CONZERN-ITS/can-cube-sat/logs/FLIGHT/sd/combined-v2-repeared/durdurdur.jpeg

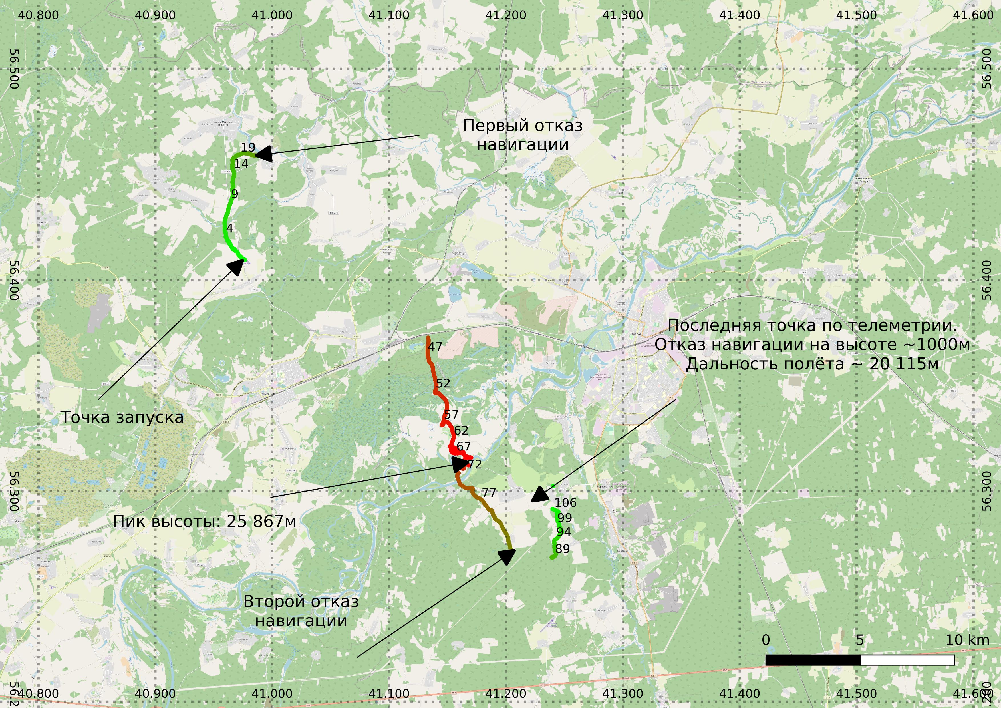
logs/FLIGHT/sd/combined-v2-repeared/durdurdur.jpeg
