CONZERN-ITS/can-cube-sat/doc/--2-.odt

СОГЛАСОВАНО | УТВЕРЖДАЮ
___________________________ | ___________________________
должность, головной исполнитель ОКР | должность, заказчик
___________________________ | ___________________________
подпись, инициалы, фамилия | подпись, инициалы, фамилия
«___»____________________ 20___г. | «___»____________________ 20___г.

СТРАТОСФЕРНАЯ ИССЛЕДОВАТЕЛЬСКАЯ СИСТЕМА "СТАЯ"

Приложение к пояснительной записке 2

Описание протоколов взаимодействия

Команда «ИТС»

1. Общее описание
  1. Для обеспечения выполнения миссии будут использованы два итоговых устройства: наземная станция и стратосферный зонд.
  2. Наземная станция состоит из центра управления полетами (ЦУП) и приемной антенной системы. Должна обеспечивать канал связи аппарата с Землей, собирать, хранить и отображать телеметрию в реальном времени.
    a. Центр управления полетами состоит из:
      a. ПК - компьютеры наземной станции. Ноутбуки.
    b. Приемная антенная система состоит из:
      b. RPI (raspberry pi 3) – устройство, входящие на земле, общающееся с зондом по радио.
      c. Антенны на штативе – необходима для обеспечения связи с зондом.
  3. Зонд должен собирать данные на всем своем пути и передавать их на наземную станцию.
  4. На стратосферном зонде реализованы следующие системы для сообщения с Землей:
    c. СКУБИ (средства контроля и управления бортовой информации) – обеспечивает общение зонда и наземной станции со стороны зонда.
    d. БКУ (бортовой комплекс управления, ESP32) – собирает данные с датчиков на борту аппарата, формирует пакеты телеметрии.
  5. Вся телеметрическая информация находится в пакетах MAVLink[^1].
  6. Физические соединения и транспортные протоколы стратосферного аппарата показаны на схеме 1.
  7. Физические соединения и транспортные протоколы наземной станции показаны на схеме 2.
  8. Используемые транспортные протоколы: I2C[^2], SPI[^3], 1wire[^4], UART[^5], TCP[^6], SDIO, Analog.
2. Общее взаимодействие. Путь аппарат-земля:
  9. БКУ собирает данные со всех датчиков, формирование пакетов телеметрии по протоколу MAVLink.
  10. Данные передаются по радиоканалу на наземную станцию, а также записываются на microSD карту на борту аппарата.
  11. Приемная антенная система получает данные и отправляет в центр управления полетами.
  12. Данные на компьютерах ЦУП-а обрабатываются и сохраняются.
3. Определенные тонкости.
  13. MAVLink
    e. Почти все данные сохраняются в MAVLink пакеты, которые разбиваются на сообщения, передаваемые по соответствующим соединению и протоколу.
    f. Идентификатор пакета определяет данные, которые в нем хранятся. По нему все компьютеры смогут правильно интерпретировать пакеты.

Схема 1. Физические соединения и транспортные протоколы стратосферного аппарата.

Wi-Fi

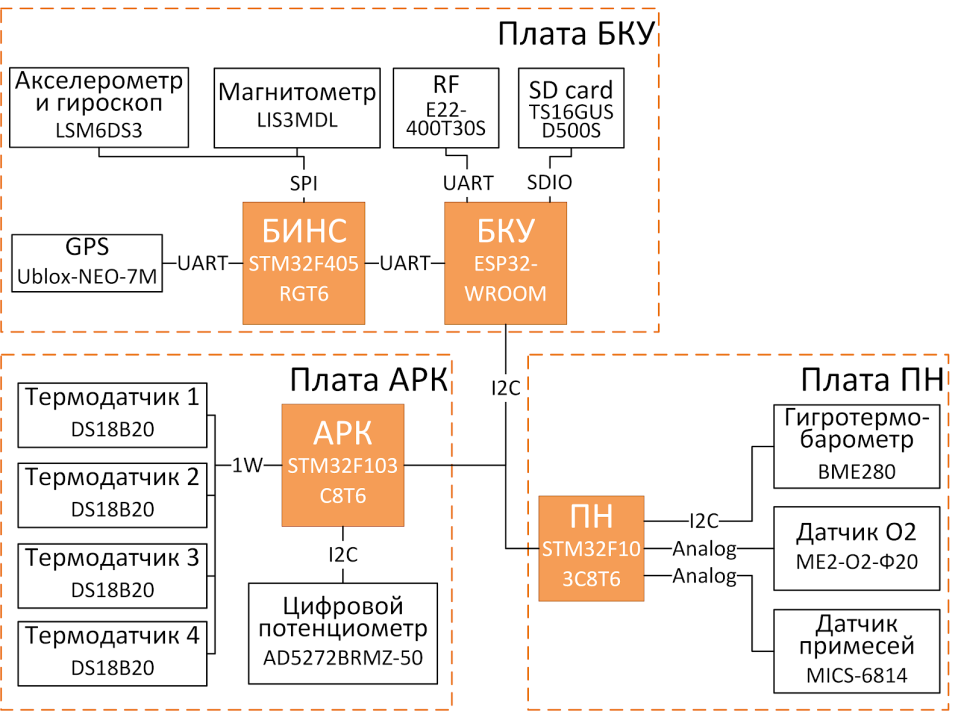
[picture p2: figure]
https://lh4.googleusercontent.com/3MNwlhLbC210im3HJPIzIBXsWaG3ZbeKRxVe3JEsiRfzpClYJ2I2KVsWtFVyp07b9cLHvXFYHdW8fx3_sWnopKQij49WuDgi_HmWpbucNM78J9VG7yGdNTZg7KlUdifC7wV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
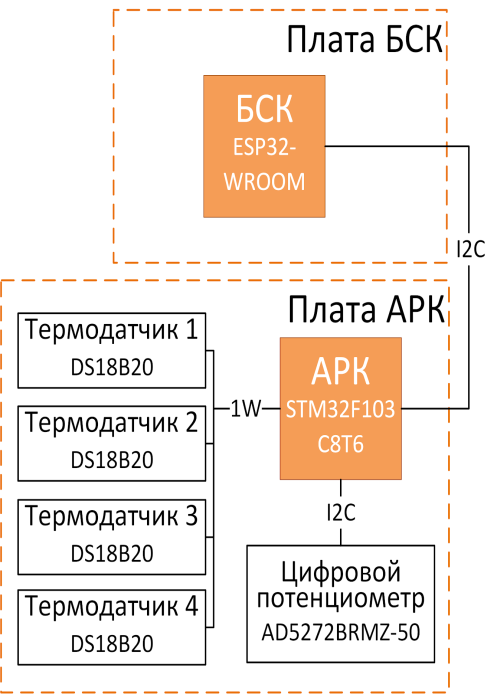
[picture p3: figure]
https://lh4.googleusercontent.com/9Z6rDS9v1-jov7y41YB3K6_0d6Etb7c8z4pV2a9LfS-DHzNvTHSGkJZP4dNTrfMh1UeLY-LgPcApaRh8hJ3QHOGJToZmJprWzGSnutUukMDLyAcQaM01VVsInIvvr6XU2f_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

Схема 2. Физические соединения и транспортные протоколы наземной станции.

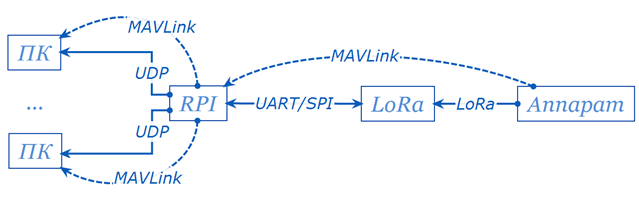
[picture p4: figure]

Схема 1

[^1] MAVLink 2.0, https://mavlink.io/en/guide/
[^2] I2C 6.0, NXP Semiconductors «I2C-bus specification and user manual» UM10204
[^3] SPI, Texas Instruments «KeyStone Architecture Serial Peripheral Interface (SPI)» March 2012
[^4] 1-wire, Dallas Semiconductor/Maxim «1-Wire ® (Protocol)»
[^5] RS-232,
[^6] RFC 793 , Darpa Internet Program«Transmission control protocol» September 1981
