CONZERN-ITS/can-cube-sat/logs/FLIGHT/аномалии.md

Аномалии

1) Пакет UBX_NAV_SOL от time_s == 1679217345 родом из 2023 года по нашей шкале времени и валидный по GPS шкале времени. Радиация?

2) Нужно бы посмотреть FLAGS в UBX_NAV_SOL

Время старта 2020-10-04T11:52:40 1601801560
