CONZERN-ITS/can-cube-sat/doc/TR-WHOLE-THING.odt

СОГЛАСОВАНО | УТВЕРЖДАЮ
____________________________________ | ____________________________________
должность, головной исполнитель ОКР | должность, заказчик
____________________________________ | ____________________________________
подпись, инициалы, фамилия | подпись, инициалы, фамилия
«___»____________________ 20___г. | «___»____________________ 20___г.

ТЕХНИЧЕСКОЕ ЗАДАНИЕ
НА ОПЫТНО-КОНСТРУКТОРСКУЮ РАБОТУ

Создание стратосферной исследовательской системы "Стая"

СТАЯ-ИТС

# Наименование, шифр ОКР, основание, исполнитель и сроки выполнения ОКР

  1. Разрабатываемая стратосферная исследовательская система именуется "Стая".
  2. Шифр ОКР: "СТАЯ-ИТС".
  3. Основания для проведения ОКР.
    - положения конкурса "Воздушно-инженерная школа CanSat в России;
    - решение участников Концерна "Информационные технические системы" об участии в конкурсе.
  1. Исполнитель - "Концерн "Информационные технические системы".
  2. Сроки выполнения ОКР распределены на несколько этапов согласно таблице 1.

Таблица 1. Этапы проведения ОКР.

№ | Наименования этапа | Срок окончания
1 | Разработка эскизного проекта | Январь 2020
2 | Разработка рабочего проекта | Март 2020
3 | Изготовление и проведение контрольных испытаний всех элементов разрабатываемой системы | Июнь 2020

# Цель выполнения ОКР, наименование и индекс изделия

  1. Целью опытно-конструкторской работы (ОКР) является разработка стратосферной исследовательской системы, предназначенной для выполнения исследовательских задач согласно регламенту конкурса "Воздушно-инженерная школа CanSat в России".
  2. Наименование изделия: Стратосферная исследовательская система "Стая". Далее "Стая" или исследовательская система.
  3. Индекс изделия: 1.

# Технические требования к изделию.

## Состав изделия:

    - стратосферный зонд, запускаемый на стратостате;
    - наземный комплекс управления, осуществляющий приём и обработку данных, поступающих от стратостата;

Допускается изменение состава изделия на этапе разработки эскизного и технического проекта при согласовании с заказчиком.

## Требования назначения:

    1. Разрабатываемая система предназначена для решения следующих задач:
      - измерение распределения температуры и давления во время подъёма и спуска;
      - измерение относительной влажности на всей трассе полёта;
      - измерение состава воздуха от 5ти составных элементов (участники могут выбрать сами) на всей трассе полёта;
      - измерение трёх компонент ускорения;
      - фотография Земли в период времени от 0 до 10 секунд после начала падения аппарата;
      - фиксация точки разрушения шара-зонда (координаты, высота, время);
      - фотофиксация неба в момент приземления;
      - передача телеметрии через альтернативные системы связи;
      - передача зондом телеметрической информации с использованием прямого радиоканала на наземный измерительный пункт (НИП);
      - анализ телеметрии аппарата на приёмном пункте во время полёта;
      - построение траектории полёта аппарата по показаниям акселерометра (после приземления);
      - экспериментальная отработка модульной концепции построения аппарата.

## Требования радиоэлектронной защиты:

    1. Должна быть обеспечена совместимость радиоэлектронных средств, используемых в системе.

## Требования живучести и стойкости к внешним воздействующим факторам.

    1. Требования к имитозащищенности
      1. Система должна удовлетворять следующим требованиям к имитозащищенности:
        - должна быть предусмотрена защита от различного рода помех при помощи таких механизмов, как контрольные суммы или помехозащищенное кодирование.
    1. Требования к устойчивости к климатическим воздействиям не предоставляются.
    2. Требования надёжности не предоставляются.

## Требования эргономики, обитаемости и технической эстетики.

    1. Элементы системы должны выглядеть внушительно.

## Требования к эксплуатации, хранению, удобству технического обслуживания и ремонта.

    1. К системе предоставляются следующие эксплуатационные требования:
      - система должна приводиться в готовность не дольше 1 часа;
      - элементы системы должны быть разборными и предусматривать возможность многократной неразрушающей разборки и последующей сборки в целях проведения локальных ремонтных работ.

## Требования к транспортабельности.

    1. К составным частям системы предоставляются следующие требования:
      - элементы системы должны быть транспортабельны при помощи двух рюкзаков объёмом не более 20 литров без потери функциональности. Это требование не распространяется на антенны.

## Требования безопасности.

    1. К системе предоставляются следующие требования безопасности:
      - элементы системы не должны предоставлять опасности для персонала и населения путём воздействия электрического напряжения, движущихся частей, теплового (светового) воздействия, высокочастотных, радиационных, электромагнитных полей, ядовитых паров и газов, вибраций, акустических шумов и др.;
      - элементы питания системы должны быть снабжены соответствующими устройствами защиты от коротких замыканий и последующего возгорания;
      - конструкция элементов системы должна исключать самопроизвольное включение и выключение.

## Требования стандартизации.

    1. При разработке протоколов взаимодействия между элементами системы не должны быть использованы проприетарные стандарты.

## Требования технологичности.

    1. Требования технологичности не предоставляются.

## Конструктивные требования.

    1. Конструктивные требования не предоставляются.

# Технико-экономические требования

  1. Технико-экономические требования не предоставляются.

# Требования к обеспечению.

  1. Требования к нормативно-техническому обеспечению.
    1. Для разработки проекта должна быть использована система контроля версий.
  2. Требования к метрологическому обеспечению не предоставляются.
  3. Требования к диагностическому обеспечению не предоставляются.
  4. Требования к математическому, программному и информационно-лингвистическому обеспечению не предоставляются.

# Требования к учебно-тренировочным средствам.

  1. При разработке системы требуется создание автономных стендов для отработки отдельных узлов там, где это возможно.

# Непредоставляемые требования.

  1. Требования к каталогизации.
  2. Требования к сырью, материалам и КИМП.
  3. Специальные требования.
  4. Требования к консервации, упаковке и маркировке.

# Этапы выполнения ОКР

  1. Выполнение ОКР разделено на несколько этапов согласно таблице 2. Подобное разделение основано на регламенте регламенте чемпионата "воздушно-инженерная школа CanSat в России" [2].

Таблица 2. Этапы выполнения ОКР.

№ | Наименования этапа | Срок окончания
1 | Разработка эскизного проекта | Январь 2020
2 | Разработка рабочего проекта | Март 2020
3 | Изготовление и проведение контрольных испытаний всех элементов разрабатываемой системы | Июнь 2020

# Порядок выполнения этапов и приёмки ОКР.

  1. Для закрытия этапа эскизного проектирования, требуется выполнение следующих требований:
    1. Должны быть разработаны трёхмерные модели элементов конструкции стратосферного зонда;
    2. Должна быть разработана принципиальная электрической схема аппарата;
    3. Должна быть создана презентация для устного доклада комиссии.
    4. Презентация должна включать:
      - описание научной задачи;
      - описание технической задачи;
  1. Для закрытия этапа рабочего проекта должны быть выполнены следующие требования:
    1. Система должна быть полностью спроектирована с выпуском следующих документов:
      - Комплект чертежей конструкции системы (допустимо использование точных трёхмерных моделей);
      - Электрические принципиальные схемы и шаблоны для производства печатных плат, используемых в системе.
    1. Должна быть выпущена альфа версия программного обеспечения всех составных частей системы.
    2. Должны быть проведены автономные испытания элементов разрабатываемой системы.
  1. На финальный этап конкурса команда должна предоставить готовую к эксплуатации систему и принять участие в финале конкурса Воздушно-инженерная школа CanSat в России.

# Ссылочные документы

    - ГОСТ Р 55996- 2014
    - Положения конкурса "Воздушно-инженерная школа (CanSat в России)" 2019-2020 от 07.01.2020.

# Перечень сокращений:

    - КИМП — комплектующие изделия межотраслевого применения;
    - НИП - наземный измерительный пункт;
    - ОКР - опытно конструкторская работа.

Со стороны исполнителей | Со стороны заказчика
______________________________________ должность, головной исполнитель ОКР | ______________________________________ должность, организация заказчика — разработчика ТЗ на ОКР
______________________________________ подпись, инициалы, фамилия | _________________________________ подпись, инициалы, фамилия
«___»____________________ 20___г. | «___»____________________ 20___г.
______________________________________ должность, головной исполнитель ОКР | ______________________________________ должность, организация заказчика — разработчика ТЗ на ОКР
______________________________________ подпись, инициалы, фамилия | _________________________________ подпись, инициалы, фамилия
«___»____________________ 20___г. | «___»____________________ 20___г.
______________________________________ должность, головной исполнитель ОКР | ______________________________________ должность, организация заказчика — разработчика ТЗ на ОКР
______________________________________ подпись, инициалы, фамилия | _________________________________ подпись, инициалы, фамилия
«___»____________________ 20___г. | «___»____________________ 20___г.
______________________________________ должность, головной исполнитель ОКР | ______________________________________ должность, организация заказчика — разработчика ТЗ на ОКР
______________________________________ подпись, инициалы, фамилия | _________________________________ подпись, инициалы, фамилия
«___»____________________ 20___г. | «___»____________________ 20___г.
