CONZERN-ITS/can-cube-sat/doc/ТЗ-НКУ.odt

СОГЛАСОВАНО | УТВЕРЖДАЮ
____________________________________ | ____________________________________
должность, головной исполнитель ОКР | должность, заказчик
____________________________________ | ____________________________________
подпись, инициалы, фамилия | подпись, инициалы, фамилия
«___»____________________ 20___г. | «___»____________________ 20___г.

ТЕХНИЧЕСКОЕ ЗАДАНИЕ
НА СОСТАВНУЮ ЧАСТЬ ОПЫТНО-КОНСТРУКТОРСКОЙ РАБОТЫ

НАЗЕМНЫЙ КОМПЛЕКС УПРАВЛЕНИЯ "СТРЕЛА-МС"

GCS1.0000-0ТЗ

# Наименование, шифр СЧ ОКР, основание, исполнитель и сроки выполнения СЧ ОКР

  1. Разрабатываемый наземный комплекс управления, входящий в состав стратосферной исследовательской системы "Стая" (далее именуется "СТРЕЛА-МС").
  2. Шифр СЧ ОКР: "СТРЕЛА-МС-ИТС".
  3. Основания для проведения СЧ ОКР.
    - положения конкурса "Воздушно-инженерная школа (CanSat в России)";
    - решение участников "Концерна "Информационные технические системы" об участии в конкурсе.
  1. Исполнитель - "Концерн "Информационные технические системы".
  2. Сроки выполнения СЧ ОКР распределены на несколько этапов согласно таблице 1.

Таблица 1. Этапы проведения СЧ ОКР.

№ | Наименования этапа | Срок окончания
1 | Разработка эскизного проекта | Январь 2020
2 | Разработка рабочего проекта | Март 2020
3 | Изготовление и проведение контрольных испытаний всех элементов разрабатываемой системы | Июнь 2020

# Цель выполнения СЧ ОКР, наименование и индекс изделия

  1. Целью составной части опытно-конструкторской работы (СЧ ОКР) является разработка наземного комплекса управления в составе стратосферной исследовательской системы, "Стая" предназначенной для выполнения исследовательских задач согласно регламенту конкурса "Воздушно-инженерная школа CanSat в России".
  2. Наименование изделия: Наземный комплекс управления "Стрела-МС" стратосферной исследовательской системы "Стая".
  3. Индекс изделия: GCS1.

# Технические требования к изделию.

## Состав изделия:

    - Центр управления полетами, предназначенный для сбора хранения и отображения телеметрии в реальном времени;
    - Приемная антенная система, предназначенная для обеспечение канала связи аппарата с Землей. При наличии достаточных ресурсов должна быть обеспечена автоматическая ориентация антенны.

## Требования назначения.

    1. Разрабатываемая наземный комплекс управления предназначен для решения следующих задач:
      - приём телеметрической информации, передаваемой аппаратом в реальном времени;
      - накопление принятой телеметрической информации на внутреннем накопителе;
      - отображение полученной по радиоканалу телеметрической информации электронно-вычислительными машинами центра управления полетами в реальном или близком к реальному времени;
      - передача телеметрической информации с приемной антенной системы на электронно-вычислительные машины центра управления полетами должна осуществляться при помощи протокола UDP поверх IP.

## Требования радиоэлектронной защиты.

    1. Должна быть обеспечена совместимость радиоэлектронных средств, используемых в системе.

## Требования живучести и стойкости к внешним воздействующим факторам.

    1. Требования к имитозащищенности
      1. Наземная станция должна удовлетворять следующим требованиям к имитозащищенности:
        - должна быть предусмотрена защита от различного рода помех при помощи таких механизмов, как контрольные суммы или помехозащищенное кодирование.
    1. К наземному измерительному пункту предоставляются следующие требования климатической устойчивости:
      - Наземный комплекс управления должен функционировать в диапазоне температур от 0 °C до 45 °C при нормальном атмосферном давлении.
    1. Требования надёжности не предоставляются.

## Требования эргономики, обитаемости и технической эстетики.

    1. Требования не предоставляются.

## Требования к эксплуатации, хранению, удобству технического обслуживания и ремонта.

    1. К системе предоставляются следующие эксплуатационные требования:
      - система должна приводиться в готовность не дольше 1 часа;
      - элементы системы должны быть разборными и предусматривать возможность многократной неразрушающей разборки и последующей сборки в целях проведения локальных ремонтных работ.

## Требования к транспортабельности.

    1. К составным частям системы предоставляются следующие требования:
      - элементы системы должны быть транспортабельны при помощи рюкзака объёмом не более 20 литров без потери функциональности. Это требование не распространяется на антенны и штатив.

## Требования безопасности.

    1. К системе предоставляются следующие требования безопасности:
      - элементы системы не должны предоставлять опасности для персонала и населения путём воздействия электрического напряжения, движущихся частей, теплового (светового) воздействия, высокочастотных, радиационных, электромагнитных полей, ядовитых паров и газов, вибраций, акустических шумов и др.;
      - элементы питания системы должны быть снабжены соответствующими устройствами защиты от коротких замыканий и последующего возгорания;
      - конструкция элементов системы должна исключать самопроизвольное включение и выключение.

## Требования стандартизации.

    1. Требования стандартизации не предоставляются.

## Требования технологичности.

    1. Требования технологичности не предоставляются.

## Конструктивные требования.

    1. Конструктивные требования не предоставляются.

# Требования к обеспечению.

  1. Требования к нормативно-техническому обеспечению.
    1. Для разработки проекта должна быть использована система контроля версий.
  2. Требования к метрологическому обеспечению не предоставляются.
  3. Требования к диагностическому обеспечению не предоставляются.
  4. Требования к математическому, программному и информационно-лингвистическому обеспечению.
    1. Вся принятая телеметрия должна сохраняться на внутренний накопитель информации приёмной станции.

# Требования к консервации, упаковке и маркировке

  1. Для элементов системы должна быть разработана упаковка, позволяющая осуществлять транспортировку и хранение с учётом предоставляемых к транспортировке требований.

# Требования к учебно-тренировочным средствам.

  1. При разработке системы требуется создание автономных стендов для отработки отдельных узлов (там, где это возможно).

# Этапы выполнения ОКР

  1. Выполнение СЧ ОКР разделено на несколько этапов согласно таблице 2. Подобное разделение основано на регламенте регламенте чемпионата "Воздушно-инженерная школа (CanSat в России)" [2].

Таблица 2. Этапы выполнения ОКР.

№ | Наименования этапа | Срок окончания
1 | Разработка эскизного проекта | Январь 2020
2 | Разработка рабочего проекта | Март 2020
3 | Изготовление и проведение контрольных испытаний всех элементов разрабатываемой системы | Июнь 2020

# Порядок выполнения этапов и приёмки ОКР.

  1. Для закрытия этапа эскизного проектирования, требуется выполнение следующих требований:
    1. Должна быть разработана принципиальная электрической схема наземной станции;
    2. Должна быть создана презентация для устного доклада комиссии;
  2. Для закрытия этапа рабочего проекта должны быть выполнены следующие требования:
    1. Система должна быть полностью спроектирована с выпуском следующих документов:
      - Комплект чертежей конструкции СЧ (допустимо использование точных трёхмерных моделей);
      - Электрические принципиальные схемы и шаблоны для производства печатных плат, используемых в наземной станции.
    1. Должна быть выпущена альфа версия программного обеспечения наземной станции.
    2. Должны быть проведены автономные испытания СЧ.
  1. На финальный этап конкурса команда должна предоставить готовую к эксплуатации СЧ в составе системы и принять участие в финале конкурса "Воздушно-инженерная школа (CanSat в России)".

# Непредоставляемые требования.

  1. Технико-экономические требования.
  2. Требования к каталогизации.
  3. Требования к сырью, материалам и КИМП.
  4. Специальные требования.

# Ссылочные документы

    - ГОСТ Р 55996- 2014
    - Положения конкурса "Воздушно-инженерная школа (CanSat в России)" 2019-2020 от 07.01.2020.

# Перечень сокращений:

    - КИМП — комплектующие изделия межотраслевого применения;
    - ОКР — опытно конструкторская работа;
    - СЧ — структурная часть;
    - IP — internet protocol;
    - UDP — user datagram protocol.

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
