CONZERN-ITS/can-cube-sat/doc/Отчетные документы на зимнюю сессию/CCS1.0000-0 - Спецификация ДКА.pdf

Копировал | Формат А4
CCS1.0000-0 СБ | Сборочный чертеж
| Сборочные единицы
1 | CCS1.0100-0 | Модуль корпусной 1 | 1
2 | CCS1.0200-0 | Модуль корпусной 2 | 1
3 | CSS1.3300-1 | Солнечные батареи | 6

Детали

4 | CSS1.1000-1 | Шайба | 24
5 | CSS1.8000-1 | Видеокамера | 2
6 | CSS1.9000-1 | Адаптер | 1

Стандартные изделия

7 | Винт М3-6eх10.43.029 | 8
| ОСТ 92-0737-72
8 | Винт М3-6eх5.43.029 | 24
| ОСТ 92-0737-72

Инв. N подл. Подп. и дата Взам. инв. N Инв. N дубл. Подп. и дата Справ. N Перв. примен.

## CCS1.0000-0

Изм. | Лист | N докум. | Подп. | Дата
| | Разраб. | - | | Демонстратор КА | Лит. | Лист | Листов
Пров. | | | | | | | | 1
Н. контр. | Концерн "ИТС"
Утв. Формат | Зона
Поз.
Обозначение | Наименование | Приме-чание
| Документация

Кол.
