CONZERN-ITS/can-cube-sat/logs/FLIGHT/sd/combined-v2-repeared/accum-current-temperature.png

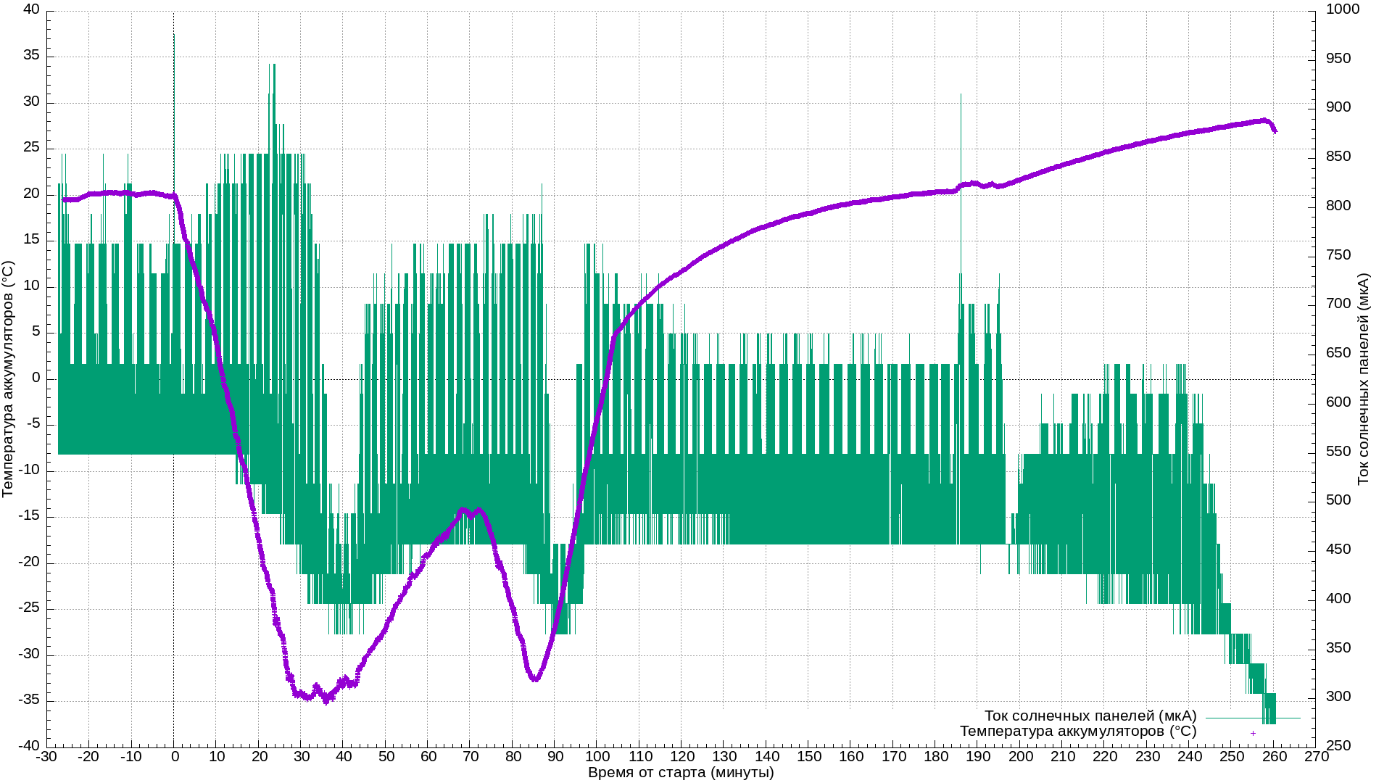
logs/FLIGHT/sd/combined-v2-repeared/accum-current-temperature.png
