CONZERN-ITS/can-cube-sat/logs/FLIGHT/sd/combined-v2-repeared/accum-voltage-temperature.png

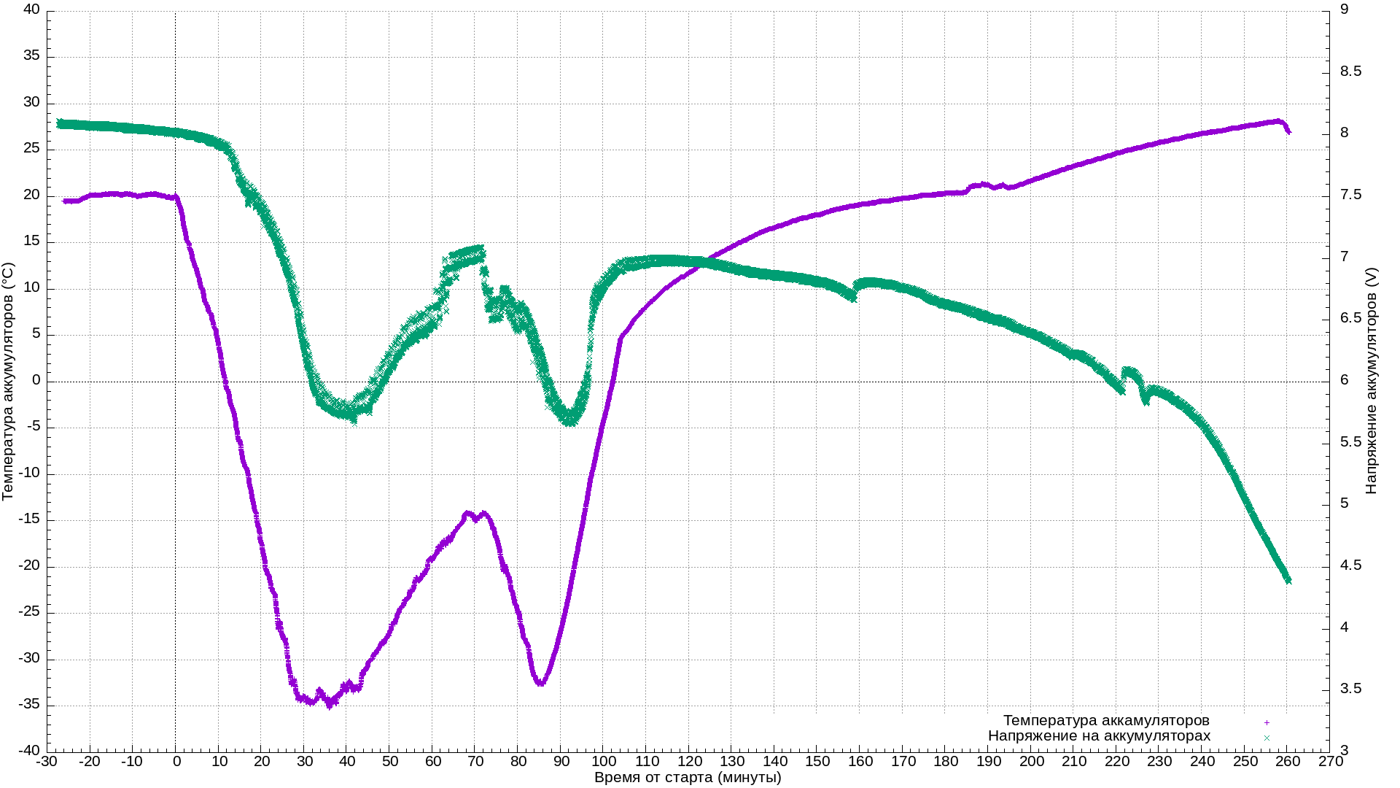
logs/FLIGHT/sd/combined-v2-repeared/accum-voltage-temperature.png
