CONZERN-ITS/can-cube-sat/logs/FLIGHT/sd/combined-v2-repeared/GPS_UBX_NAV_SOL-11-0-with-bme-pressure.png

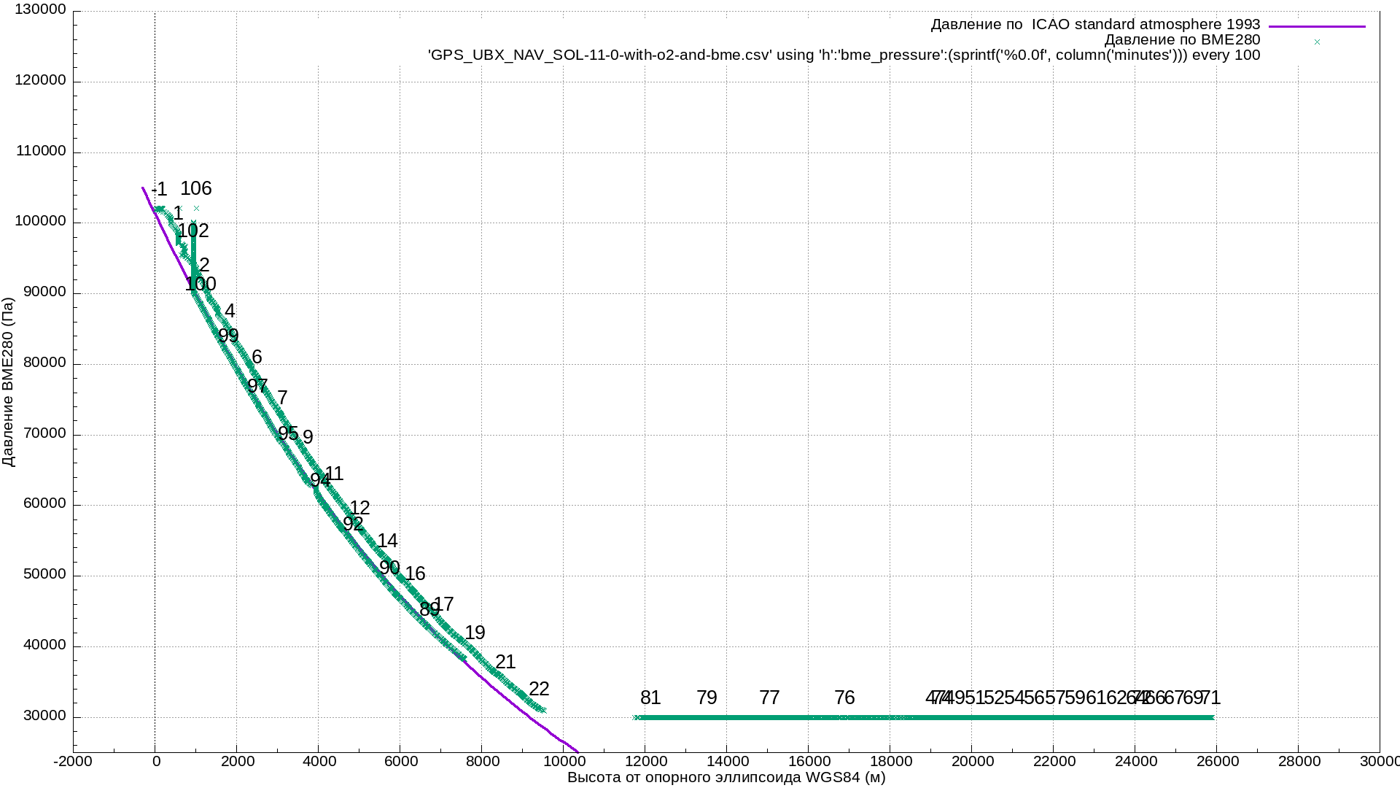
logs/FLIGHT/sd/combined-v2-repeared/GPS_UBX_NAV_SOL-11-0-with-bme-pressure.png
