CONZERN-ITS/can-cube-sat/logs/FLIGHT/sd/combined-v2-repeared/PLD_BME280_DATA-13-0-pressure.png

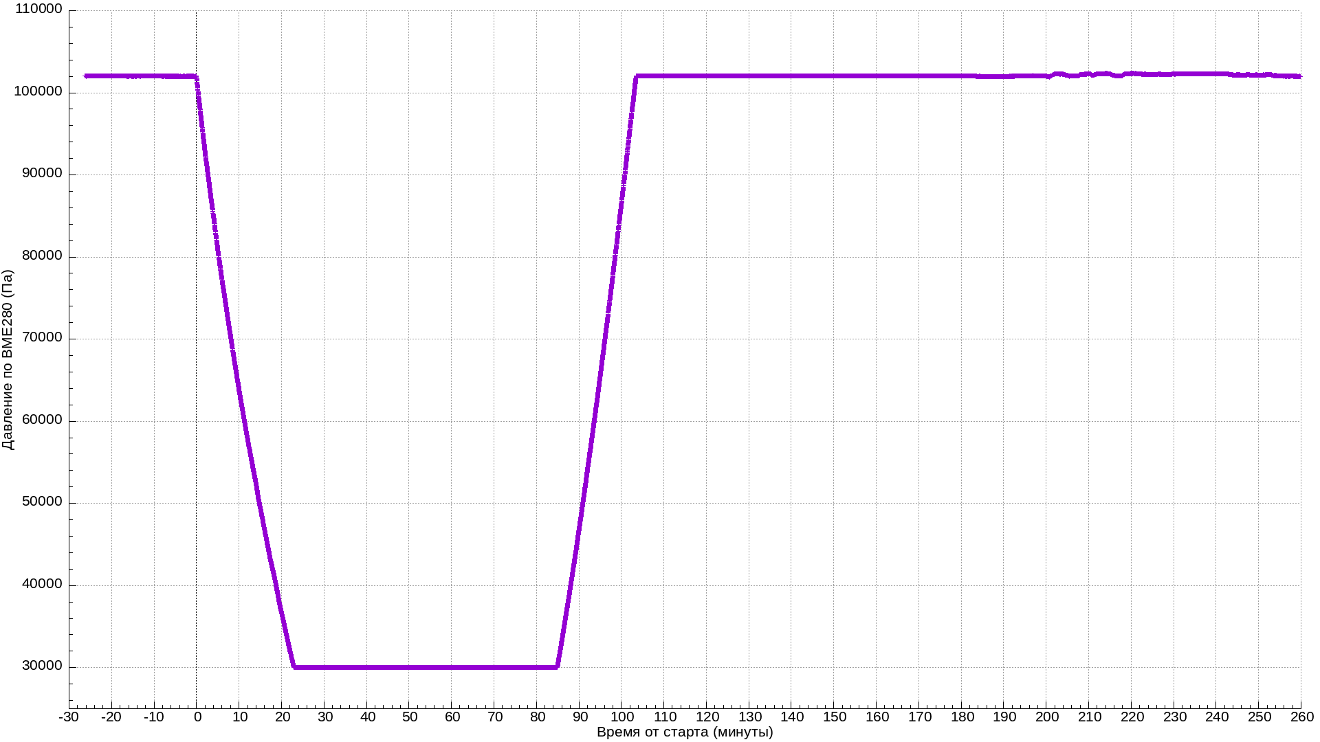
logs/FLIGHT/sd/combined-v2-repeared/PLD_BME280_DATA-13-0-pressure.png
