CONZERN-ITS/can-cube-sat/logs/FLIGHT/sd/combined-v2-repeared/PLD_ME2O2_DATA-13-0-o2.png

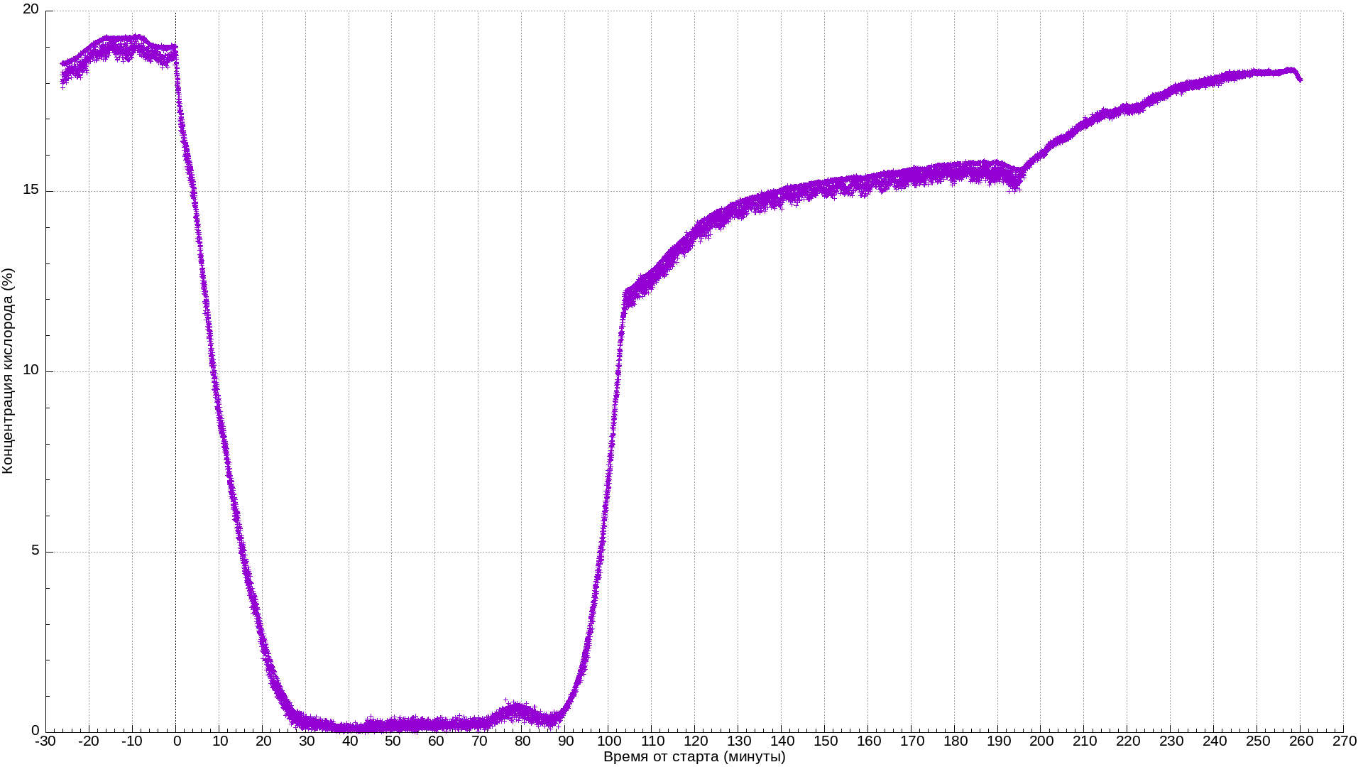
logs/FLIGHT/sd/combined-v2-repeared/PLD_ME2O2_DATA-13-0-o2.png
