CONZERN-ITS/can-cube-sat/logs/FLIGHT/sd/combined-v2-repeared/PLD_MICS_6814_DATA-13-0-no2.png

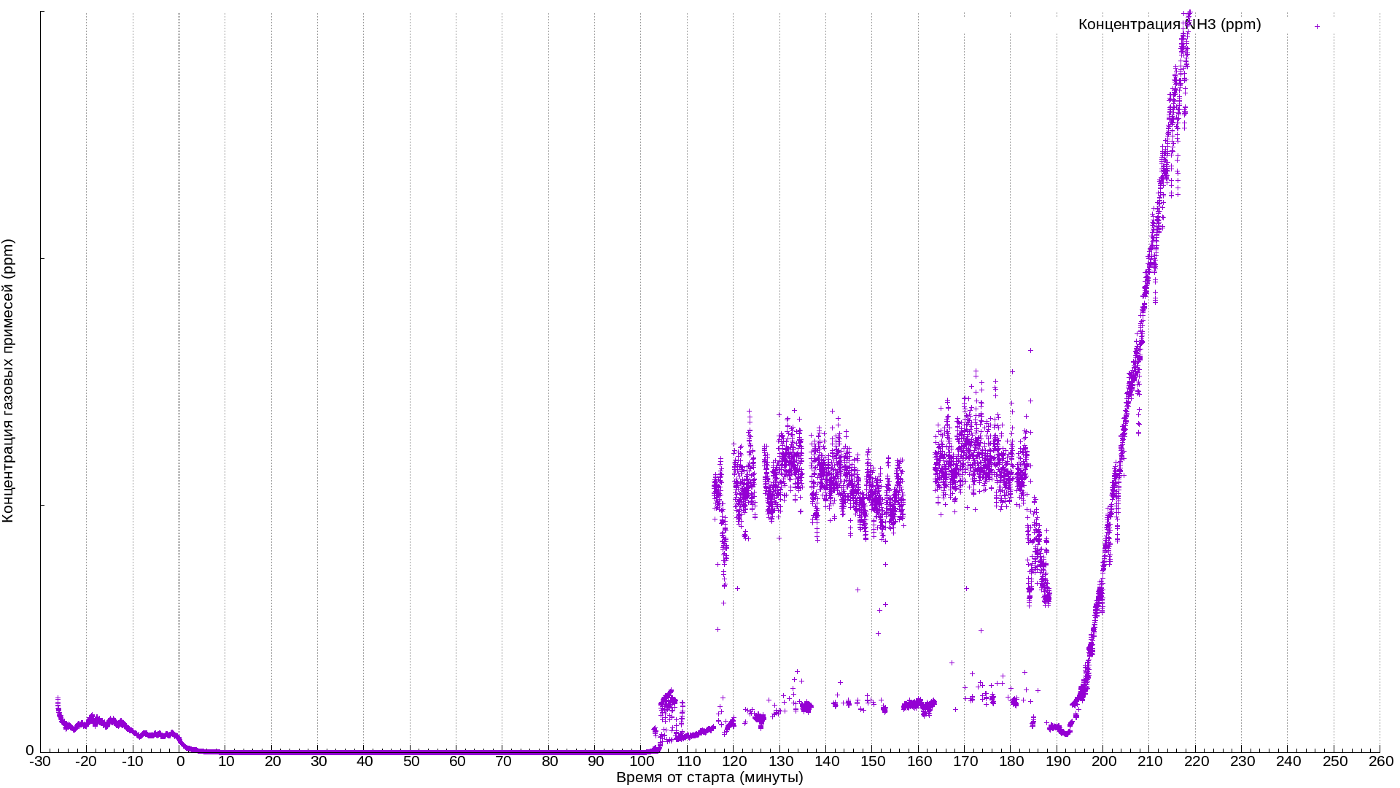
logs/FLIGHT/sd/combined-v2-repeared/PLD_MICS_6814_DATA-13-0-no2.png
