CONZERN-ITS/can-cube-sat/logs/FLIGHT/sd/own_temp.PNG

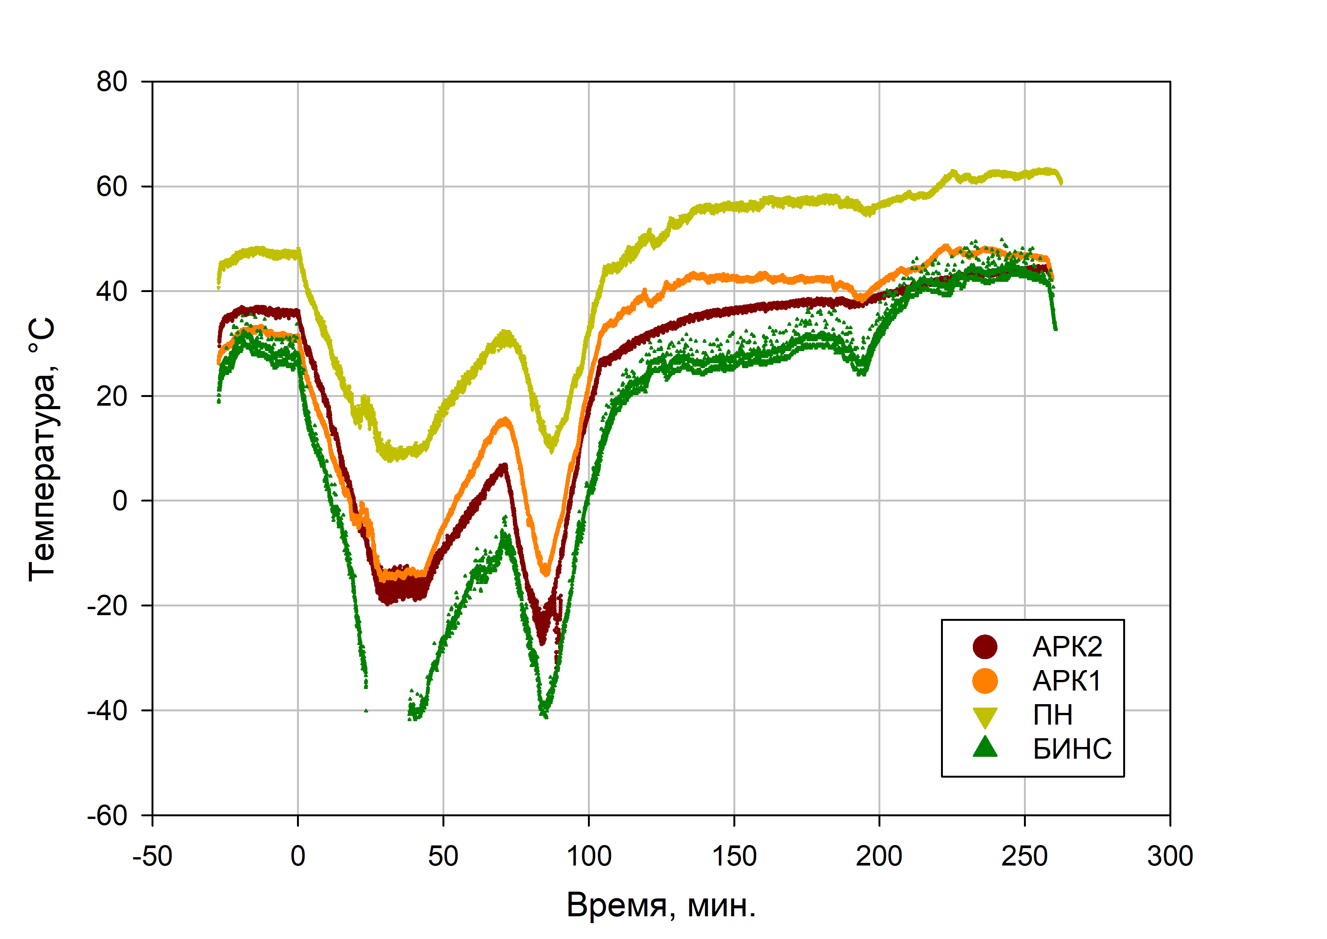
logs/FLIGHT/sd/own_temp.PNG
