CONZERN-ITS/can-cube-sat/logs/FLIGHT/sd/own_temp_sins.PNG

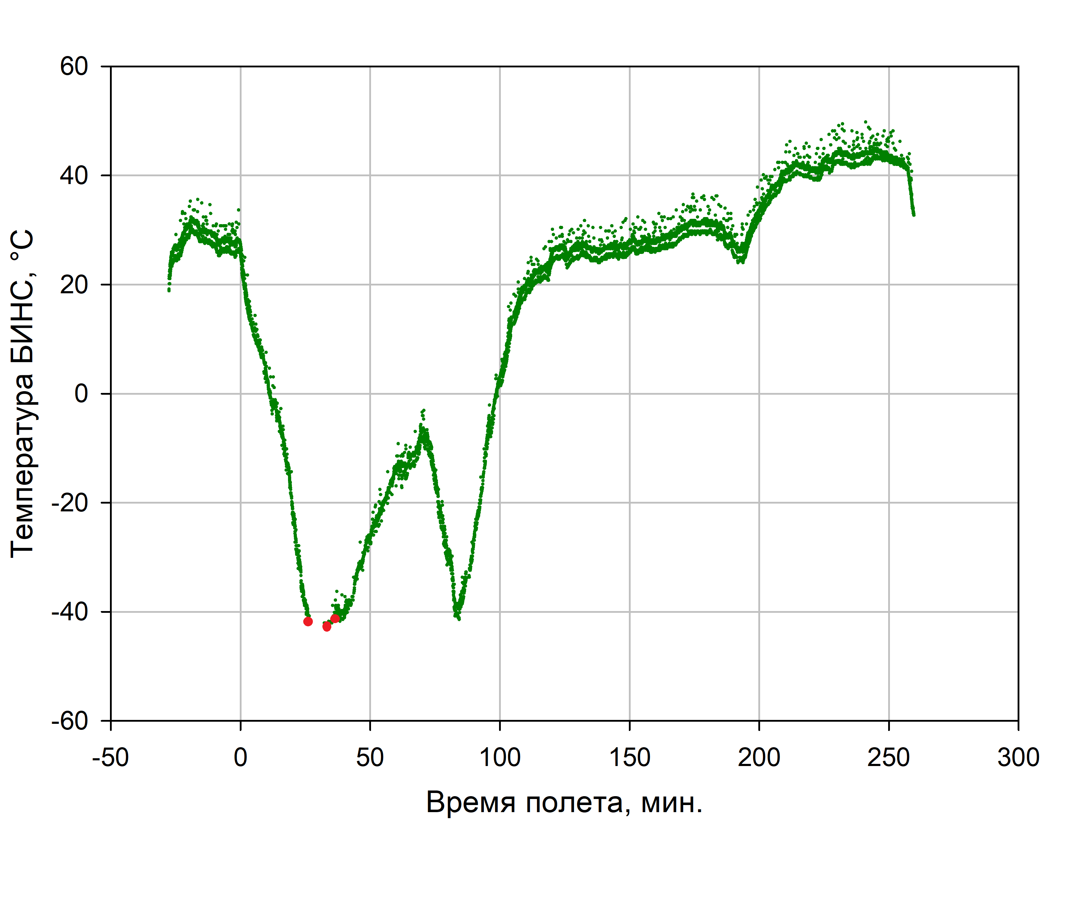
logs/FLIGHT/sd/own_temp_sins.PNG
