CONZERN-ITS/can-cube-sat/construction/3Dmodel_Ground_station/Gear-vertical-small.stp

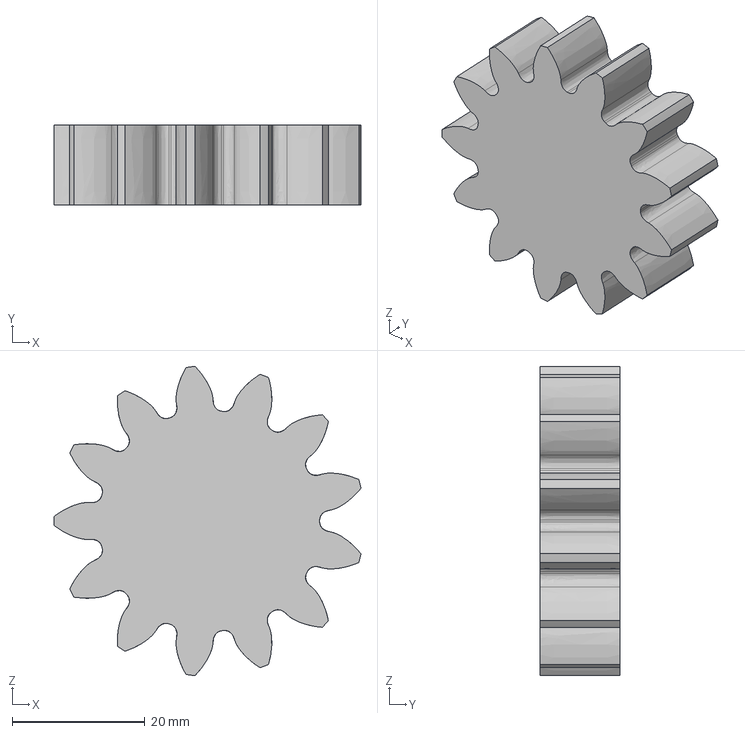
[picture p30: CAD file, 2020-03-20]
construction/3Dmodel_Ground_station/Gear-vertical-small.stp
46.3 x 12.0 x 46.6 mm
