CONZERN-ITS/can-cube-sat/construction/Assistive_models/solar_inter_plata.dxf

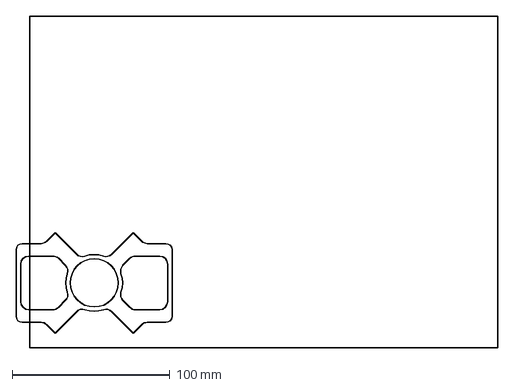
[picture p31: CAD file, 2020-04-19]
construction/Assistive_models/solar_inter_plata.dxf
305.5 x 210.0 mm
