CONZERN-ITS/can-cube-sat/src/ground/laptop/StrelA-MS/source/models/axis.stl

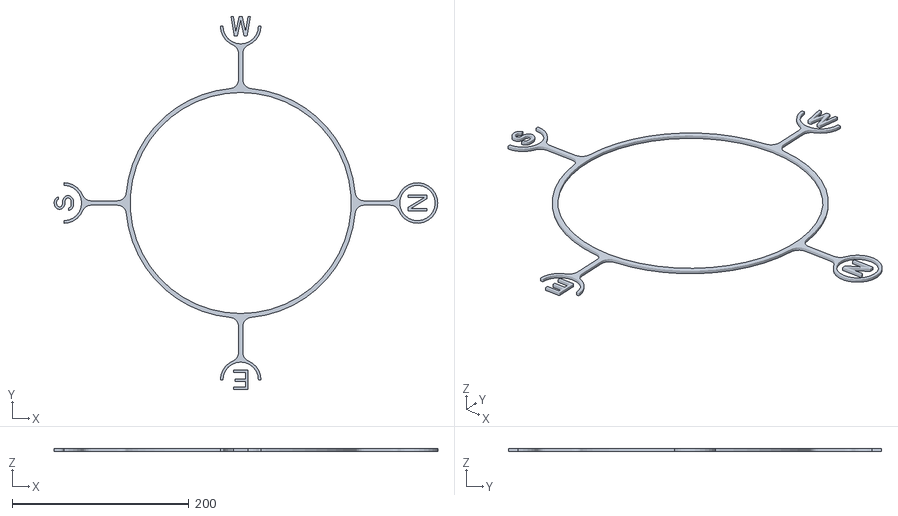
[picture p32: CAD file, 2020-05-28]
src/ground/laptop/StrelA-MS/source/models/axis.stl
434.0 x 422.0 x 3.00
