CONZERN-ITS/can-cube-sat/construction/3Dmodel_Ground_station/Gear-vertical-large.stp

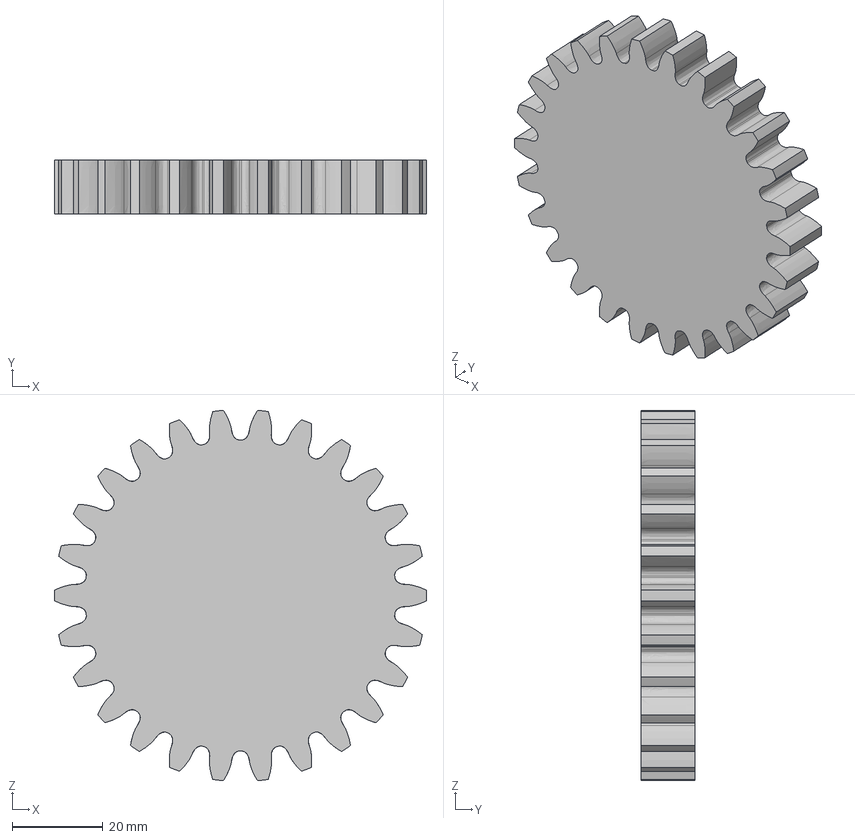
[picture p33: CAD file, 2020-03-20]
construction/3Dmodel_Ground_station/Gear-vertical-large.stp
82.2 x 12.0 x 81.9 mm
