CONZERN-ITS/can-cube-sat/construction/Assistive_models/cross_n_mag.dxf

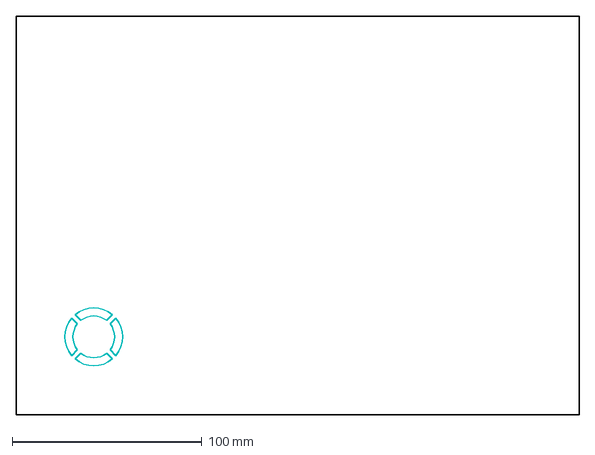
[picture p34: CAD file, 2020-04-19]
construction/Assistive_models/cross_n_mag.dxf
297.0 x 210.0 mm
