CONZERN-ITS/can-cube-sat/src/ground/laptop/StrelA-MS/source/models/CanCubeSat-for-GKS.stl

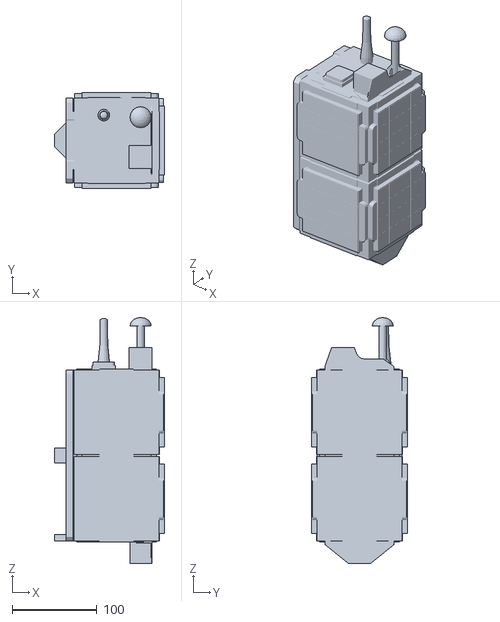
[picture p35: CAD file, 2020-04-19]
src/ground/laptop/StrelA-MS/source/models/CanCubeSat-for-GKS.stl
130.5 x 113.9 x 290.7
