CONZERN-ITS/can-cube-sat/construction/3Dmodel_Ground_station/Gear-horzontal-large.stp

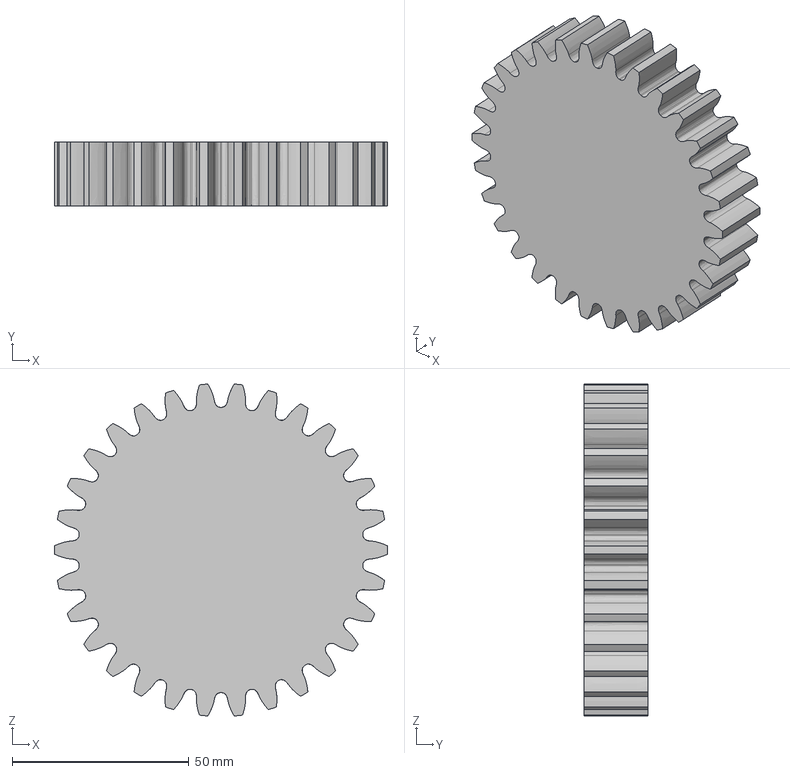
[picture p36: CAD file, 2020-03-20]
construction/3Dmodel_Ground_station/Gear-horzontal-large.stp
94.2 x 18.0 x 93.9 mm
