CONZERN-ITS/can-cube-sat/construction/3Dmodel_Ground_station/Gear-horzontal-small.stp

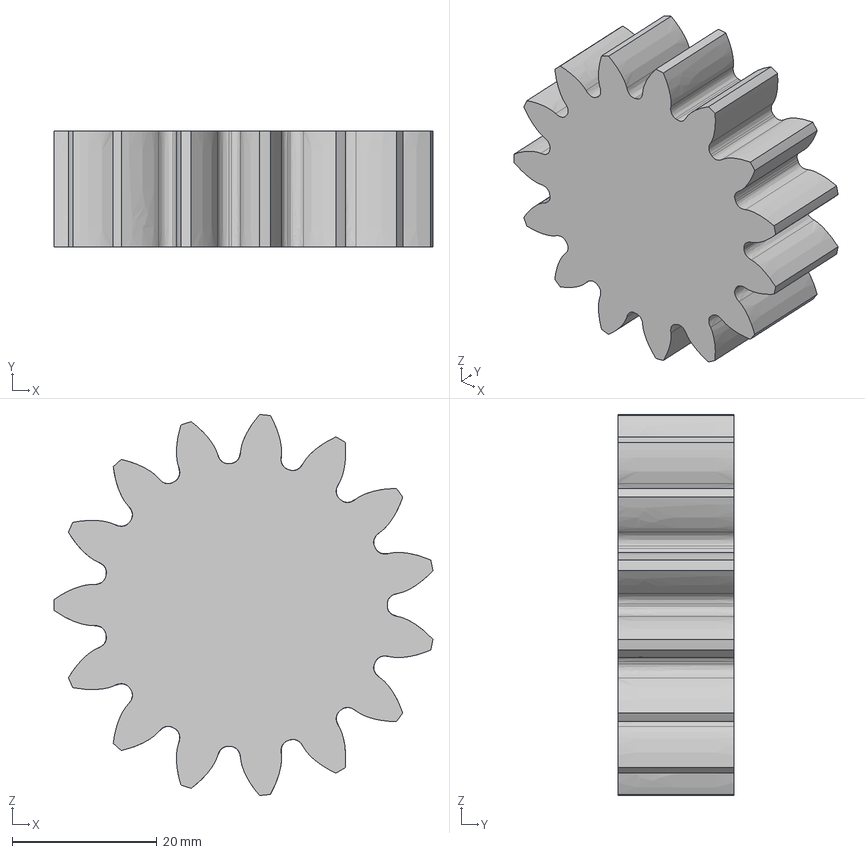
[picture p37: CAD file, 2020-03-20]
construction/3Dmodel_Ground_station/Gear-horzontal-small.stp
52.4 x 16.0 x 52.6 mm
