CONZERN-ITS/can-cube-sat/(threads)

Thread 1 (2020-03-01):

Определения статических функций в заголовках

Snork2, 2020-03-01:
В проекте ark в заголовке `ina_helper.h` внесены определения целой пачки функций.

Все они определены как статические. Это приводит к тому, что в каждом `.c` файле, в который явно или неявно включен `inha_helper.h` появляются определения этих функций. Скорее всего компилятор выбрасывает неиспользуемые функции, но теоретически это приводит к солидному умножению объема кода. Следует перенести весь код из этого заголовка в соответствующий .c  файл.

SeresHotes, 2020-03-14:
Добавлен .c файл, в который была пермещена реализация этих функций

Closed 2020-03-14.

Thread 2 (2020-03-25):

На плате БКУ стм32ф4 не подключен к земле

Snork2, 2020-03-25:
Подключен только к питанию.

Это не хорошо

Mary662, 2020-03-25:
Уже исправила

Snork2, 2020-03-25:
Частично исправлено в 789fe59295089e38a365a78c69a7d657e276e2cb

VSSA тоже нужно к земле

Mary662, 2020-03-25:
Исправила

Snork2, 2020-03-26:
Исправлено в 6a1ba23798146cb67155e7b050735fdd73ac287b

Closed 2020-03-26.

Thread 3 (2020-03-25):

на плате БКУ для стм32ф4 нужна батарейка для RTC

Snork2, 2020-03-25:
Эта батарейка нужна для того, чтобы Данилина система могла помнить время и без GPS.
Так же, возможно имеет смысл скинуть контакт от этой батарейки к GPS, чтобы оно тоже тикало своими RTC часами и не забывало настойки.

Можно использовать часовую батарейку с держалкой, а можно использовать перезаряжаемый ионистр. К нему нужна схема с диодом и резистором для зарядки

Если есть вопросы по батарейке - их можно задавать, например, мне

Mary662, 2020-03-25:
Как батарейку подключать?

Snork2, 2020-03-26:
В дискорде рассказал

Mary662, 2020-03-29:
Добавила

Snork2, 2020-03-29:
Сделано, не знаю в каком коммите

Closed 2020-03-29.

Thread 4 (2020-03-25):

На плате БКУ пины boot0 и boot1 для стм32ф4 должны быть на земле

Snork2, 2020-03-25:
Иначе он будет грузится черт знает в каких режимах. Когда обе ножки на земле - включается нормальный режим загрузки.

Не допускается введение каких-либо резисторов и емкостей между ножками  boot и землей. Это вызывает страшенные баги при старте контроллера при подаче питания

Mary662, 2020-03-25:
Тоже исправила

Snork2, 2020-03-25:
Исправлено в 789fe59295089e38a365a78c69a7d657e276e2cb

Closed 2020-03-25.

Thread 5 (2020-03-25):

На плате БКУ в JTAG колодке для ESP32 нужна еще земля и питание

Snork2, 2020-03-25:
JTAG пробе нужна земля (ну очевидно почему нужна, ну) и питание целевой системы (а это нужно для того, чтобы проба могла выставить соответсвующее напряжение на сигнальных линиях).

Будет удобно (очень), если эти пины будут рядом

Mary662, 2020-03-25:
И это исправила

Snork2, 2020-03-25:
Исправлено в 789fe59295089e38a365a78c69a7d657e276e2cb

Closed 2020-03-25.

Thread 6 (2020-03-25):

На плате БКУ какая-то очевидная лажа со сдвиговыми регистрами

Snork2, 2020-03-25:
Я сейчас пойду смотреть даташит на эти регистры, но то что я вижу - ни капельки не похоже на _цепное_ соединение регистров.

Прошу разобраться. По слухам этим занимался Серей, поэтому вешаю ишью на него

Mary662, 2020-03-25:
На БСК1 сейчас подключено так же

Snork2, 2020-03-25:
Даташит прочёл. Все правильно. Был не прав, вопрос снимается

Closed 2020-03-25.

Thread 7 (2020-03-25):

На плате БКУ сигнал PPS никуда не идет

Snork2, 2020-03-25:
Что не есть правильно, так как он должен быть заведен на SINS.

Так же нет инфраструктуры для передачи сигналов времени от SINS для ESP32 и от ESP32 другим устройствам. Таким как АРК и блок полезной нагрузки.

Традиционно ответсвенная @Mary662 и @dll31, который должен показать куда вести PPS

Snork2, 2020-03-30:
Исправлено в 5f37e4c005bc568d3dd63f3b727a2fbd5a217ab3

Closed 2020-03-30.

Thread 8 (2020-03-25):

На плате БКУ отсутствует линия для сигналов прерываний от ведомых на шине I2C

Snork2, 2020-03-25:
Собственно её нет. А должна быть. Это третья подтянутая к питанию линия, за которую ведомые как за колокольчик будут дергать ESP32, когда им срочно есть что сказать на шине

Mary662, 2020-03-25:
Куда ее вести?

Snork2, 2020-03-25:
В чатик вызываются @SeresHotes и @dll31. На какие пины вести прерывание для I2C ведомых?

SeresHotes, 2020-03-25:
Линия есть. Указанно в таблице как I2C_INT - GPIO18.

Closed 2020-03-25.

Thread 9 (2020-03-25):

Пин для пайки вывода для антенны с футпринта E22 (радио 433) стоит убрать

Snork2, 2020-03-25:
Потому что эту линию мы разводить не будем а проблем от этого пина целый вагон. Он создает паразитную емкость со соседями на плате и имеет тендценцию заливаться оловом с соседями

Mary662, 2020-03-25:
Его уже нет

Snork2, 2020-03-25:
Great job!
Полагаю исправлено в 789fe59295089e38a365a78c69a7d657e276e2cb

Closed 2020-03-25.

Thread 11 (2020-04-01):

Отладочная плата под радио может быть улучшена

Snork2, 2020-04-01:
1) В документации к радио рекомендуется не разводить дорожки под ним
2) Если плата в любом случае двуслойная, то имеет смысл одну строну сделать GND полигоном. Это значительно улучшает ситуацию с различными помехами.
3) Поскольку мы не разводим антенную линию по плате - площадку ANT лучше убрать. Иначе она вносит всякие разные емкости и норовит кого-нибудь с кем-нибудь закоротить

Mary662, 2020-04-01:
Исправлено в 19b0b53fe58126e3f5a1ba1d57a3242d073af633

Closed 2020-04-01.

Thread 12 (2020-04-01):

Светодиод переполюсован

Snork2, 2020-04-01:
На плате BSK5 светодиод-индикатор питания слева от мосфетного ключа подключен _"задом-наперед"_

Snork2, 2020-04-01:
На многих других платах в аналогичных конструкциях та же шляпа, поэтому внимательнее

Mary662, 2020-04-01:
Исправлено в 19b0b53fe58126e3f5a1ba1d57a3242d073af633

Closed 2020-04-01.

Thread 13 (2020-04-01):

Резисторы на затворах FS8205A

Snork2, 2020-04-01:
На затворах этих парных транзисторах стоят токоограничивающие резисторы в 10 кОм.

Имхо, это многовато и может повлиять на делитель напряжения, который там часто водится и привести к очень длительным переключениям транзистора между состояниями, что сложно оценить как вообще повлияет на схему (скорее всего никак, но черт его знает).

Предлагаю заменить эти резисторы на 10 Ом

Mary662, 2020-04-01:
Исправлено в b89dfe900a633f845c76e1b2d3c38695d6a47e56

Mary662, 2020-04-01:
Исправлено в b89dfe900a633f845c76e1b2d3c38695d6a47e56

Closed 2020-04-01.

Thread 14 (2020-04-04):

Разрешите докопаться к GPS драйверу

Snork2, 2020-04-04:
1) https://github.com/CONZERN-ITS/can-cube-sat/blob/e661721c09d3bb4d3a4bdbf00839879a2f51b127/src/board/SINS/src/drivers/gps.c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

и рядышком на строке 281. Потенциальный доступ к невыровненной памяти.

2) https://github.com/CONZERN-ITS/can-cube-sat/blob/e661721c09d3bb4d3a4bdbf00839879a2f51b127/src/board/SINS/src/drivers/gps.c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
Все эти переменные должны быть глобальными? И буфер для пакета есть как в структуре контекста, так и отдельной глобальной переменной. Не хорошо

3) https://github.com/CONZERN-ITS/can-cube-sat/blob/e661721c09d3bb4d3a4bdbf00839879a2f51b127/src/board/SINS/src/drivers/gps.c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
Эту цепочку ифов следует заменить на свич или хотя бы на `if (...) { ---- } else if (...) { ---- }`. И убрать `|` из `|=`.

4) https://github.com/CONZERN-ITS/can-cube-sat/blob/e661721c09d3bb4d3a4bdbf00839879a2f51b127/src/board/SINS/src/drivers/gps.c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
Нет проверки на длину пакета. Если вдруг влетит заголовок в котором сказано, что пакет будет длиной в 2**32 байт и мы попытаемся его с аккумулировать - нам будет плохо.

Snork2, 2020-04-04:
по пункту 4. Проверка на длину там все же есть, виноват

Snork2, 2020-04-04:
https://github.com/CONZERN-ITS/can-cube-sat/blob/master/src/board/SINS/src/drivers/gps.c#L219
в копилку к невыравненому доступу

Snork2, 2020-04-04:
https://github.com/CONZERN-ITS/can-cube-sat/blob/9752cadce8425b89255dd0eb59c0ab1673b615a6/src/board/SINS/src/drivers/gps.c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

Вот тут пропущенно `ctx->sw_buffer = 0`;

Snork2, 2020-06-08:
Давно исправлено было, но кто это читает

Closed 2020-06-08.

Thread 15 (2020-04-05):

c-mavlink не собирается

Snork2, 2020-04-05:
`ERROR: Duplicate message id 11 for SET_MODE (./message_definitions/v1.0/common.xml:4415) also used by ELECTRICAL_STATE (./message_definitions/v1.0/its.xml:16)`

Вот поэтому

Snork2, 2020-04-05:
Вот тут пишут что каждый диалект аллоцирует для себя свой диапазон сообщений
https://mavlink.io/en/guide/define_xml_element.html#message_id_ranges

Может так и сделаем? скажем у нас будет 50000-51000?

Agnus290, 2020-04-05:
Я не против.

Snork2, 2020-04-05:
В таком случае закрыто в f7df10b912861ad174e68ac099f3bc4aafedeac9

Snork2, 2020-04-05:
Упс на самом деле в c78d4a9f0e05b1dc1165abcb7e05f8d395a34797

Closed 2020-04-05.

Thread 16 (2020-04-09):

Сделать первоначальную настройку GPS из сохраненной конфигурации

Snork2, 2020-04-09:
А-то постоянно про это забываем.

Нужно сдампить конфигурацию u-center-ом, перегнать её в какой-нибудь сишный формат и загнать на UBX приёмник.

В идеале сделать верификацию по ACK сообщениям

Closed 2020-04-11.
