CONZERN-ITS/can-cube-sat/doc/Отчетные документы на зимнюю сессию/CCS1.2100-0Э3 - Схема электрическая принципиальная БКУ.pdf

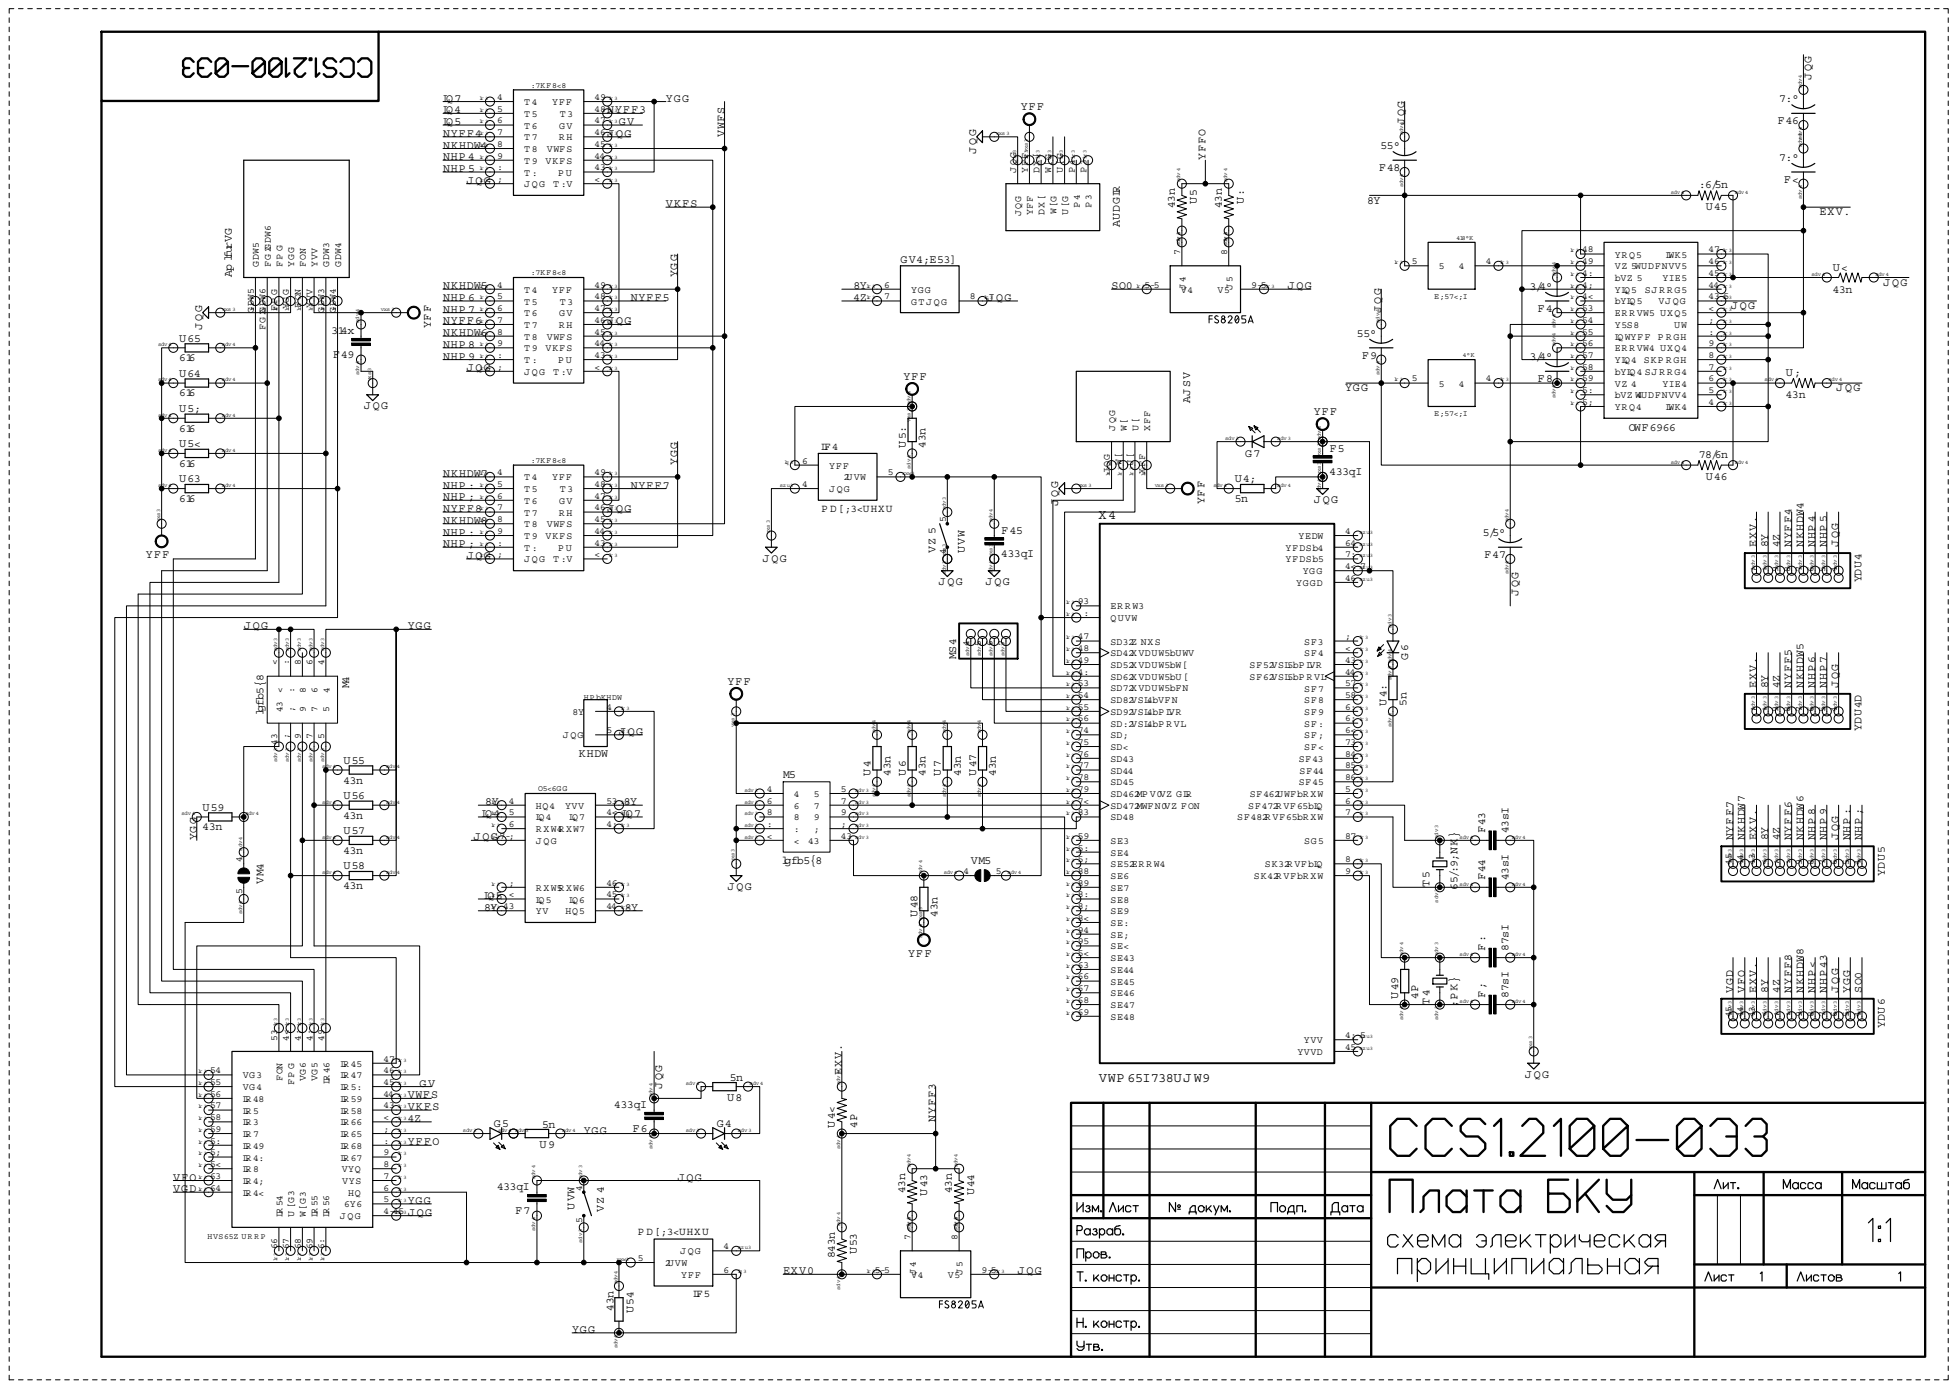
[picture p38: page 1]

M0 M0 M1 M1 RXD RXD TXD TXD AUX AUX VCC VCC GND GND

pas 1 pas 1 pas 1 pas 1

sup 0 sup 0 pas 1 pas 1

BUS+ BUS+

GND GND GND GND 5V5V 5V5V

pas 0 pas 0 pas 1 pas 1

pas 0 pas 0 pas 1 pas 1 pas 1 pas 1

pas 1 pas 1 pas 1

pas 1 pas 1

pas 1 pas 1 pas 0 pas 0 pas 1 pas 1 pas 0 pas 1 pas 0 pas 1
