CONZERN-ITS/can-cube-sat/doc/Отчетные документы на зимнюю сессию/CCS1.2200-0Э3 - Схема электрическая принципиальная БСК1.pdf

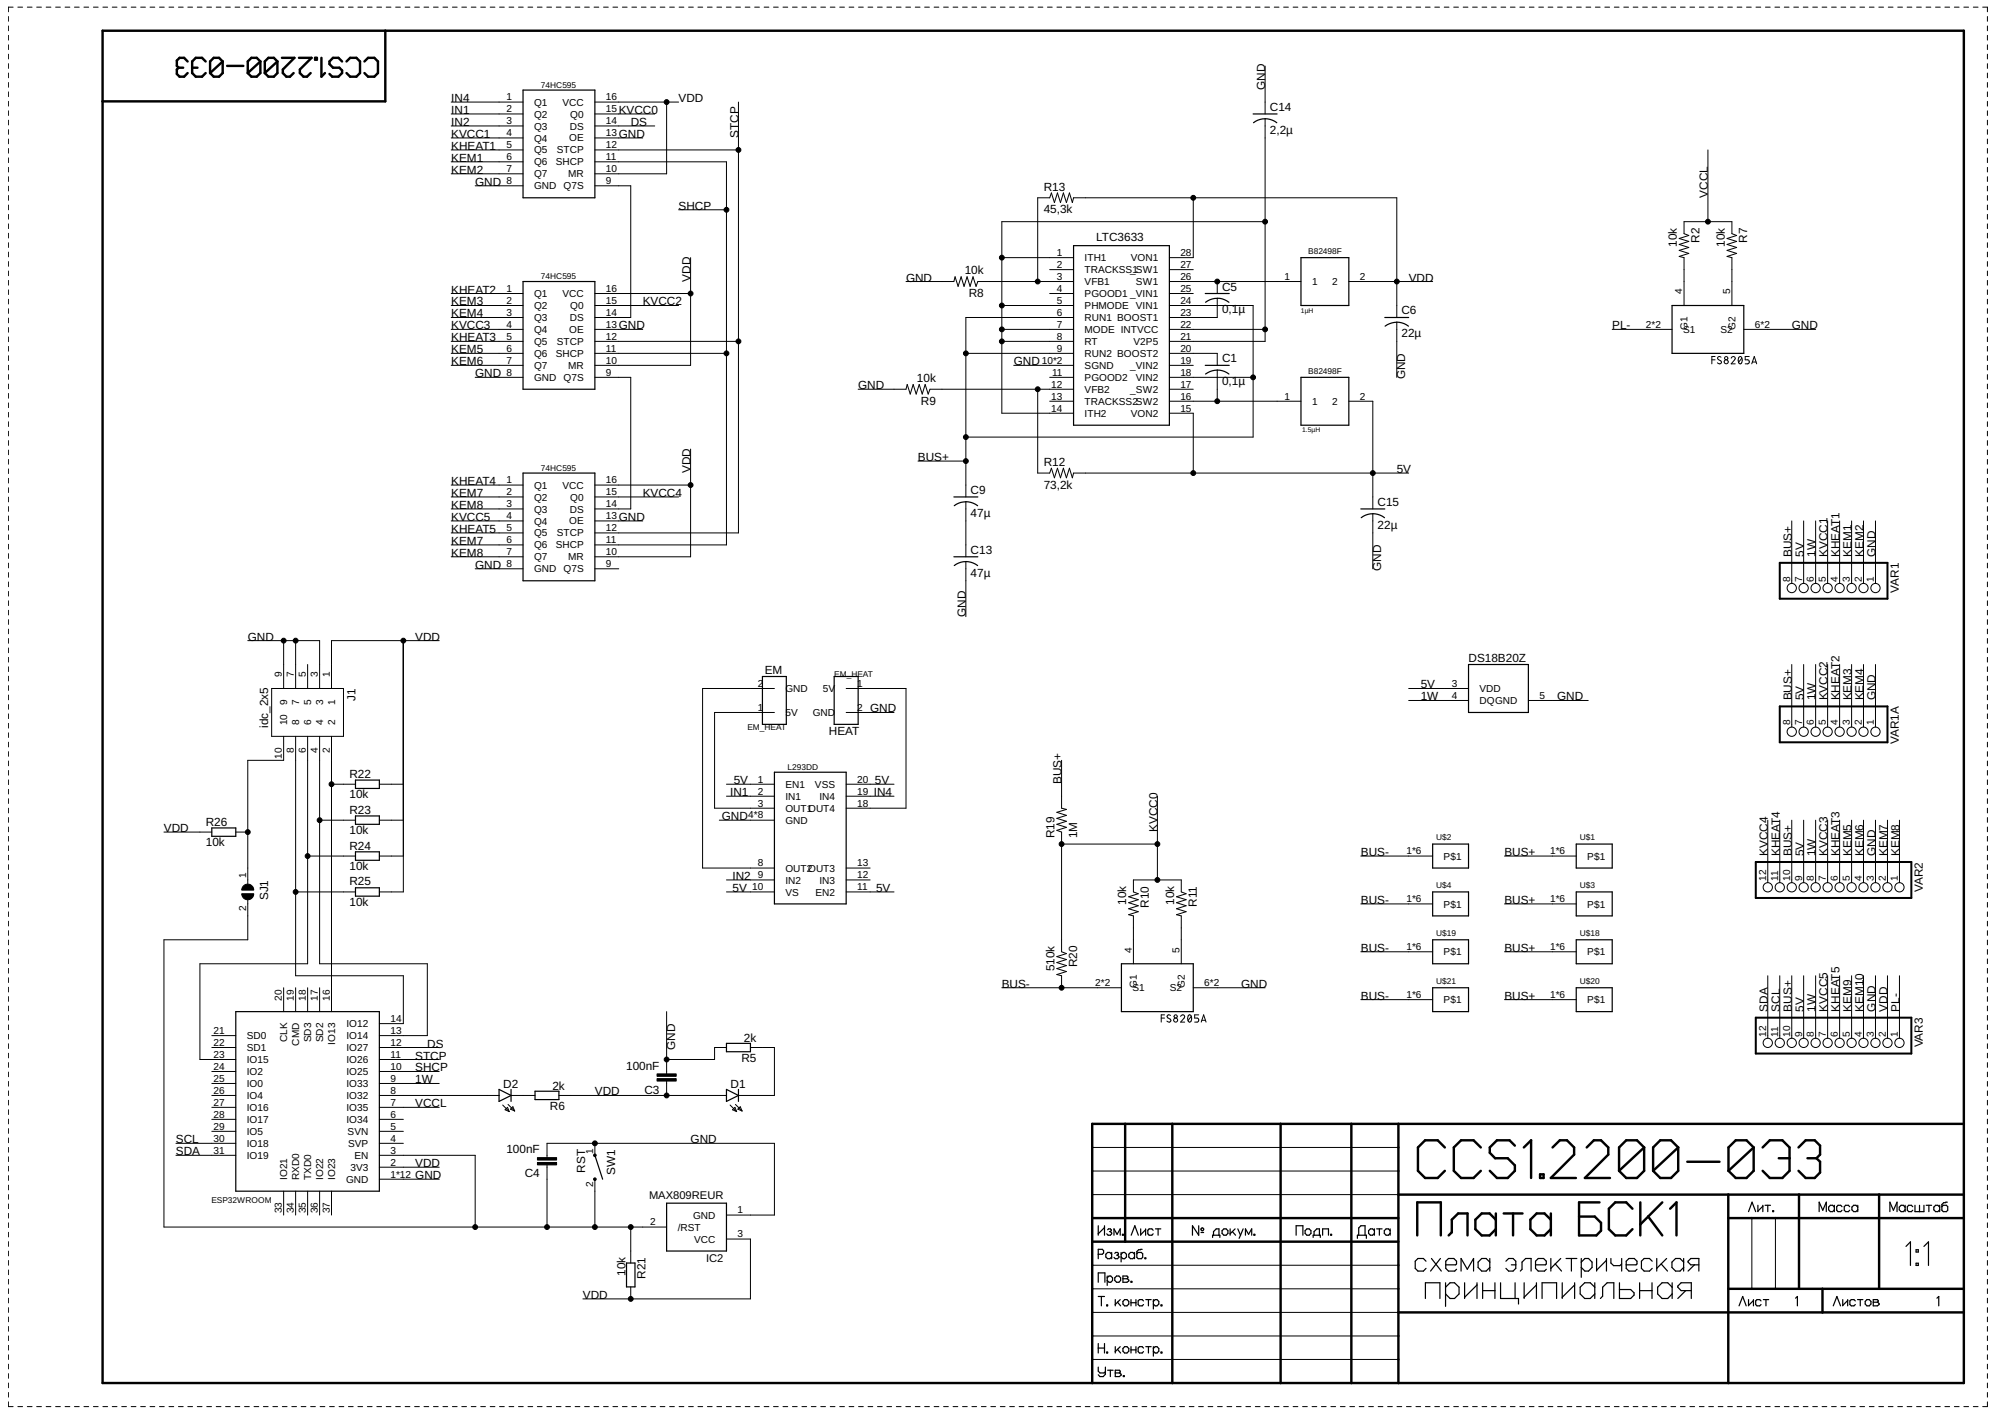
[picture p39: page 1]

11 STCP
10 SHCP

BUS+ BUS+

GND GND

BUS- BUS-

BUS+ BUS+ BUS+ BUS+ BUS-
