CONZERN-ITS/can-cube-sat/construction/Assistive_models/cross_n_mag.pdf

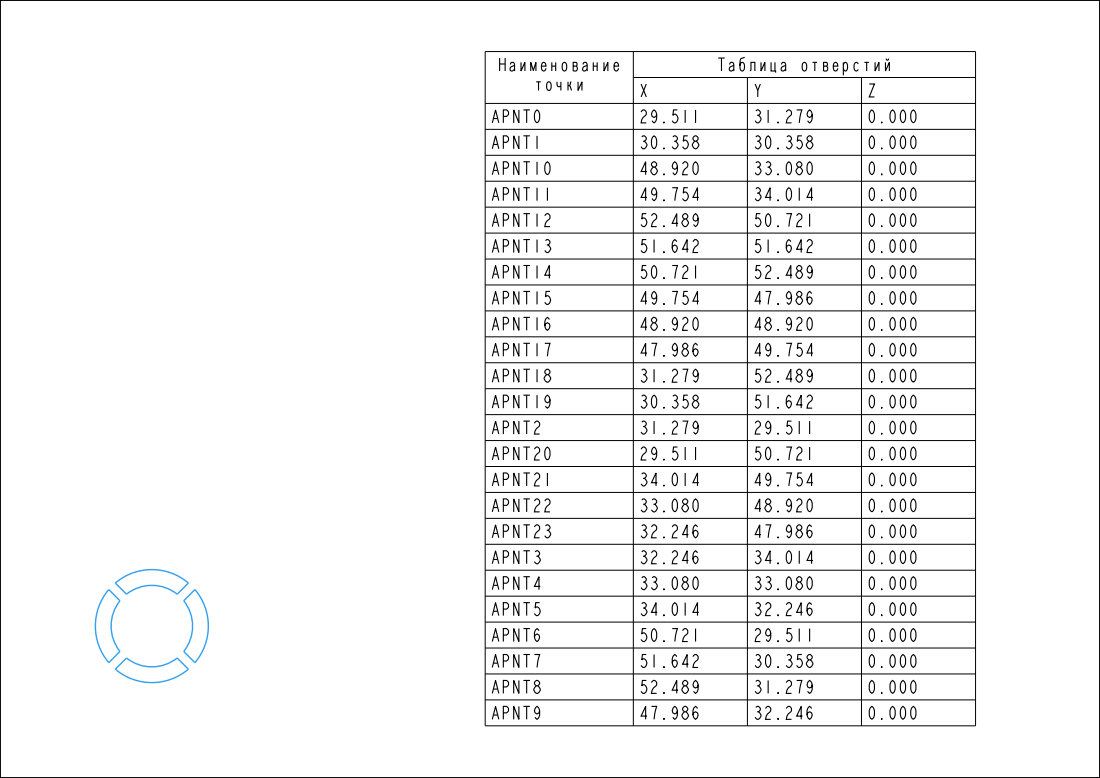
[picture p40: page 1]
Наименование точки; Таблица отверстий; APNT0; APNT12; APNT13; APNT14; APNT2; APNT20; APNT6

APNT1 | 30.358 | 30.358 | 0.000
APNT10 | 48.920 | 33.080 | 0.000
APNT11 | | 49.754 | 34.014 | 0.000

APNT15 | 49.754 | 47.986 | 0.000
APNT16 | 48.920 | 48.920 | 0.000
APNT17 | 47.986 | 49.754 | 0.000
APNT18 | 31.279 | | 52.489 | 0.000
APNT19 | 30.358 | 51.642 | | 0.000

APNT21 | | 34.014 | | 49.754 | 0.000
APNT22 | | 33.080 | | 48.920 | 0.000
APNT23 | | 32.246 | | 47.986 | 0.000
APNT3 | 32.246 | 34.014 | | 0.000
APNT4 | 33.080 | 33.080 | | 0.000
APNT5 | 34.014 | | 32.246 | 0.000

APNT7 | 51.642 | | 30.358 | 0.000
APNT8 | 52.489 | 31.279 | | 0.000
APNT9 | 47.986 | 32.246 | | 0.000
