CONZERN-ITS/can-cube-sat/doc/Отчетные документы на зимнюю сессию/electromagnit_corpus.pdf

АБ

Ra 3.2

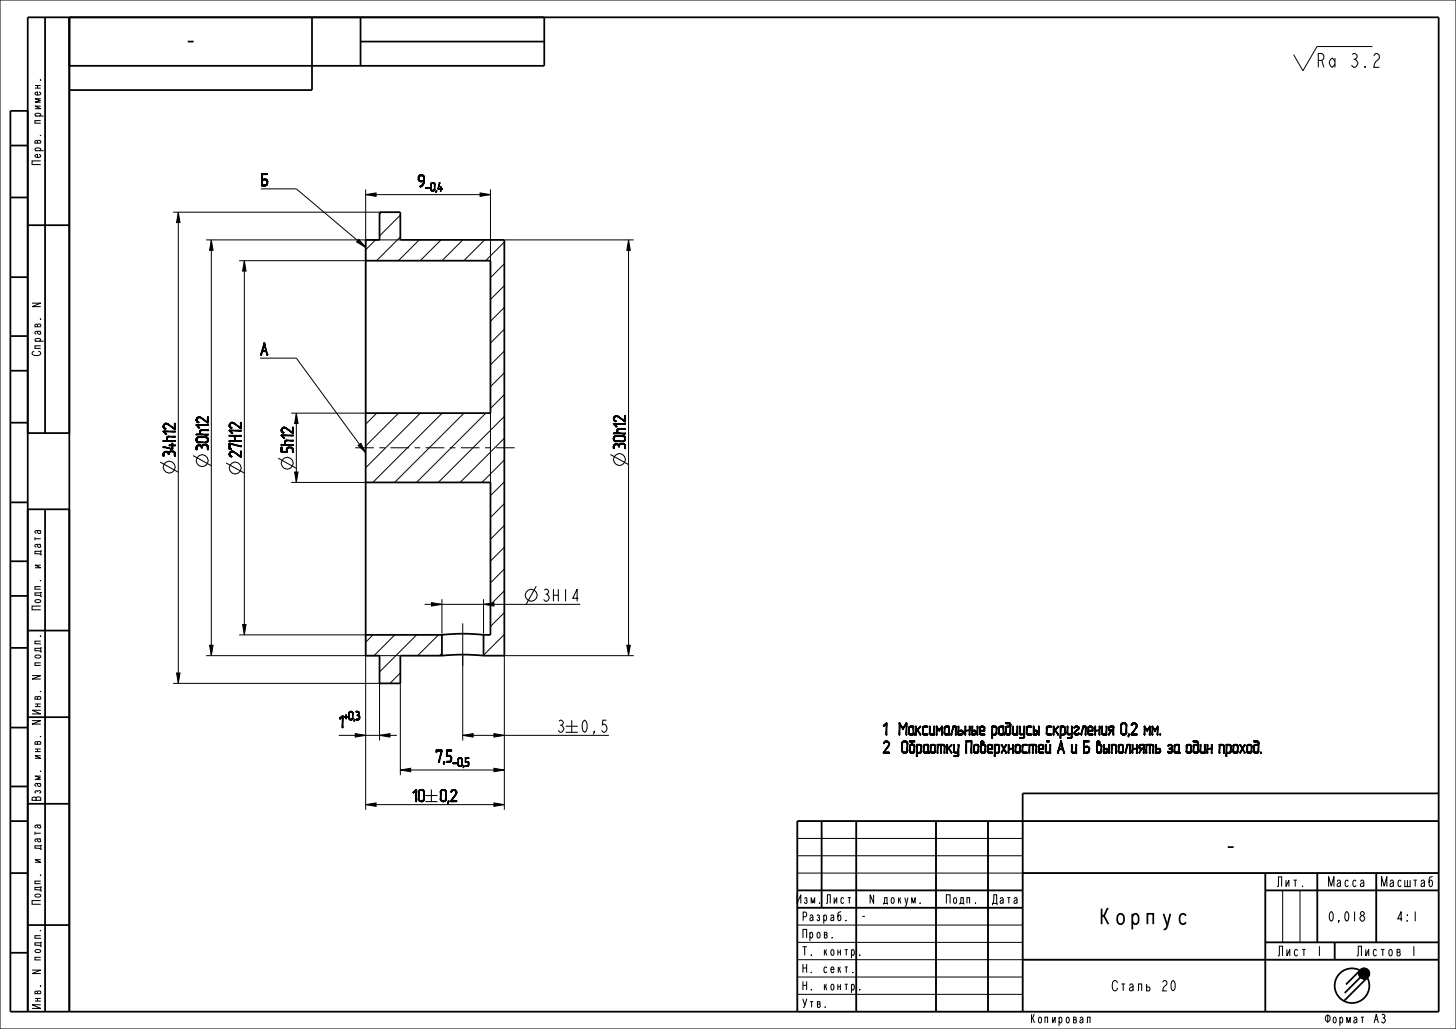
[picture p41: page 1]
Копировал; Формат А3 -; Корпус; Т. контр.; Лист; Н. сект.; Н. контр.; Сталь 20; Утв.

Инв. N подл. Подп. и дата Взам. инв. N Инв. N подл. Подп. и дата Справ. N Перв. примен.

1 Максимальные радиусы скругления 0,2 мм.
2 Обраотку Поверхностей А и Б выполнять за один проход.

Лит. | | Масса | Масштаб

Изм. | Лист | N докум. | Подп. | | Дата
Разраб.
Пров.

Листов 1
