CONZERN-ITS/can-cube-sat/doc/Отчетные документы на зимнюю сессию/CCS1.0000-0ГЧ - Габритный чертеж ДКА.pdf

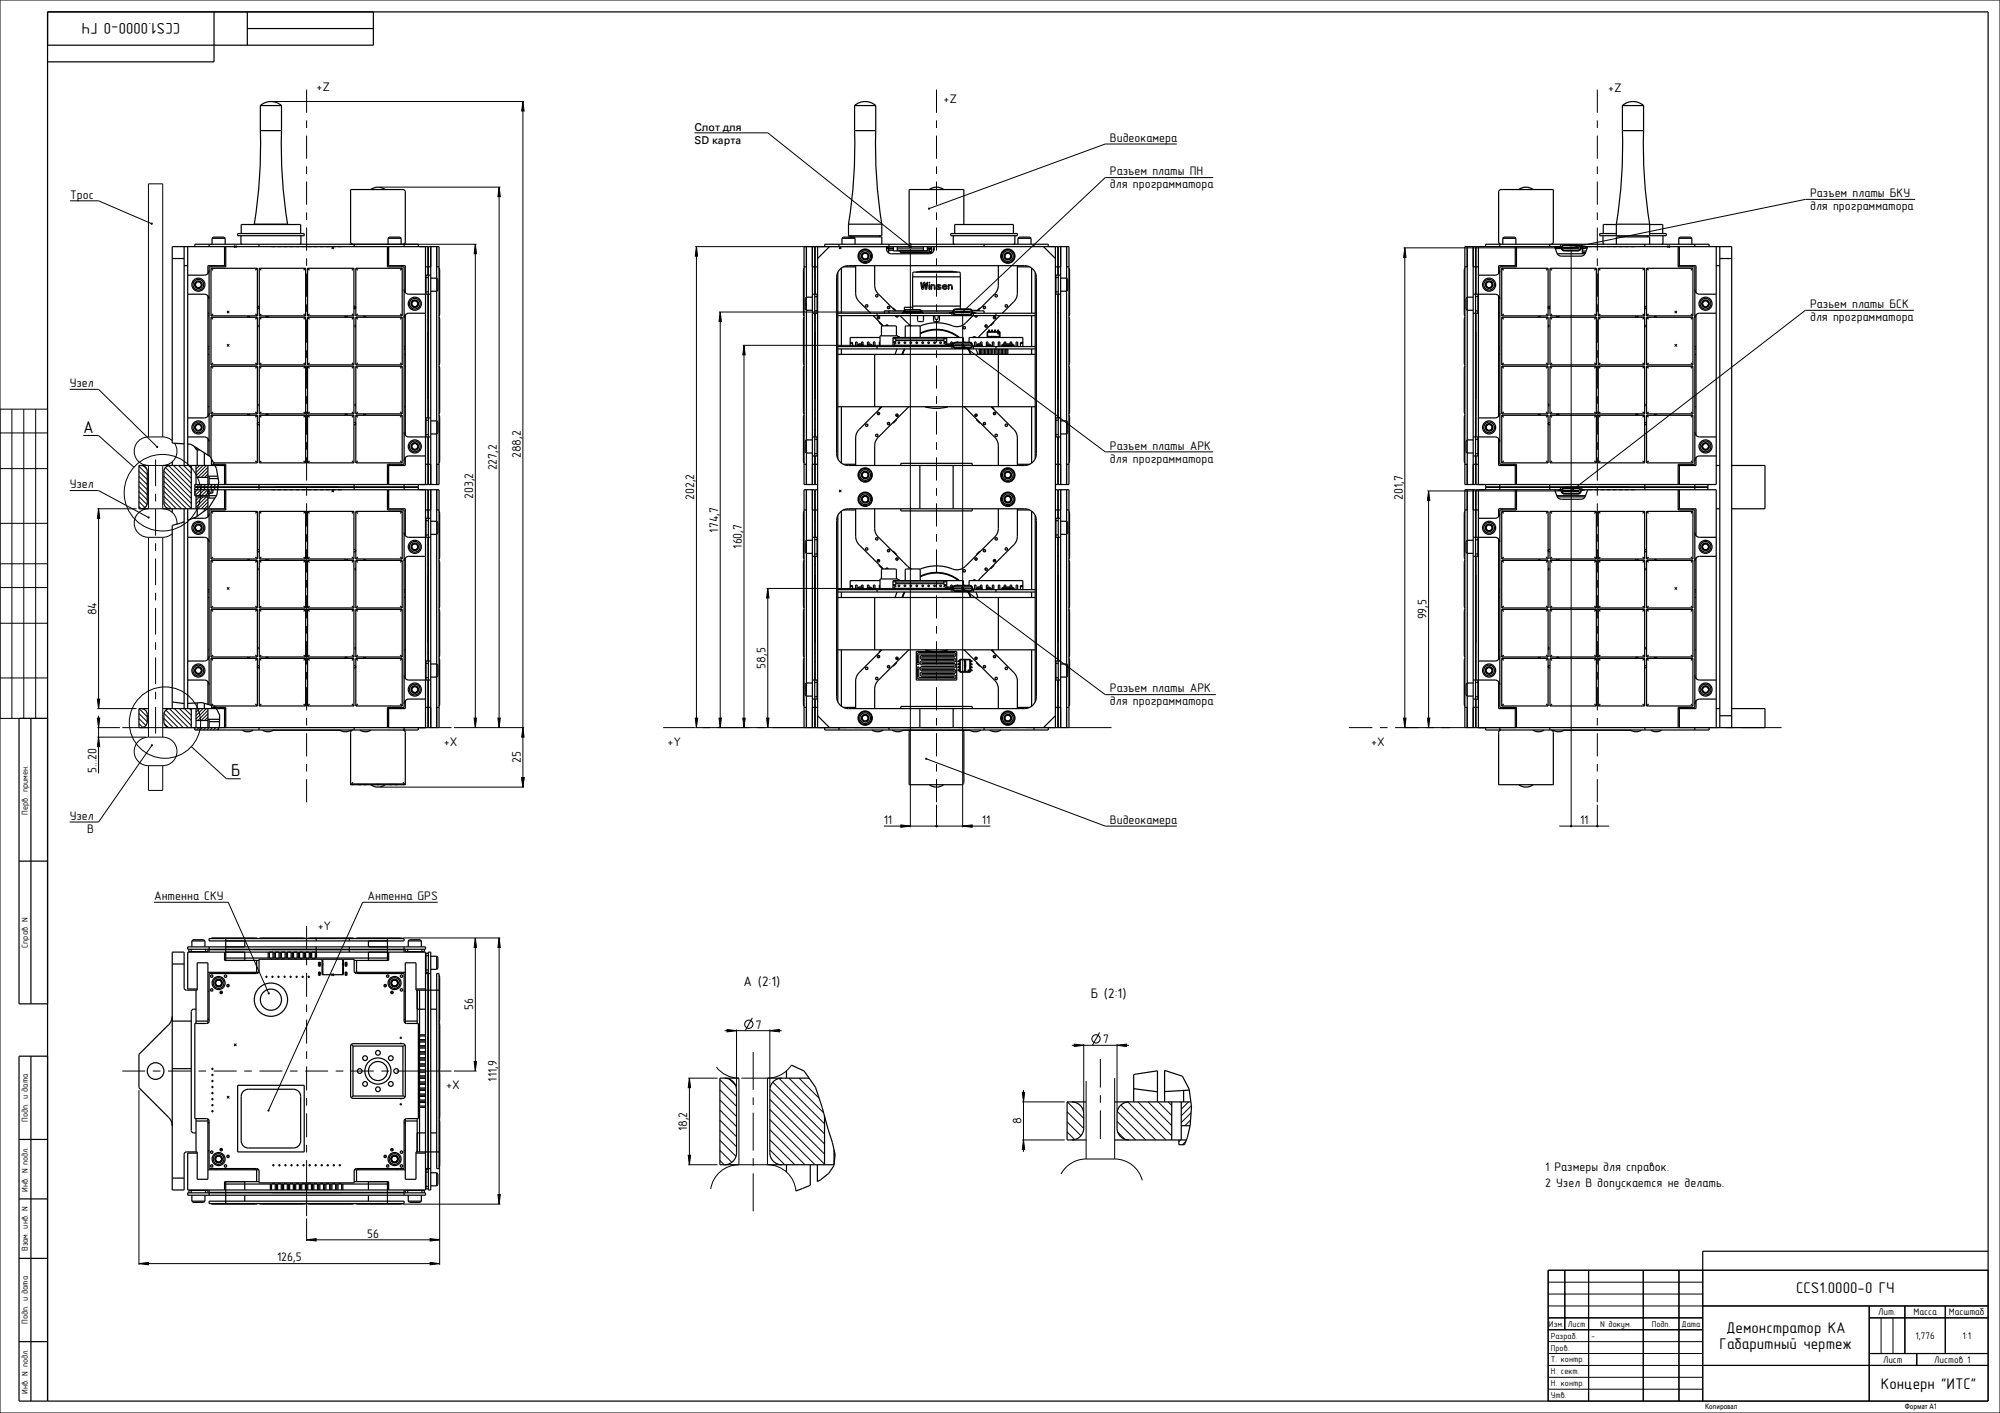
[picture p42: page 1]
Копировал; Формат А1; Трос; Узел; УзелВ; Видеокамера; Слот для SD карта; Антенна СКУ; Антенна GPS

Разъем платы ПН
для программатора

Разъем платы БКУ

Разьем платы БСК

Разъем платы АРК

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

1 Размеры для справок.
2 Узел В допускается не делать.

CCS1.0000-0 ГЧ

Демонстратор КА Габаритный чертеж | Лит. | Масса | Масштаб

Изм. | Лист | N докум. | Подп. | Дата | | | | | 1,776 | 1:1
Разраб. | | -
Пров.
Т. контр. | | | | | Лист | Листов 1
Н. сект. | | | | | Концерн "ИТС"
Н. контр.
Утв.
