CONZERN-ITS/can-cube-sat/doc/Отчетные документы на зимнюю сессию/CCS1.0000-0СБ - Сборочный чертеж ДКА.pdf

+Z | +Z

12

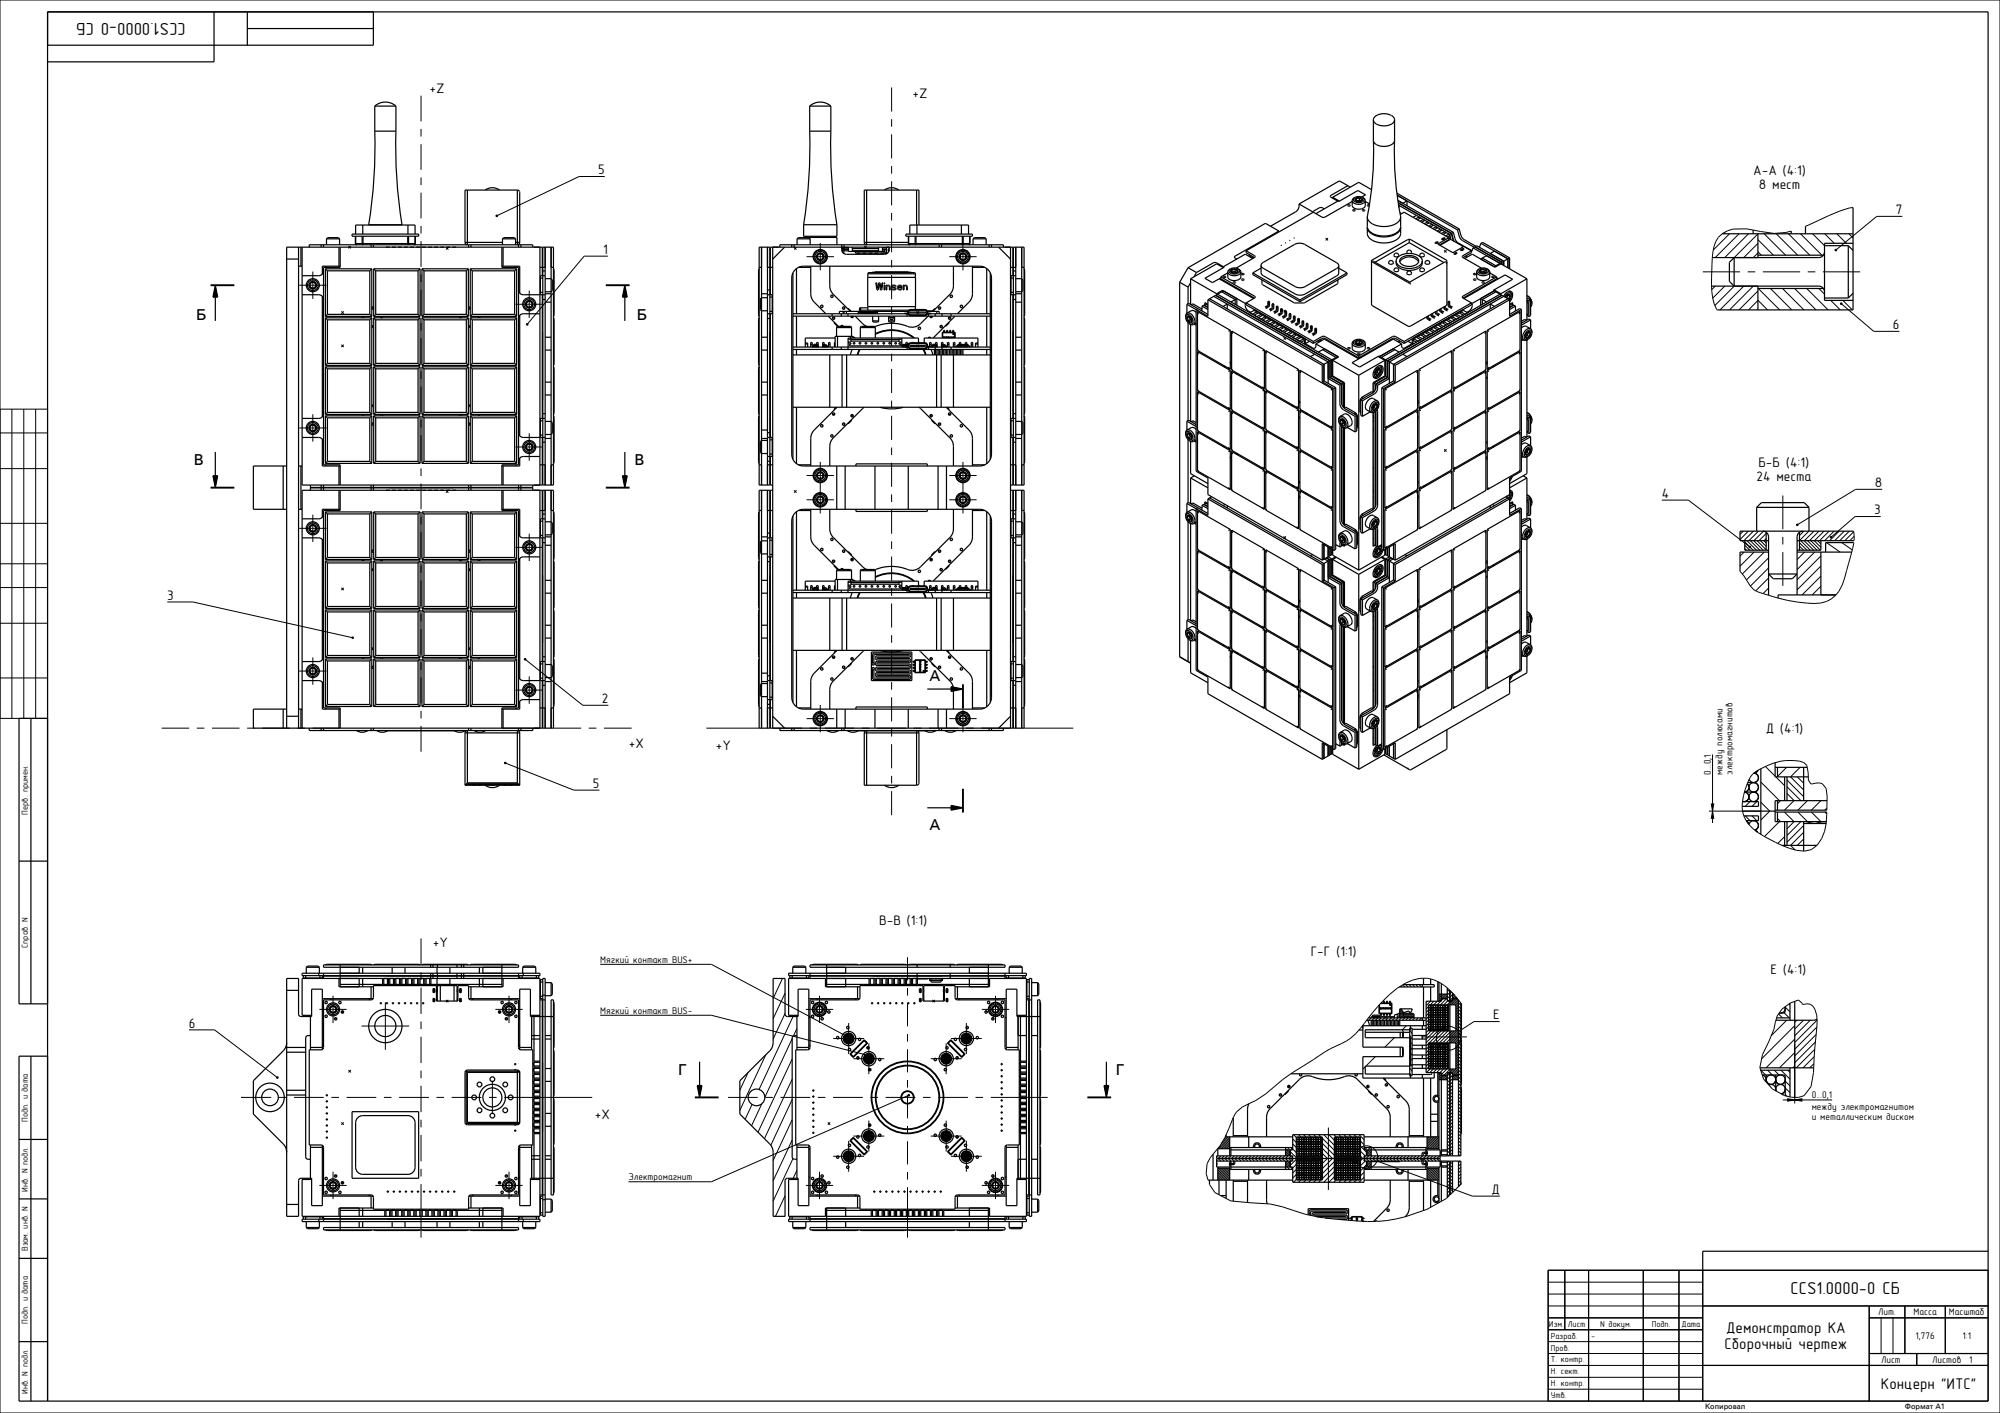
[picture p43: page 1]
Копировал; Формат А1; Б-Б (4:1) 24 места; А-А (4:1) 8 мест; Электромагнит; между полюсами; электромагнитов; 0...0,1 между электромагнитом и металлическим диском

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

Мягкий контакт BUS+

Мягкий контакт BUS-

CCS1.0000-0 СБ

Демонстратор КА Сборочный чертеж | Лит. | Масса | Масштаб

Изм. | Лист | N докум. | Подп. | Дата | | 1,776 | 1:1
Разраб. Пров. Т. контр. Н. сект. Н. контр. Утв. | | -

Лист | Листов 1
Концерн "ИТС"
