CONZERN-ITS/can-cube-sat/doc/Отчетные документы на зимнюю сессию/CCS1.0000-0Э3 - Схема электрическая принципиальная ДKA.pdf

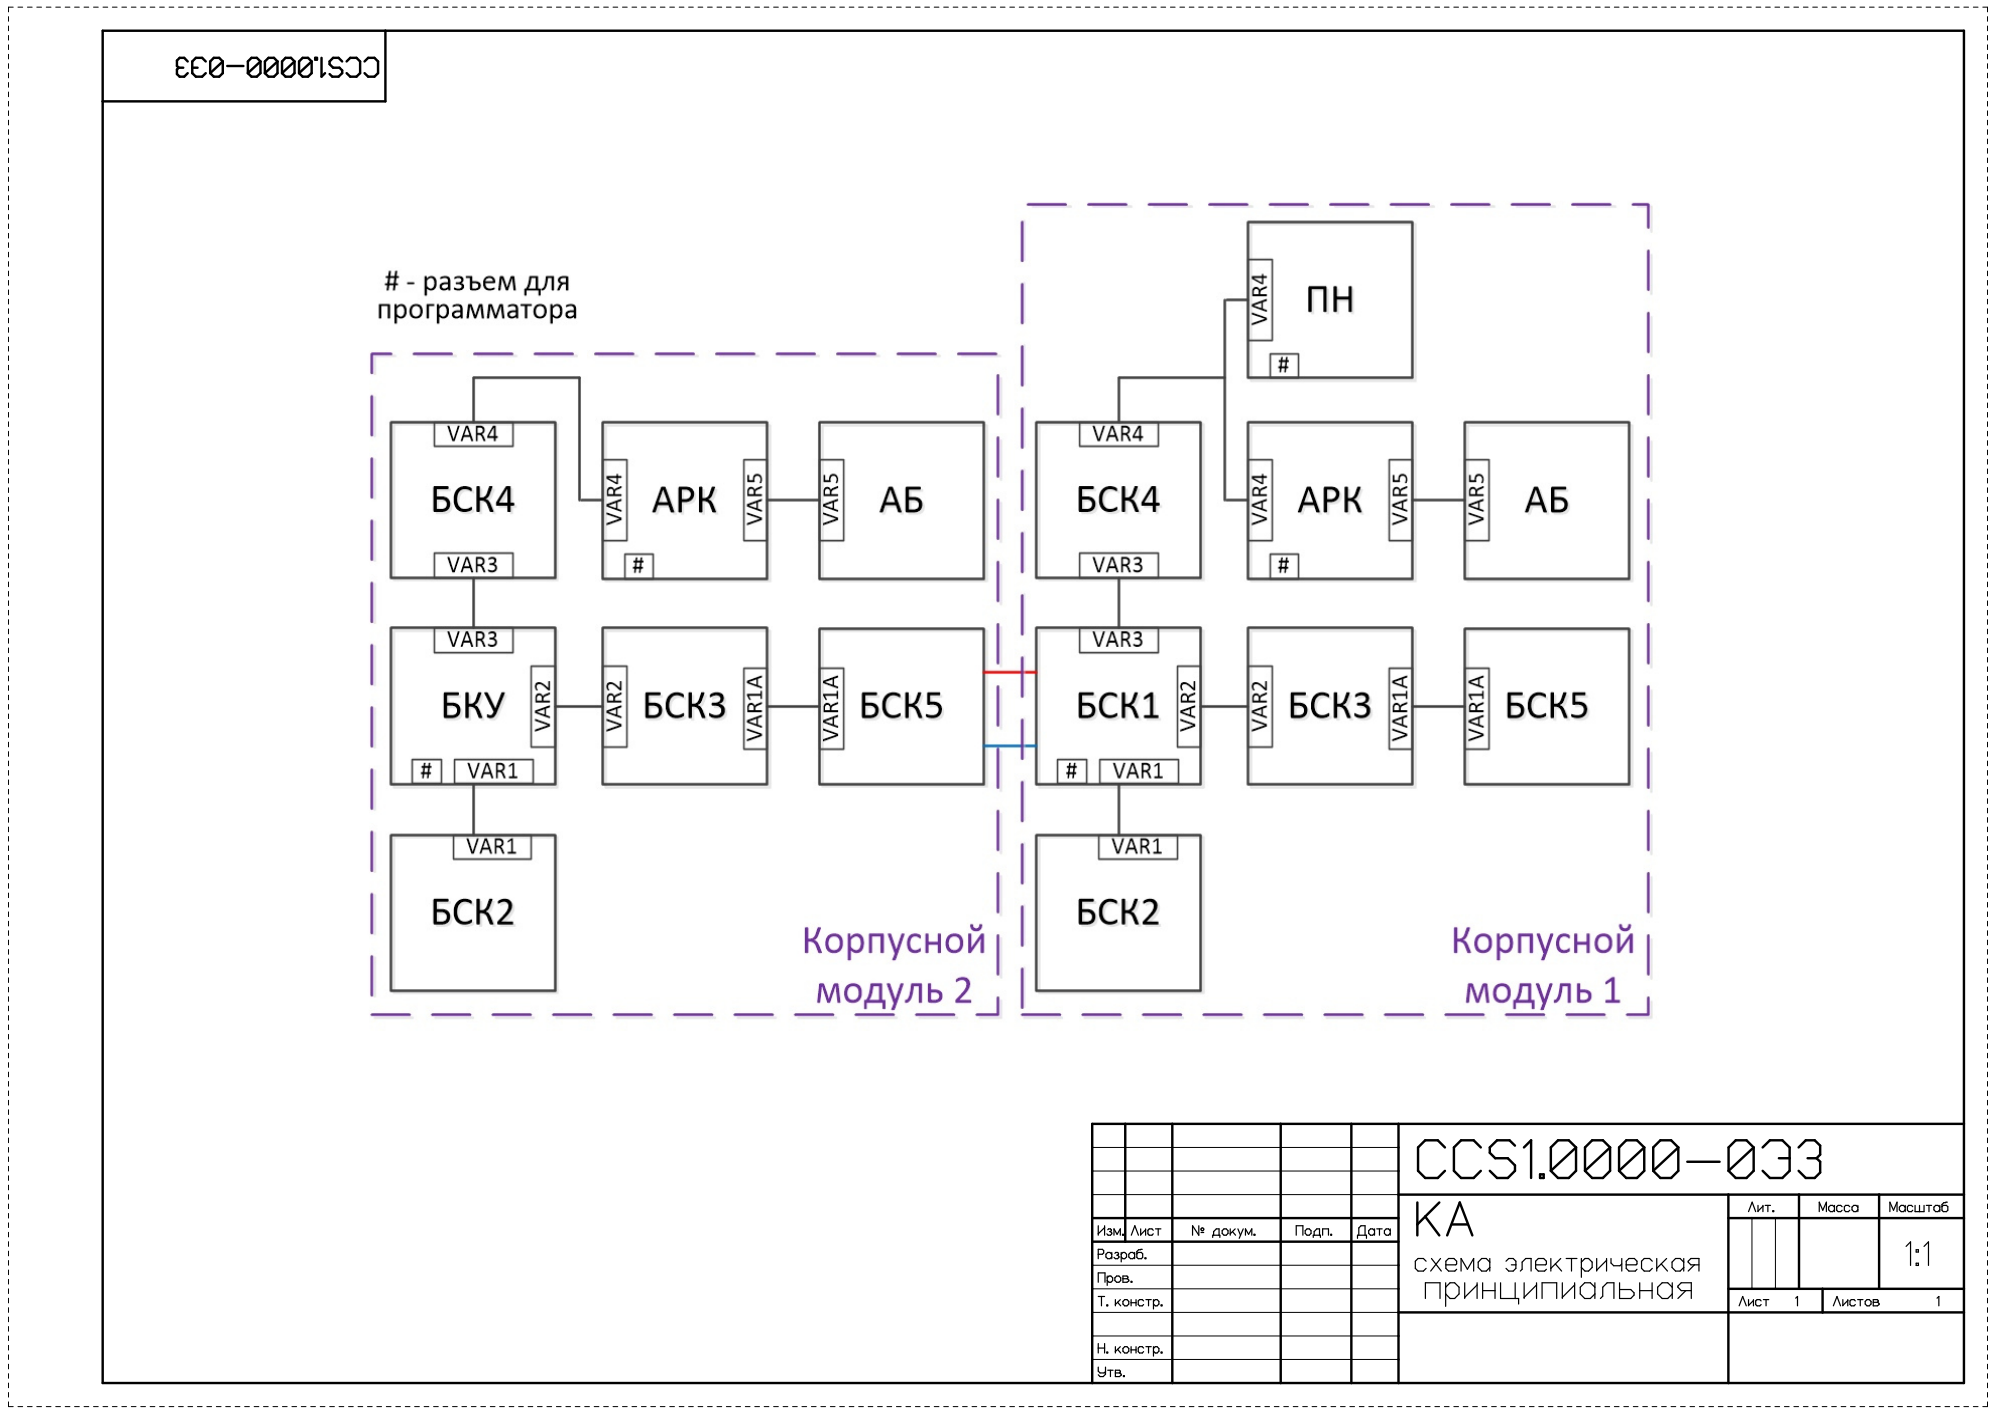
[picture p44: page 1]
