CONZERN-ITS/can-cube-sat/doc/Отчетные документы на зимнюю сессию/CCS1.2300-0Э3 - Схема электрическая принципиальная БСК2.pdf

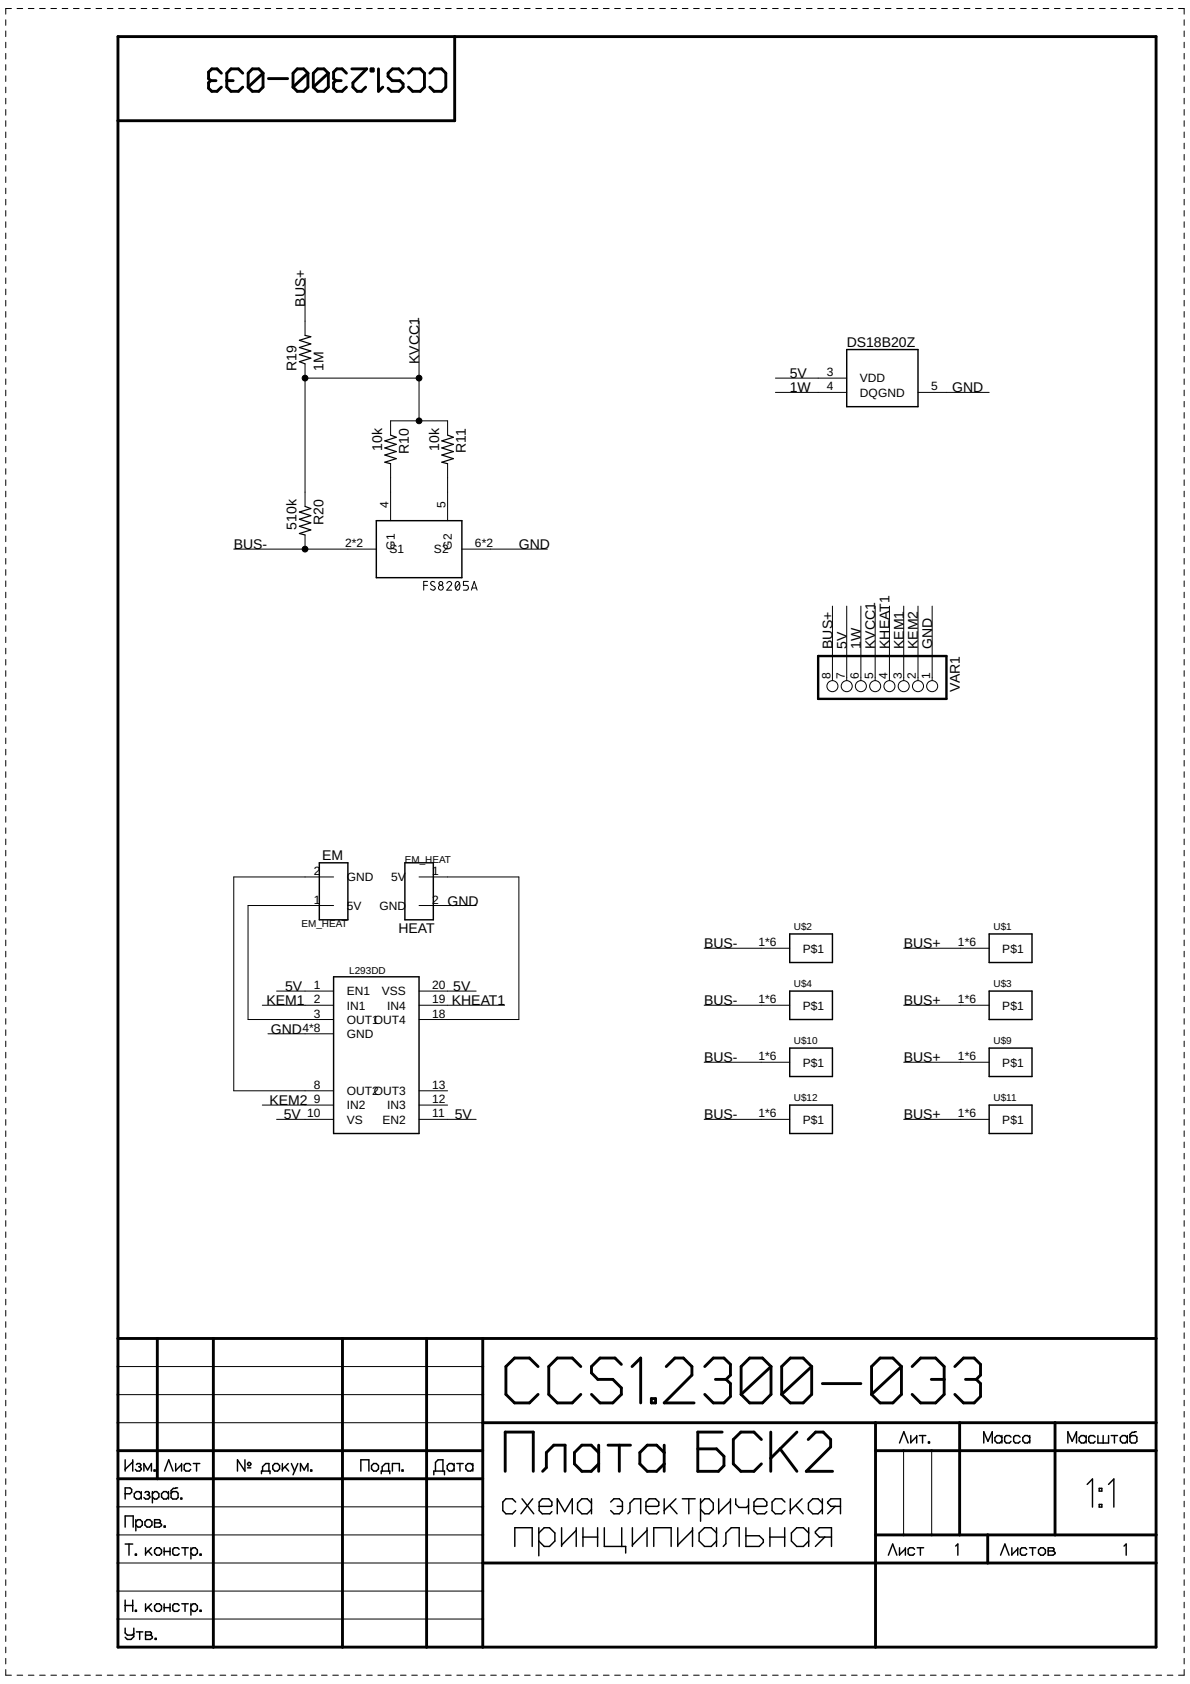
[picture p45: page 1]

BUS+ BUS+ BUS+ BUS+ BUS+

BUS- BUS-
