CONZERN-ITS/can-cube-sat/doc/Отчетные документы на зимнюю сессию/CCS1.2400-0Э3 - Схема электрическая принципиальная БСК3.pdf

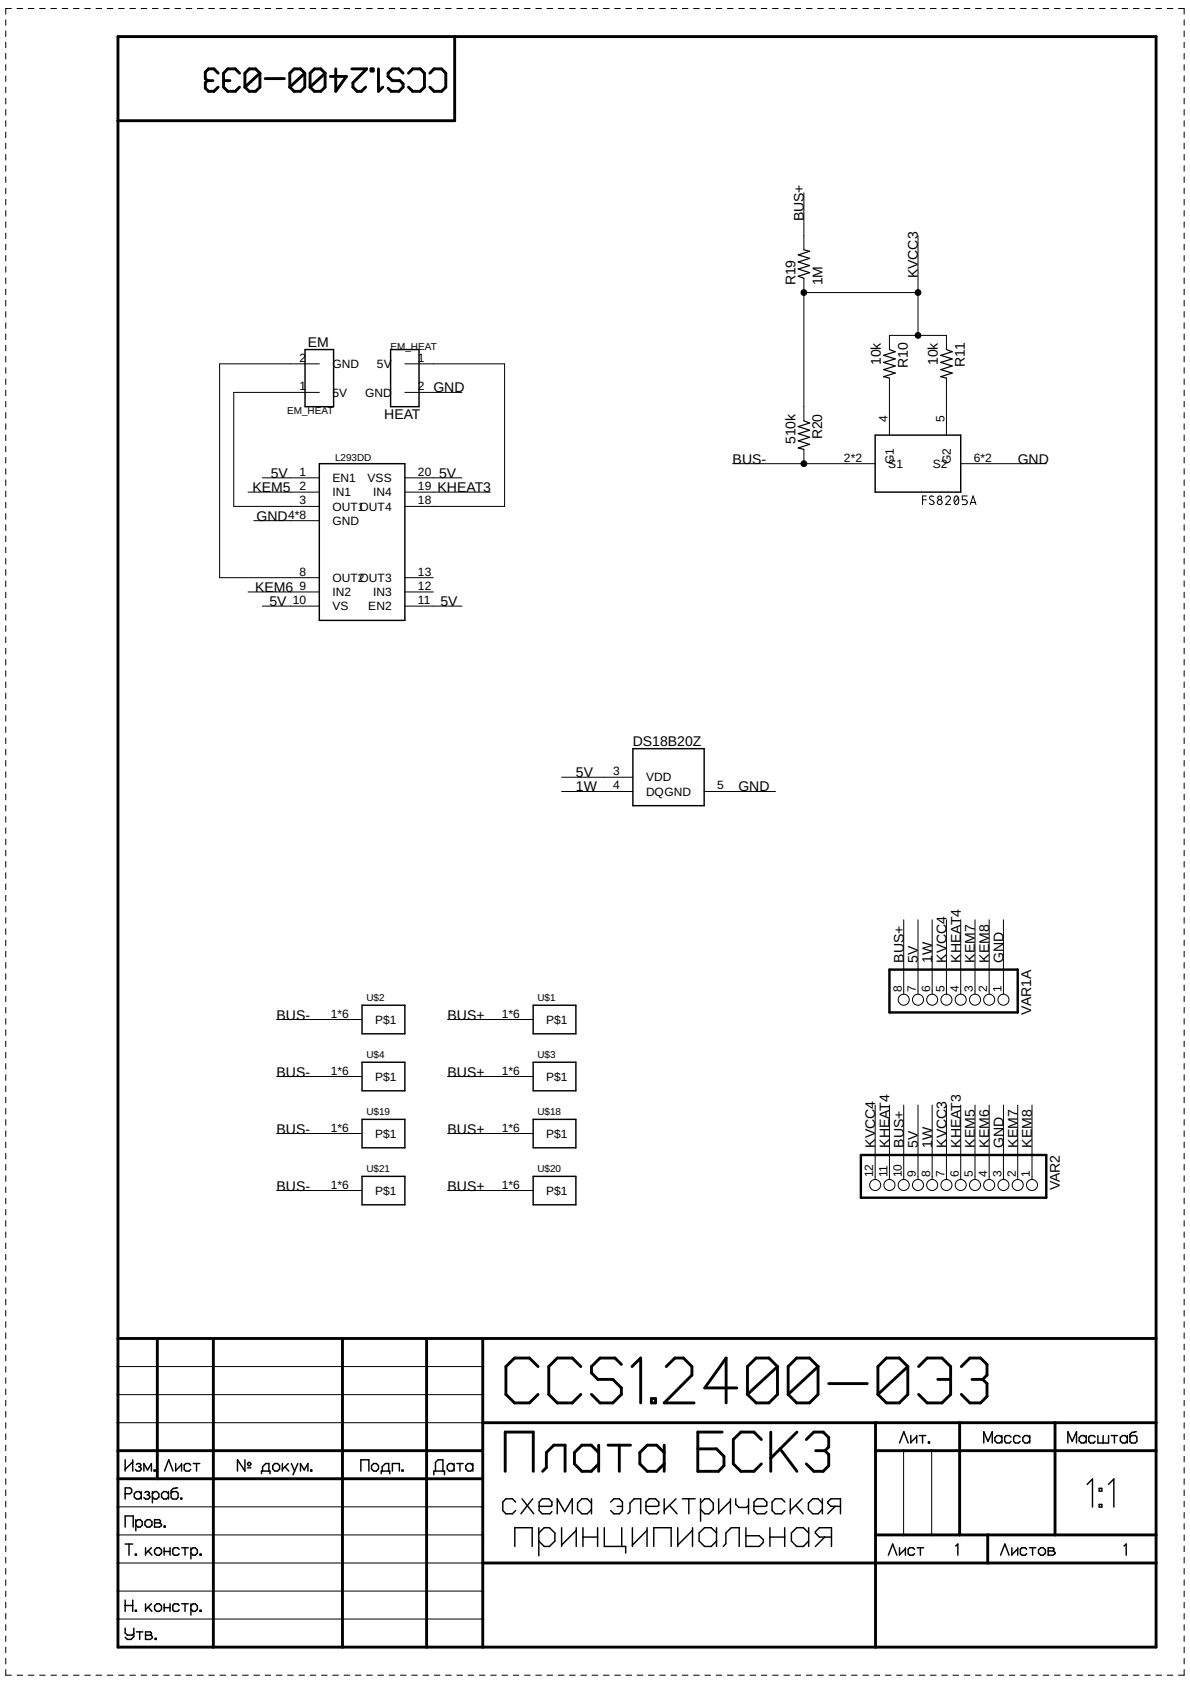
[picture p46: page 1]

BUS- BUS-

BUS+ BUS+
