CONZERN-ITS/can-cube-sat/doc/Отчетные документы на зимнюю сессию/CCS1.2500-0Э3 - Схема электрическая принципиальная БСК4.pdf

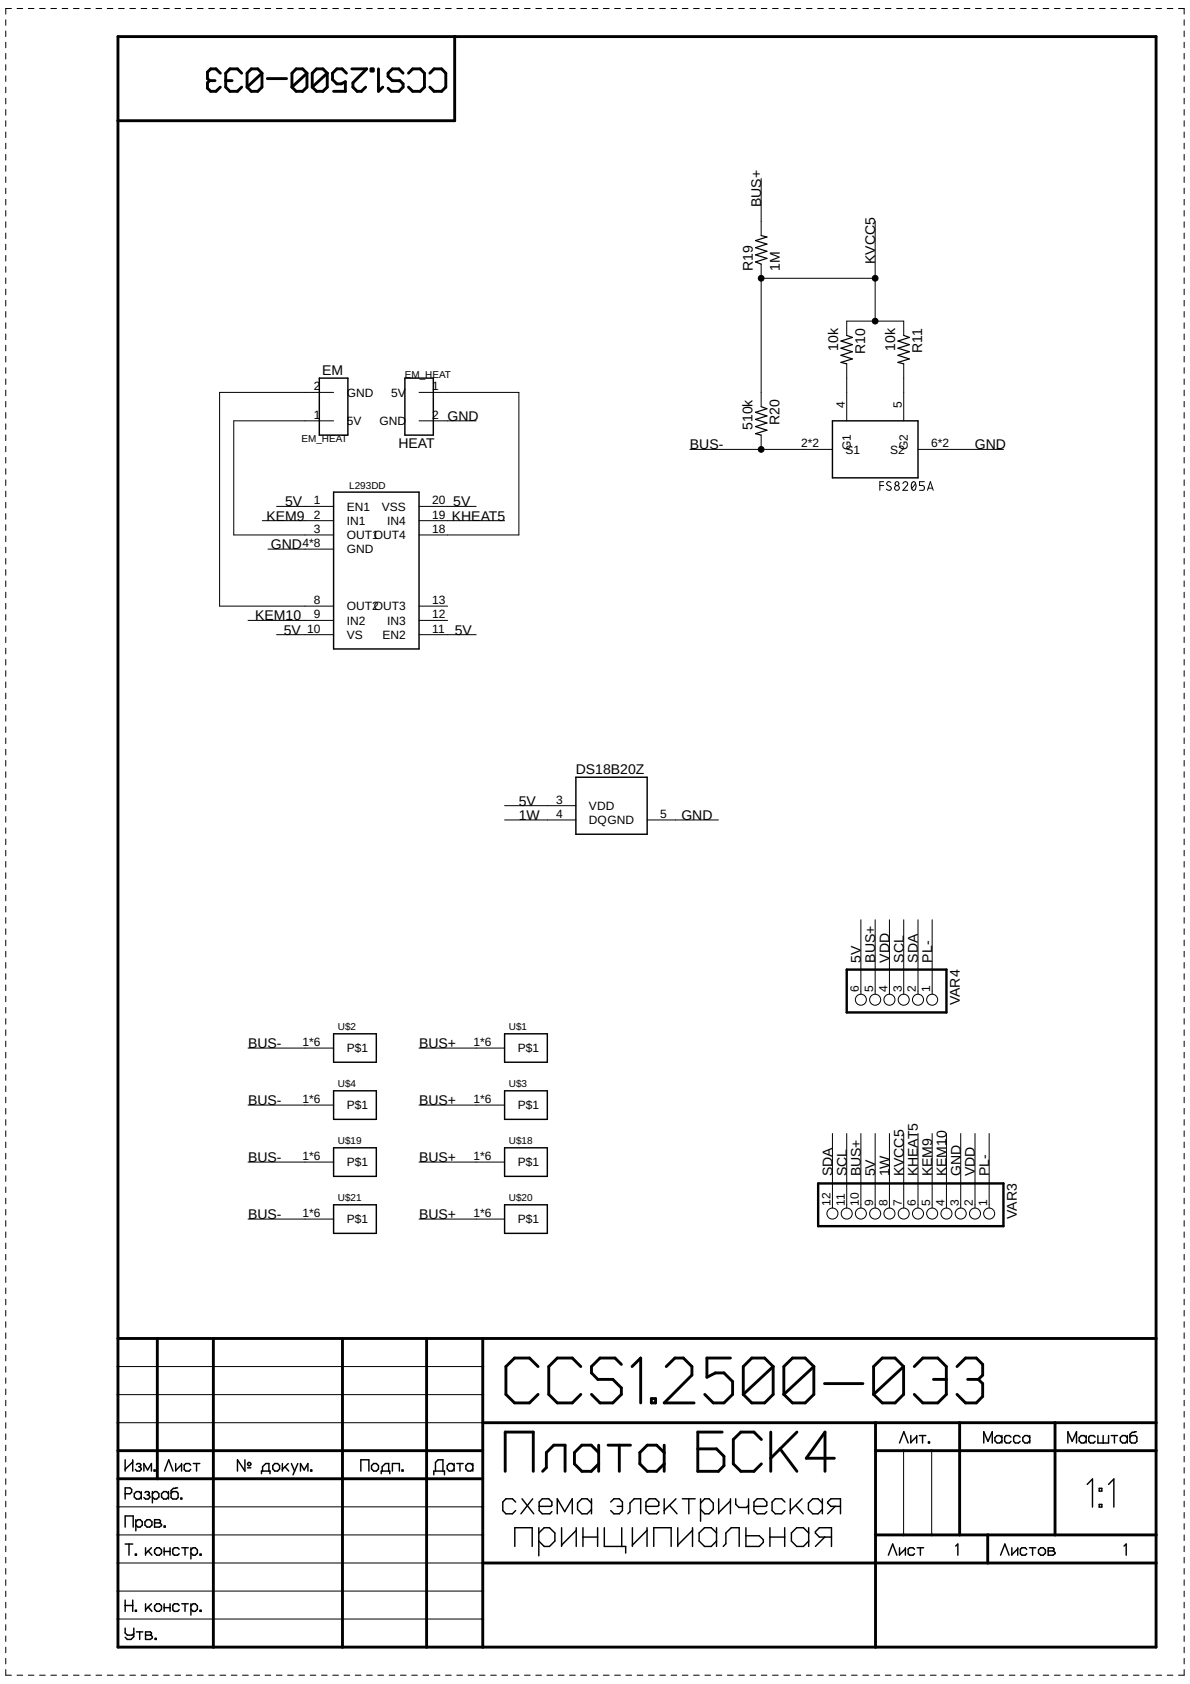
[picture p47: page 1]

BUS+ BUS+
