CONZERN-ITS/can-cube-sat/doc/Отчетные документы на зимнюю сессию/CCS1.2600-0Э3 - Схема электрическая принципиальная БСК5.pdf

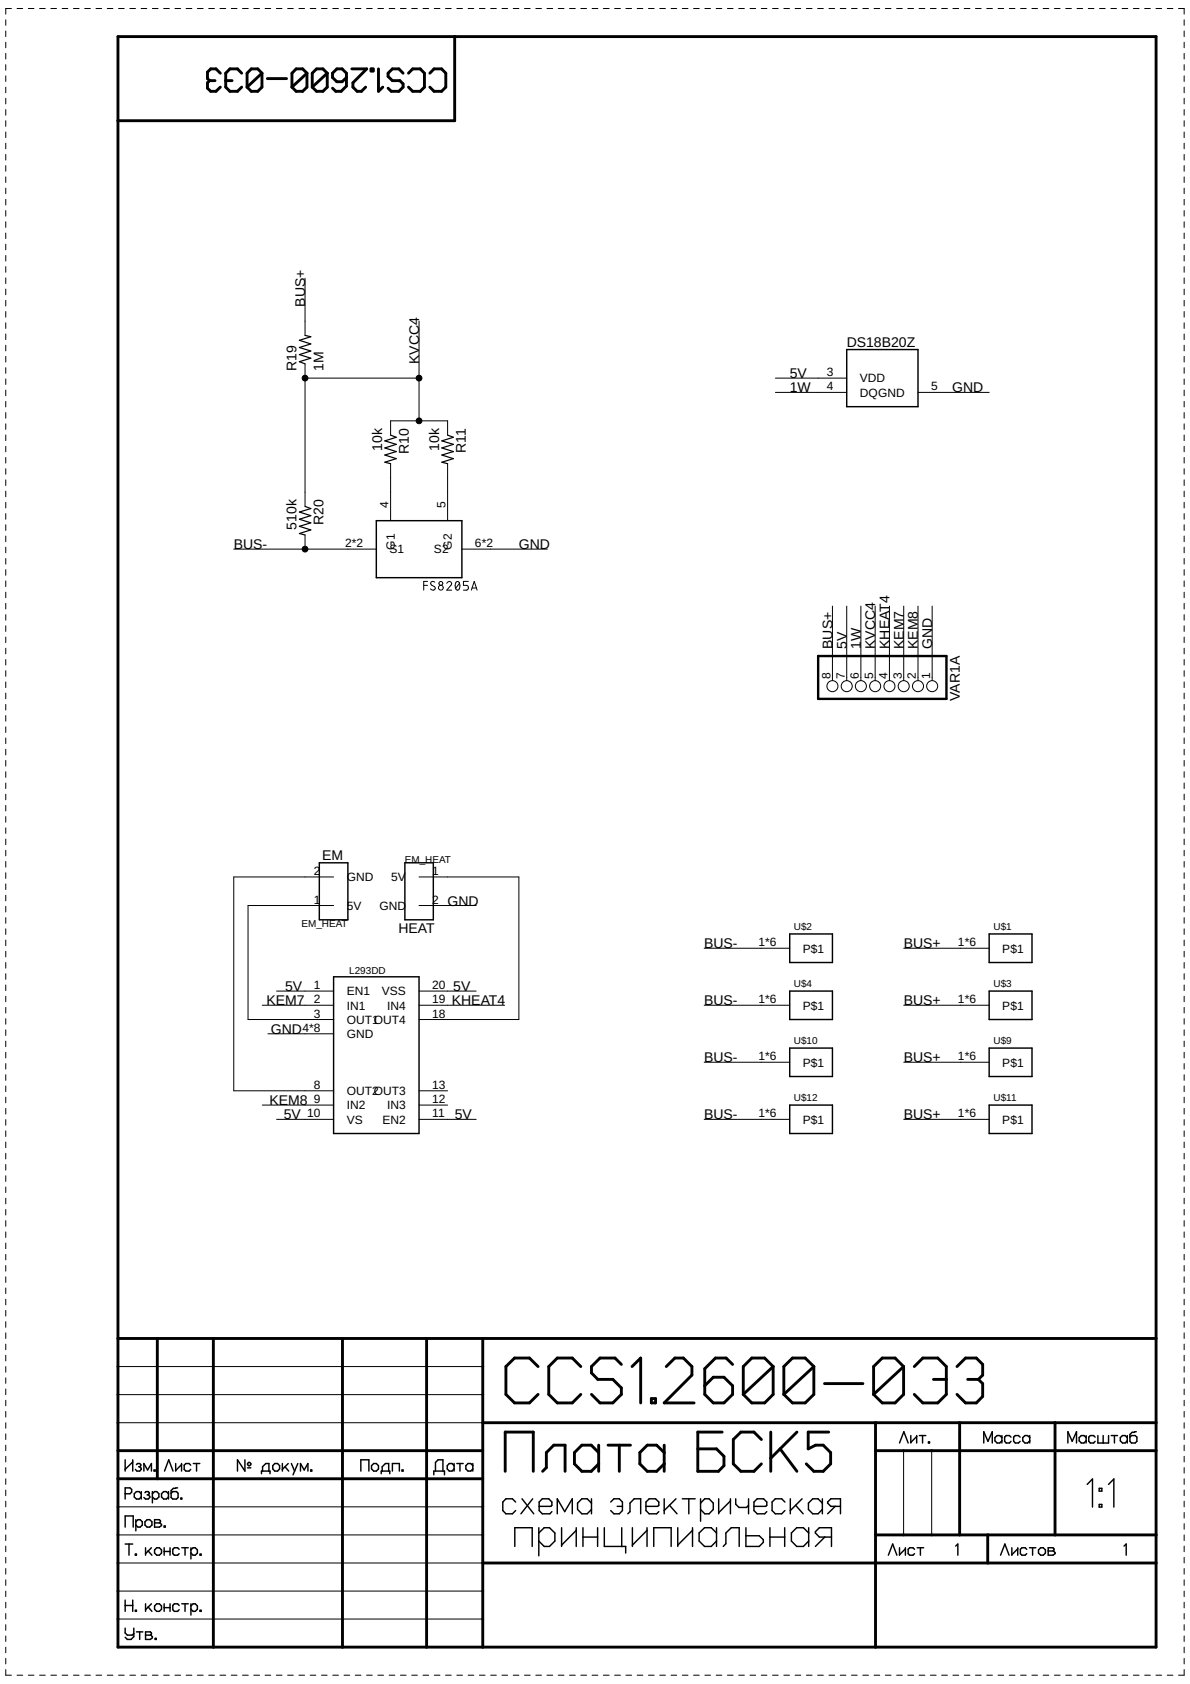
[picture p48: page 1]

BUS+ BUS+ BUS+ BUS+ BUS+

BUS- BUS-
