CONZERN-ITS/can-cube-sat/doc/Отчетные документы на зимнюю сессию/CCS1.3100-0Э3 - Схема электрическая принципиальная АРК.pdf

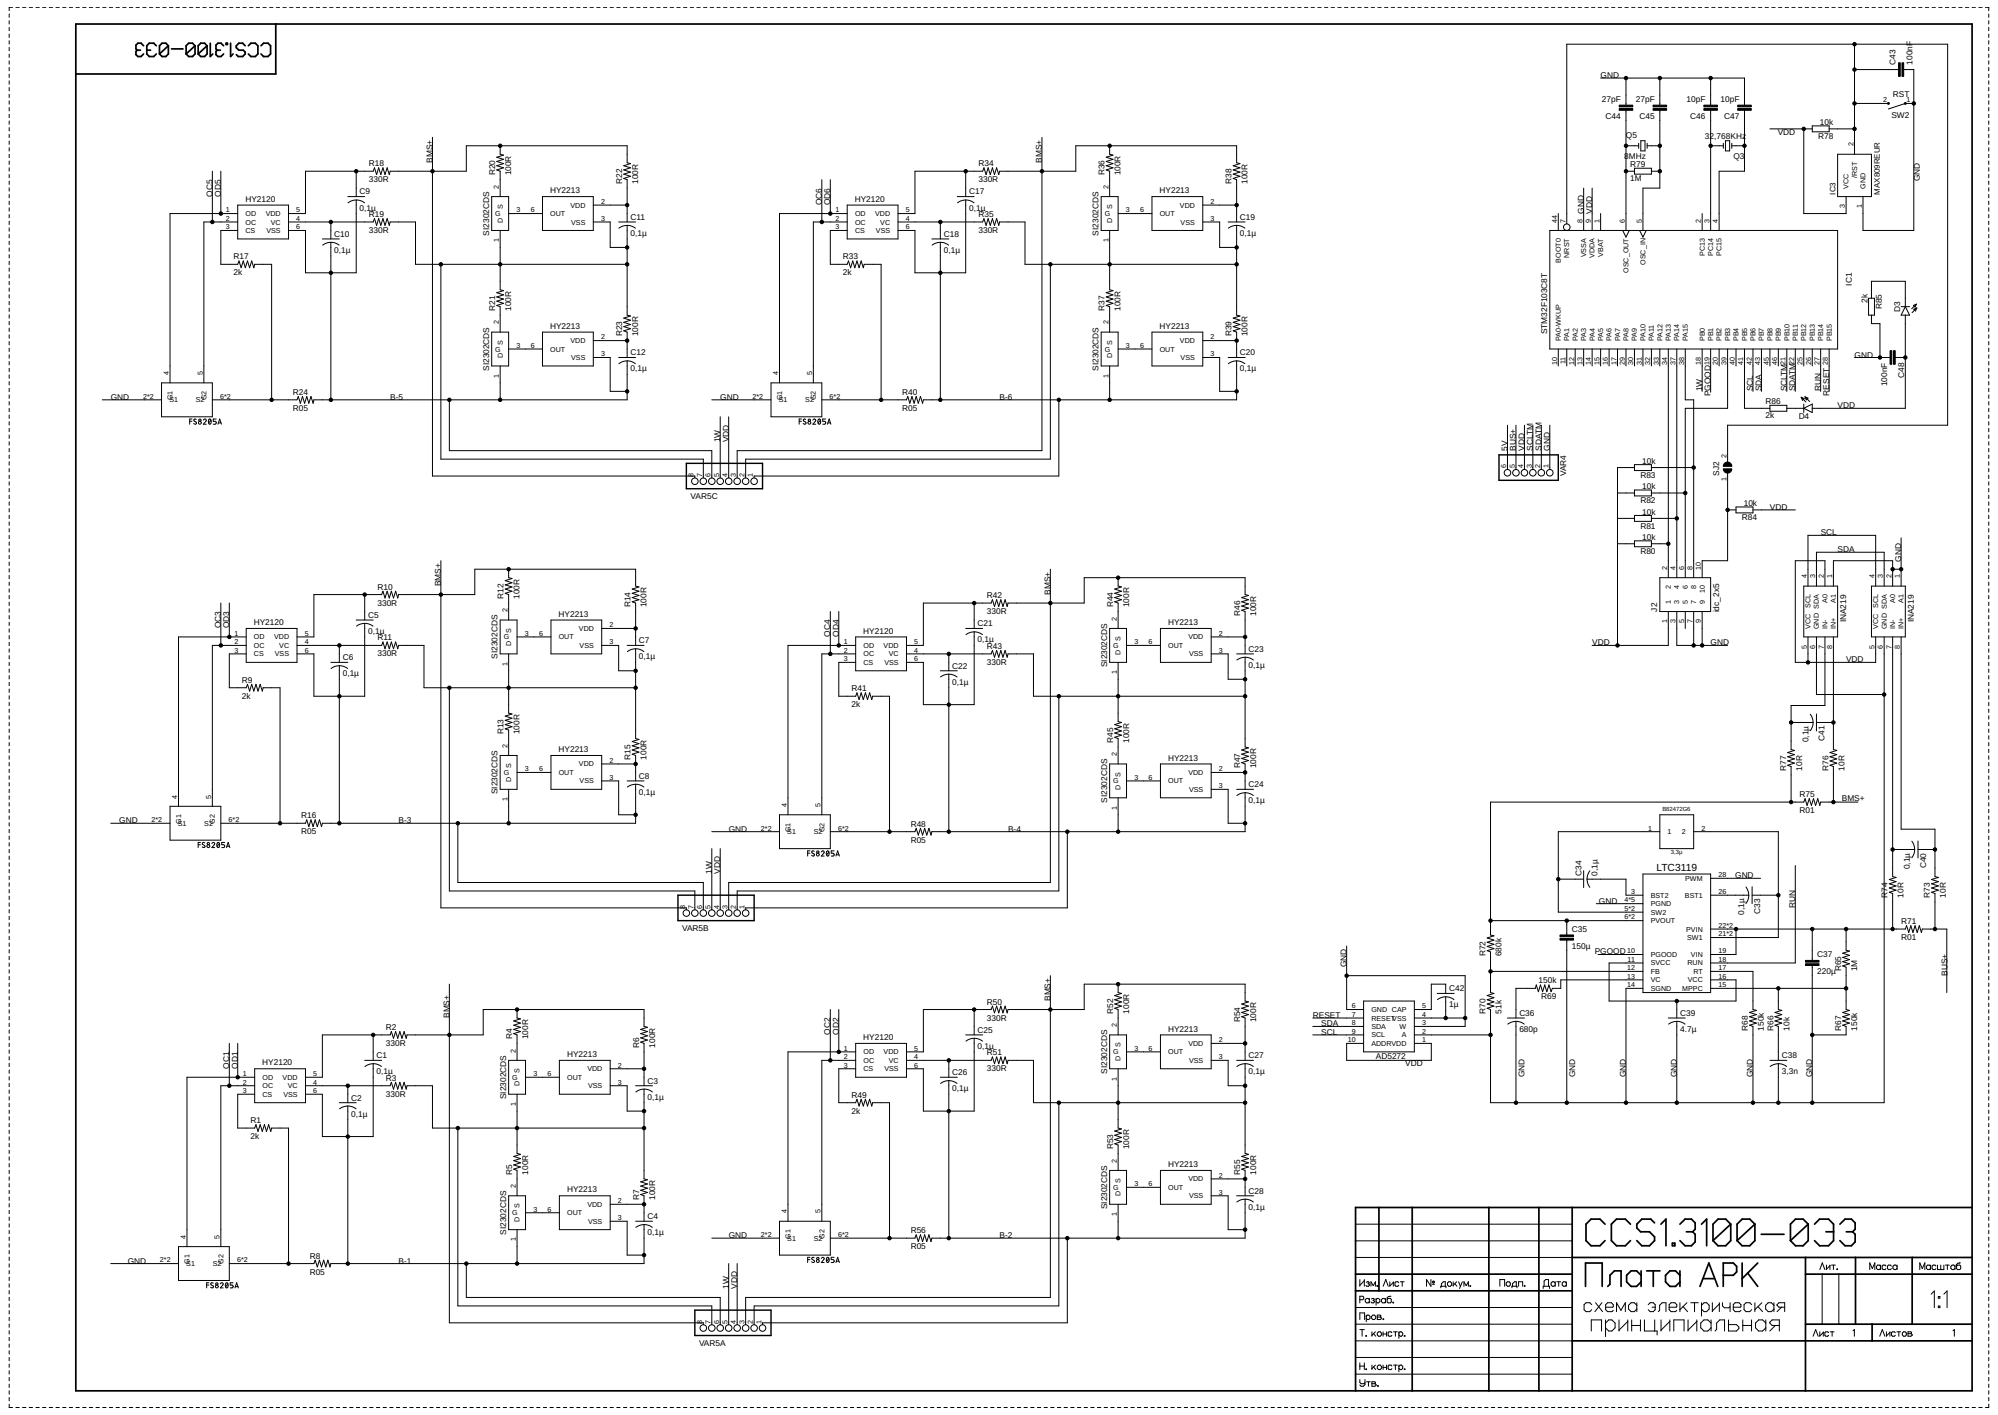
[picture p49: page 1]
