CONZERN-ITS/can-cube-sat/schematics/board/MAG.brd

## EAGLE design schematics/board/MAG.brd (2020-08-12)

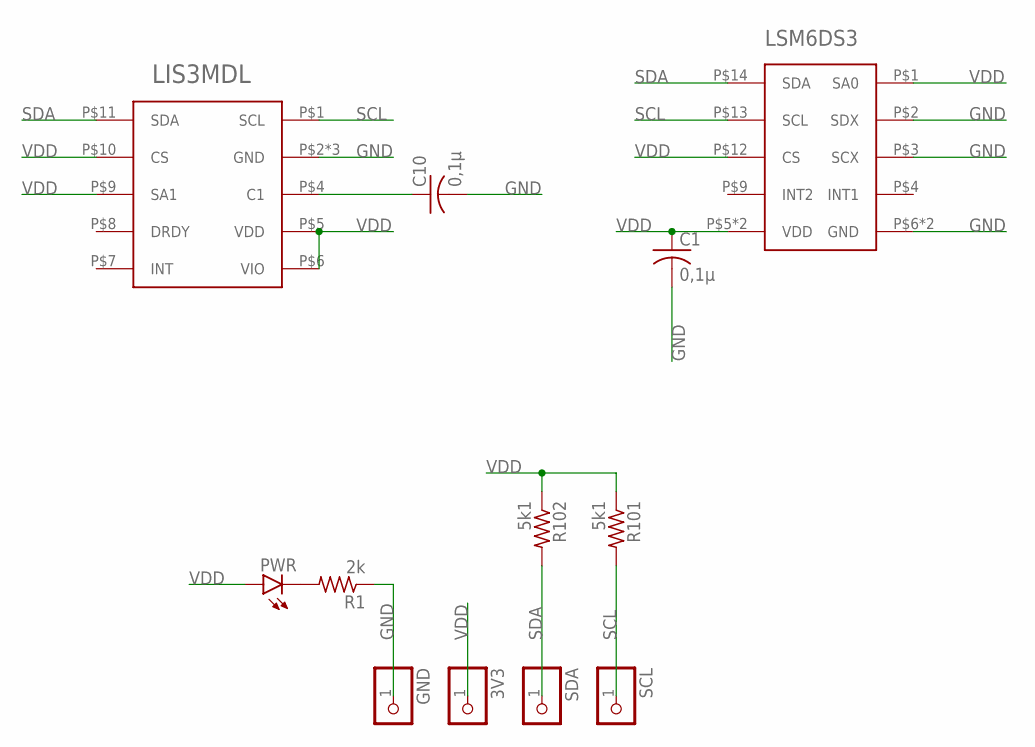
[picture p50: schematic MAG.sch]

Parts:
3V3: PINHD-1X1; 1X01
C1, C10: 0,1µ; C0603
GND: PINHD-1X1; 1X01
LIS3MDL: LIS3MDL
LSM6DS3: LSM6DS3
PWR: LEDCHIPLED_0603; CHIPLED_0603
R1: 2k; R0603
R101, R102: 5k1; R0603
SCL: PINHD-1X1; 1X01
SDA: PINHD-1X1; 1X01

Connections:
GND: C1.2, C10.2, GND.1, LIS3MDL.P$2 (GND), LIS3MDL.P$3 (GND), LIS3MDL.P$12 (GND), LSM6DS3.P$2 (SDX), LSM6DS3.P$3 (SCX), LSM6DS3.P$6 (GND), LSM6DS3.P$7 (GND), R1.1
unnamed: PWR.C, R1.2
unnamed: C10.1, LIS3MDL.P$4 (C1)
SCL: LIS3MDL.P$1 (SCL), LSM6DS3.P$13 (SCL), R101.2, SCL.1
SDA: LIS3MDL.P$11 (SDA), LSM6DS3.P$14 (SDA), R102.2, SDA.1
VDD: 3V3.1, C1.1, LIS3MDL.P$5 (VDD), LIS3MDL.P$6 (VIO), LIS3MDL.P$9 (SA1), LIS3MDL.P$10 (CS), LSM6DS3.P$1 (SA0), LSM6DS3.P$5 (VDD), LSM6DS3.P$8 (VDD), LSM6DS3.P$12 (CS), PWR.A, R101.1, R102.1

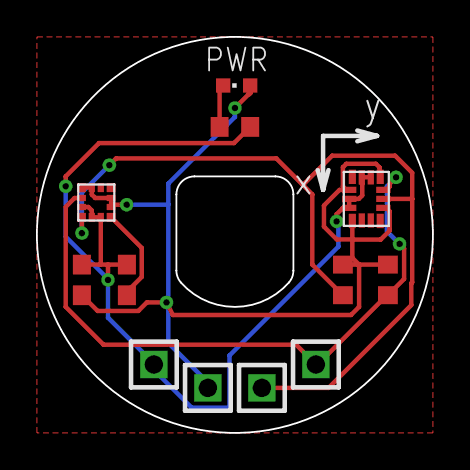
[picture p51: board MAG.brd from above]

Board: 2 copper layers, 22.0 x 22.0 mm, 12 parts (0 on the bottom side), 6 nets.
