CONZERN-ITS/can-cube-sat/schematics/board/ARKnew.brd

## EAGLE design schematics/board/ARKnew.brd (2020-08-12)

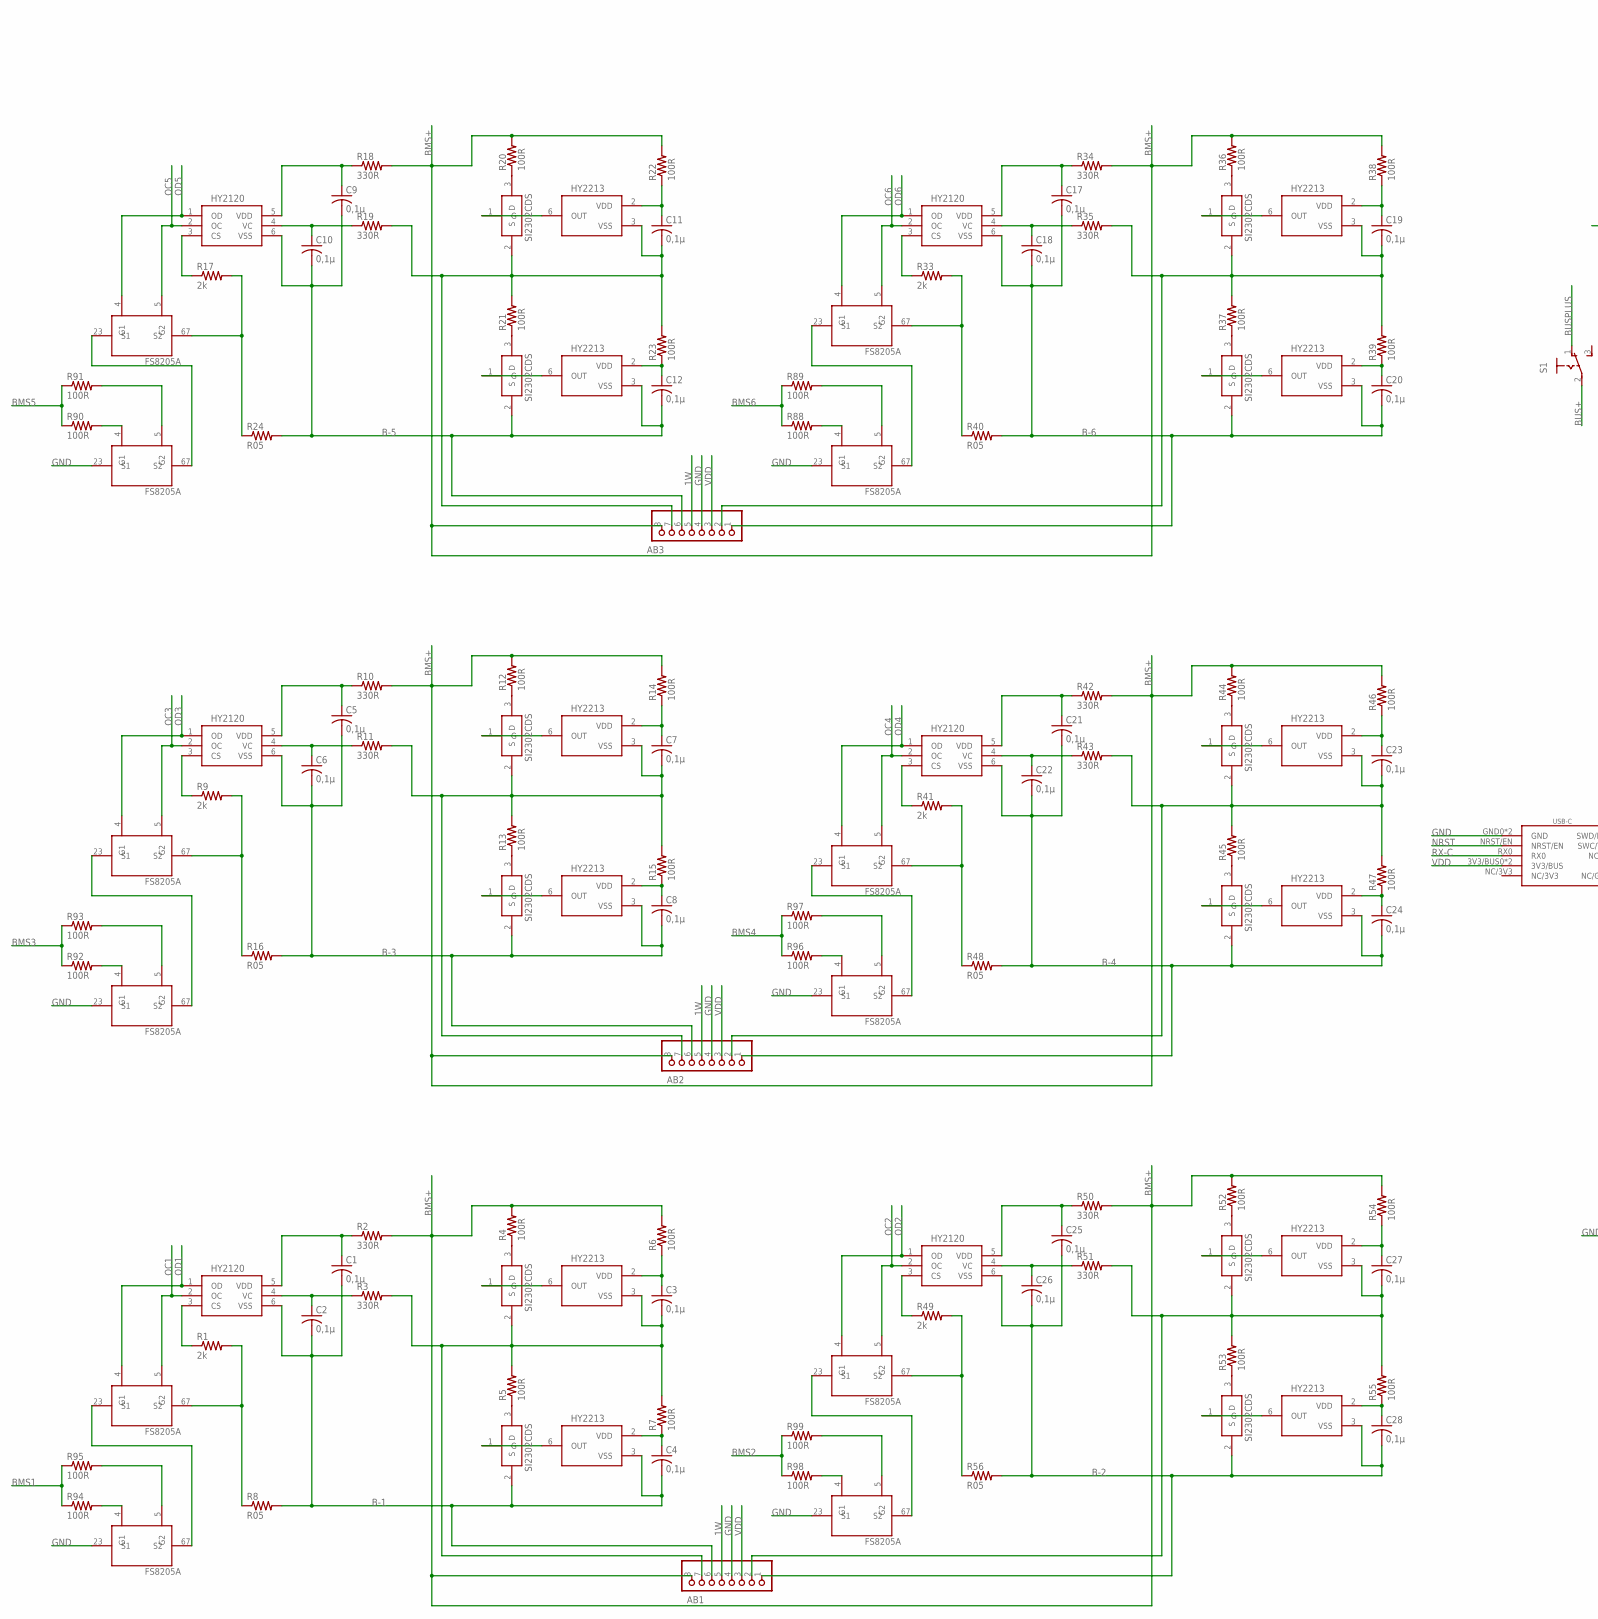
[picture p55: schematic ARKnew.sch, part in row 1, column 1]

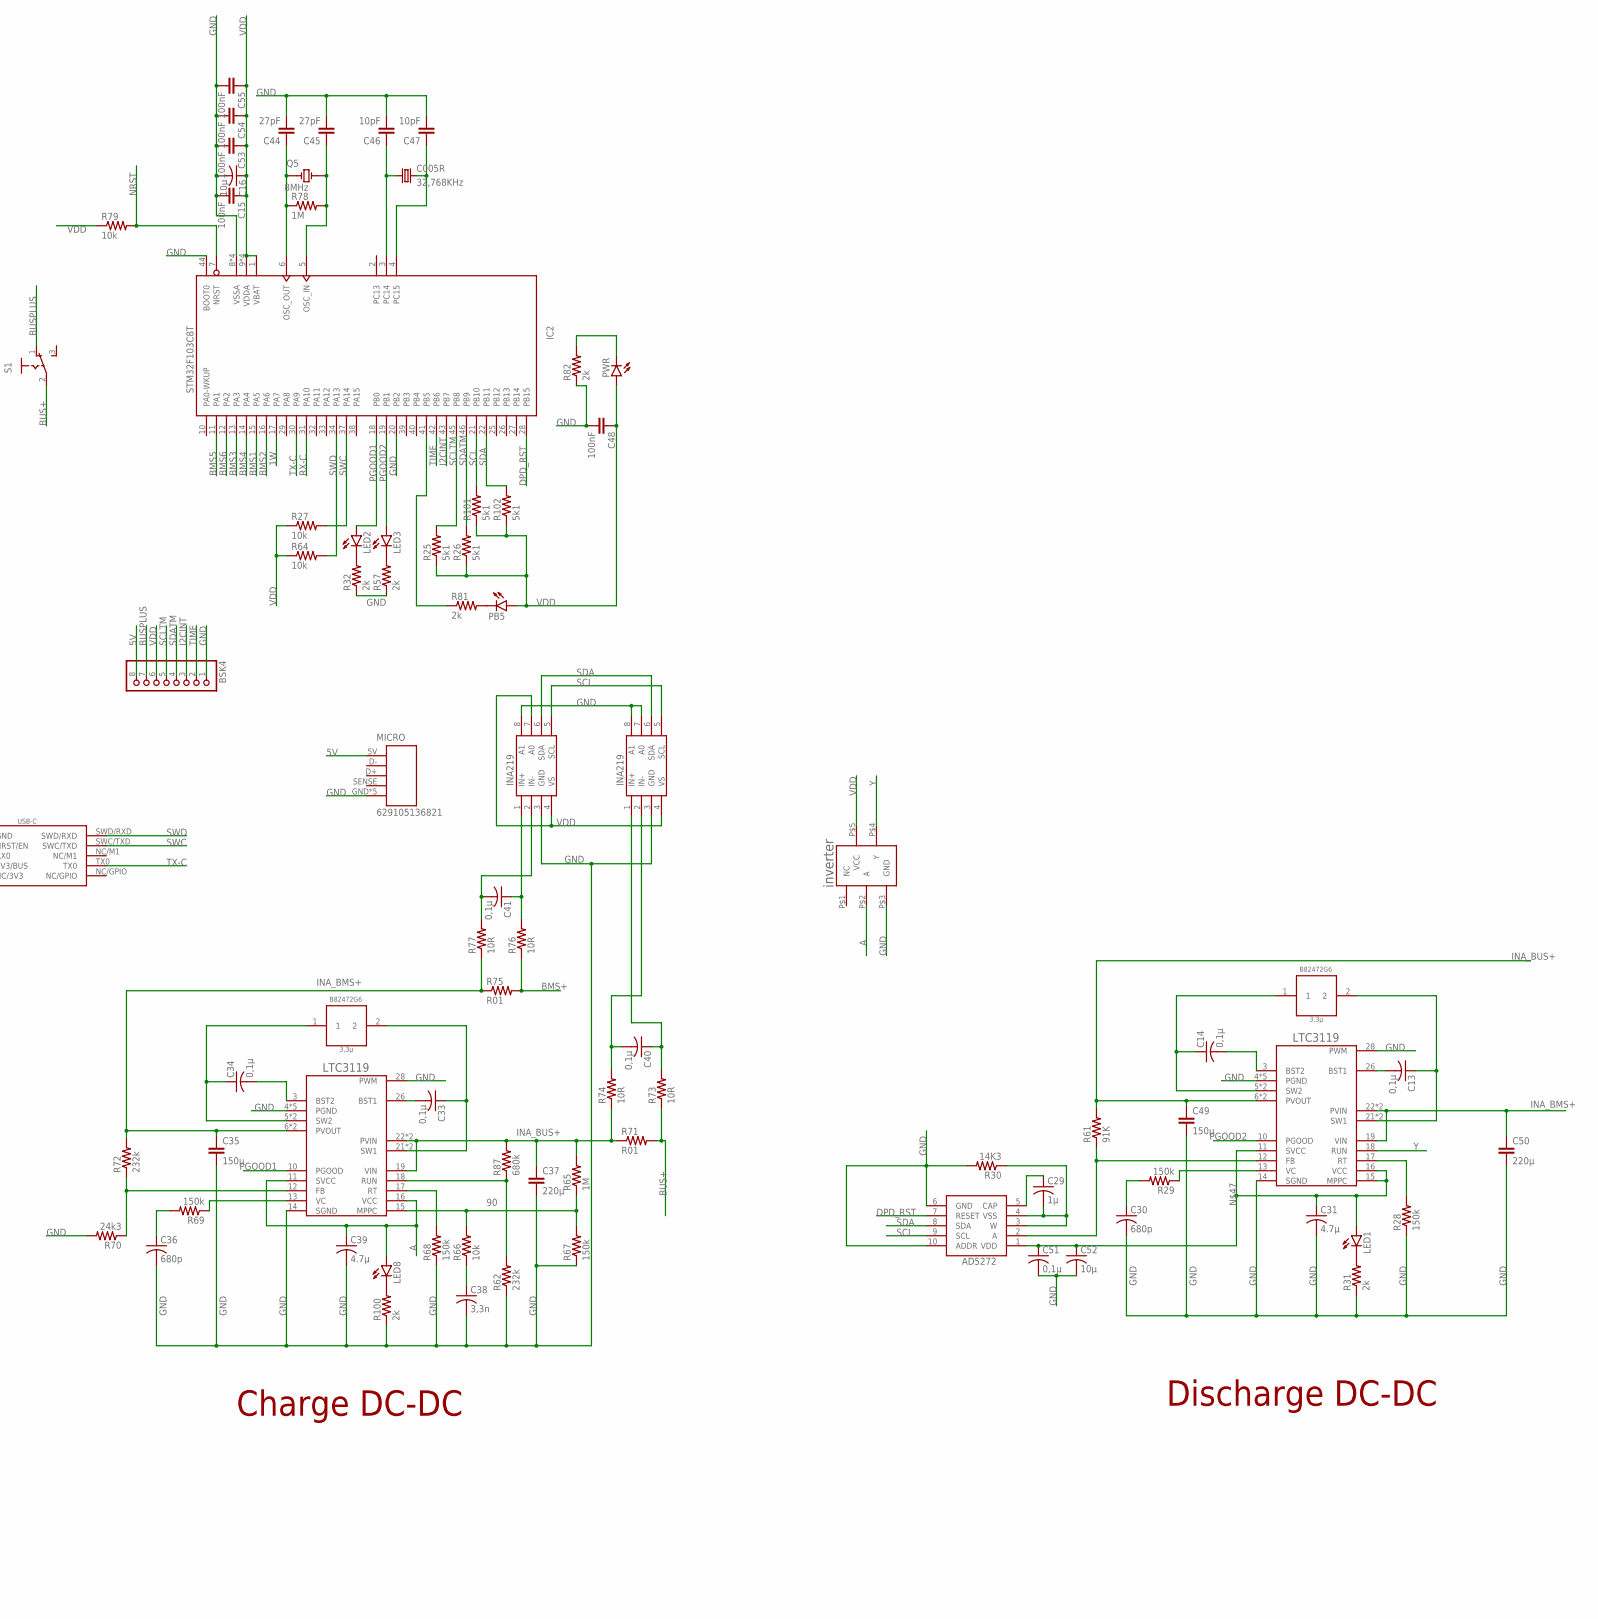
[picture p56: schematic ARKnew.sch, part in row 1, column 2]

Parts:
3,3µH, 3,3µH1: 3,3µ; B82472G6
AB1, AB2, AB3: PINHD-1X8; 1X08
AD5272#2: AD5272
BSK4: PINHD-1X8; 1X08
C1, C2, C3, C4, C5, C6, C7, C8, C9, C10, C11, C12, C13, C14, C17, C18, C19, C20, C21, C22, C23, C24, C25, C26, C27, C28, C33, C34, C40, C41, C51: 0,1µ; C0603
C005R: 32,768KHz; C005R
C15, C48, C53, C54, C55: 100nF; C0603
C16, C52: 10µ; C1206
C29: 1µ; C0603
C30, C36: 680p; C0603
C31, C39: 4.7µ; C1206
C35, C49: 150µ; ECAP150
C37, C50: 220µ; ECAP220
C38: 3,3n; C0603
C44, C45: 27pF; C0603
C46, C47: 10pF; C0603
IC2: STM32F103C8T; LQFP48
INA219#1: INA219AID
LED1, LED2, LED3, LED8: LEDCHIPLED_0603; CHIPLED_0603
MICRO: 629105136821
PB5: LEDCHIPLED_0603; CHIPLED_0603
PWR: LEDCHIPLED_0603; CHIPLED_0603
Q5: 8MHz; XTAL_9C-8.000MEEJ-T
R1, R9, R17, R31, R32, R33, R41, R49, R57, R81, R82, R100: 2k; R0603
R2, R3, R10, R11, R18, R19, R34, R35, R42, R43, R50, R51: 330R; R0603
R4, R5, R6, R7, R12, R13, R14, R15, R20, R21, R22, R23, R36, R37, R38, R39, R44, R45, R46, R47, R52, R53, R54, R55, R88, R89, R90, R91, R92, R93, R94, R95, R96, R97, R98, R99: 100R; R0603
R8, R16, R24, R40, R48, R56: R05; R2512
R25, R26, R101, R102: 5k1; R0603
R27, R64, R66, R79: 10k; R0603
R28, R29, R67, R68, R69: 150k; R0603
R30: 14K3; R0603
R61: 91K; R0603
R62, R72: 232k; R0603
R65, R78: 1M; R0603
R70: 24k3; R0603
R71, R75: R01; R2512
R73, R74, R76, R77: 10R; R0603
R87: 680k; R0603
S1: UNICS-SWITCH
U$1, U$8, U$9, U$15, U$22, U$24, U$25, U$26, U$27, U$28, U$29, U$30: FS8205A-
U$2: INVERTER
U$3, U$10, U$17, U$31, U$38, U$45: HY2120
U$4, U$5, U$11, U$12, U$18, U$19, U$32, U$33, U$39, U$40, U$46, U$47: HY2213
U$6, U$7, U$13, U$14, U$20, U$21, U$34, U$35, U$41, U$42, U$48, U$49: SI2302CDS
U$16, U$59: LTC3119
U$23: USB-C
U$57: INA219AID

Connections:
1W: AB1.5, AB2.5, AB3.5, IC2.17 (PA7)
5V: BSK4.8, MICRO.5V (1)
90: R65.1, R66.2, R67.2, U$59.15 (MPPC)
A: C39.1, LED8.A, U$2.P$2 (A), U$59.11 (SVCC), U$59.16 (VCC)
B-1: AB1.6, C1.2, C2.2, C4.2, R8.2, U$3.6 (VSS), U$5.3 (VSS), U$7.2 (S)
B-2: AB1.1, C25.2, C26.2, C28.2, R56.2, U$45.6 (VSS), U$47.3 (VSS), U$49.2 (S)
B-3: AB2.6, C5.2, C6.2, C8.2, R16.2, U$10.6 (VSS), U$12.3 (VSS), U$14.2 (S)
B-4: AB2.1, C21.2, C22.2, C24.2, R48.2, U$38.6 (VSS), U$40.3 (VSS), U$42.2 (S)
B-5: AB3.6, C9.2, C10.2, C12.2, R24.2, U$17.6 (VSS), U$19.3 (VSS), U$21.2 (S)
B-6: AB3.1, C17.2, C18.2, C20.2, R40.2, U$31.6 (VSS), U$33.3 (VSS), U$35.2 (S)
BMS1: IC2.15 (PA5), R94.1, R95.1
BMS2: IC2.16 (PA6), R98.1, R99.1
BMS3: IC2.13 (PA3), R92.1, R93.1
BMS4: IC2.14 (PA4), R96.1, R97.1
BMS5: IC2.11 (PA1), R90.1, R91.1
BMS6: IC2.12 (PA2), R88.1, R89.1
BMS+: AB1.8, AB2.8, AB3.8, R2.2, R4.2, R6.2, R10.2, R12.2, R14.2, R18.2, R20.2, R22.2, R34.2, R36.2, R38.2, R42.2, R44.2, R46.2, R50.2, R52.2, R54.2, R75.2, R76.1
BUS+: R71.2, R73.1, S1.2
BUSPLUS: BSK4.7, S1.1 (O)
DPD_RST: AD5272#2.7 (RESET), IC2.28 (PB15)
GND: AB1.4, AB2.4, AB3.4, AD5272#2.6 (GND), AD5272#2.10 (ADDR), BSK4.1, C15.2, C16.2, C30.2, C31.2, C35.P$2 (2), C36.2, C37.P$2 (2), C38.2, C39.2, C44.2, C45.2, C46.2, C47.2, C48.2, C49.P$2 (2), C50.P$2 (2), C51.2, C52.2, C53.2, C54.2, C55.2, IC2.8 (VSSA), IC2.20 (PB2), IC2.23 (VSSA), IC2.35 (VSSA), IC2.44 (BOOT0), IC2.47 (VSSA), INA219#1.3 (GND), INA219#1.7 (A0), INA219#1.8 (A1), MICRO.GND (5), MICRO.Z1 (5), MICRO.Z2 (5), MICRO.Z3 (5), MICRO.Z4 (5), R28.1, R30.2, R31.1, R32.1, R57.1, R62.1, R67.1, R68.1, R70.2, R82.1, R100.1, U$2.P$3 (GND), U$9.23 (S1), U$16.4 (PGND), U$16.9 (PGND), U$16.14 (SGND), U$16.20 (PGND), U$16.25 (PGND), U$16.28 (PWM), U$16.29 (PGND), U$22.23 (S1), U$23.GND0 (GND), U$23.GND1 (GND), U$27.23 (S1), U$28.23 (S1), U$29.23 (S1), U$30.23 (S1), U$57.3 (GND), U$57.8 (A1), U$59.4 (PGND), U$59.9 (PGND), U$59.14 (SGND), U$59.20 (PGND), U$59.25 (PGND), U$59.28 (PWM), U$59.29 (PGND)
I2CINT: BSK4.3, IC2.43 (PB7)
INA_BMS+: C35.P$1 (1), C50.P$1 (1), R72.2, R75.1, R77.1, U$16.19 (VIN), U$16.22 (PVIN), U$16.23 (PVIN), U$59.6 (PVOUT), U$59.7 (PVOUT)
INA_BUS+: C37.P$1 (1), C49.P$1 (1), R61.2, R65.2, R71.1, R74.1, R87.2, U$16.6 (PVOUT), U$16.7 (PVOUT), U$59.19 (VIN), U$59.22 (PVIN), U$59.23 (PVIN)
unnamed: C1.1, R2.1, U$3.5 (VDD)
unnamed: C4.1, R7.1, U$5.2 (VDD)
unnamed: R1.1, U$3.3 (CS)
unnamed: C3.1, R6.1, U$4.2 (VDD)
unnamed: AD5272#2.2 (A), R61.1, U$16.12 (FB)
unnamed: U$4.6 (OUT), U$6.1 (G)
unnamed: R4.1, U$6.3 (D)
unnamed: AB1.7, C3.2, R3.2, R5.2, R7.2, U$4.3 (VSS), U$6.2 (S)
unnamed: U$5.6 (OUT), U$7.1 (G)
unnamed: R5.1, U$7.3 (D)
unnamed: 3,3µH1.2, C13.1, U$16.21 (SW1), U$16.24 (SW1)
unnamed: 3,3µH1.1, C14.1, U$16.5 (SW2), U$16.8 (SW2)
unnamed: R1.2, R8.1, U$26.67 (S2)
unnamed: C40.2, INA219#1.2 (IN-), R74.2
unnamed: C2.1, R3.1, U$3.4 (VC)
unnamed: C5.1, R10.1, U$10.5 (VDD)
unnamed: PB5.C, R81.2
unnamed: R9.1, U$10.3 (CS)
unnamed: C7.1, R14.1, U$11.2 (VDD)
unnamed: U$11.6 (OUT), U$13.1 (G)
unnamed: R12.1, U$13.3 (D)
unnamed: U$12.6 (OUT), U$14.1 (G)
unnamed: R13.1, U$14.3 (D)
unnamed: R9.2, R16.1, U$25.67 (S2)
unnamed: R70.1, R72.1, U$59.12 (FB)
unnamed: LED1.C, R31.2
unnamed: C6.1, R11.1, U$10.4 (VC)
unnamed: C8.1, R15.1, U$12.2 (VDD)
unnamed: R28.2, U$16.17 (RT)
unnamed: AB2.7, C7.2, R11.2, R13.2, R15.2, U$11.3 (VSS), U$13.2 (S)
unnamed: R91.2, U$9.5 (G2)
unnamed: C13.2, U$16.26 (BST1)
unnamed: C9.1, R18.1, U$17.5 (VDD)
unnamed: R17.1, U$17.3 (CS)
unnamed: C11.1, R22.1, U$18.2 (VDD)
unnamed: U$18.6 (OUT), U$20.1 (G)
unnamed: R20.1, U$20.3 (D)
unnamed: U$19.6 (OUT), U$21.1 (G)
unnamed: R21.1, U$21.3 (D)
unnamed: R17.2, R24.1, U$24.67 (S2)
unnamed: R29.1, U$16.13 (VC)
unnamed: C30.1, R29.2
unnamed: C10.1, R19.1, U$17.4 (VC)
unnamed: C12.1, R23.1, U$19.2 (VDD)
unnamed: R90.2, U$9.4 (G1)
unnamed: AB3.7, C11.2, R19.2, R21.2, R23.2, U$18.3 (VSS), U$20.2 (S)
unnamed: AD5272#2.1 (VDD), C31.1, C51.1, C52.1, LED1.A, U$16.11 (SVCC), U$16.15 (MPPC), U$16.16 (VCC)
unnamed: AD5272#2.3 (W), AD5272#2.4 (VSS), C29.2, R30.1
unnamed: U$15.23 (S1), U$22.67 (S2)
unnamed: U$9.67 (S2), U$24.23 (S1)
unnamed: AD5272#2.5 (CAP), C29.1
unnamed: C14.2, U$16.3 (BST2)
unnamed: R88.2, U$22.4 (G1)
unnamed: LED2.C, R32.2
unnamed: R62.2, R87.1, U$59.18 (RUN)
unnamed: LED3.C, R57.2
unnamed: R36.1, U$34.3 (D)
unnamed: R37.1, U$35.3 (D)
unnamed: R44.1, U$41.3 (D)
unnamed: LED8.C, R100.2
unnamed: R89.2, U$22.5 (G2)
unnamed: U$25.23 (S1), U$27.67 (S2)
unnamed: R93.2, U$27.5 (G2)
unnamed: R92.2, U$27.4 (G1)
unnamed: C17.1, R34.1, U$31.5 (VDD)
unnamed: R33.1, U$31.3 (CS)
unnamed: C19.1, R38.1, U$32.2 (VDD)
unnamed: U$32.6 (OUT), U$34.1 (G)
unnamed: R45.1, U$42.3 (D)
unnamed: U$33.6 (OUT), U$35.1 (G)
unnamed: R52.1, U$48.3 (D)
unnamed: R33.2, R40.1, U$15.67 (S2)
unnamed: U$8.23 (S1), U$28.67 (S2)
unnamed: R97.2, U$28.5 (G2)
unnamed: C18.1, R35.1, U$31.4 (VC)
unnamed: C20.1, R39.1, U$33.2 (VDD)
unnamed: R96.2, U$28.4 (G1)
unnamed: AB3.2, C19.2, R35.2, R37.2, R39.2, U$32.3 (VSS), U$34.2 (S)
unnamed: U$26.23 (S1), U$29.67 (S2)
unnamed: R95.2, U$29.5 (G2)
unnamed: C21.1, R42.1, U$38.5 (VDD)
unnamed: R41.1, U$38.3 (CS)
unnamed: C23.1, R46.1, U$39.2 (VDD)
unnamed: U$39.6 (OUT), U$41.1 (G)
unnamed: R53.1, U$49.3 (D)
unnamed: U$40.6 (OUT), U$42.1 (G)
unnamed: R41.2, R48.1, U$8.67 (S2)
unnamed: R94.2, U$29.4 (G1)
unnamed: U$1.23 (S1), U$30.67 (S2)
unnamed: C22.1, R43.1, U$38.4 (VC)
unnamed: C24.1, R47.1, U$40.2 (VDD)
unnamed: R99.2, U$30.5 (G2)
unnamed: AB2.2, C23.2, R43.2, R45.2, R47.2, U$39.3 (VSS), U$41.2 (S)
unnamed: R98.2, U$30.4 (G1)
unnamed: C25.1, R50.1, U$45.5 (VDD)
unnamed: R49.1, U$45.3 (CS)
unnamed: C27.1, R54.1, U$46.2 (VDD)
unnamed: U$46.6 (OUT), U$48.1 (G)
unnamed: U$47.6 (OUT), U$49.1 (G)
unnamed: R49.2, R56.1, U$1.67 (S2)
unnamed: C26.1, R51.1, U$45.4 (VC)
unnamed: C28.1, R55.1, U$47.2 (VDD)
unnamed: AB1.2, C27.2, R51.2, R53.2, R55.2, U$46.3 (VSS), U$48.2 (S)
unnamed: C34.2, U$59.3 (BST2)
unnamed: 3,3µH.2, C33.1, U$59.21 (SW1), U$59.24 (SW1)
unnamed: 3,3µH.1, C34.1, U$59.5 (SW2), U$59.8 (SW2)
unnamed: C44.1, IC2.6 (OSC_OUT), Q5.1, R78.1
unnamed: R69.1, U$59.13 (VC)
unnamed: C36.1, R69.2
unnamed: C38.1, R66.1
unnamed: R68.2, U$59.17 (RT)
unnamed: C33.2, U$59.26 (BST1)
unnamed: C45.1, IC2.5 (OSC_IN), Q5.2, R78.2
unnamed: C40.1, INA219#1.1 (IN+), R73.2
unnamed: C005R.P$2 (2), C47.1, IC2.4 (PC15)
unnamed: C41.1, R76.2, U$57.1 (IN+)
unnamed: C41.2, R77.2, U$57.2 (IN-)
unnamed: C005R.P$1 (1), C46.1, IC2.3 (PC14)
unnamed: PWR.C, R82.2
unnamed: IC2.41 (PB5), R81.1
NRST: IC2.7 (NRST), R79.2, U$23.NRST/EN
OC1: U$3.2 (OC), U$26.5 (G2)
OC2: U$1.5 (G2), U$45.2 (OC)
OC3: U$10.2 (OC), U$25.5 (G2)
OC4: U$8.5 (G2), U$38.2 (OC)
OC5: U$17.2 (OC), U$24.5 (G2)
OC6: U$15.5 (G2), U$31.2 (OC)
OD1: U$3.1 (OD), U$26.4 (G1)
OD2: U$1.4 (G1), U$45.1 (OD)
OD3: U$10.1 (OD), U$25.4 (G1)
OD4: U$8.4 (G1), U$38.1 (OD)
OD5: U$17.1 (OD), U$24.4 (G1)
OD6: U$15.4 (G1), U$31.1 (OD)
PGOOD1: IC2.18 (PB0), LED2.A, U$59.10 (PGOOD)
PGOOD2: IC2.19 (PB1), LED3.A, U$16.10 (PGOOD)
RX-C: IC2.31 (PA10), U$23.RX0
SCL: AD5272#2.9 (SCL), IC2.21 (PB10), INA219#1.5 (SCL), R101.2, U$57.5 (SCL)
SCLTM: BSK4.5, IC2.45 (PB8), R25.2
SDA: AD5272#2.8 (SDA), IC2.22 (PB11), INA219#1.6 (SDA), R102.2, U$57.6 (SDA)
SDATM: BSK4.4, IC2.46 (PB9), R26.2
SWC: IC2.37 (PA14), R27.2, U$23.SWC/TXD
SWD: IC2.34 (PA13), R64.2, U$23.SWD/RXD
TIME: BSK4.2, IC2.42 (PB6)
TX-C: IC2.30 (PA9), U$23.TX0
VDD: AB1.3, AB2.3, AB3.3, BSK4.6, C15.1, C16.1, C48.1, C53.1, C54.1, C55.1, IC2.1 (VBAT), IC2.9 (VDDA), IC2.24 (VDDA), IC2.36 (VDDA), IC2.48 (VDDA), INA219#1.4 (VS), PB5.A, PWR.A, R25.1, R26.1, R27.1, R64.1, R79.1, R101.1, R102.1, U$2.P$5 (VCC), U$23.3V3/BUS0 (3V3/BUS), U$23.3V3/BUS1 (3V3/BUS), U$57.4 (VS), U$57.7 (A0)
Y: U$2.P$4 (Y), U$16.18 (RUN)

Notes on the sheet:
Charge DC-DC
Discharge DC-DC

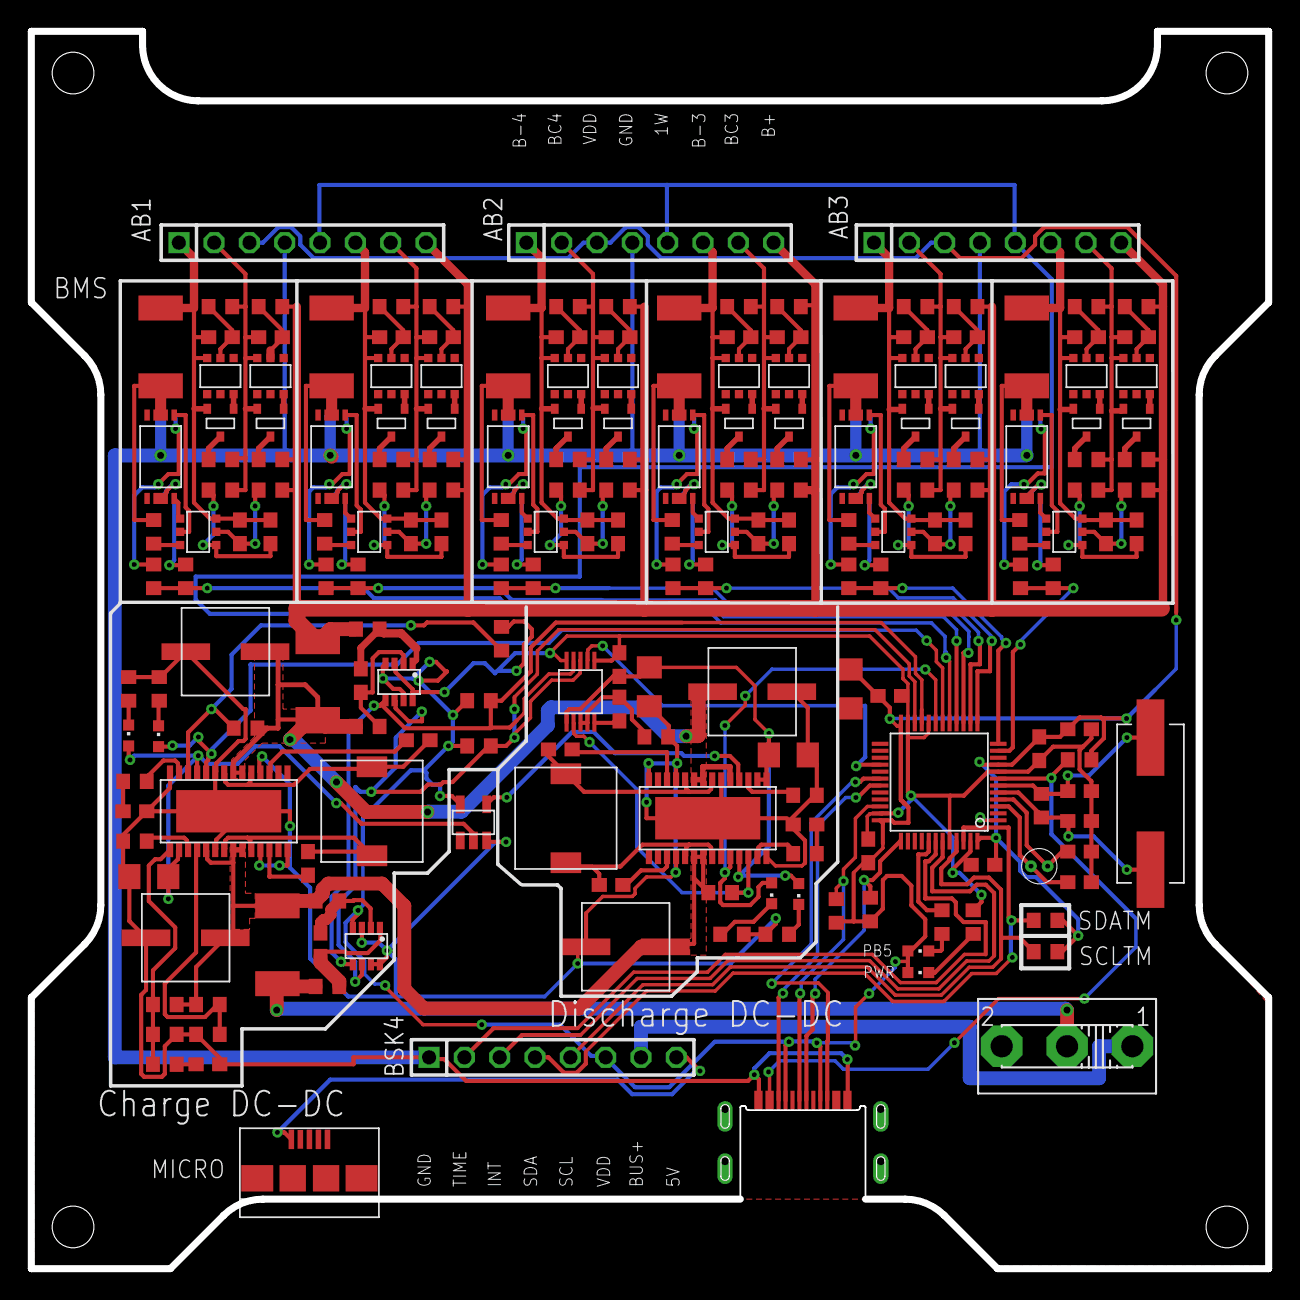
[picture p57: board ARKnew.brd from above]

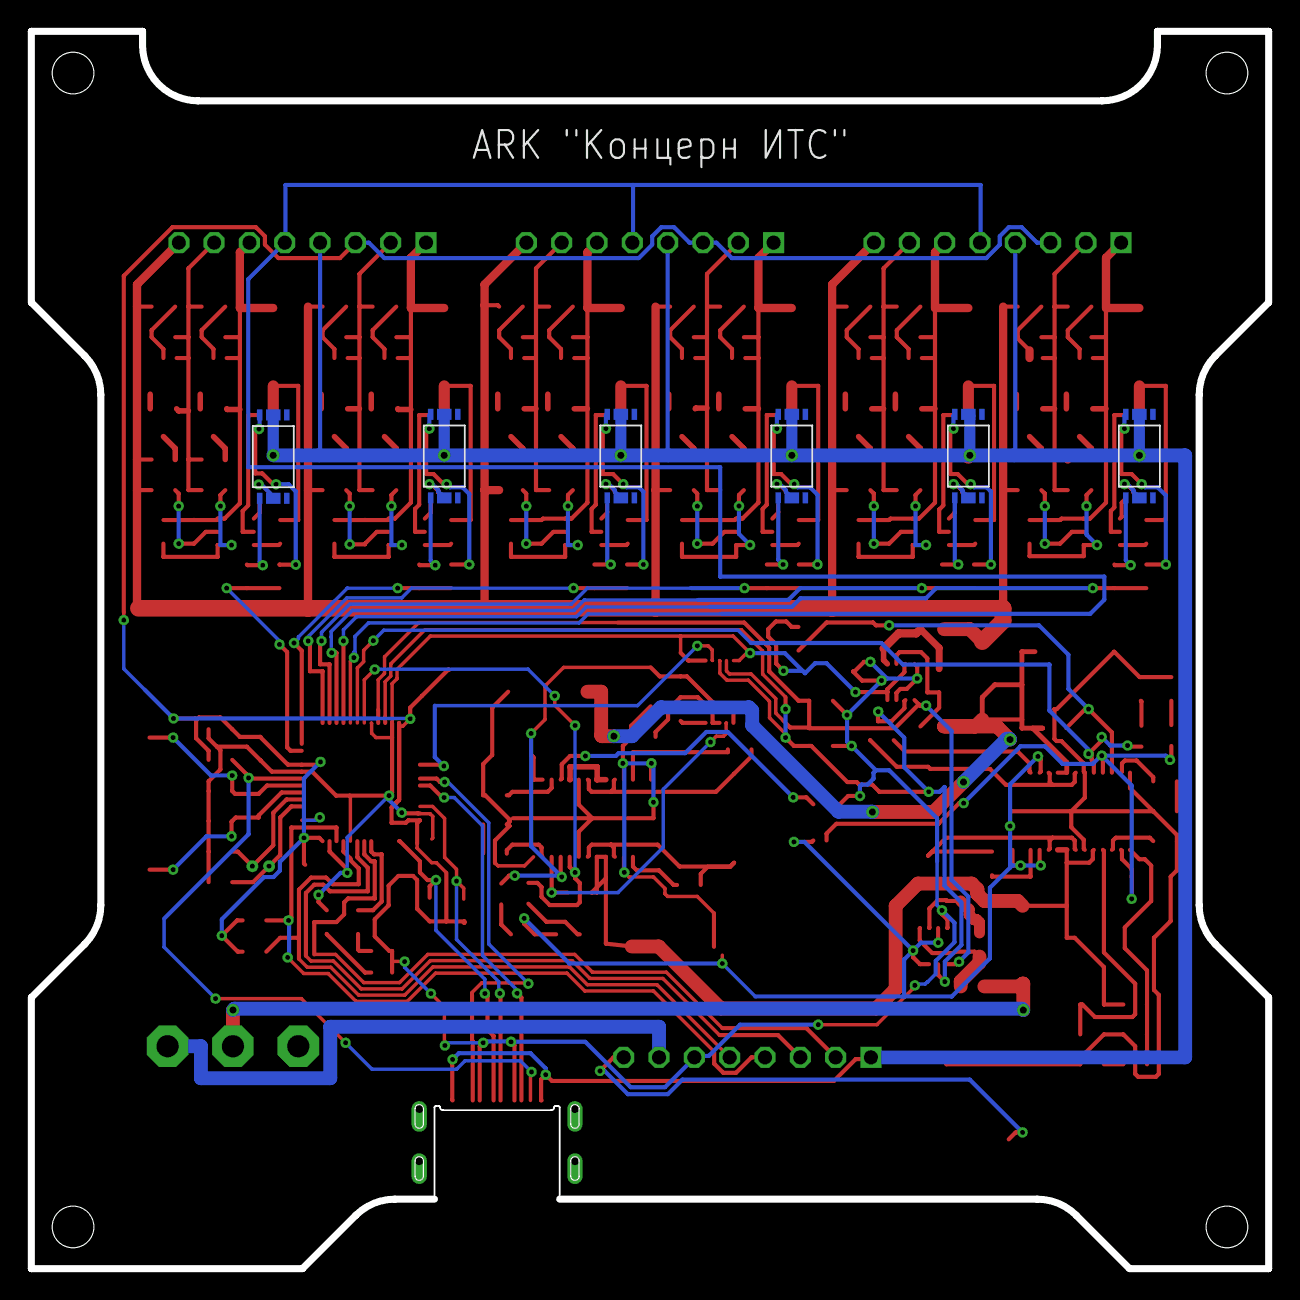
[picture p58: board ARKnew.brd from below]

Board: 2 copper layers, 89.0 x 89.0 mm, 211 parts (6 on the bottom side), 170 nets.
