CONZERN-ITS/can-cube-sat/schematics/board/BSK2.brd

## EAGLE design schematics/board/BSK2.brd (2020-07-13)

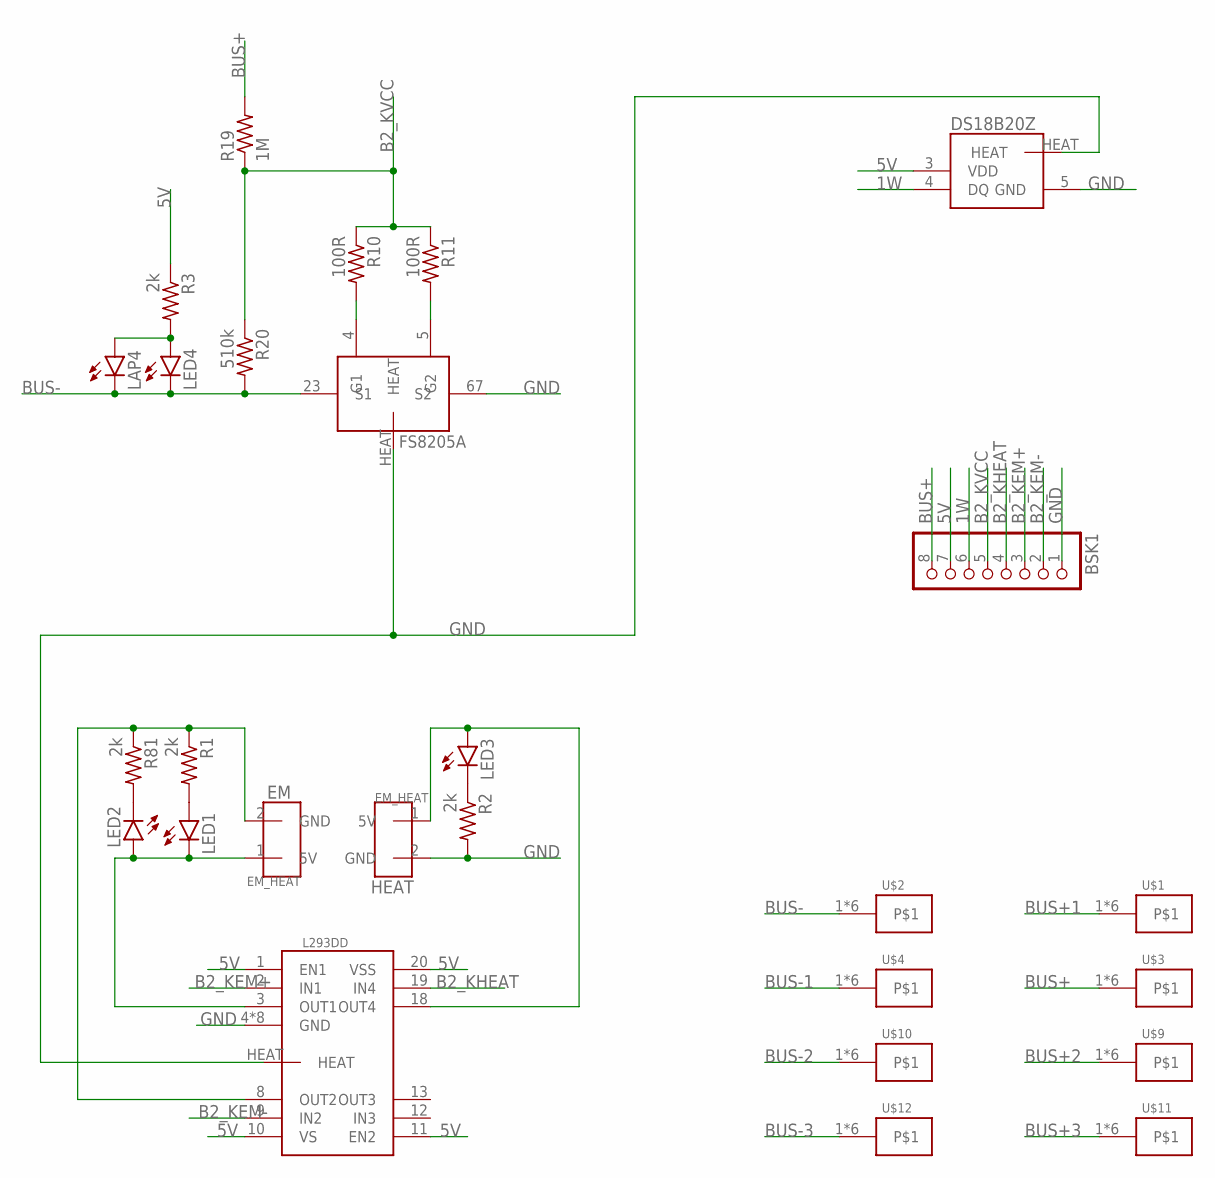
[picture p59: schematic BSK2.sch]

Parts:
BSK1: PINHD-1X8; 1X08
DS18B20Z: DS18B20Z
FS8205A: FS8205A+
L293DD: L293DD
LAP4: LAP4-BOTTOM; P47F-BOTTOM
LED1, LED2, LED3, LED4: LEDCHIPLED_0603; CHIPLED_0603
R1, R2, R3, R81: 2k; R0603
R10, R11: 100R; R0603
R19: 1M; R0603
R20: 510k; R0603
U$1, U$2, U$3, U$4, U$9, U$10, U$11, U$12: KCONNECT
U$6, U$7: EM_HEAT

Connections:
1W: BSK1.6, DS18B20Z.4 (DQ)
5V: BSK1.7, DS18B20Z.3 (VDD), L293DD.1 (EN1), L293DD.10 (VS), L293DD.11 (EN2), L293DD.20 (VSS), R3.1
B2_KEM+: BSK1.3, L293DD.2 (IN1)
B2_KEM-: BSK1.2, L293DD.9 (IN2)
B2_KHEAT: BSK1.4, L293DD.19 (IN4)
B2_KVCC: BSK1.5, R10.1, R11.1, R19.1, R20.1
BUS+: BSK1.8, R19.2, U$3.1, U$3.2, U$3.3, U$3.4, U$3.P$1, U$3.P$2
BUS+1: U$1.1, U$1.2, U$1.3, U$1.4, U$1.P$1, U$1.P$2
BUS+2: U$9.1, U$9.2, U$9.3, U$9.4, U$9.P$1, U$9.P$2
BUS+3: U$11.1, U$11.2, U$11.3, U$11.4, U$11.P$1, U$11.P$2
BUS-: FS8205A.23 (S1), LAP4.C, LED4.C, R20.2, U$2.1, U$2.2, U$2.3, U$2.4, U$2.P$1, U$2.P$2
BUS-1: U$4.1, U$4.2, U$4.3, U$4.4, U$4.P$1, U$4.P$2
BUS-2: U$10.1, U$10.2, U$10.3, U$10.4, U$10.P$1, U$10.P$2
BUS-3: U$12.1, U$12.2, U$12.3, U$12.4, U$12.P$1, U$12.P$2
GND: BSK1.1, DS18B20Z.5 (GND), DS18B20Z.HEAT, FS8205A.67 (S2), FS8205A.HEAT, L293DD.4 (GND), L293DD.5 (GND), L293DD.6 (GND), L293DD.7 (GND), L293DD.14 (GND), L293DD.15 (GND), L293DD.16 (GND), L293DD.17 (GND), L293DD.HEAT, R2.2, U$7.2 (GND)
unnamed: L293DD.3 (OUT1), LED1.C, LED2.A, U$6.1 (5V)
unnamed: L293DD.8 (OUT2), R1.1, R81.1, U$6.2 (GND)
unnamed: L293DD.18 (OUT4), LED3.A, U$7.1 (5V)
unnamed: FS8205A.4 (G1), R10.2
unnamed: FS8205A.5 (G2), R11.2
unnamed: LED2.C, R81.2
unnamed: LED1.A, R1.2
unnamed: LED3.C, R2.1
unnamed: LAP4.A, LED4.A, R3.2

Notes on the sheet:
HEAT

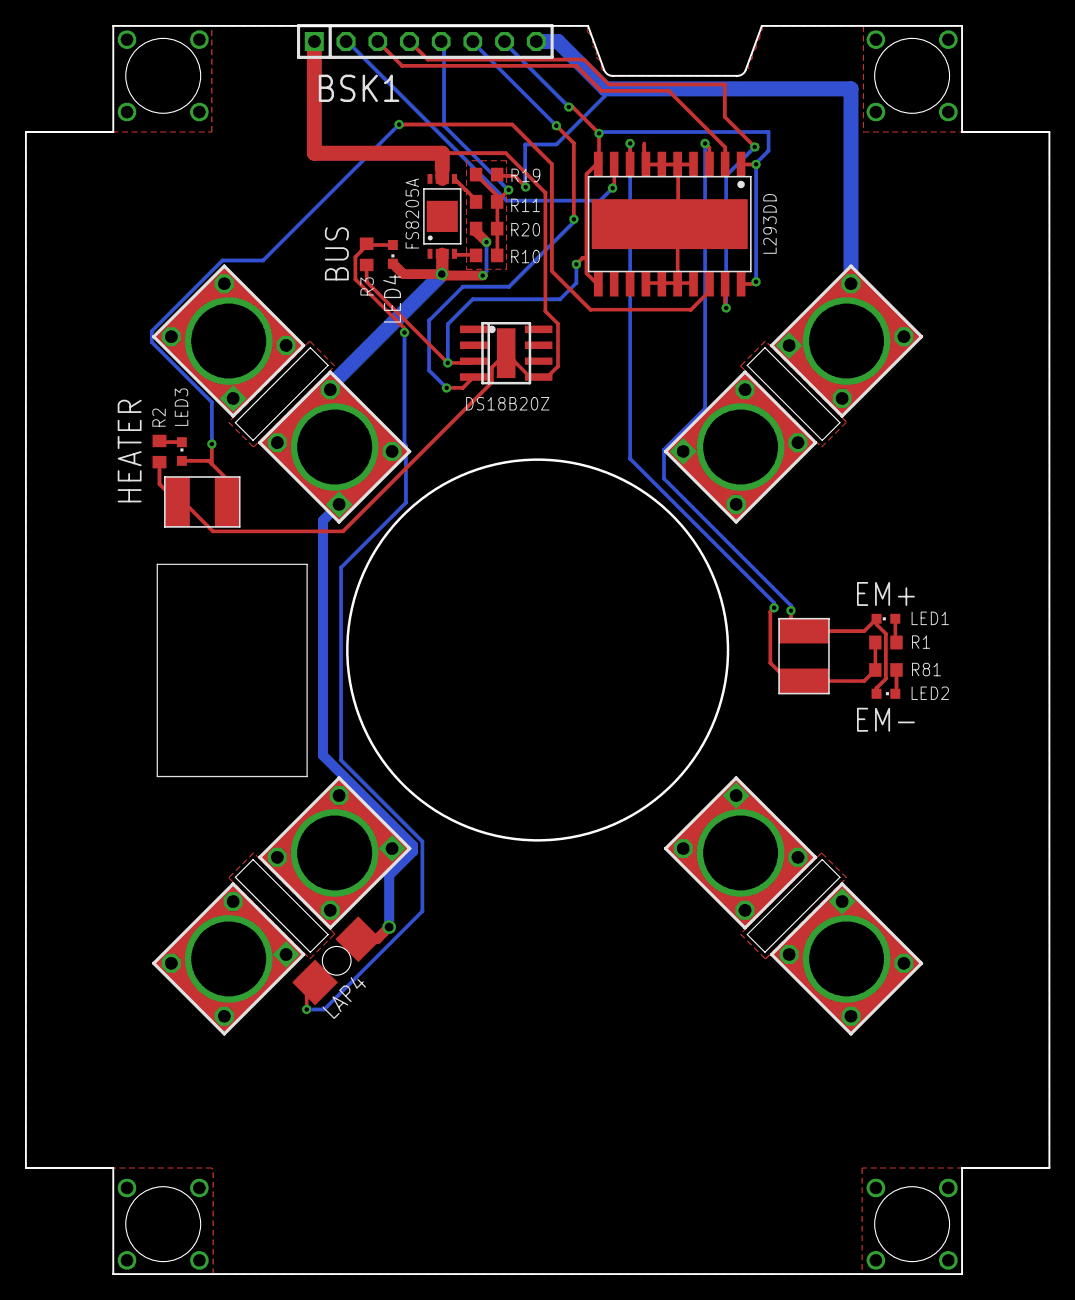
[picture p60: board BSK2.brd from above]

Board: 2 copper layers, 82.0 x 100.0 mm, 27 parts (0 on the bottom side), 24 nets.
