CONZERN-ITS/can-cube-sat/schematics/board/BSK.brd

## EAGLE design schematics/board/BSK.brd (2020-04-20)

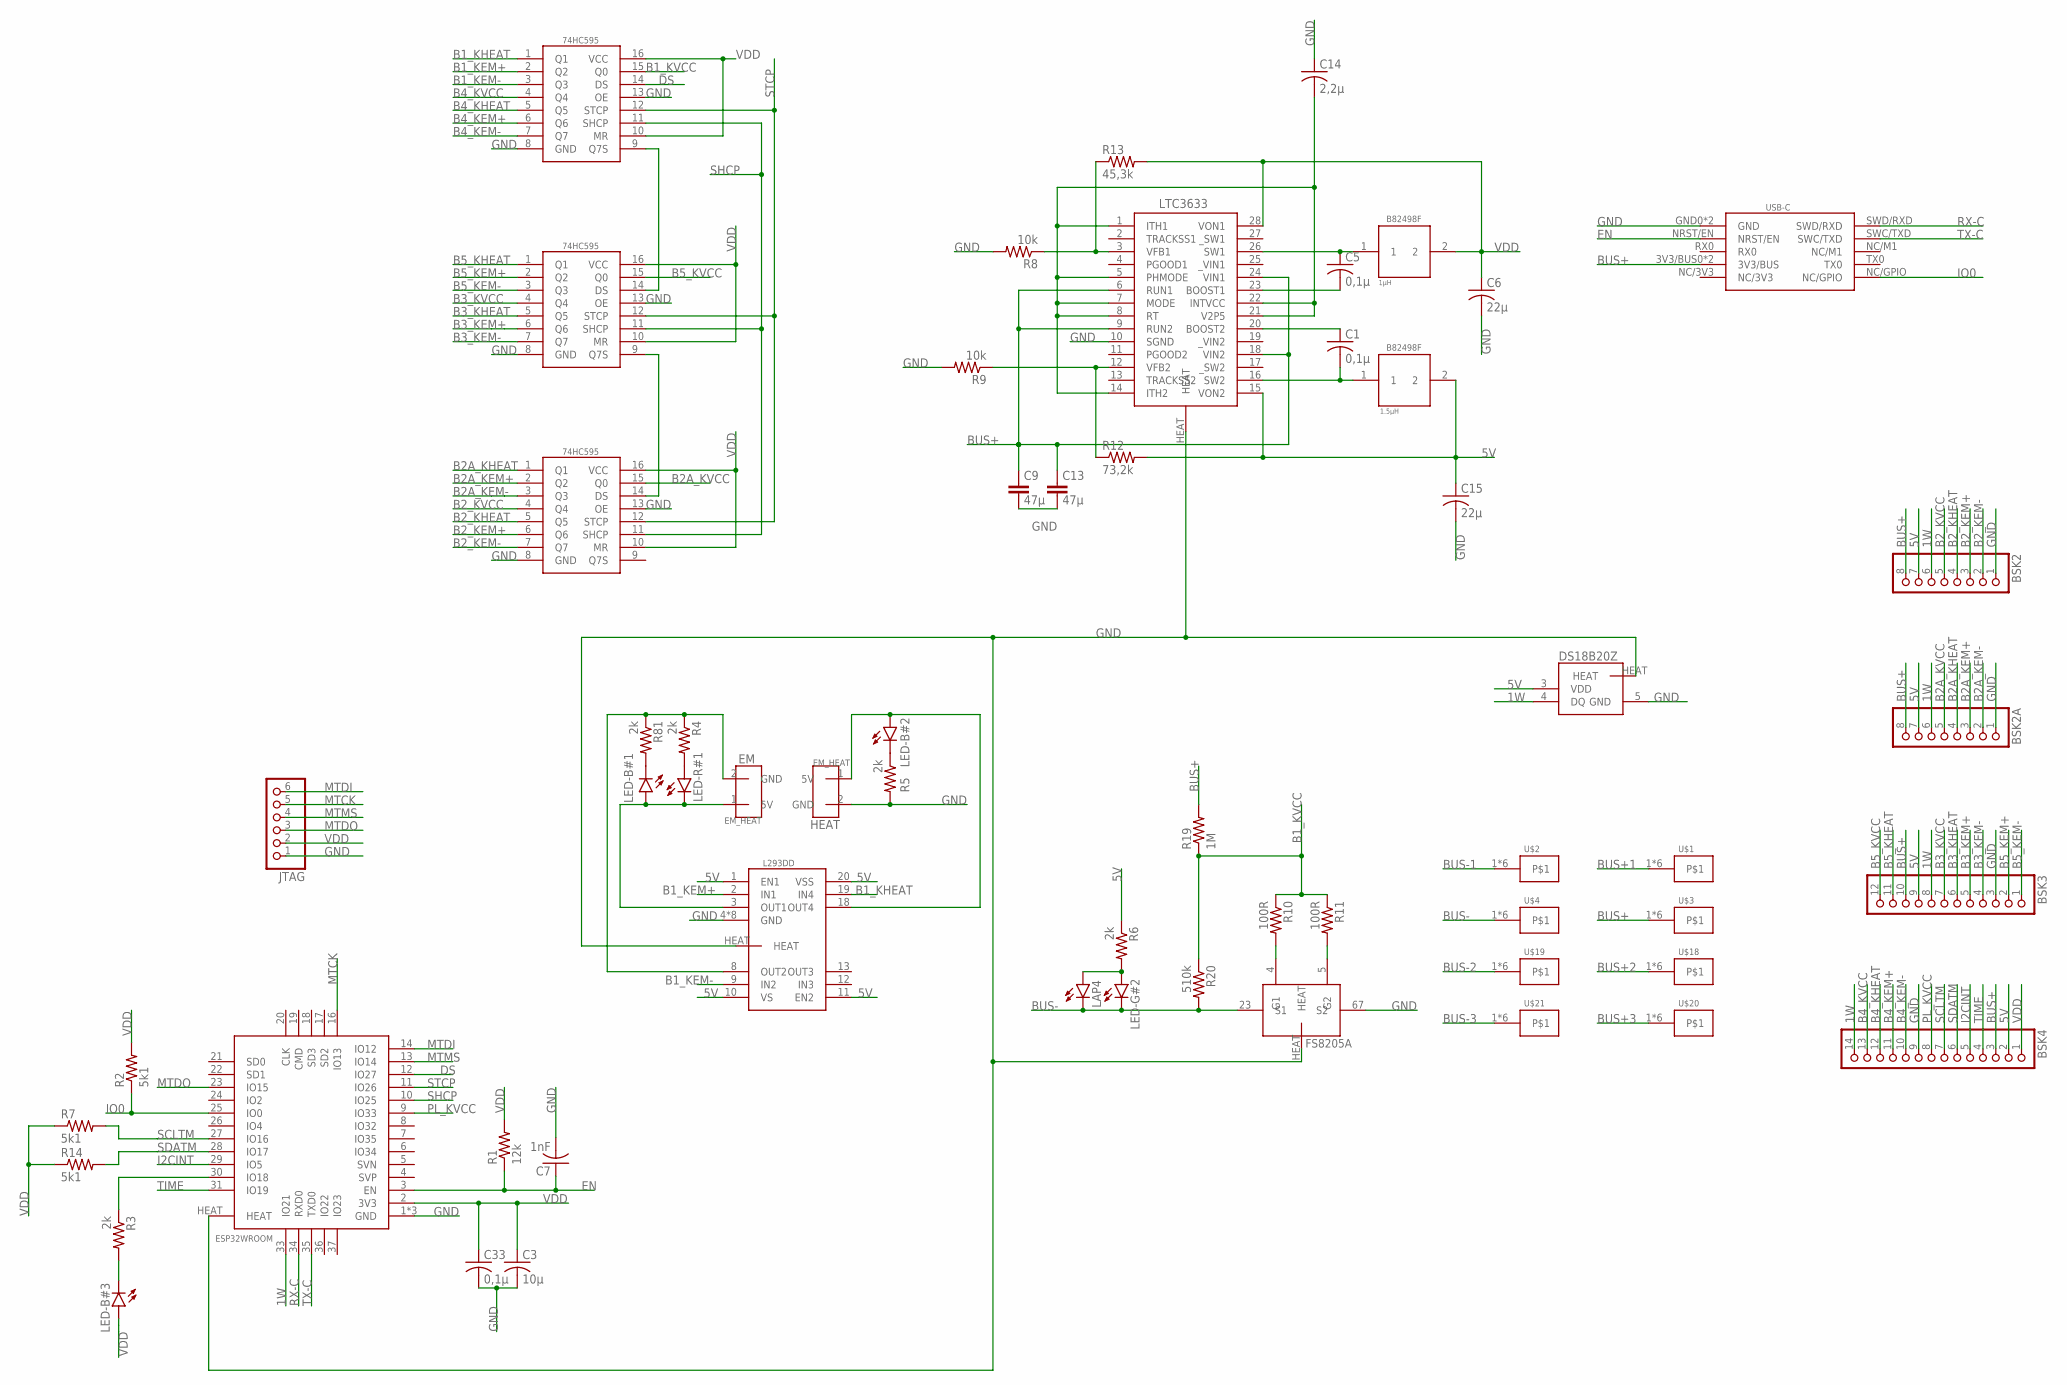
[picture p63: schematic BSK.sch]

Parts:
74HC595#1, 74HC595#2, 74HC595#3: 74HC595
B82498F#1: 1µH; B82498F
B82498F#2: B82498F
BSK2, BSK2A: PINHD-1X8; 1X08
BSK3: PINHD-1X12; 1X12
BSK4: PINHD-1X14; 1X14
C1, C5, C33: 0,1µ; C0603
C3: 10µ; C1206
C6, C15: 22µ; C1206
C7: 1nF; C0603
C9, C13: 47µ; C1210
C14: 2,2µ; C0603
DS18B20Z: DS18B20Z
EM: EM_HEAT
FS8205A: FS8205A+
HEATER: EM_HEAT
JTAG: PINHD-1X6; 1X06
L293DD: L293DD
LAP4: LAP4-BOTTOM; P47F-BOTTOM
LED-B#1, LED-B#2, LED-B#3: LEDCHIPLED_0603; CHIPLED_0603
LED-G#2: LEDCHIPLED_0603; CHIPLED_0603
LED-R#1: LEDCHIPLED_0603; CHIPLED_0603
LTC3633: LTC3633
R1: 12k; R0603
R2, R7, R14: 5k1; R0603
R3, R4, R5, R6, R81: 2k; R0603
R8, R9: 10k; R0603
R10, R11: 100R; R0603
R12: 73,2k; R0603
R13: 45,3k; R0603
R19: 1M; R0603
R20: 510k; R0603
U$1, U$2, U$3, U$4, U$18, U$19, U$20, U$21: KCONNECT
U$13: ESP32WROOM
USB-C: USB-C

Connections:
1W: BSK2.6, BSK2A.6, BSK3.8, BSK4.14, DS18B20Z.4 (DQ), U$13.33 (IO21)
5V: B82498F#2.2, BSK2.7, BSK2A.7, BSK3.9, BSK4.2, C15.1, DS18B20Z.3 (VDD), L293DD.1 (EN1), L293DD.10 (VS), L293DD.11 (EN2), L293DD.20 (VSS), LTC3633.15 (VON2), R6.1, R12.2
B1_KEM+: 74HC595#1.2 (Q2), L293DD.2 (IN1)
B1_KEM-: 74HC595#1.3 (Q3), L293DD.9 (IN2)
B1_KHEAT: 74HC595#1.1 (Q1), L293DD.19 (IN4)
B1_KVCC: 74HC595#1.15 (Q0), R10.1, R11.1, R19.1, R20.1
B2A_KEM+: 74HC595#3.2 (Q2), BSK2A.3
B2A_KEM-: 74HC595#3.3 (Q3), BSK2A.2
B2A_KHEAT: 74HC595#3.1 (Q1), BSK2A.4
B2A_KVCC: 74HC595#3.15 (Q0), BSK2A.5
B2_KEM+: 74HC595#3.6 (Q6), BSK2.3
B2_KEM-: 74HC595#3.7 (Q7), BSK2.2
B2_KHEAT: 74HC595#3.5 (Q5), BSK2.4
B2_KVCC: 74HC595#3.4 (Q4), BSK2.5
B3_KEM+: 74HC595#2.6 (Q6), BSK3.5
B3_KEM-: 74HC595#2.7 (Q7), BSK3.4
B3_KHEAT: 74HC595#2.5 (Q5), BSK3.6
B3_KVCC: 74HC595#2.4 (Q4), BSK3.7
B4_KEM+: 74HC595#1.6 (Q6), BSK4.11
B4_KEM-: 74HC595#1.7 (Q7), BSK4.10
B4_KHEAT: 74HC595#1.5 (Q5), BSK4.12
B4_KVCC: 74HC595#1.4 (Q4), BSK4.13
B5_KEM+: 74HC595#2.2 (Q2), BSK3.2
B5_KEM-: 74HC595#2.3 (Q3), BSK3.1
B5_KHEAT: 74HC595#2.1 (Q1), BSK3.11
B5_KVCC: 74HC595#2.15 (Q0), BSK3.12
BUS+: BSK2.8, BSK2A.8, BSK3.10, BSK4.3, C9.1, C13.1, LTC3633.6 (RUN1), LTC3633.9 (RUN2), LTC3633.18 (VIN2), LTC3633.24 (VIN1), R19.2, U$3.1, U$3.2, U$3.3, U$3.4, U$3.P$1, U$3.P$2, USB-C.3V3/BUS0 (3V3/BUS), USB-C.3V3/BUS1 (3V3/BUS)
BUS+1: U$1.1, U$1.2, U$1.3, U$1.4, U$1.P$1, U$1.P$2
BUS+2: U$18.1, U$18.2, U$18.3, U$18.4, U$18.P$1, U$18.P$2
BUS+3: U$20.1, U$20.2, U$20.3, U$20.4, U$20.P$1, U$20.P$2
BUS-: FS8205A.23 (S1), LAP4.C, LED-G#2.C, R20.2, U$4.1, U$4.2, U$4.3, U$4.4, U$4.P$1, U$4.P$2
BUS-1: U$2.1, U$2.2, U$2.3, U$2.4, U$2.P$1, U$2.P$2
BUS-2: U$19.1, U$19.2, U$19.3, U$19.4, U$19.P$1, U$19.P$2
BUS-3: U$21.1, U$21.2, U$21.3, U$21.4, U$21.P$1, U$21.P$2
DS: 74HC595#1.14 (DS), U$13.12 (IO27)
EN: C7.1, R1.1, U$13.3 (EN), USB-C.NRST/EN
GND: 74HC595#1.8 (GND), 74HC595#1.13 (OE), 74HC595#2.8 (GND), 74HC595#2.13 (OE), 74HC595#3.8 (GND), 74HC595#3.13 (OE), BSK2.1, BSK2A.1, BSK3.3, BSK4.9, C3.2, C6.2, C7.2, C9.2, C13.2, C14.1, C15.2, C33.2, DS18B20Z.5 (GND), DS18B20Z.HEAT, FS8205A.67 (S2), FS8205A.HEAT, HEATER.2 (GND), JTAG.1, L293DD.4 (GND), L293DD.5 (GND), L293DD.6 (GND), L293DD.7 (GND), L293DD.14 (GND), L293DD.15 (GND), L293DD.16 (GND), L293DD.17 (GND), L293DD.HEAT, LTC3633.10 (SGND), LTC3633.HEAT, R5.2, R8.2, R9.2, U$13.1 (GND), U$13.15 (GND), U$13.38 (GND), U$13.HEAT, USB-C.GND0 (GND), USB-C.GND1 (GND)
I2CINT: BSK4.5, U$13.29 (IO5)
IO0: R2.1, U$13.25 (IO0), USB-C.NC/GPIO
IO1: R3.1, U$13.30 (IO18)
MTCK: JTAG.5, U$13.16 (IO13)
MTDI: JTAG.6, U$13.14 (IO12)
MTDO: JTAG.3, U$13.23 (IO15)
MTMS: JTAG.4, U$13.13 (IO14)
unnamed: EM.1 (5V), L293DD.3 (OUT1), LED-B#1.A, LED-R#1.C
unnamed: EM.2 (GND), L293DD.8 (OUT2), R4.1, R81.1
unnamed: HEATER.1 (5V), L293DD.18 (OUT4), LED-B#2.A
unnamed: FS8205A.4 (G1), R10.2
unnamed: FS8205A.5 (G2), R11.2
unnamed: 74HC595#1.9 (Q7S), 74HC595#2.14 (DS)
unnamed: 74HC595#2.9 (Q7S), 74HC595#3.14 (DS)
unnamed: C14.2, LTC3633.1 (ITH1), LTC3633.5 (PHMODE), LTC3633.7 (MODE), LTC3633.8 (RT), LTC3633.14 (ITH2), LTC3633.21 (V2P5), LTC3633.22 (INTVCC)
unnamed: LTC3633.3 (VFB1), R8.1, R13.1
unnamed: B82498F#1.1, C5.1, LTC3633.26 (SW1)
unnamed: C5.2, LTC3633.23 (BOOST1)
unnamed: C1.1, LTC3633.20 (BOOST2)
unnamed: B82498F#2.1, C1.2, LTC3633.16 (SW2)
unnamed: LED-B#3.C, R3.2
unnamed: LED-B#1.C, R81.2
unnamed: LED-R#1.A, R4.2
unnamed: LED-B#2.C, R5.1
unnamed: LAP4.A, LED-G#2.A, R6.2
unnamed: LTC3633.12 (VFB2), R9.1, R12.1
PL_KVCC: BSK4.8, U$13.9 (IO33)
RX-C: U$13.34 (RXD0), USB-C.SWD/RXD
SCLTM: BSK4.7, R7.2, U$13.27 (IO16)
SDATM: BSK4.6, R14.2, U$13.28 (IO17)
SHCP: 74HC595#1.11 (SHCP), 74HC595#2.11 (SHCP), 74HC595#3.11 (SHCP), U$13.10 (IO25)
STCP: 74HC595#1.12 (STCP), 74HC595#2.12 (STCP), 74HC595#3.12 (STCP), U$13.11 (IO26)
TIME: BSK4.4, U$13.31 (IO19)
TX-C: U$13.35 (TXD0), USB-C.SWC/TXD
VDD: 74HC595#1.10 (MR), 74HC595#1.16 (VCC), 74HC595#2.10 (MR), 74HC595#2.16 (VCC), 74HC595#3.10 (MR), 74HC595#3.16 (VCC), B82498F#1.2, BSK4.1, C3.1, C6.1, C33.1, JTAG.2, LED-B#3.A, LTC3633.28 (VON1), R1.2, R2.2, R7.1, R13.2, R14.1, U$13.2 (3V3)

Notes on the sheet:
HEAT
1µH
1.5µH

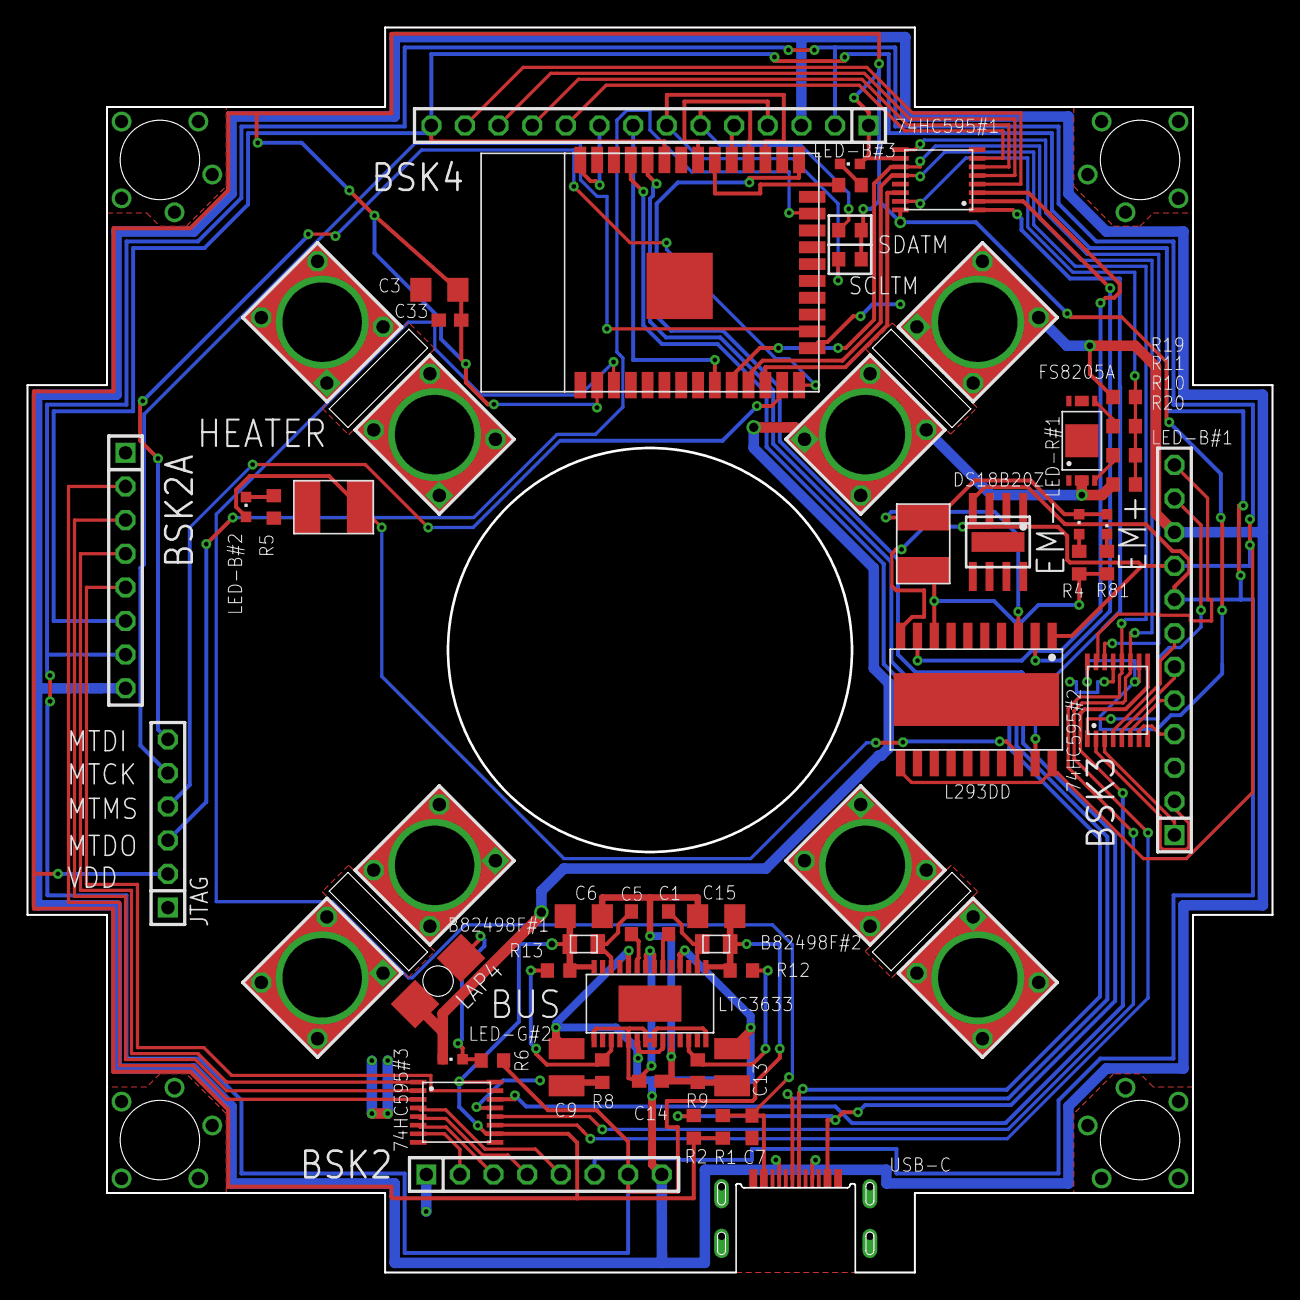
[picture p64: board BSK.brd from above]

Board: 2 copper layers, 94.0 x 94.0 mm, 59 parts (0 on the bottom side), 72 nets.
