CONZERN-ITS/can-cube-sat/schematics/board/BKU.brd

## EAGLE design schematics/board/BKU.brd (2020-04-20)

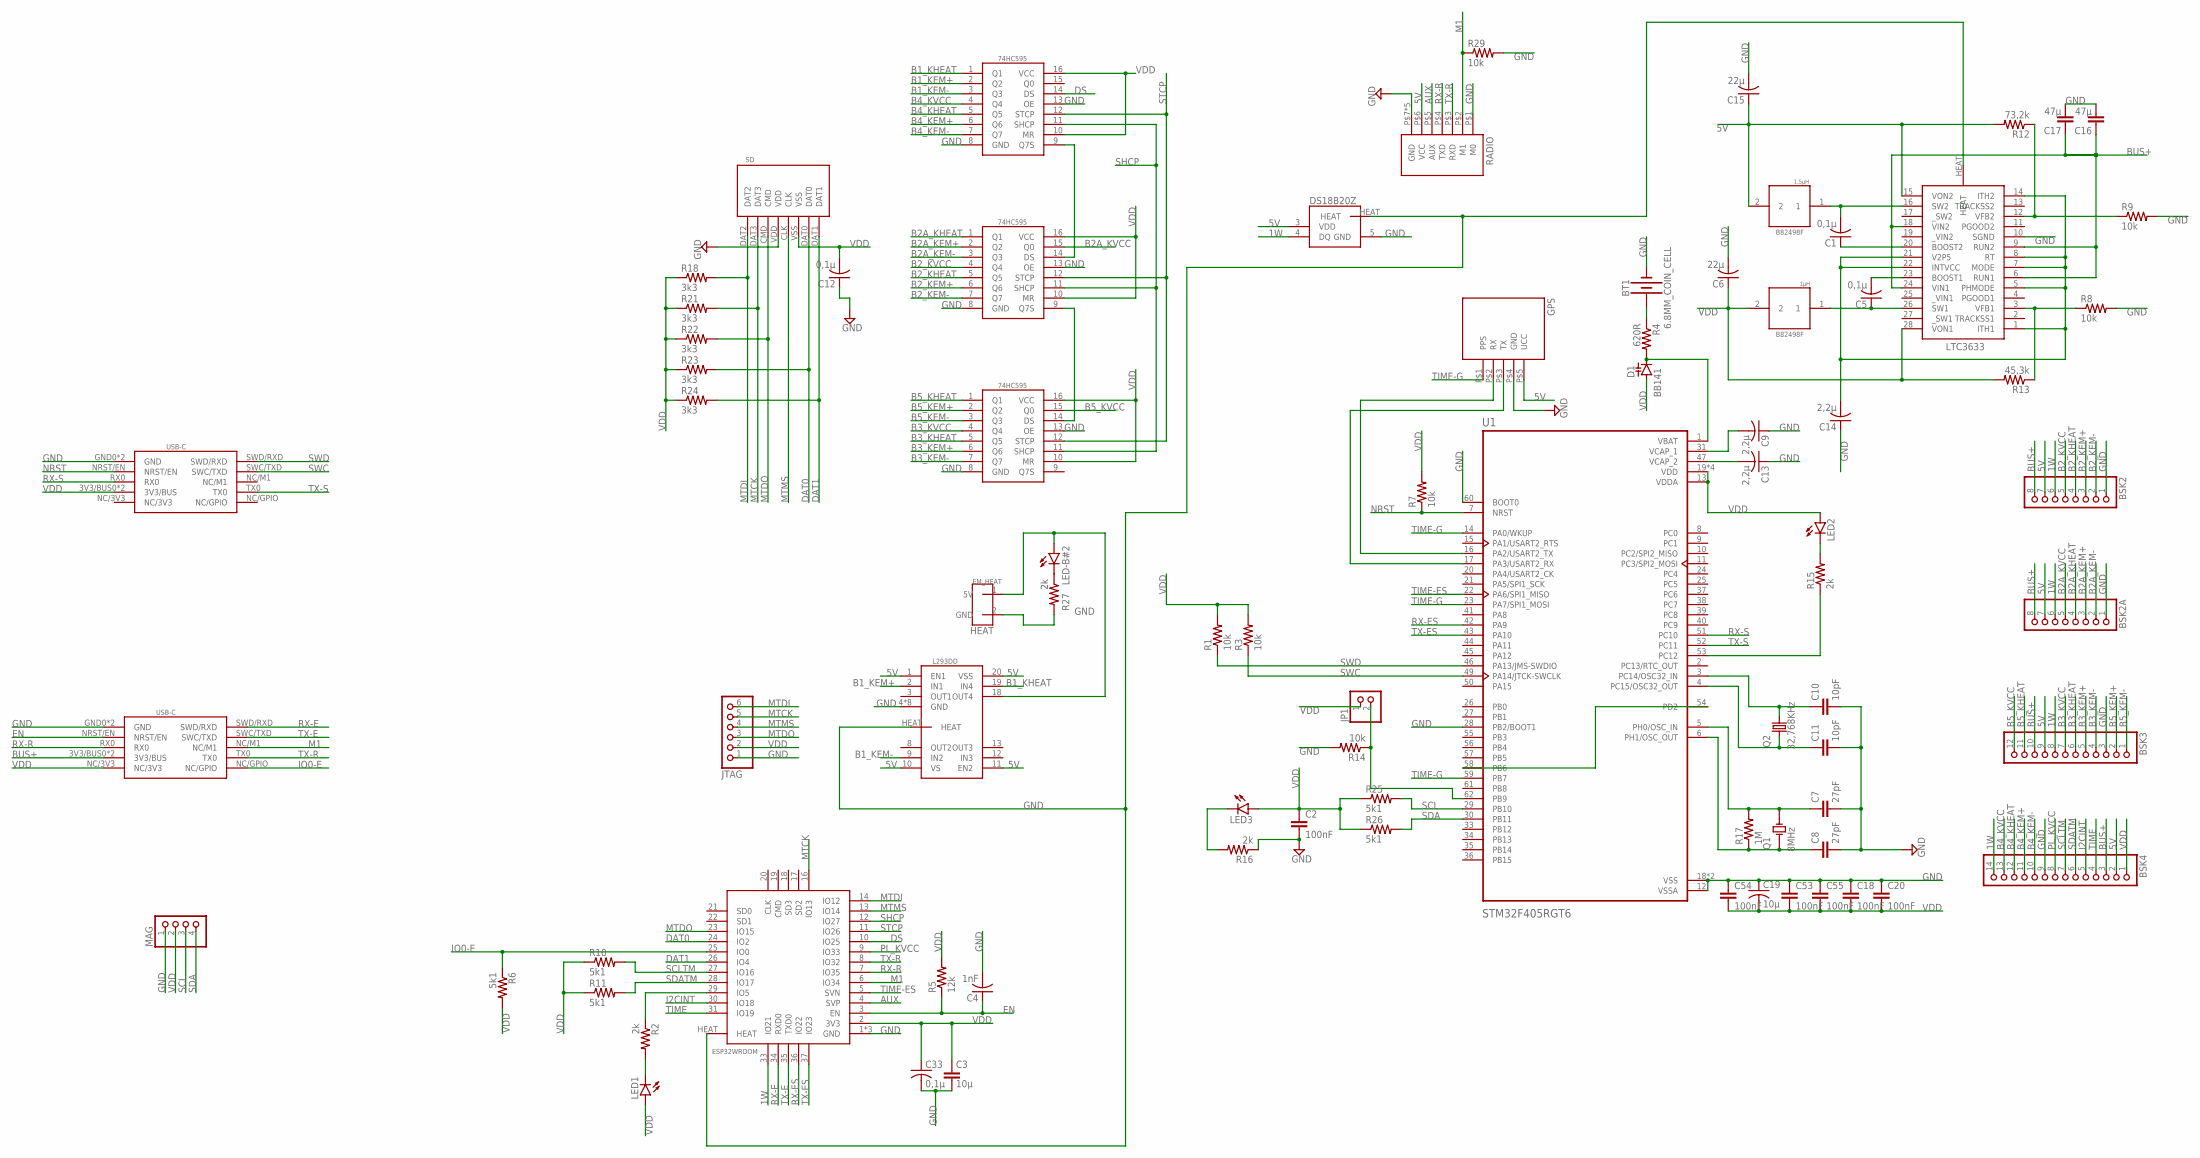
[picture p65: schematic BKU.sch]

Parts:
BSK2, BSK2A: PINHD-1X8; 1X08
BSK3: PINHD-1X12; 1X12
BSK4: PINHD-1X14; 1X14
BT1: 6.8MM_COIN_CELL; BATTCON-6.8MM
C1, C5, C12, C33: 0,1µ; C0603
C2, C18, C20, C53, C54, C55: 100nF; C0603
C3, C19: 10µ; C1206
C4: 1nF; C0603
C6, C15: 22µ; C1206
C7, C8: 27pF; C0603
C9, C13, C14: 2,2µ; C0603
C10, C11: 10pF; C0603
C16, C17: 47µ; C1210
D1: BB141; SOD523
GPS: GPSNEO6M; GPS-NEO6M
JP1: PINHD-1X2; 1X02
JTAG: PINHD-1X6; 1X06
LED1, LED2, LED3: LEDCHIPLED_0603; CHIPLED_0603
LED-B#2: LEDCHIPLED_0603; CHIPLED_0603
MAG: PINHD-1X4; 1X04
Q1: 8MHz; XTAL_9C-8.000MEEJ-T
Q2: 32,768KHz; C005R
R1, R3, R7, R8, R9, R14, R29: 10k; R0603
R2, R15, R16, R27: 2k; R0603
R4: 620R; R0603
R5: 12k; R0603
R6, R10, R11, R25, R26: 5k1; R0603
R12: 73,2k; R0603
R13: 45,3k; R0603
R17: 1M; R0603
R18, R21, R22, R23, R24: 3k3; R0603
RADIO: RADIO
SD: SD
U1: STM32F405RGT6; QFP50P1200X1200X160-64N
U$4, U$6: USB-C
U$5: DS18B20Z
U$7: EM_HEAT
U$8: L293DD
U$10: LTC3633
U$11: 1µH; B82498F
U$12: B82498F
U$13: ESP32WROOM
U$18, U$19, U$20: 74HC595

Connections:
1W: BSK2.6, BSK2A.6, BSK3.8, BSK4.14, U$5.4 (DQ), U$13.33 (IO21)
5V: BSK2.7, BSK2A.7, BSK3.9, BSK4.2, C15.1, GPS.P$5 (UCC), R12.2, RADIO.P$6 (VCC), U$5.3 (VDD), U$8.1 (EN1), U$8.10 (VS), U$8.11 (EN2), U$8.20 (VSS), U$10.15 (VON2), U$12.2
AUX: RADIO.P$5 (AUX), U$13.4 (SVP)
B1_KEM+: U$8.2 (IN1), U$18.2 (Q2)
B1_KEM-: U$8.9 (IN2), U$18.3 (Q3)
B1_KHEAT: U$8.19 (IN4), U$18.1 (Q1)
B2A_KEM+: BSK2A.3, U$19.2 (Q2)
B2A_KEM-: BSK2A.2, U$19.3 (Q3)
B2A_KHEAT: BSK2A.4, U$19.1 (Q1)
B2A_KVCC: BSK2A.5, U$19.15 (Q0)
B2_KEM+: BSK2.3, U$19.6 (Q6)
B2_KEM-: BSK2.2, U$19.7 (Q7)
B2_KHEAT: BSK2.4, U$19.5 (Q5)
B2_KVCC: BSK2.5, U$19.4 (Q4)
B3_KEM+: BSK3.5, U$20.6 (Q6)
B3_KEM-: BSK3.4, U$20.7 (Q7)
B3_KHEAT: BSK3.6, U$20.5 (Q5)
B3_KVCC: BSK3.7, U$20.4 (Q4)
B4_KEM+: BSK4.11, U$18.6 (Q6)
B4_KEM-: BSK4.10, U$18.7 (Q7)
B4_KHEAT: BSK4.12, U$18.5 (Q5)
B4_KVCC: BSK4.13, U$18.4 (Q4)
B5_KEM+: BSK3.2, U$20.2 (Q2)
B5_KEM-: BSK3.1, U$20.3 (Q3)
B5_KHEAT: BSK3.11, U$20.1 (Q1)
B5_KVCC: BSK3.12, U$20.15 (Q0)
BUS+: BSK2.8, BSK2A.8, BSK3.10, BSK4.3, C16.1, C17.1, U$6.3V3/BUS0 (3V3/BUS), U$6.3V3/BUS1 (3V3/BUS), U$10.6 (RUN1), U$10.9 (RUN2), U$10.18 (VIN2), U$10.24 (VIN1)
DAT0: R23.2, SD.DAT0, U$13.24 (IO2)
DAT1: R24.2, SD.DAT1, U$13.26 (IO4)
DS: U$13.10 (IO25), U$18.14 (DS)
EN: C4.1, R5.1, U$6.NRST/EN, U$13.3 (EN)
GND: BSK2.1, BSK2A.1, BSK3.3, BSK4.9, BT1.-, C2.2, C3.2, C4.2, C6.2, C7.2, C8.2, C9.1, C10.2, C11.2, C12.1, C13.1, C14.1, C15.2, C16.2, C17.2, C18.1, C19.1, C20.1, C33.2, C53.1, C54.1, C55.1, GPS.P$4 (GND), JTAG.1, MAG.1, R8.2, R9.2, R14.2, R16.1, R27.2, R29.2, RADIO.P$1 (M0), RADIO.P$7 (GND), RADIO.P$9 (GND), RADIO.P$15 (GND), RADIO.P$16 (GND), RADIO.P$17 (GND), SD.VDD, U1.12 (VSSA), U1.18 (VSS), U1.28 (PB2/BOOT1), U1.60 (BOOT0), U1.63 (VSS), U$4.GND0 (GND), U$4.GND1 (GND), U$5.5 (GND), U$5.HEAT, U$6.GND0 (GND), U$6.GND1 (GND), U$7.2 (GND), U$8.4 (GND), U$8.5 (GND), U$8.6 (GND), U$8.7 (GND), U$8.14 (GND), U$8.15 (GND), U$8.16 (GND), U$8.17 (GND), U$8.HEAT, U$10.10 (SGND), U$10.HEAT, U$13.1 (GND), U$13.15 (GND), U$13.38 (GND), U$13.HEAT, U$18.8 (GND), U$18.13 (OE), U$19.8 (GND), U$19.13 (OE), U$20.8 (GND), U$20.13 (OE)
I2CINT: BSK4.5, U$13.30 (IO18)
IO0-E: R6.1, U$6.NC/GPIO, U$13.25 (IO0)
IO1: R2.1, U$13.29 (IO5)
M1: R29.1, RADIO.P$2 (M1), U$6.NC/M1, U$13.6 (IO34)
MTCK: JTAG.5, R21.2, SD.DAT3, U$13.16 (IO13)
MTDI: JTAG.6, R18.2, SD.DAT2, U$13.14 (IO12)
MTDO: JTAG.3, R22.2, SD.CMD, U$13.23 (IO15)
MTMS: JTAG.4, SD.CLK, U$13.13 (IO14)
unnamed: BT1.+, R4.1
unnamed: D1.C, R4.2, U1.1 (VBAT)
unnamed: LED-B#2.A, U$7.1 (5V), U$8.18 (OUT4)
unnamed: LED1.C, R2.2
unnamed: JP1.2, R14.1, U1.62 (PB9)
unnamed: U1.54 (PD2), U1.58 (PB6)
unnamed: C9.2, U1.31 (VCAP_1)
unnamed: C13.2, U1.47 (VCAP_2)
unnamed: C8.1, Q1.1, R17.1, U1.6 (PH1/OSC_OUT)
unnamed: U$18.9 (Q7S), U$19.14 (DS)
unnamed: U$19.9 (Q7S), U$20.14 (DS)
unnamed: C14.2, U$10.1 (ITH1), U$10.5 (PHMODE), U$10.7 (MODE), U$10.8 (RT), U$10.14 (ITH2), U$10.21 (V2P5), U$10.22 (INTVCC)
unnamed: R8.1, R13.1, U$10.3 (VFB1)
unnamed: C5.1, U$10.26 (SW1), U$11.1
unnamed: C7.1, Q1.2, R17.2, U1.5 (PH0/OSC_IN)
unnamed: C5.2, U$10.23 (BOOST1)
unnamed: C1.1, U$10.20 (BOOST2)
unnamed: C1.2, U$10.16 (SW2), U$12.1
unnamed: C10.1, Q2.P$2 (2), U1.3 (PC14/OSC32_IN)
unnamed: C11.1, Q2.P$1 (1), U1.4 (PC15/OSC32_OUT)
unnamed: LED2.C, R15.2
unnamed: R15.1, U1.53 (PC12)
unnamed: R9.1, R12.1, U$10.12 (VFB2)
unnamed: LED3.C, R16.2
unnamed: GPS.P$2 (RX), U1.16 (PA2/USART2_TX)
unnamed: GPS.P$3 (TX), U1.17 (PA3/USART2_RX)
unnamed: LED-B#2.C, R27.1
NRST: R7.1, U1.7 (NRST), U$4.NRST/EN
PL_KVCC: BSK4.8, U$13.9 (IO33)
RX-E: U$6.SWD/RXD, U$13.34 (RXD0)
RX-ES: U1.42 (PA9), U$13.36 (IO22)
RX-R: RADIO.P$4 (TXD), U$6.RX0, U$13.7 (IO35)
RX-S: U1.51 (PC10), U$4.RX0
SCL: MAG.3, R25.2, U1.29 (PB10)
SCLTM: BSK4.7, R10.2, U$13.27 (IO16)
SDA: MAG.4, R26.2, U1.30 (PB11)
SDATM: BSK4.6, R11.2, U$13.28 (IO17)
SHCP: U$13.12 (IO27), U$18.11 (SHCP), U$19.11 (SHCP), U$20.11 (SHCP)
STCP: U$13.11 (IO26), U$18.12 (STCP), U$19.12 (STCP), U$20.12 (STCP)
SWC: R3.1, U1.49 (PA14/JTCK-SWCLK), U$4.SWC/TXD
SWD: R1.1, U1.46 (PA13/JMS-SWDIO), U$4.SWD/RXD
TIME: BSK4.4, U$13.31 (IO19)
TIME-ES: U1.22 (PA6/SPI1_MISO), U$13.5 (SVN)
TIME-G: GPS.P$1 (PPS), U1.14 (PA0/WKUP), U1.23 (PA7/SPI1_MOSI), U1.59 (PB7)
TX-E: U$6.SWC/TXD, U$13.35 (TXD0)
TX-ES: U1.43 (PA10), U$13.37 (IO23)
TX-R: RADIO.P$3 (RXD), U$6.TX0, U$13.8 (IO32)
TX-S: U1.52 (PC11), U$4.TX0
VDD: BSK4.1, C2.1, C3.1, C6.1, C12.2, C18.2, C19.2, C20.2, C33.1, C53.2, C54.2, C55.2, D1.A, JP1.1, JTAG.2, LED1.A, LED2.A, LED3.A, MAG.2, R1.2, R3.2, R5.2, R6.2, R7.2, R10.1, R11.1, R13.2, R18.1, R21.1, R22.1, R23.1, R24.1, R25.1, R26.1, SD.VSS, U1.13 (VDDA), U1.19 (VDD), U1.32 (VDD), U1.48 (VDD), U1.64 (VDD), U$4.3V3/BUS0 (3V3/BUS), U$4.3V3/BUS1 (3V3/BUS), U$6.NC/3V3, U$10.28 (VON1), U$11.2, U$13.2 (3V3), U$18.10 (MR), U$18.16 (VCC), U$19.10 (MR), U$19.16 (VCC), U$20.10 (MR), U$20.16 (VCC)

Notes on the sheet:
HEAT
1µH
1.5µH

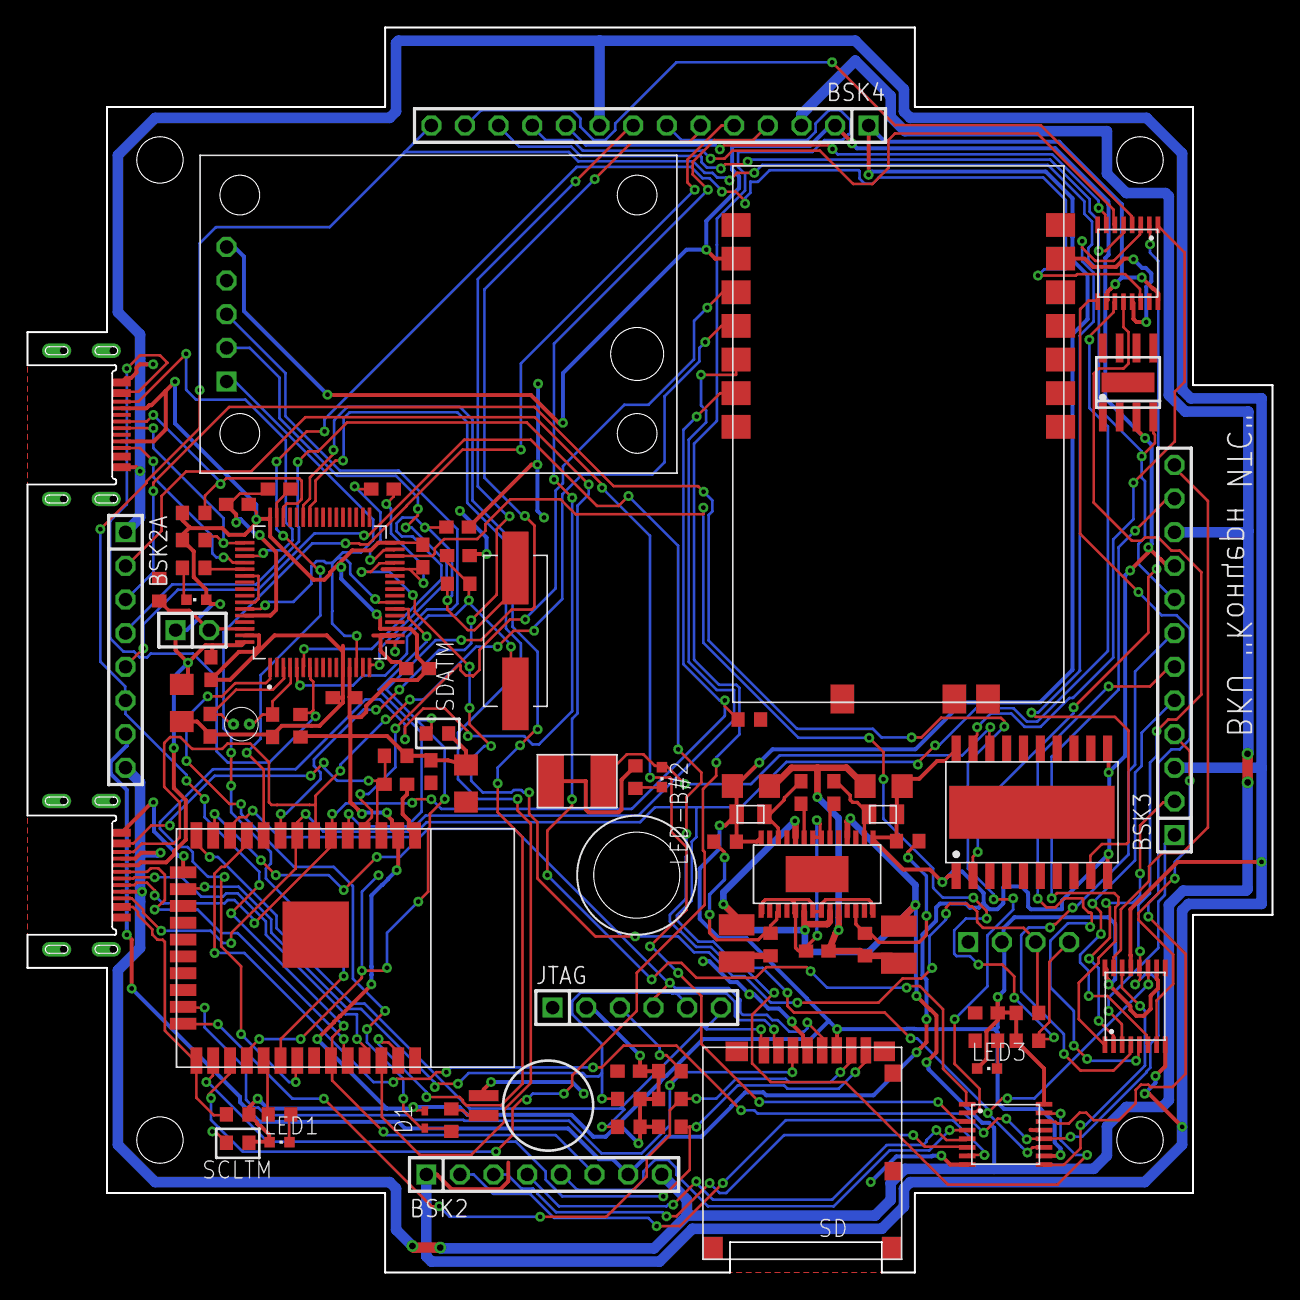
[picture p66: board BKU.brd from above]

Board: 2 copper layers, 94.0 x 94.0 mm, 81 parts (1 on the bottom side), 89 nets.
