CONZERN-ITS/can-cube-sat/schematics/board/CROSS.brd

## EAGLE design schematics/board/CROSS.brd (2020-04-20)

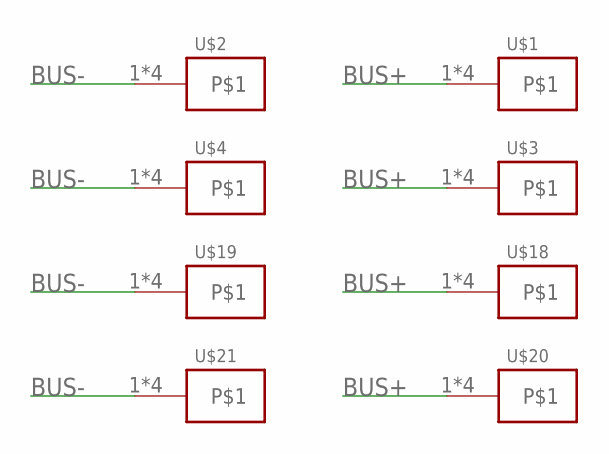
[picture p67: schematic CROSS.sch]

Parts:
U$1, U$2, U$3, U$4, U$18, U$19, U$20, U$21: KCONNECT-

Connections:
BUS+: U$1.1, U$1.2, U$1.3, U$1.4, U$3.1, U$3.2, U$3.3, U$3.4, U$18.1, U$18.2, U$18.3, U$18.4, U$20.1, U$20.2, U$20.3, U$20.4
BUS-: U$2.1, U$2.2, U$2.3, U$2.4, U$4.1, U$4.2, U$4.3, U$4.4, U$19.1, U$19.2, U$19.3, U$19.4, U$21.1, U$21.2, U$21.3, U$21.4

Board: 2 copper layers, 8 parts (0 on the bottom side), 2 nets, no tracks yet.
