CONZERN-ITS/can-cube-sat/schematics/board/BSK4.brd

## EAGLE design schematics/board/BSK4.brd (2020-04-20)

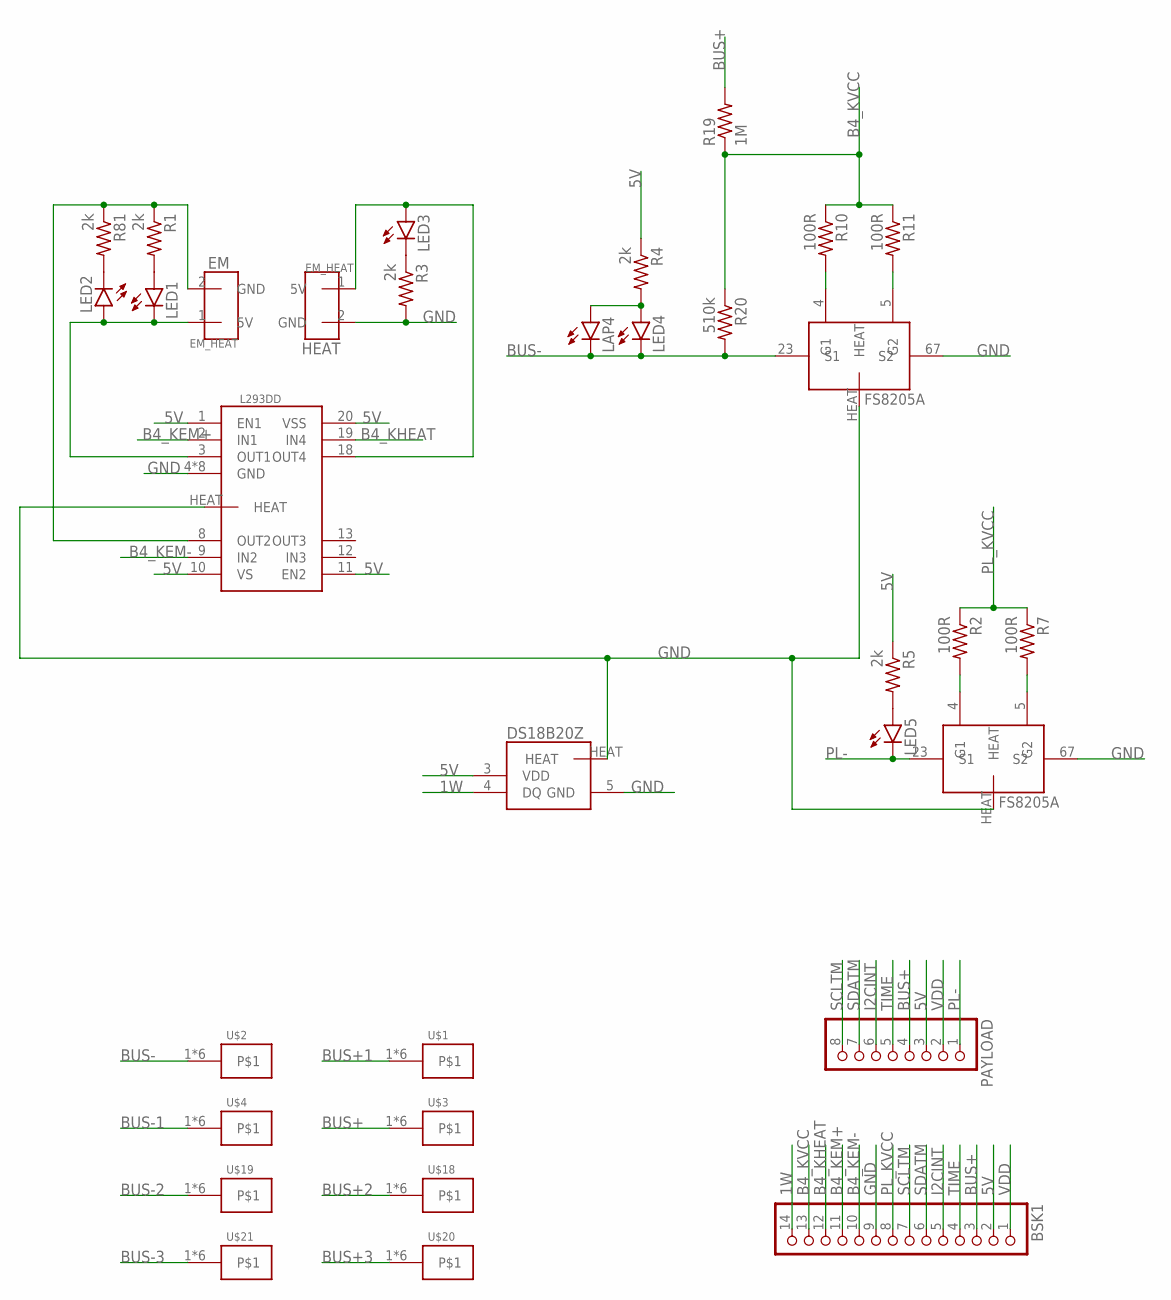
[picture p68: schematic BSK4.sch]

Parts:
BSK1: PINHD-1X14; 1X14
DS18B20Z: DS18B20Z
FS8205A#1, FS8205A#2: FS8205A+
L293DD: L293DD
LAP4: LAP4-BOTTOM; P47F-BOTTOM
LED1, LED2, LED3, LED4, LED5: LEDCHIPLED_0603; CHIPLED_0603
PAYLOAD: PINHD-1X8; 1X08
R1, R3, R4, R5, R81: 2k; R0603
R2, R7, R10, R11: 100R; R0603
R19: 1M; R0603
R20: 510k; R0603
U$1, U$2, U$3, U$4, U$18, U$19, U$20, U$21: KCONNECT
U$6, U$7: EM_HEAT

Connections:
1W: BSK1.14, DS18B20Z.4 (DQ)
5V: BSK1.2, DS18B20Z.3 (VDD), L293DD.1 (EN1), L293DD.10 (VS), L293DD.11 (EN2), L293DD.20 (VSS), PAYLOAD.3, R4.1, R5.1
B4_KEM+: BSK1.11, L293DD.2 (IN1)
B4_KEM-: BSK1.10, L293DD.9 (IN2)
B4_KHEAT: BSK1.12, L293DD.19 (IN4)
B4_KVCC: BSK1.13, R10.1, R11.1, R19.1, R20.1
BUS+: BSK1.3, PAYLOAD.4, R19.2, U$3.1, U$3.2, U$3.3, U$3.4, U$3.P$1, U$3.P$2
BUS+1: U$1.1, U$1.2, U$1.3, U$1.4, U$1.P$1, U$1.P$2
BUS+2: U$18.1, U$18.2, U$18.3, U$18.4, U$18.P$1, U$18.P$2
BUS+3: U$20.1, U$20.2, U$20.3, U$20.4, U$20.P$1, U$20.P$2
BUS-: FS8205A#1.23 (S1), LAP4.C, LED4.C, R20.2, U$2.1, U$2.2, U$2.3, U$2.4, U$2.P$1, U$2.P$2
BUS-1: U$4.1, U$4.2, U$4.3, U$4.4, U$4.P$1, U$4.P$2
BUS-2: U$19.1, U$19.2, U$19.3, U$19.4, U$19.P$1, U$19.P$2
BUS-3: U$21.1, U$21.2, U$21.3, U$21.4, U$21.P$1, U$21.P$2
GND: BSK1.9, DS18B20Z.5 (GND), DS18B20Z.HEAT, FS8205A#1.67 (S2), FS8205A#1.HEAT, FS8205A#2.67 (S2), FS8205A#2.HEAT, L293DD.4 (GND), L293DD.5 (GND), L293DD.6 (GND), L293DD.7 (GND), L293DD.14 (GND), L293DD.15 (GND), L293DD.16 (GND), L293DD.17 (GND), L293DD.HEAT, R3.2, U$7.2 (GND)
I2CINT: BSK1.5, PAYLOAD.6
unnamed: L293DD.3 (OUT1), LED1.C, LED2.A, U$6.1 (5V)
unnamed: L293DD.8 (OUT2), R1.1, R81.1, U$6.2 (GND)
unnamed: L293DD.18 (OUT4), LED3.A, U$7.1 (5V)
unnamed: FS8205A#2.4 (G1), R2.2
unnamed: LED2.C, R81.2
unnamed: FS8205A#2.5 (G2), R7.2
unnamed: LED1.A, R1.2
unnamed: FS8205A#1.4 (G1), R10.2
unnamed: FS8205A#1.5 (G2), R11.2
unnamed: LED3.C, R3.1
unnamed: LAP4.A, LED4.A, R4.2
unnamed: LED5.A, R5.2
PL-: FS8205A#2.23 (S1), LED5.C, PAYLOAD.1
PL_KVCC: BSK1.8, R2.1, R7.1
SCLTM: BSK1.7, PAYLOAD.8
SDATM: BSK1.6, PAYLOAD.7
TIME: BSK1.4, PAYLOAD.5
VDD: BSK1.1, PAYLOAD.2

Notes on the sheet:
HEAT

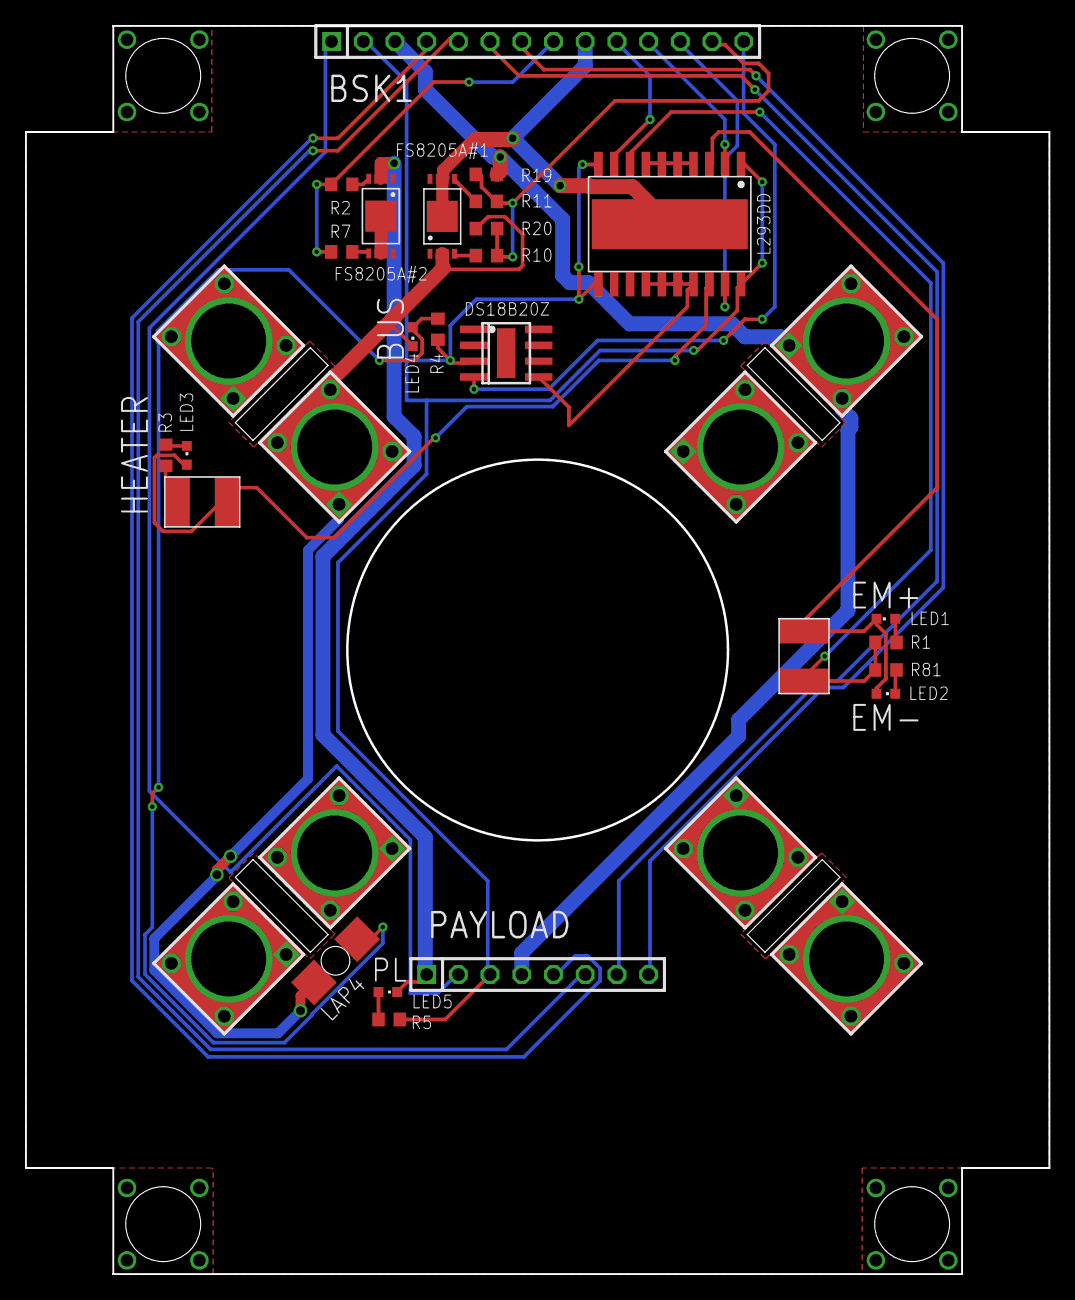
[picture p69: board BSK4.brd from above]

Board: 2 copper layers, 82.0 x 100.0 mm, 33 parts (0 on the bottom side), 34 nets.
