CONZERN-ITS/can-cube-sat/schematics/board/PL.brd

## EAGLE design schematics/board/PL.brd (2020-04-20)

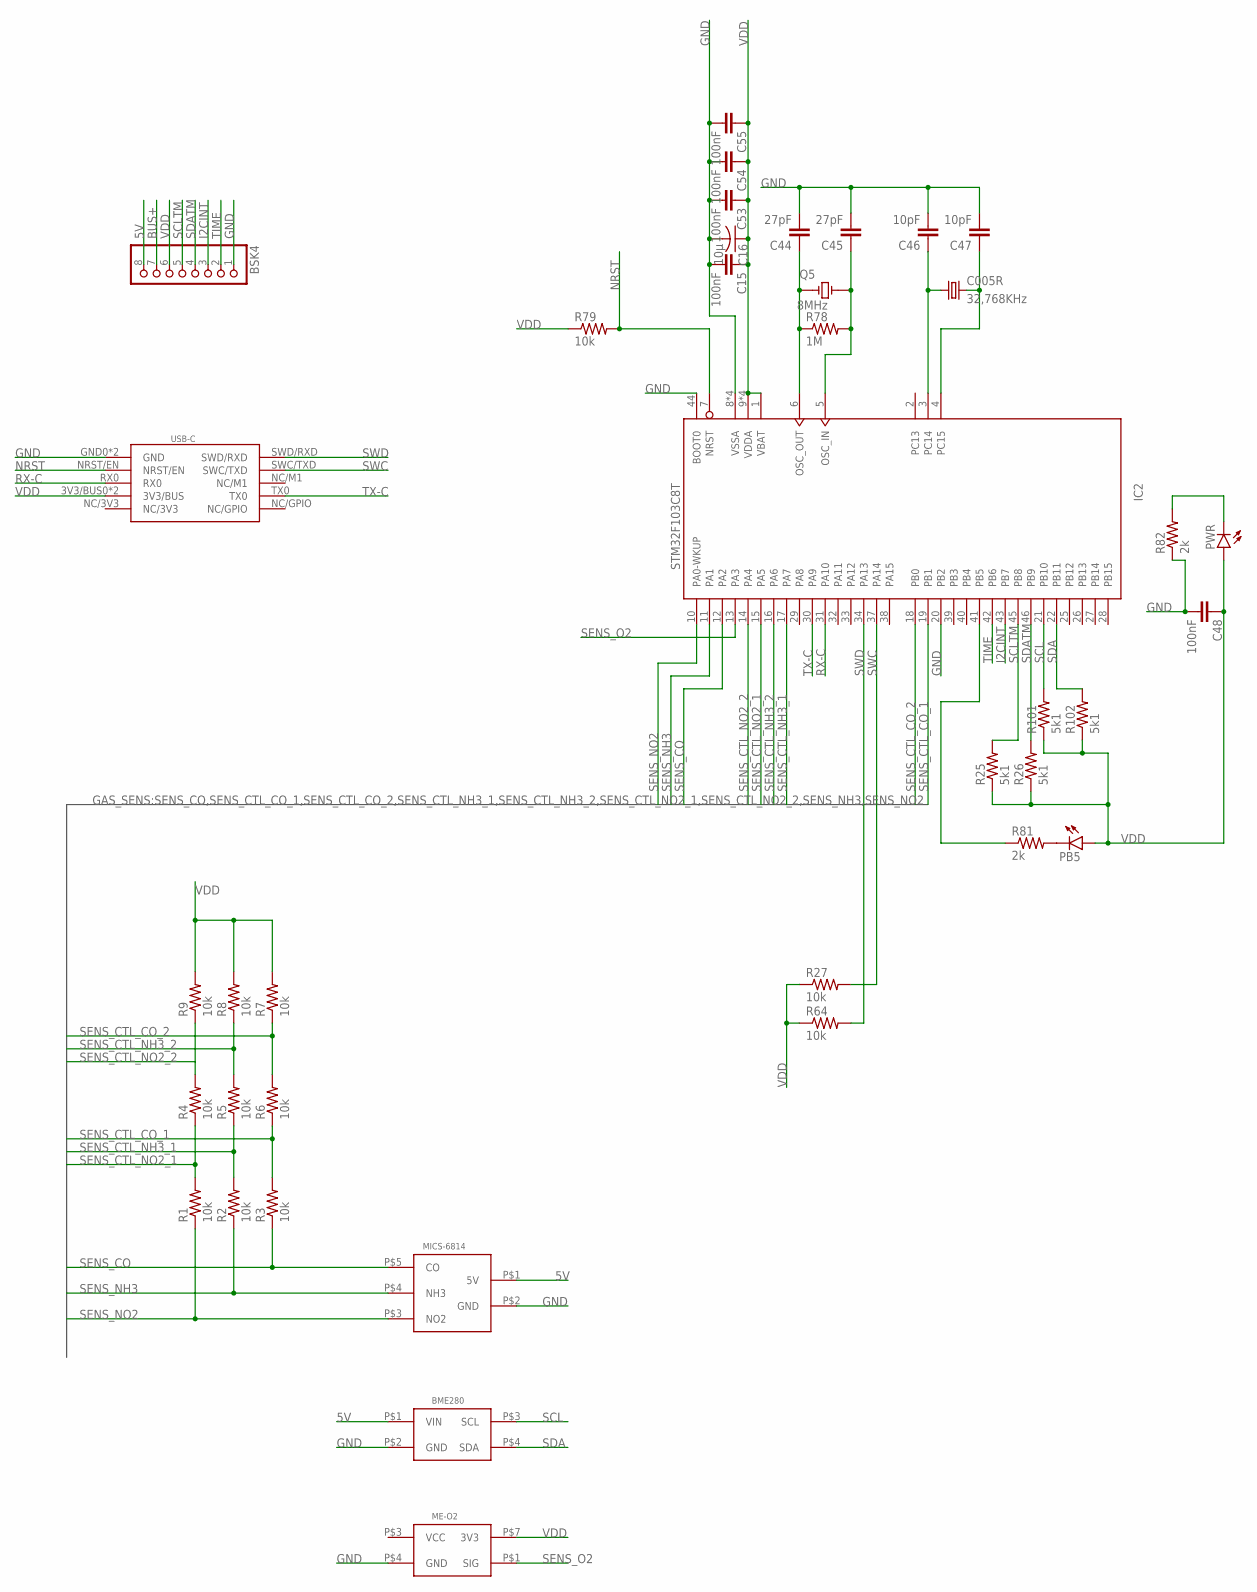
[picture p70: schematic PL.sch]

Parts:
BME280: BME280
BSK4: PINHD-1X8; 1X08
C005R: 32,768KHz; C005R
C15, C48, C53, C54, C55: 100nF; C0603
C16: 10µ; C1206
C44, C45: 27pF; C0603
C46, C47: 10pF; C0603
IC2: STM32F103C8T; LQFP48
ME-O2: ME-O2
MICS-6814: MICS-6814
PB5: LEDCHIPLED_0603; CHIPLED_0603
PWR: LEDCHIPLED_0603; CHIPLED_0603
Q5: 8MHz; XTAL_9C-8.000MEEJ-T
R1, R2, R3, R4, R5, R6, R7, R8, R9, R27, R64, R79: 10k; R0603
R25, R26, R101, R102: 5k1; R0603
R78: 1M; R0603
R81, R82: 2k; R0603
USB-C: USB-C

Connections:
5V: BME280.P$1 (VIN), BSK4.8, MICS-6814.P$1 (5V)
BUS+: BSK4.7
GND: BME280.P$2 (GND), BSK4.1, C15.2, C16.2, C44.2, C45.2, C46.2, C47.2, C48.2, C53.2, C54.2, C55.2, IC2.8 (VSSA), IC2.20 (PB2), IC2.23 (VSSA), IC2.35 (VSSA), IC2.44 (BOOT0), IC2.47 (VSSA), ME-O2.P$4 (GND), MICS-6814.P$2 (GND), R82.1, USB-C.GND0 (GND), USB-C.GND1 (GND)
I2CINT: BSK4.3, IC2.43 (PB7)
unnamed: PB5.C, R81.2
unnamed: C44.1, IC2.6 (OSC_OUT), Q5.1, R78.1
unnamed: C45.1, IC2.5 (OSC_IN), Q5.2, R78.2
unnamed: C005R.P$2 (2), C47.1, IC2.4 (PC15)
unnamed: C005R.P$1 (1), C46.1, IC2.3 (PC14)
unnamed: PWR.C, R82.2
unnamed: IC2.41 (PB5), R81.1
NRST: IC2.7 (NRST), R79.2, USB-C.NRST/EN
RX-C: IC2.31 (PA10), USB-C.RX0
SCL: BME280.P$3 (SCL), IC2.21 (PB10), R101.2
SCLTM: BSK4.5, IC2.45 (PB8), R25.2
SDA: BME280.P$4 (SDA), IC2.22 (PB11), R102.2
SDATM: BSK4.4, IC2.46 (PB9), R26.2
SENS_CO: IC2.12 (PA2), MICS-6814.P$5 (CO), R3.1
SENS_CTL_CO_1: IC2.19 (PB1), R3.2, R6.1
SENS_CTL_CO_2: IC2.18 (PB0), R6.2, R7.1
SENS_CTL_NH3_1: IC2.17 (PA7), R2.2, R5.1
SENS_CTL_NH3_2: IC2.16 (PA6), R5.2, R8.1
SENS_CTL_NO2_1: IC2.15 (PA5), R1.2, R4.1
SENS_CTL_NO2_2: IC2.14 (PA4), R4.2, R9.1
SENS_NH3: IC2.11 (PA1), MICS-6814.P$4 (NH3), R2.1
SENS_NO2: IC2.10 (PA0-WKUP), MICS-6814.P$3 (NO2), R1.1
SENS_O2: IC2.13 (PA3), ME-O2.P$1 (SIG)
SWC: IC2.37 (PA14), R27.2, USB-C.SWC/TXD
SWD: IC2.34 (PA13), R64.2, USB-C.SWD/RXD
TIME: BSK4.2, IC2.42 (PB6)
TX-C: IC2.30 (PA9), USB-C.TX0
VDD: BSK4.6, C15.1, C16.1, C48.1, C53.1, C54.1, C55.1, IC2.1 (VBAT), IC2.9 (VDDA), IC2.24 (VDDA), IC2.36 (VDDA), IC2.48 (VDDA), ME-O2.P$7 (3V3), PB5.A, PWR.A, R7.2, R8.2, R9.2, R25.1, R26.1, R27.1, R64.1, R79.1, R101.1, R102.1, USB-C.3V3/BUS0 (3V3/BUS), USB-C.3V3/BUS1 (3V3/BUS)

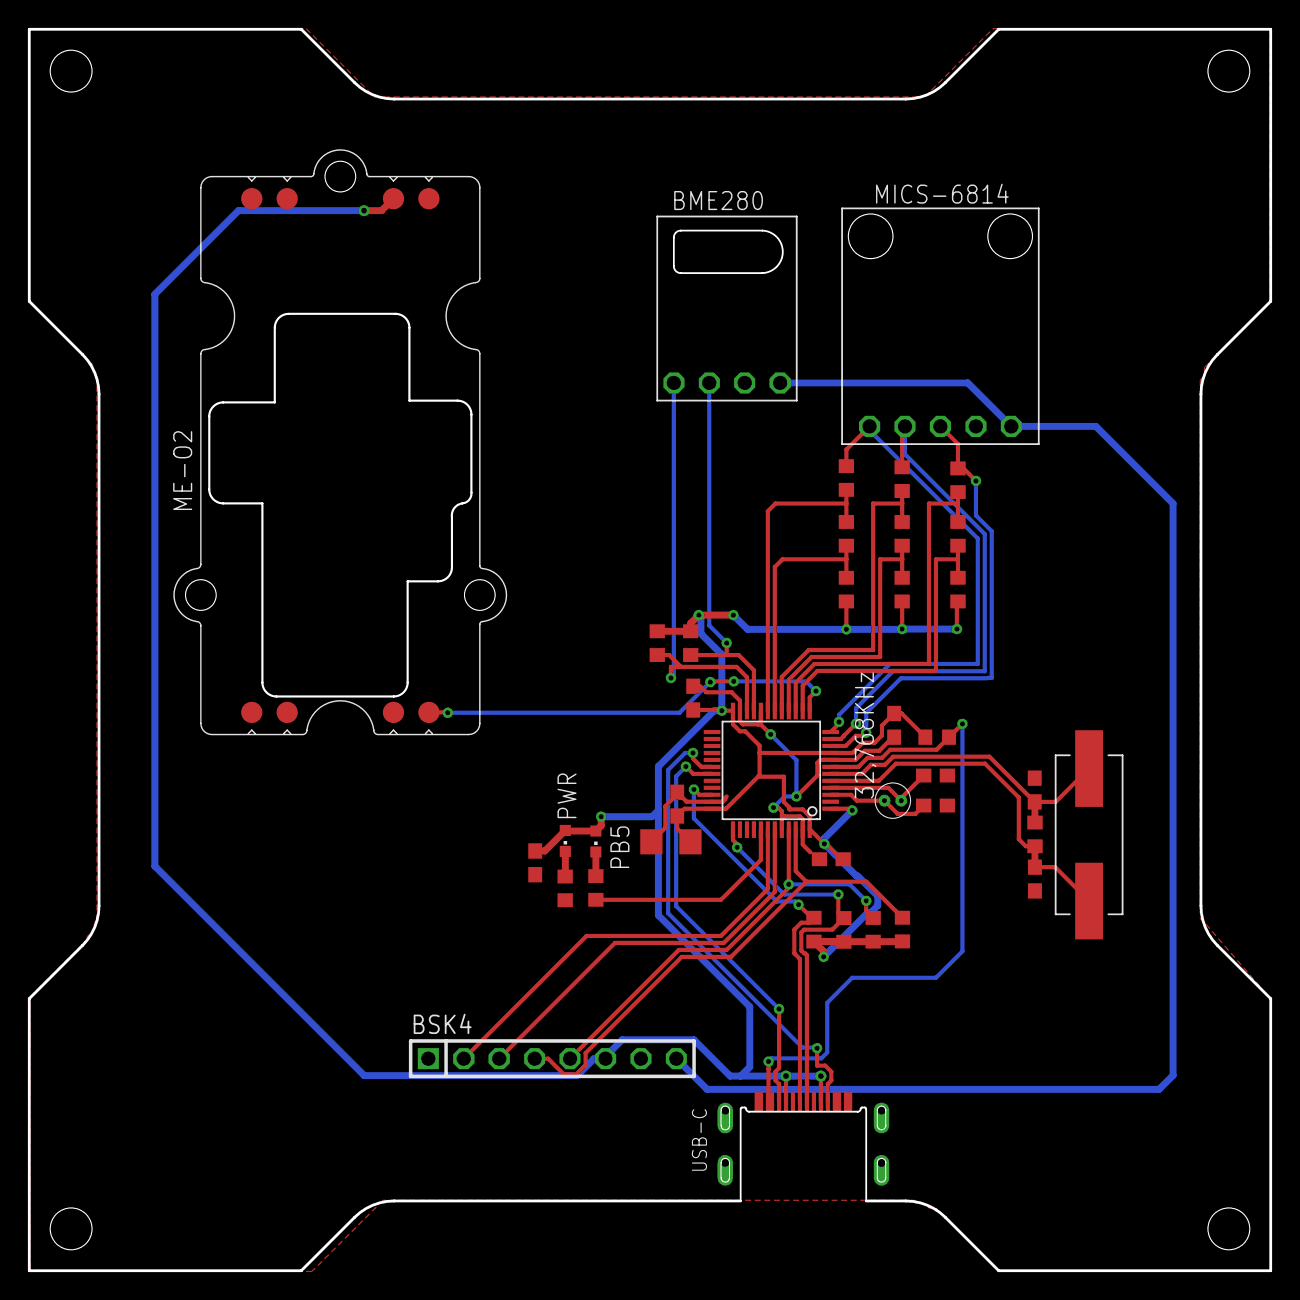
[picture p71: board PL.brd from above]

Board: 2 copper layers, 89.0 x 89.0 mm, 39 parts (0 on the bottom side), 31 nets.
