CONZERN-ITS/can-cube-sat/schematics/board/SPinner.brd

## EAGLE design schematics/board/SPinner.brd (2020-04-20)

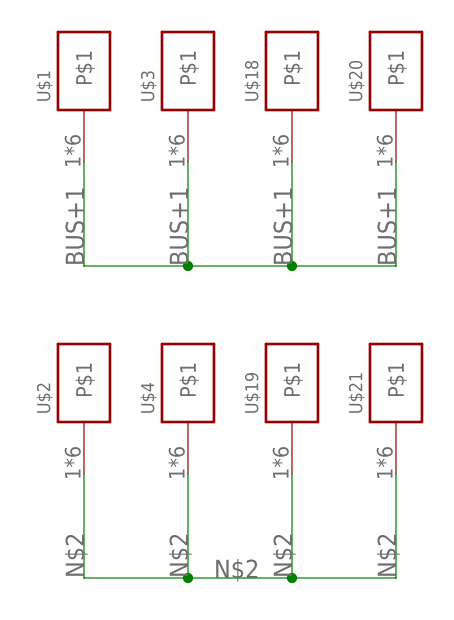
[picture p72: schematic SPinner.sch]

Parts:
U$1, U$2, U$3, U$4, U$18, U$19, U$20, U$21: KCONNECT

Connections:
BUS+1: U$1.1, U$1.2, U$1.3, U$1.4, U$1.P$1, U$1.P$2, U$3.1, U$3.2, U$3.3, U$3.4, U$3.P$1, U$3.P$2, U$18.1, U$18.2, U$18.3, U$18.4, U$18.P$1, U$18.P$2, U$20.1, U$20.2, U$20.3, U$20.4, U$20.P$1, U$20.P$2
unnamed: U$2.1, U$2.2, U$2.3, U$2.4, U$2.P$1, U$2.P$2, U$4.1, U$4.2, U$4.3, U$4.4, U$4.P$1, U$4.P$2, U$19.1, U$19.2, U$19.3, U$19.4, U$19.P$1, U$19.P$2, U$21.1, U$21.2, U$21.3, U$21.4, U$21.P$1, U$21.P$2

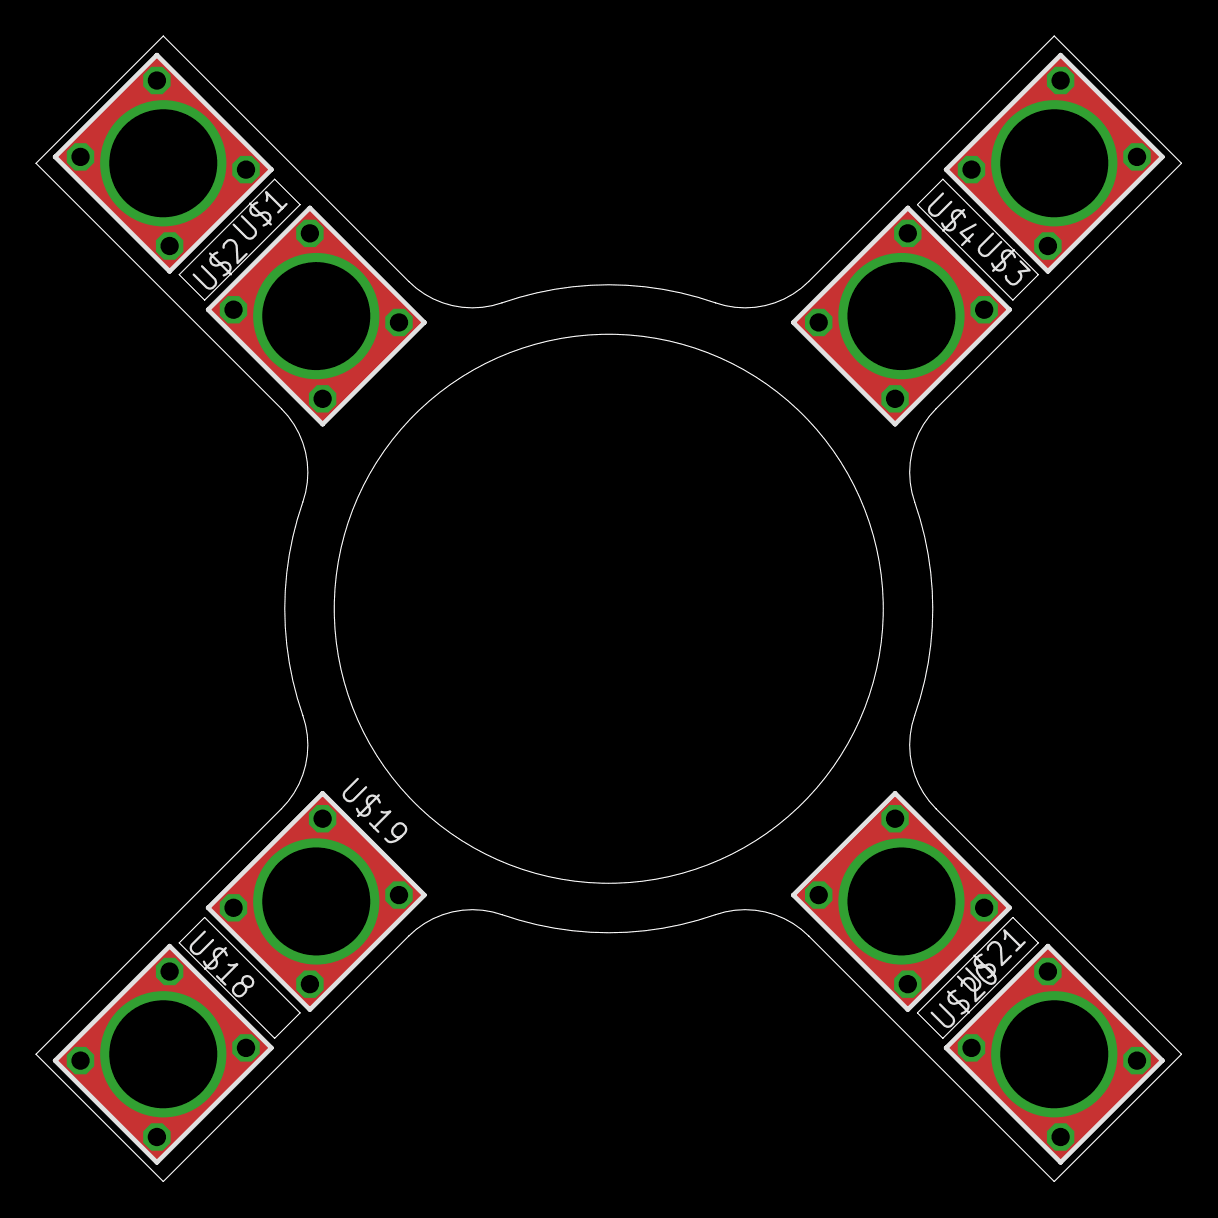
[picture p73: board SPinner.brd from above]

Board: 2 copper layers, 63.6 x 63.6 mm, 8 parts (0 on the bottom side), 2 nets.
