CONZERN-ITS/can-cube-sat/schematics/board/TESTPL.brd

## EAGLE design schematics/board/TESTPL.brd (2020-04-15)

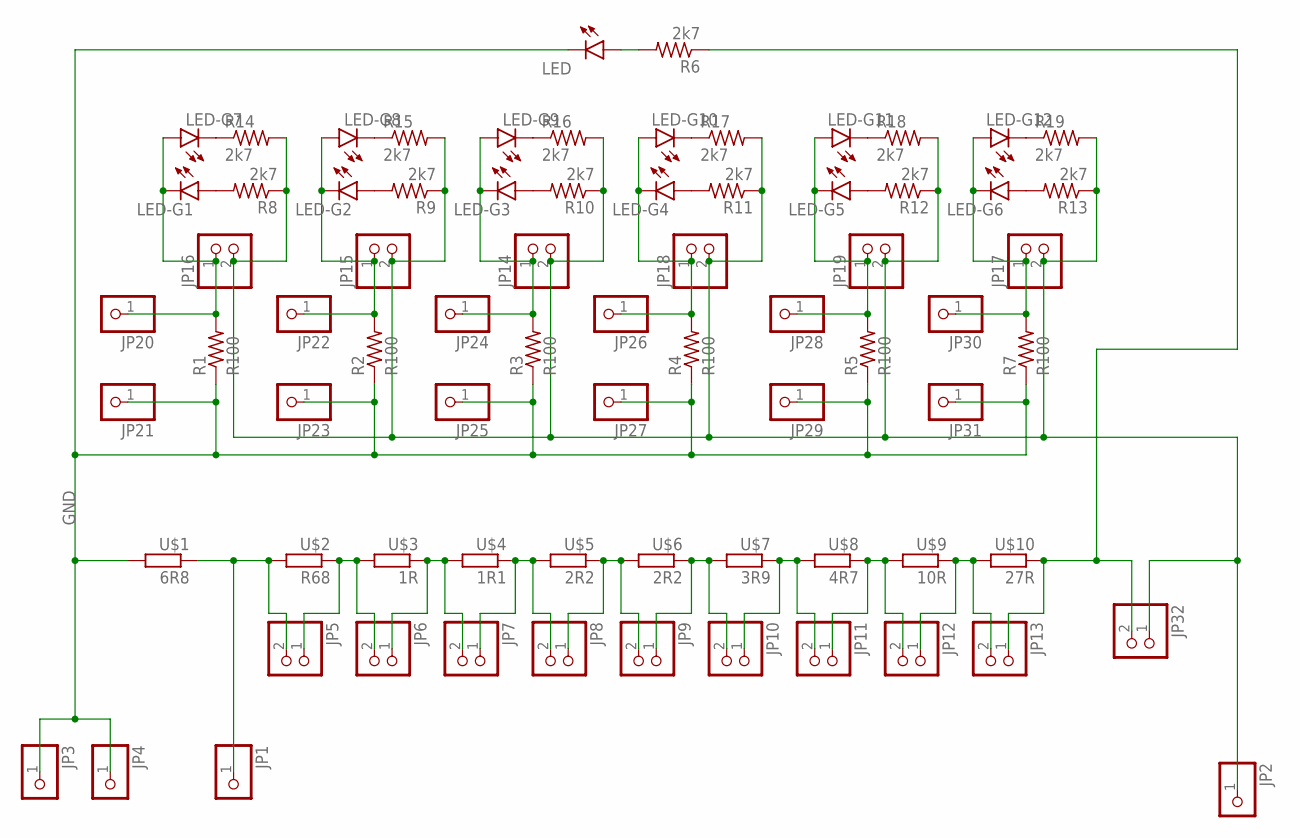
[picture p74: schematic TESTPL.sch]

Parts:
JP1, JP2, JP3, JP4, JP20, JP21, JP22, JP23, JP24, JP25, JP26, JP27, JP28, JP29, JP30, JP31: PINHD-1X1; 1X01
JP5, JP6, JP7, JP8, JP9, JP10, JP11, JP12, JP13, JP14, JP15, JP16, JP17, JP18, JP19, JP32: PINHD-1X2; 1X02
LED: LEDCHIPLED_0603; CHIPLED_0603
LED-G1, LED-G2, LED-G3, LED-G4, LED-G5, LED-G6, LED-G7, LED-G8, LED-G9, LED-G10, LED-G11, LED-G12: LEDCHIPLED_0603; CHIPLED_0603
R1, R2, R3, R4, R5, R7: R100; R2512
R6, R8, R9, R10, R11, R12, R13, R14, R15, R16, R17, R18, R19: 2k7; R0603
U$1: 6R8; SQP
U$2: R68; SQP
U$3: 1R; SQP
U$4: 1R1; SQP
U$5, U$6: 2R2; SQP
U$7: 3R9; SQP
U$8: 4R7; SQP
U$9: 10R; SQP
U$10: 27R; SQP

Connections:
GND: JP3.1, JP4.1, JP21.1, JP23.1, JP25.1, JP27.1, JP29.1, JP31.1, LED.C, R1.1, R2.1, R3.1, R4.1, R5.1, R7.1, U$1.P$2 (2)
unnamed: JP1.1, JP5.2, U$1.P$1 (1), U$2.P$2 (2)
unnamed: JP5.1, JP6.2, U$2.P$1 (1), U$3.P$2 (2)
unnamed: JP6.1, JP7.2, U$3.P$1 (1), U$4.P$2 (2)
unnamed: JP7.1, JP8.2, U$4.P$1 (1), U$5.P$2 (2)
unnamed: JP8.1, JP9.2, U$5.P$1 (1), U$6.P$2 (2)
unnamed: JP9.1, JP10.2, U$6.P$1 (1), U$7.P$2 (2)
unnamed: JP10.1, JP11.2, U$7.P$1 (1), U$8.P$2 (2)
unnamed: JP11.1, JP12.2, U$8.P$1 (1), U$9.P$2 (2)
unnamed: JP12.1, JP13.2, U$9.P$1 (1), U$10.P$2 (2)
unnamed: JP17.1, JP30.1, LED-G6.C, LED-G12.A, R7.2
unnamed: JP2.1, JP14.2, JP15.2, JP16.2, JP17.2, JP18.2, JP19.2, JP32.1, R8.1, R9.1, R10.1, R11.1, R12.1, R13.1, R14.2, R15.2, R16.2, R17.2, R18.2, R19.2
unnamed: JP19.1, JP28.1, LED-G5.C, LED-G11.A, R5.2
unnamed: JP18.1, JP26.1, LED-G4.C, LED-G10.A, R4.2
unnamed: JP14.1, JP24.1, LED-G3.C, LED-G9.A, R3.2
unnamed: JP15.1, JP22.1, LED-G2.C, LED-G8.A, R2.2
unnamed: JP16.1, JP20.1, LED-G1.C, LED-G7.A, R1.2
unnamed: JP13.1, JP32.2, R6.1, U$10.P$1 (1)
unnamed: LED-G1.A, R8.2
unnamed: LED-G2.A, R9.2
unnamed: LED-G3.A, R10.2
unnamed: LED-G4.A, R11.2
unnamed: LED-G5.A, R12.2
unnamed: LED-G6.A, R13.2
unnamed: LED-G8.C, R15.1
unnamed: LED-G7.C, R14.1
unnamed: LED-G9.C, R16.1
unnamed: LED-G10.C, R17.1
unnamed: LED-G11.C, R18.1
unnamed: LED-G12.C, R19.1
unnamed: LED.A, R6.2

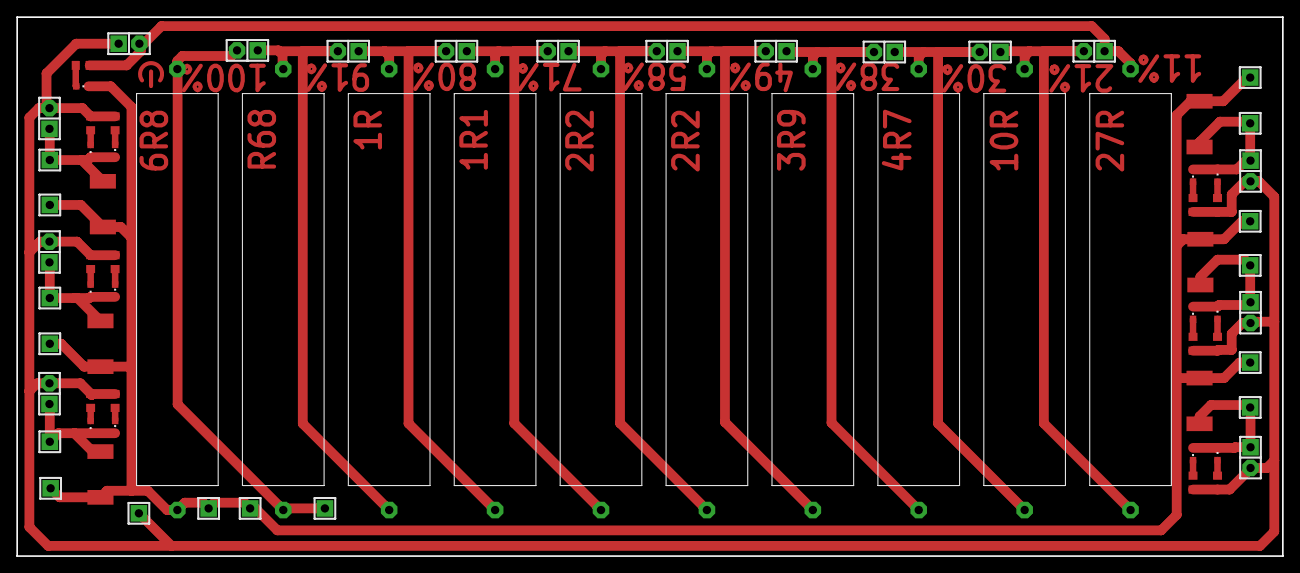
[picture p75: board TESTPL.brd from above]

Board: 2 copper layers, 155.0 x 66.0 mm, 74 parts (0 on the bottom side), 31 nets.
