CONZERN-ITS/can-cube-sat/schematics/board/ADAPT.brd

## EAGLE design schematics/board/ADAPT.brd (2020-04-13)

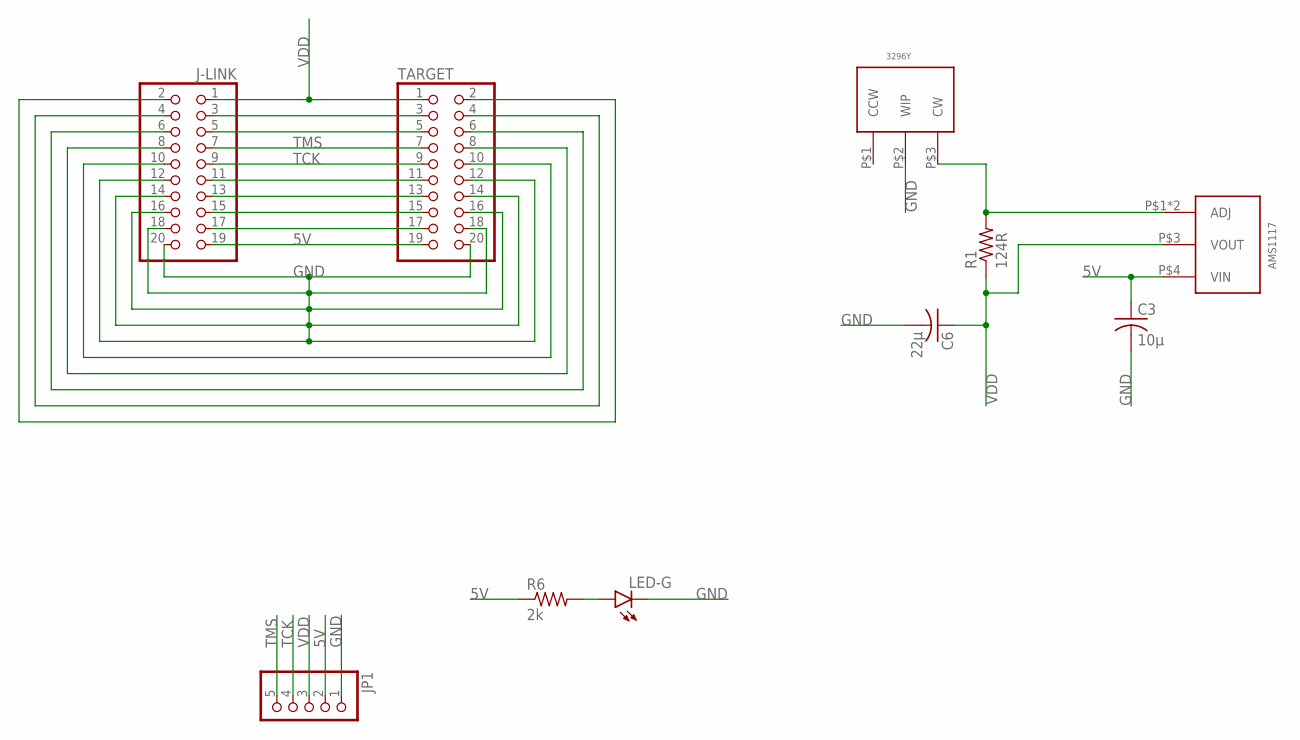
[picture p76: schematic ADAPT.sch]

Parts:
3296Y: 3296Y
AMS1117: AMS1117
C3: 10µ; C1206
C6: 22µ; C1206
J-LINK: PINHD-2X10; 2X10
JP1: PINHD-1X5; 1X05
LED-G: LEDCHIPLED_0603; CHIPLED_0603
R1: 124R; R0805
R6: 2k; R0603
TARGET: PINHD-2X10; 2X10

Connections:
5V: AMS1117.P$4 (VIN), C3.1, J-LINK.19, JP1.2, R6.1, TARGET.19
GND: 3296Y.P$2 (WIP), C3.2, C6.2, J-LINK.12, J-LINK.14, J-LINK.16, J-LINK.18, J-LINK.20, JP1.1, LED-G.C, TARGET.12, TARGET.14, TARGET.16, TARGET.18, TARGET.20
unnamed: J-LINK.3, TARGET.3
unnamed: J-LINK.5, TARGET.5
unnamed: 3296Y.P$3 (CW), AMS1117.P$1 (ADJ), AMS1117.P$2 (ADJ), R1.2
unnamed: J-LINK.11, TARGET.11
unnamed: J-LINK.13, TARGET.13
unnamed: J-LINK.15, TARGET.15
unnamed: J-LINK.17, TARGET.17
unnamed: J-LINK.10, TARGET.10
unnamed: J-LINK.8, TARGET.8
unnamed: J-LINK.6, TARGET.6
unnamed: J-LINK.4, TARGET.4
unnamed: J-LINK.2, TARGET.2
unnamed: LED-G.A, R6.2
TCK: J-LINK.9, JP1.4, TARGET.9
TMS: J-LINK.7, JP1.5, TARGET.7
VDD: AMS1117.P$3 (VOUT), C6.1, J-LINK.1, JP1.3, R1.1, TARGET.1

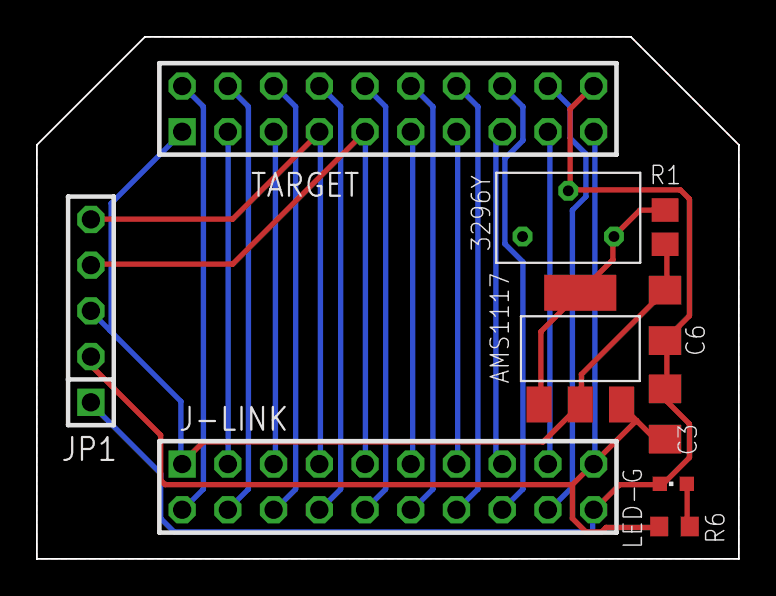
[picture p77: board ADAPT.brd from above]

Board: 2 copper layers, 39.0 x 29.0 mm, 10 parts (0 on the bottom side), 18 nets.
