CONZERN-ITS/can-cube-sat/schematics/board/Grove - Gas Sensor(O2) v1.1.brd

## EAGLE design schematics/board/Grove - Gas Sensor(O2) v1.1.brd (2020-03-31)

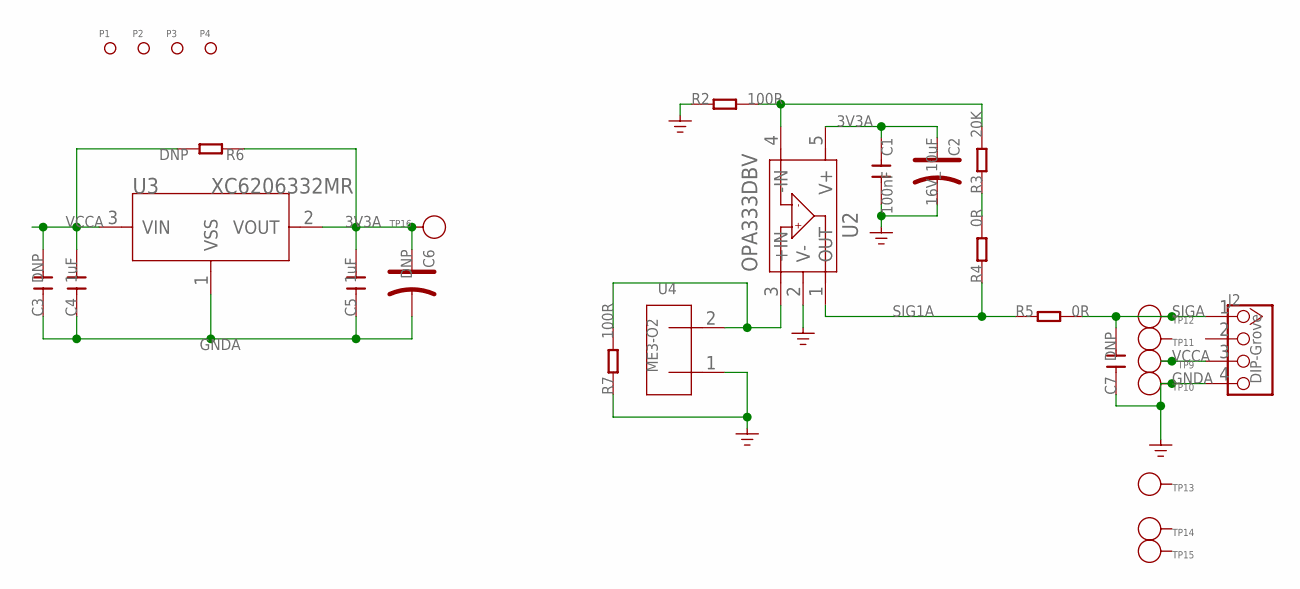
[picture p78: schematic Grove - Gas Sensor(O2) v1.1.sch]

Parts:
C1: 100nF; C0603
C2: 16V_10uF; AVX-A
C3, C7: DNP; C0805
C4, C5: 1uF; C0603
C6: DNP; AVX-A
J2: DIP-Grove; 4P-2.0
P1, P2, P3, P4: PAD-MARK'ANNULAR'; ROUND-MARK-1.0
R2, R7: 100R; R0603
R3: 20K; R0603
R4, R5: 0R; R0603
R6: DNP; R0603
TP9, TP10, TP11, TP12, TP13, TP14, TP15, TP16: PAD-TEST-POINT'4545'; TP_4545
U2: OPA333DBV; SOT23-5
U3: XC6206332MR; SOT23
U4: ME3-O2; 2P-D20X16H

Connections:
3V3A: C1.1, C2.+, C5.2, C6.+, R6.1, TP16.T, U2.5 (V+), U3.2 (VOUT)
GNDA: C1.2, C2.-, C3.1, C4.1, C5.1, C6.-, C7.1, J2.4, R2.1, R7.1, TP10.T, U2.2 (V-), U3.1 (VSS), U4.1
unnamed: R7.2, U2.3 (+IN), U4.2
unnamed: R2.2, R3.2, U2.4 (-IN)
unnamed: R3.1, R4.2
SIG1A: R4.1, R5.1, U2.1 (OUT)
SIGA: C7.2, J2.1, R5.2, TP12.T
VCCA: C3.2, C4.2, J2.3, R6.2, TP9.T, U3.3 (VIN)

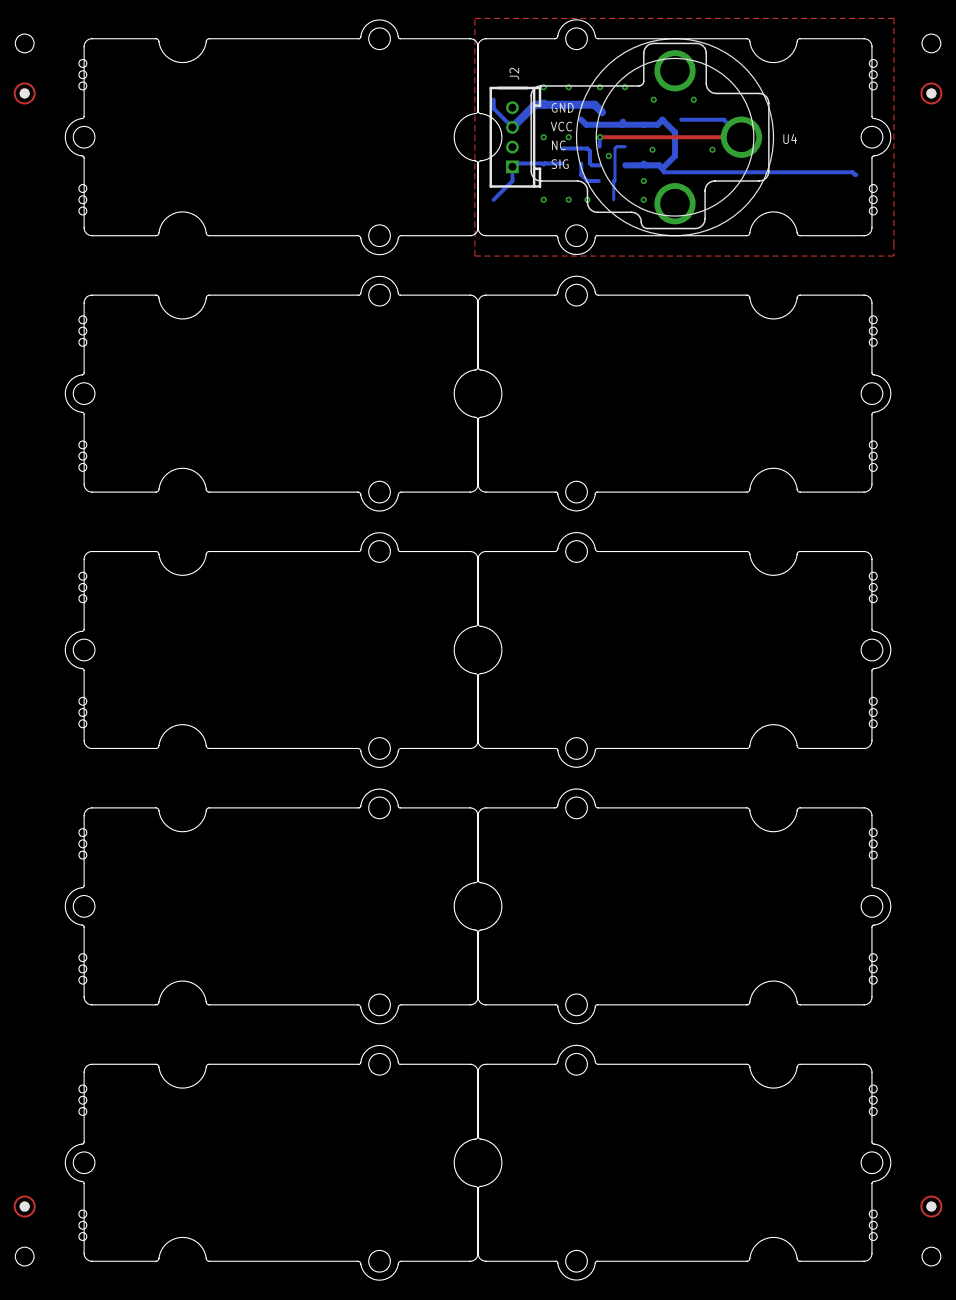
[picture p79: board Grove - Gas Sensor(O2) v1.1.brd from above]

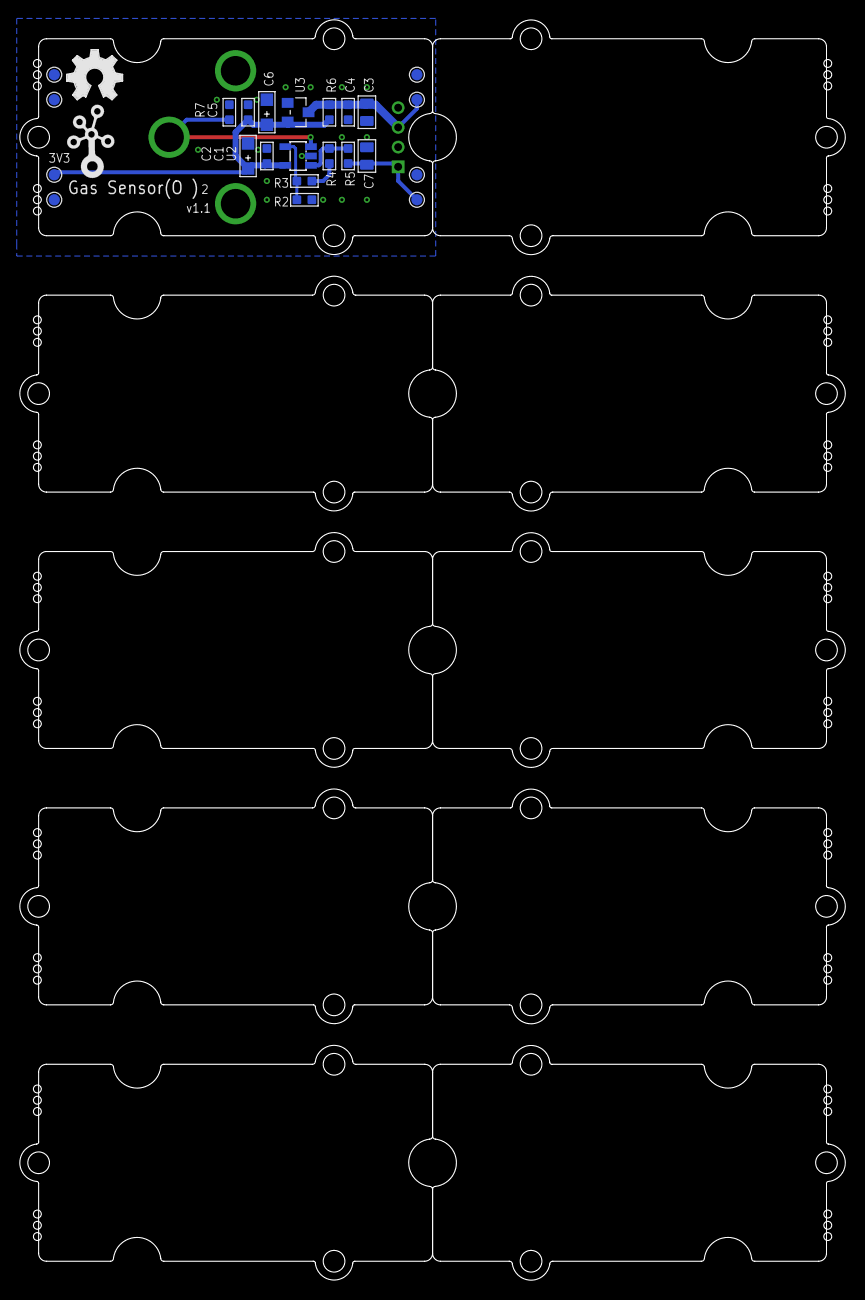
[picture p80: board Grove - Gas Sensor(O2) v1.1.brd from below]

Board: 2 copper layers, 83.8 x 128.0 mm, 41 parts (25 on the bottom side), 8 nets.

Other parts of the board:
U$1, U$2, U$3, U$4, U$5, U$6, U$8, U$14, U$16, U$18: GROVE-TEST-PLATFORM
U$15: OSHW_FILLX200_NOTEXT
U$17: TWIGLOGO
