CONZERN-ITS/can-cube-sat/schematics/board/BMS.brd

## EAGLE design schematics/board/BMS.brd (2020-03-04)

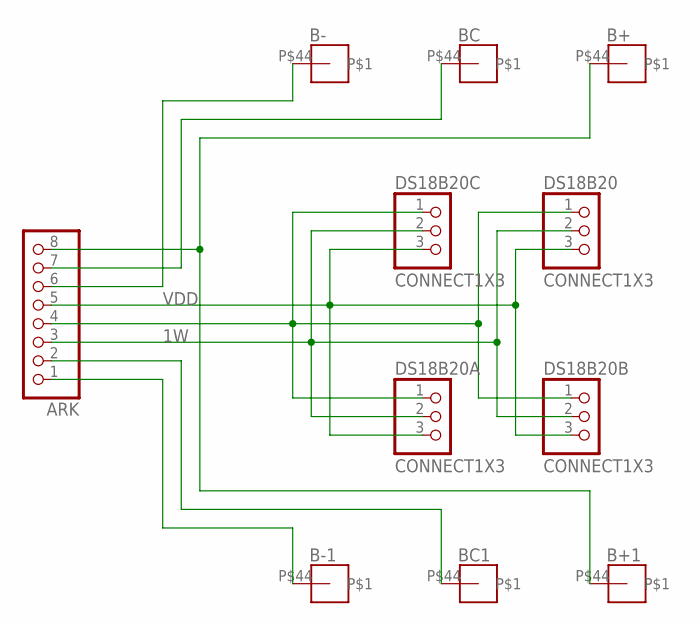
[picture p81: schematic BMS.sch]

Parts:
ARK: PINHD-1X8; 1X08
B+, B+1: DRILLBAT5
B-, B-1: DRILLBAT5
BC, BC1: DRILLBAT5
DS18B20, DS18B20A, DS18B20B, DS18B20C: CONNECT1X3

Connections:
1W: ARK.3, DS18B20.2, DS18B20A.2, DS18B20B.2, DS18B20C.2
BMS+: ARK.8, B+.P$44, B+1.P$44
unnamed: ARK.4, DS18B20.1, DS18B20A.1, DS18B20B.1, DS18B20C.1
unnamed: ARK.6, B-.P$44
unnamed: ARK.1, B-1.P$44
unnamed: ARK.7, BC.P$44
unnamed: ARK.2, BC1.P$44
VDD: ARK.5, DS18B20.3, DS18B20A.3, DS18B20B.3, DS18B20C.3

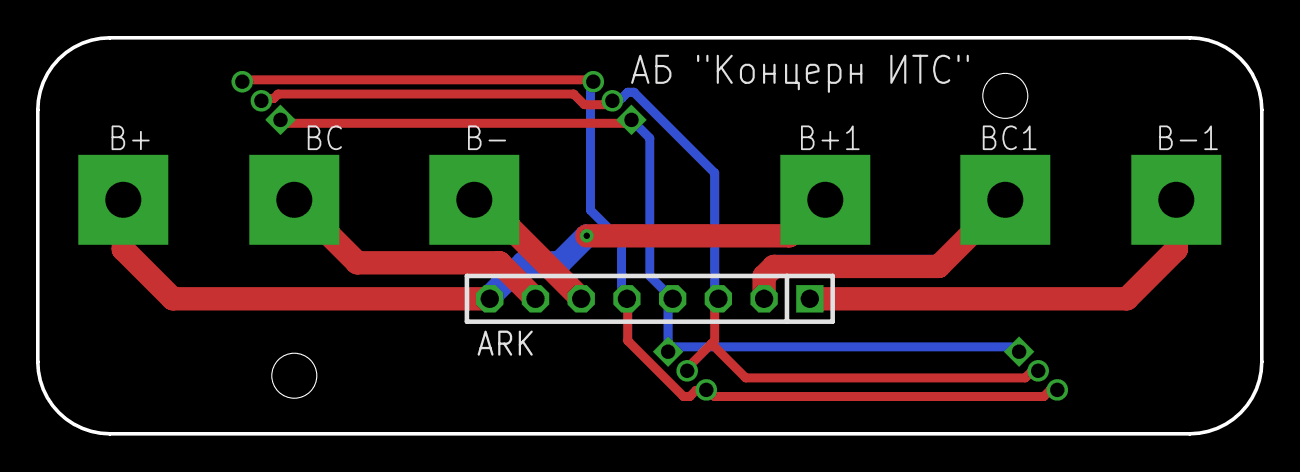
[picture p82: board BMS.brd from above]

Board: 2 copper layers, 68.0 x 22.0 mm, 11 parts (0 on the bottom side), 8 nets.
