CONZERN-ITS/can-cube-sat/schematics/board/oldARK.brd

## EAGLE design schematics/board/oldARK.brd (2020-02-18, an earlier design)

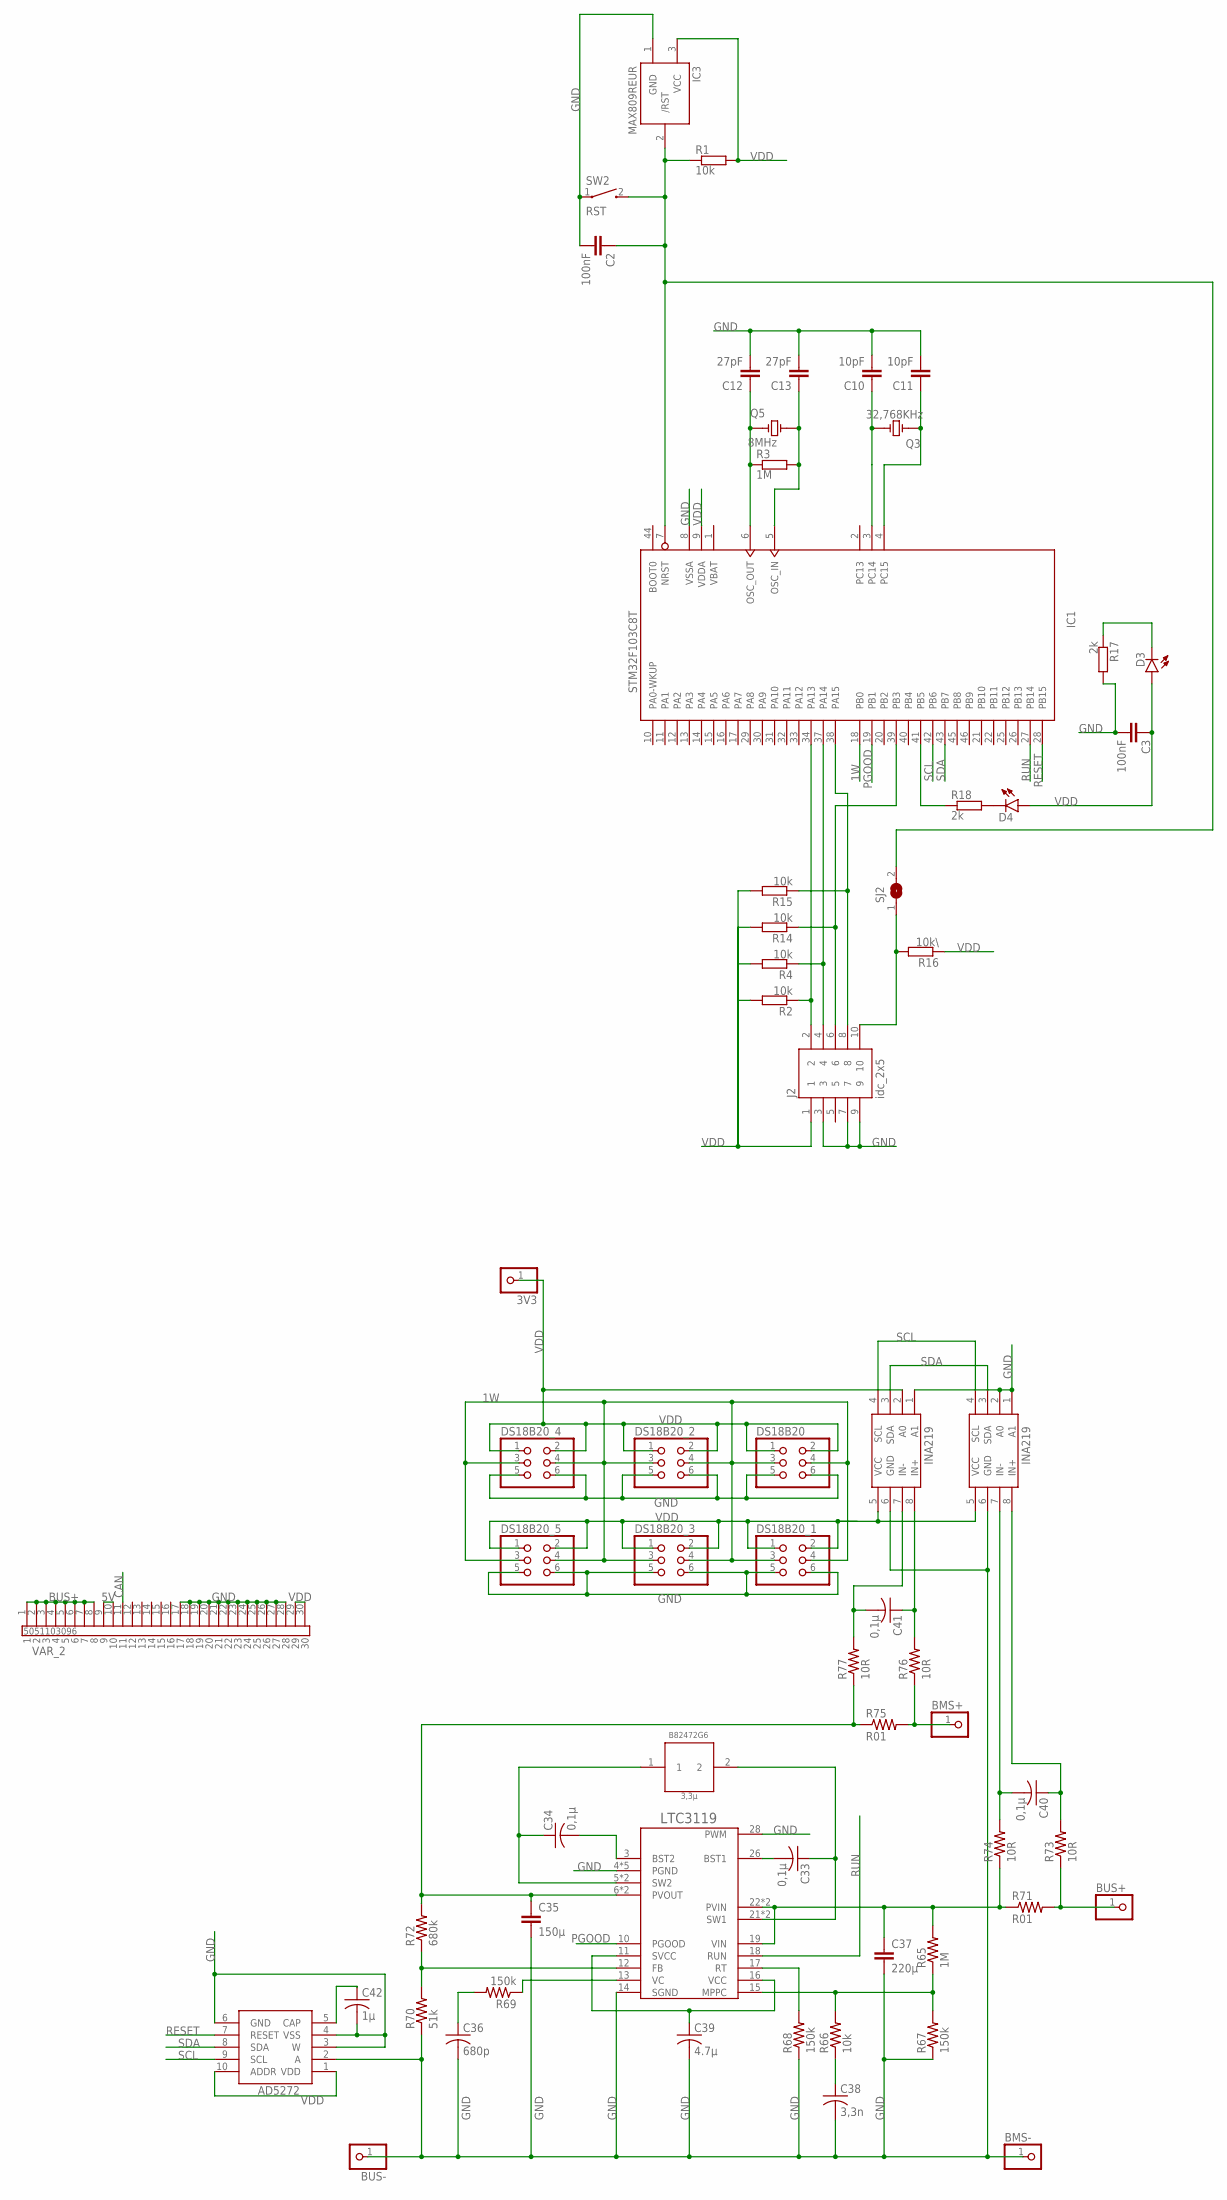
[picture p83: schematic oldARK.sch]

Parts:
3,3µH: 3,3µ; B82472G6
3V3: PINHD-1X1; 1X01
BMS+: PINHD-1X1; 1X01
BMS-: PINHD-1X1; 1X01
BUS+: PINHD-1X1; 1X01
BUS-: PINHD-1X1; 1X01
C2, C3: 100nF; C0603
C10, C11: 10pF; C0603
C12, C13: 27pF; C0603
C33, C34, C40, C41: 0,1µ; C0603
C35: 150µ; ECAP150
C36: 680p; C1206
C37: 220µ; ECAP220
C38: 3,3n; C1206
C39: 4.7µ; C1206
C42: 1µ; C0603
D3, D4: HLMP6
DS18B20, DS18B20_1, DS18B20_2, DS18B20_3, DS18B20_4, DS18B20_5: PINHD-2X3M; 2X03M
IC1: STM32F103C8T; LQFP48
IC3: MAX809REUR; SOT23
J2: idc_2x5; CNC_3221-10-0100-00
Q3: 32,768KHz; XTAL_9C-8.000MEEJ-T
Q5: 8MHz; XTAL_9C-8.000MEEJ-T
R1, R2, R4, R14, R15: 10k; BVS
R3: 1M; BVS
R16: 10k\; BVS
R17, R18: 2k; BVS
R65: 1M; R0603
R66: 10k; R0603
R67, R68, R69: 150k; R0603
R70: 51k; R0603
R71, R75: R01; R2512
R72: 680k; R0603
R73, R74, R76, R77: 10R; R0603
SJ2: SJW
SW2: RST; SW_1437566-3
U$4: 5051103096
U$57, U$58: INA219AID
U$59: LTC3119
U$60: AD5272

Connections:
1W: DS18B20.3, DS18B20.4, DS18B20_1.3, DS18B20_1.4, DS18B20_2.3, DS18B20_2.4, DS18B20_3.3, DS18B20_3.4, DS18B20_4.3, DS18B20_4.4, DS18B20_5.3, DS18B20_5.4, IC1.18 (PB0)
5V: U$4.9, U$4.10
BUS+: U$4.1, U$4.2, U$4.3, U$4.4, U$4.5, U$4.6, U$4.7, U$4.8
GND: BMS-.1, BUS-.1, C2.2, C3.2, C10.2, C11.2, C12.2, C13.2, C35.P$2 (2), C36.2, C37.P$2 (2), C38.2, C39.2, C42.2, DS18B20.5, DS18B20.6, DS18B20_1.5, DS18B20_1.6, DS18B20_2.5, DS18B20_2.6, DS18B20_3.5, DS18B20_3.6, DS18B20_4.5, DS18B20_4.6, DS18B20_5.5, DS18B20_5.6, IC1.8 (VSSA), IC3.1 (GND), J2.3, J2.7, J2.9, R17.1, R67.1, R68.1, R70.1, SW2.1, U$4.17, U$4.18, U$4.19, U$4.20, U$4.21, U$4.22, U$4.23, U$4.24, U$4.25, U$4.26, U$4.27, U$4.28, U$57.1 (A1), U$57.6 (GND), U$58.1 (A1), U$58.2 (A0), U$58.6 (GND), U$59.4 (PGND), U$59.9 (PGND), U$59.14 (SGND), U$59.20 (PGND), U$59.25 (PGND), U$59.28 (PWM), U$59.29 (PGND), U$60.2 (A), U$60.3 (W), U$60.4 (VSS), U$60.6 (GND)
unnamed: C2.1, IC1.7 (NRST), IC3.2 (/RST), R1.2, SJ2.2, SW2.2
unnamed: C11.1, IC1.4 (PC15), Q3.1
unnamed: C10.1, IC1.3 (PC14), Q3.2
unnamed: IC1.34 (PA13), J2.2, R2.2
unnamed: C12.1, IC1.6 (OSC_OUT), Q5.1, R3.2
unnamed: C13.1, IC1.5 (OSC_IN), Q5.2, R3.1
unnamed: IC1.37 (PA14), J2.4, R4.2
unnamed: IC1.38 (PA15), J2.8, R15.2
unnamed: IC1.39 (PB3), J2.6, R14.2
unnamed: J2.10, R16.1, SJ2.1
unnamed: D3.K, R17.2
unnamed: D4.K, R18.1
unnamed: IC1.41 (PB5), R18.2
unnamed: C34.2, U$59.3 (BST2)
unnamed: 3,3µH.2, C33.1, U$59.21 (SW1), U$59.24 (SW1)
unnamed: 3,3µH.1, C34.1, U$59.5 (SW2), U$59.8 (SW2)
unnamed: C35.P$1 (1), R72.2, R75.1, R77.1, U$59.6 (PVOUT), U$59.7 (PVOUT)
unnamed: R69.1, U$59.13 (VC)
unnamed: C36.1, R69.2
unnamed: C37.P$1 (1), R65.2, R71.1, R74.1, U$59.19 (VIN), U$59.22 (PVIN), U$59.23 (PVIN)
unnamed: R65.1, R66.2, R67.2, U$59.15 (MPPC)
unnamed: C38.1, R66.1
unnamed: C39.1, U$59.11 (SVCC), U$59.16 (VCC)
unnamed: C40.2, R74.2, U$58.7 (IN-)
unnamed: R68.2, U$59.17 (RT)
unnamed: R70.2, R72.1, U$59.12 (FB)
unnamed: C33.2, U$59.26 (BST1)
unnamed: BUS+.1, R71.2, R73.1
unnamed: C40.1, R73.2, U$58.8 (IN+)
unnamed: BMS+.1, R75.2, R76.1
unnamed: C41.1, R76.2, U$57.8 (IN+)
unnamed: C41.2, R77.2, U$57.7 (IN-)
unnamed: C42.1, U$60.5 (CAP)
PGOOD: IC1.19 (PB1), U$59.10 (PGOOD)
RESET: IC1.28 (PB15), U$60.7 (RESET)
RUN: IC1.27 (PB14), U$59.18 (RUN)
SCL: IC1.42 (PB6), U$57.4 (SCL), U$58.4 (SCL), U$60.9 (SCL)
SDA: IC1.43 (PB7), U$57.3 (SDA), U$58.3 (SDA), U$60.8 (SDA)
VBAT: IC1.1 (VBAT)
VDD: 3V3.1, C3.1, D3.A, D4.A, DS18B20.1, DS18B20.2, DS18B20_1.1, DS18B20_1.2, DS18B20_2.1, DS18B20_2.2, DS18B20_3.1, DS18B20_3.2, DS18B20_4.1, DS18B20_4.2, DS18B20_5.1, DS18B20_5.2, IC1.9 (VDDA), IC1.24 (VDD), IC1.36 (VDD), IC1.48 (VDD), IC3.3 (VCC), J2.1, R1.1, R2.1, R4.1, R14.1, R15.1, R16.2, U$4.29, U$4.30, U$57.2 (A0), U$57.5 (VCC), U$58.5 (VCC), U$60.1 (VDD), U$60.10 (ADDR)
VSS: IC1.23 (VSS), IC1.35 (VSS), IC1.47 (VSS)

Notes on the sheet:
VAR_2

Board: 2 copper layers, 64 parts (0 on the bottom side), 44 nets, no tracks yet.
