CONZERN-ITS/can-cube-sat/schematics/board/CROSSMAG.brd

## EAGLE design schematics/board/CROSSMAG.brd (2020-04-04)

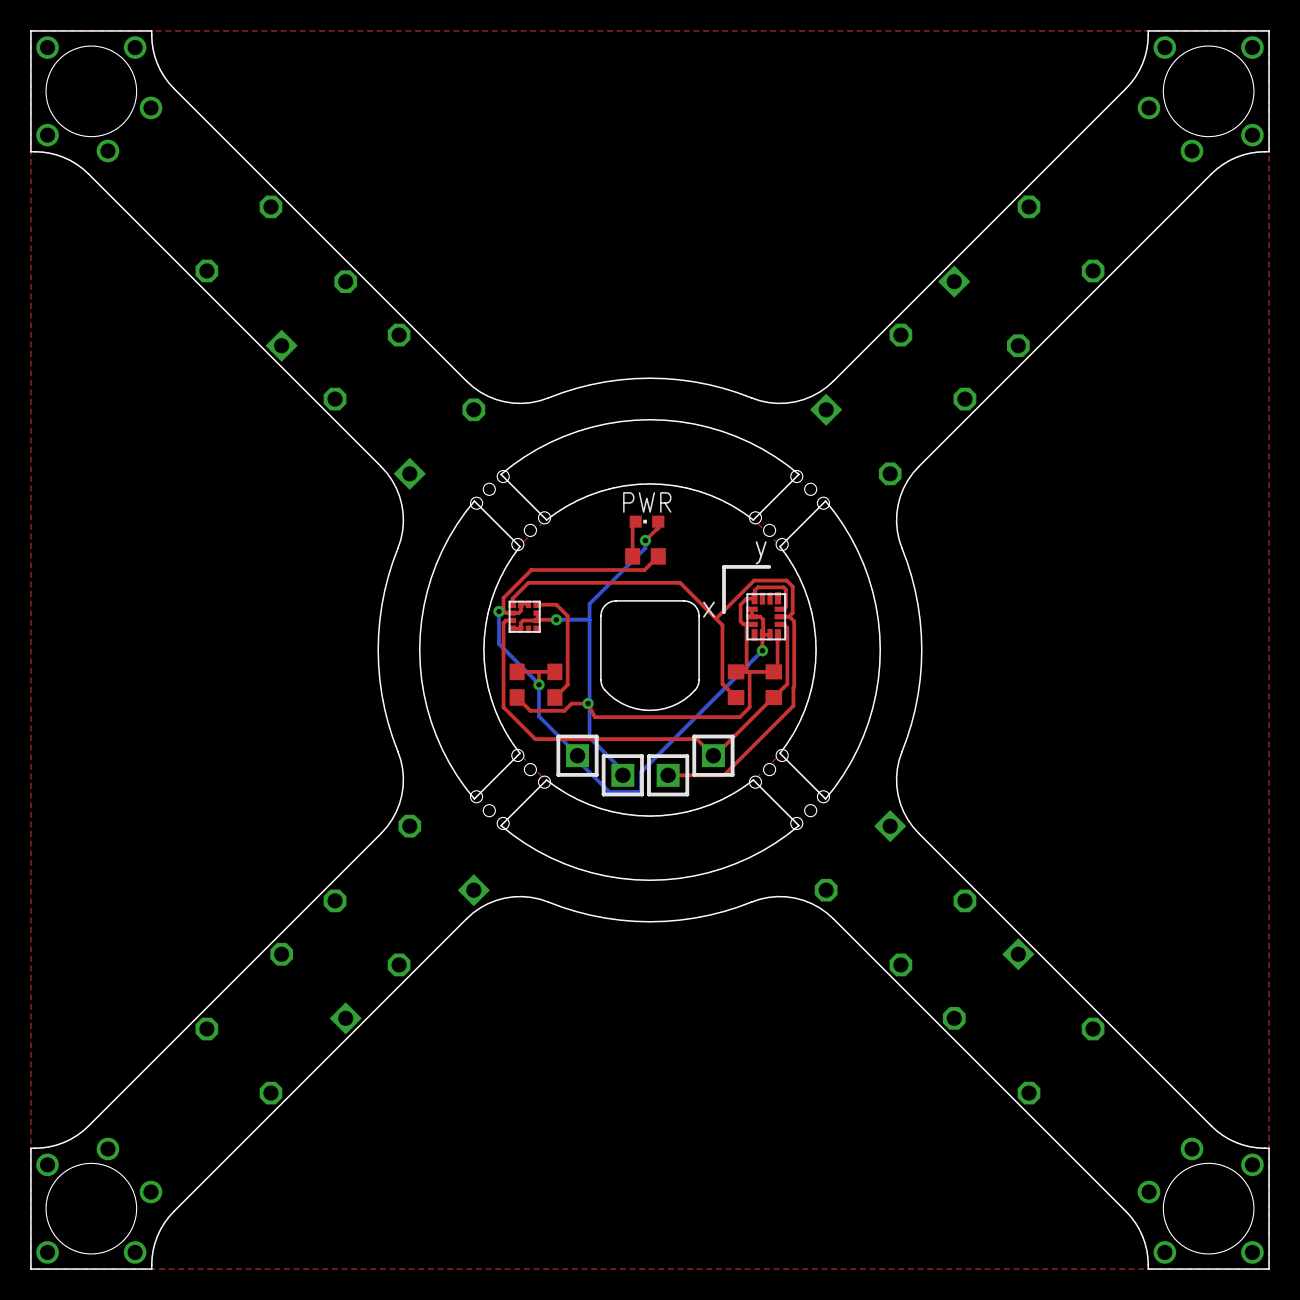
[picture p84: board CROSSMAG.brd from above]

Board: 2 copper layers, 82.0 x 82.0 mm, 20 parts (0 on the bottom side), 8 nets.

Parts:
3V3: 1X01
C1, C10: 0,1µ; C0603
GND: 1X01
LIS3MDL: LIS3MDL
LSM6DS3: LSM6DS3
PWR: CHIPLED_0603
R1: 2k; R0603
R101, R102: 5k1; R0603
SCL: 1X01
SDA: 1X01
U$1, U$2, U$3, U$4, U$18, U$19, U$20, U$21: KCONNECT-

Connections:
BUS+: U$1.1, U$1.2, U$1.3, U$1.4, U$3.1, U$3.2, U$3.3, U$3.4, U$18.1, U$18.2, U$18.3, U$18.4, U$20.1, U$20.2, U$20.3, U$20.4
BUS-: U$2.1, U$2.2, U$2.3, U$2.4, U$4.1, U$4.2, U$4.3, U$4.4, U$19.1, U$19.2, U$19.3, U$19.4, U$21.1, U$21.2, U$21.3, U$21.4
GND: C1.2, C10.2, GND.1, LIS3MDL.P$8, LIS3MDL.P$9, LIS3MDL.P$11, LSM6DS3.P$5, LSM6DS3.P$6, LSM6DS3.P$9, LSM6DS3.P$10, R1.1
unnamed: PWR.C, R1.2
unnamed: C10.1, LIS3MDL.P$7
SCL: LIS3MDL.P$10, LSM6DS3.P$13, R101.2, SCL.1
SDA: LIS3MDL.P$12, LSM6DS3.P$12, R102.2, SDA.1
VDD1: 3V3.1, C1.1, LIS3MDL.P$1, LIS3MDL.P$2, LIS3MDL.P$5, LIS3MDL.P$6, LSM6DS3.P$4, LSM6DS3.P$7, LSM6DS3.P$11, LSM6DS3.P$14, PWR.A, R101.1, R102.1
