CONZERN-ITS/can-cube-sat/src/research/stm32f4-ms-timer/stm32f4-ms-timer.ioc

Mcu.UserName=STM32F407VETx
PA0-WKUP.Signal=S_TIM2_CH1_ETR
PA10.Signal=USART1_RX
PA6.Signal=S_TIM3_CH1
PA7.Signal=S_TIM3_CH2
PA9.Signal=USART1_TX
PC14-OSC32_IN.Signal=RCC_OSC32_IN
PC15-OSC32_OUT.Signal=RCC_OSC32_OUT
PD12.Signal=S_TIM4_CH1
PD13.Signal=S_TIM4_CH2
PD2.Signal=S_TIM3_ETR
PE9.Signal=S_TIM1_CH1
PH0-OSC_IN.Signal=RCC_OSC_IN
PH1-OSC_OUT.Signal=RCC_OSC_OUT
