CONZERN-ITS/can-cube-sat/src/research/stm32f4-ms-timer/Core/Src/main.c

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

/* Includes ------------------------------------------------------------------*/
#include "main.h"

TIM_HandleTypeDef htim1;
TIM_HandleTypeDef htim2;
TIM_HandleTypeDef htim3;
TIM_HandleTypeDef htim4;

UART_HandleTypeDef huart1;

void SystemClock_Config(void);
static void MX_GPIO_Init(void);
static void MX_TIM2_Init(void);
static void MX_TIM4_Init(void);
static void MX_USART1_UART_Init(void);
static void MX_TIM3_Init(void);
static void MX_TIM1_Init(void);
/**
  * @brief  The application entry point.
  * @retval int
  */
int main(void)
{
  /* MCU Configuration--------------------------------------------------------*/

  /* Reset of all peripherals, Initializes the Flash interface and the Systick. */
  HAL_Init();

  /* Configure the system clock */
  SystemClock_Config();

  /* Initialize all configured peripherals */
  MX_GPIO_Init();
  MX_TIM2_Init();
  MX_TIM4_Init();
  MX_USART1_UART_Init();
  MX_TIM3_Init();
  MX_TIM1_Init();
  /* USER CODE BEGIN 2 */

  // TIM1 будет изображать PPS сигнал
  // поэтому с начала мы его тоже "взводим"
  __HAL_TIM_MOE_ENABLE(&htim1);
  __HAL_TIM_SET_COUNTER(&htim1, __HAL_TIM_GET_AUTORELOAD(&htim1));
  TIM_CCxChannelCmd(htim1.Instance, TIM_CHANNEL_1, TIM_CCx_ENABLE);


  // Включаем PWM выводы для всех таймеров, для того, чтобы пины
  // перешли в OUTPUT режим и ставим счетчик таймера
  // в предельное значение
  // При наших настройках (PWM MODE 1, POLARITY HIGH) это выводит PWM линию в 0
  // Но при этом таймер по пуску сразу же сгенерирует UPD событие и сбросится
  __HAL_TIM_SET_COUNTER(&htim2, __HAL_TIM_GET_AUTORELOAD(&htim2));
  TIM_CCxChannelCmd(htim2.Instance, TIM_CHANNEL_1, TIM_CCx_ENABLE);

  __HAL_TIM_SET_COUNTER(&htim3, __HAL_TIM_GET_AUTORELOAD(&htim3));
  TIM_CCxChannelCmd(htim3.Instance, TIM_CHANNEL_1, TIM_CCx_ENABLE);

  __HAL_TIM_SET_COUNTER(&htim4, __HAL_TIM_GET_AUTORELOAD(&htim4));
  TIM_CCxChannelCmd(htim4.Instance, TIM_CHANNEL_1, TIM_CCx_ENABLE);

  // Подождем чуть чуть, чтобы все PWM линии надежно опустились вниз
  // и все таймеры одновременно стартанули передним фронтом на своих PWM линиях
  HAL_Delay(10);

  // Запускаем все таймеры
  // именно в таком порядке
  __HAL_TIM_ENABLE(&htim2);
  __HAL_TIM_ENABLE(&htim3);
  __HAL_TIM_ENABLE(&htim4);


  // Через пол секунды стартует PPS сигнал
  HAL_Delay(500);
  __HAL_TIM_ENABLE(&htim1);
  /* USER CODE END 2 */

  /* Infinite loop */
  /* USER CODE BEGIN WHILE */
  while (1)
  {
    /* USER CODE END WHILE */

    /* USER CODE BEGIN 3 */
  }
  /* USER CODE END 3 */
}

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
