CONZERN-ITS/can-cube-sat/src/board/ARK/Core/Src/main.c

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
/* Includes ------------------------------------------------------------------*/
#include "main.h"

/* USER CODE BEGIN Includes */
#include <assert.h>
/* USER CODE END Includes */

ADC_HandleTypeDef hadc1;

I2C_HandleTypeDef hi2c1;
I2C_HandleTypeDef hi2c2;
DMA_HandleTypeDef hdma_i2c1_rx;
DMA_HandleTypeDef hdma_i2c1_tx;

IWDG_HandleTypeDef hiwdg;

UART_HandleTypeDef huart1;
DMA_HandleTypeDef hdma_usart1_tx;
DMA_HandleTypeDef hdma_usart1_rx;

void SystemClock_Config(void);
static void MX_GPIO_Init(void);
static void MX_DMA_Init(void);
static void MX_I2C1_Init(void);
static void MX_USART1_UART_Init(void);
static void MX_RTC_Init(void);
static void MX_I2C2_Init(void);
static void MX_ADC1_Init(void);
static void MX_IWDG_Init(void);
/* USER CODE BEGIN PFP */
extern void initialise_monitor_handles(void);
/* USER CODE END PFP */

/**
  * @brief  The application entry point.
  * @retval int
  */
int main(void)
{
  /* USER CODE BEGIN 1 */
  //initialise_monitor_handles();

  /* USER CODE END 1 */

  /* MCU Configuration--------------------------------------------------------*/

  /* Reset of all peripherals, Initializes the Flash interface and the Systick. */
   HAL_Init();

  /* Configure the system clock */
  SystemClock_Config();

  /* Initialize all configured peripherals */
  MX_GPIO_Init();
  MX_DMA_Init();
  MX_I2C1_Init();
  MX_USART1_UART_Init();
  MX_RTC_Init();
  MX_I2C2_Init();
  MX_ADC1_Init();
  MX_IWDG_Init();
  /* USER CODE BEGIN 2 */
  tmain();
  /* USER CODE END 2 */

  /* Infinite loop */
  /* USER CODE BEGIN WHILE */
  while (1)
  {
    /* USER CODE END WHILE */

    /* USER CODE BEGIN 3 */
  }
  /* USER CODE END 3 */
}

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
/* USER CODE BEGIN 4 */

int _write(int fd, char* ptr, int len)
{
    (void)fd;
    HAL_UART_Transmit(&huart1, (uint8_t *)ptr, len, 100);
    return len;
}

/* USER CODE END 4 */
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
