CONZERN-ITS/can-cube-sat/src/board/BCS/components/control_heat/Inc/control_heat.h

/*
 * control_heat.h
 *
 *  Created on: Aug 8, 2020
 *      Author: sereshotes
 */

#ifndef COMPONENTS_CONTROL_HEAT_INC_CONTROL_HEAT_H_
#define COMPONENTS_CONTROL_HEAT_INC_CONTROL_HEAT_H_

#include "shift_reg.h"

//#define CONTROL_HEAT_HIGHTHD 34.0
#define CONTROL_HEAT_LOWTHD (-5.0)
#define CONTROL_HEAT_UPDATE_PERIOD 10000 //ms
#define CONTROL_HEAT_RADIO_HIGH_THD 55.0
#define CONTROL_HEAT_RADIO_LOW_THD 50.0

int control_heat_init(shift_reg_handler_t *hsr, int shift, int task_on);

void control_heat_bsk_enable(int bsk_number, int is_on);

void control_heat_set_consumption(int id, int current);

void control_heat_set_max_consumption(int current);

#endif /* COMPONENTS_CONTROL_HEAT_INC_CONTROL_HEAT_H_ */
