CONZERN-ITS/can-cube-sat/src/board/BCS/components/sensors/Inc/sensors.h

/*
 * sensors.h
 *
 *  Created on: Aug 13, 2020
 *      Author: sereshotes
 */

#ifndef COMPONENTS_SENSORS_INC_SENSORS_H_
#define COMPONENTS_SENSORS_INC_SENSORS_H_

#include "esp_err.h"


esp_err_t sensors_init(void);



#endif /* COMPONENTS_SENSORS_INC_SENSORS_H_ */
