CONZERN-ITS/can-cube-sat/src/board/ARK/Application/Inc/task_battery_control.h

/*
 * task_battery_control.h
 *
 *  Created on: May 20, 2020
 *      Author: sereshotes
 */

#ifndef INC_TASK_BATTERY_CONTROL_H_
#define INC_TASK_BATTERY_CONTROL_H_



void task_battery_control_init(void *arg);

void task_battery_control_update(void *arg) ;

#endif /* INC_TASK_BATTERY_CONTROL_H_ */
