CONZERN-ITS/can-cube-sat/src/board/SINS/src/drivers/time_svc/time_svc.c

/*
 * time_svc.c
 *
 *  Created on: 7 апр. 2020 г.
 *      Author: snork
 */

#include "time_svc.h"

#include <stm32f4xx_hal.h>
#include <assert.h>
#include <drivers/time_svc/timers_world.h>
#include <errno.h>

#include "sins_config.h"

#include "rtc.h"
#include "time_util.h"
#include "timers_world.h"
#include "timers_steady.h"


//! Флаг для взаимодействия прерывания RTC и осоновного треда
static volatile int _time_svc_started = 0;

//! Метка времени последней коррекции
static uint64_t _last_correction_ts = 0;

static time_svc_timebase_t _time_base = TIME_SVC_TIMEBASE__NONE;


// Прерывание на RTC аларм для запуска таймеров службы времени
void RTC_Alarm_IRQHandler()
{
	// Немедленно пускаем таймеры!
	time_svc_world_timers_start();


	// Эта штука выключит все флаги, которые вызывают прерывание
	HAL_PWR_EnableBkUpAccess();
	HAL_RTC_AlarmIRQHandler(&hrtc);
	HAL_PWR_DisableBkUpAccess();


	_time_svc_started = 1;
}



static void _enable_alarm_irq()
{
	HAL_PWR_EnableBkUpAccess();
	__HAL_RTC_WRITEPROTECTION_DISABLE(&hrtc);

	__HAL_RTC_ALARM_ENABLE_IT(&hrtc, RTC_IT_ALRA);

	__HAL_RTC_WRITEPROTECTION_ENABLE(&hrtc);
	HAL_PWR_DisableBkUpAccess();


	// Включаем EXTI для аларма на Rising Edge
	EXTI->RTSR |= RTC_EXTI_LINE_ALARM_EVENT;
	__HAL_RTC_ALARM_EXTI_ENABLE_IT();
}



static void _disable_alarm_irq()
{
	HAL_PWR_EnableBkUpAccess();
	__HAL_RTC_WRITEPROTECTION_DISABLE(&hrtc);

	// глушим прерывания от RTC
	__HAL_RTC_ALARM_DISABLE_IT(&hrtc, RTC_IT_ALRA);

	__HAL_RTC_WRITEPROTECTION_ENABLE(&hrtc);
	HAL_PWR_DisableBkUpAccess();


	__HAL_RTC_ALARM_EXTI_DISABLE_IT();
}


int time_svc_world_preinit_with_rtc(void)
{
	int rc = 0;

	_time_base = TIME_SVC_TIMEBASE__NONE;
	// готовим RTC. По-хардкору или без. Нам нужно чтобы оно работало
	rc = time_svc_rtc_init();
	return rc;
}


int time_svc_world_preinit_without_rtc(void)
{
	_time_base = TIME_SVC_TIMEBASE__NONE;

	int rc = 0;
	rc = time_svc_world_timers_prepare();
	if (0 != rc)
		return rc;

	time_svc_world_timers_start();
	return 0;
}


int time_svc_world_init(void)
{
	int rc;
//
	_time_base = TIME_SVC_TIMEBASE__NONE;
//	// готовим RTC. По-хардкору или без. Нам нужно чтобы оно работало
//	int rtc_hardcore_start;
//	rc = time_svc_rtc_init(&rtc_hardcore_start);
//	if (0 != rc)
//	{
//		rc = time_svc_world_timers_prepare();
//		if (0 != rc)
//			return rc;
//	}

	// взводим таймеры
	rc = time_svc_world_timers_prepare();
	if (0 != rc)
		return rc;

	// загружаем время из rtc
	struct tm tm;
	rc = time_svc_rtc_load(&tm);
	if (0 != rc)
		return rc;

	// Добавим две секунды
	// выставим это время в таймеры службы времени
	// и поставим на будильник в RTC
	// По прерыванию будильника RTC пуляем таймеры

	// Будем изящны
	const time_t next_tt = mktime(&tm) + 2;
	const struct tm * next_tm = gmtime(&next_tt);

	// Загружаем это время в таймеры
	time_svc_world_timers_set_time(next_tt);
	// Загружаем это время в будильник А RTC
	rc = time_svc_rtc_alarm_setup(next_tm, RTC_ALARM_A);
	if (0 != rc)
		return rc;


	// Мы еще не запустились
	_time_svc_started = 0;

	// Разрешаем прерывания для таймера А
	_enable_alarm_irq();

	uint32_t start_tick = HAL_GetTick();
	// Ждем пока служба времени запустится
	while(0 == _time_svc_started)
	{
		// Если мы тут крутимся больше трех секунд - очевидно что-то не то
		if (HAL_GetTick() - start_tick > 3000)
		{
			// глушим прерывания от RTC
			_disable_alarm_irq();
			return -ETIMEDOUT;
		}
	}
	// Ок! Мы запустились!
	_last_correction_ts = time_svc_steady_get_time();

	_time_base = TIME_SVC_TIMEBASE__RTC;
	// глушим прерывания от RTC
	_disable_alarm_irq();

	return 0;
}


void time_svc_world_get_time(struct timeval * tv)
{
	time_svc_world_timers_get_time(tv);
}


int time_svc_steady_init(void)
{
	return time_svc_steady_timers_start();
}


uint64_t time_svc_steady_get_time(void)
{
	return time_svc_steady_timers_get_time();
}


void time_svc_world_set_time(time_t the_time, time_svc_timebase_t time_base)
{
	time_svc_world_timers_set_time(the_time);
	_last_correction_ts = time_svc_steady_get_time();
	_time_base = time_base;
}


uint64_t time_svc_last_adjust_timestamp(void)
{
	return _last_correction_ts;
}


time_svc_timebase_t time_svc_timebase(void)
{
	return _time_base;
}
