CONZERN-ITS/can-cube-sat/src/board/SINS/src/drivers/mems/lis3mdl.c

/*
 * lis3mdl.c
 *
 *  Created on: 7 дек. 2019 г.
 *      Author: developer
 */

#include "lis3mdl.h"

#include <stdint.h>
#include <errno.h>

#include <stm32f4xx.h>
#include <diag/Trace.h>

#include <stm32f4xx_hal.h>
#include <lis3mdl_reg.h>

#include "../common.h"
#include "mems.h"
#include "vector.h"



#define LSM_TIMEOUT	1000
#define MDPS_TO_RAD	M_PI / 180 / 1000

//	Magnetometer bias & transform matrix
#define X_MAGN_OFFSET		 0.000000
#define Y_MAGN_OFFSET		 0.000000
#define Z_MAGN_OFFSET		 0.000000
#define XX_MAGN_TRANSFORM_MATIX	 1.000000
#define YY_MAGN_TRANSFORM_MATIX	 1.000000
#define ZZ_MAGN_TRANSFORM_MATIX	 1.000000
#define XY_MAGN_TRANSFORM_MATIX	 0.000000
#define XZ_MAGN_TRANSFORM_MATIX	 0.000000
#define YZ_MAGN_TRANSFORM_MATIX	 0.000000


//	Magnetometer bias and transform matrix (to provide real values)
static const float offset_vector[3] = {X_MAGN_OFFSET, Y_MAGN_OFFSET, Z_MAGN_OFFSET};
static const float transform_matrix[3][3] = {
		{ XX_MAGN_TRANSFORM_MATIX, XY_MAGN_TRANSFORM_MATIX, XZ_MAGN_TRANSFORM_MATIX },
		{ XY_MAGN_TRANSFORM_MATIX, YY_MAGN_TRANSFORM_MATIX, YZ_MAGN_TRANSFORM_MATIX },
		{ XZ_MAGN_TRANSFORM_MATIX, YZ_MAGN_TRANSFORM_MATIX, ZZ_MAGN_TRANSFORM_MATIX }
};



typedef union{
  int16_t i16bit[3];
  uint8_t u8bit[6];
} axis3bit16_t;


typedef union{
  int16_t i16bit;
  uint8_t u8bit[2];
} axis1bit16_t;



static int32_t lis3mdl_write(void *handle, uint8_t reg, uint8_t *bufp, uint16_t len);
static int32_t lis3mdl_read(void *handle, uint8_t reg, uint8_t *bufp, uint16_t len);

static stmdev_ctx_t lis3mdl_dev_ctx = {
		.write_reg = lis3mdl_write,
		.read_reg = lis3mdl_read,
		.handle = &hmems_i2c
};


int mems_lis3mdl_init(void)
{
	int error = 0;
	uint8_t whoamI = 0;

	// Reset to defaults
	lis3mdl_reg_t reg;
	reg.ctrl_reg2.soft_rst = 1;
	error = lis3mdl_write_reg(&lis3mdl_dev_ctx, LIS3MDL_CTRL_REG2, &reg.byte, 1);
	if (error != 0)
		return error;
	// Check who_am_i
	error = lis3mdl_device_id_get(&lis3mdl_dev_ctx, &whoamI);
	if (whoamI != LIS3MDL_ID)
	{
//		trace_printf("lis3mdl not found, %d\terror: %d\n", whoamI, error);
		return -ENODEV;
	}

//	trace_printf("lis3mdl OK\n");


	error = lis3mdl_block_data_update_set(&lis3mdl_dev_ctx, PROPERTY_DISABLE);
	if (0 != error) return error;

	error = lis3mdl_data_rate_set(&lis3mdl_dev_ctx, LIS3MDL_HP_40Hz);
	if (0 != error) return error;

	error = lis3mdl_full_scale_set(&lis3mdl_dev_ctx, LIS3MDL_16_GAUSS);
	if (0 != error) return error;

	error = lis3mdl_operating_mode_set(&lis3mdl_dev_ctx, LIS3MDL_CONTINUOUS_MODE);
	if (0 != error) return error;

	return 0;
}


int mems_lis3mdl_get_m_data_mG(int16_t * data, float * magn)
{

	magn[0] = 1000 * LIS3MDL_FROM_FS_16G_TO_G(data[0]);
	magn[1] = 1000 * LIS3MDL_FROM_FS_16G_TO_G(data[1]);
	magn[2] = 1000 * LIS3MDL_FROM_FS_16G_TO_G(data[2]);


#if !CALIBRATION

	vmv(magn, (float*)offset_vector, magn);
	mxv((float(*)[3])transform_matrix, magn, magn);

	//	Change axes to be like in accelerometer FIXME: посмотреть в datasheet направление осей
//	float tmp = magn[0];
//	magn[0] = magn[1];
//	magn[1] = tmp;
//	magn[2] = -magn[2];
#endif

	return 0;
}


int mems_lis3mdl_get_m_data_raw(int16_t * data)
{
	int error;
	axis3bit16_t data_raw_magnetic;

	//	Read data
	error = lis3mdl_magnetic_raw_get(&lis3mdl_dev_ctx, data_raw_magnetic.u8bit);
	if (0 != error)
		return error;

	for(int i = 0; i < 3; i++)
		data[i] = data_raw_magnetic.i16bit[i];

	return 0;
}

static int32_t lis3mdl_write(void *handle, uint8_t reg, uint8_t *bufp, uint16_t len)
{
	HAL_StatusTypeDef hal_error;

	reg |= 0x80;
	hal_error = HAL_I2C_Mem_Write(handle, LIS3MDL_I2C_ADD_H, reg, I2C_MEMADD_SIZE_8BIT, bufp, len, LSM_TIMEOUT);
	if (hal_error != HAL_OK)
		return sins_hal_status_to_errno(hal_error);

	return 0;
}


static int32_t lis3mdl_read(void *handle, uint8_t reg, uint8_t *bufp, uint16_t len)
{
	HAL_StatusTypeDef hal_error;

	reg |= 0x80;
	hal_error = HAL_I2C_Mem_Read(handle, LIS3MDL_I2C_ADD_H, reg, I2C_MEMADD_SIZE_8BIT, bufp, len, LSM_TIMEOUT);
	if (hal_error != HAL_OK)
		return sins_hal_status_to_errno(hal_error);

	return 0;
}
