CONZERN-ITS/can-cube-sat/(commit log)

2019-11-19 Начата разработка ЦУП
2019-11-27 Поработала над настройками отображения и расположения. Начала заполнять настройки для графиков.
2019-12-05 Создан проект БИНС
2019-12-07 Добавил драйвера для датчиков
2019-12-07 начал писать lis3mdl
2019-12-14 Add drivers
2019-12-14 Add test code
    All needed drivers are here. But nothing works because it says i2c
    bus is busy. Why? IDK. Maybe bus is on low.
2019-12-14 I2C works (sometimes)
2019-12-21 All errors are fixed
    But it still doesn't work. Maybe it's problem of BME configuration.
    [bme280.c, main.c]
2019-12-21 BME280 works fine
    I think the main problem was that I2C descriptor was uninitialized
    local variable. So it was locked sometimes.
    Second problem was it's not BME280 but BMP280. So has another chipid
    and so program thought it's an error.
    [bme280.c]
2019-12-28 SINS: добавил библиотеки
2019-12-28 SINS: написал драйвер для lis3mdl
2019-12-28 Добавлен прием данных по MAVLink и чтение логов, переработана работа с данными
2019-12-28 SINS: начал делать main
2019-12-31 SINS: дописан main, реализован драйвер для lsm6ds3
2020-01-01 SINS: реализовано общение с бку по протоколу uart
2020-01-02 SINS: добавил либы для GPS
2020-01-04 Версия 2
2020-01-04 Это был тест
2020-01-04 Новые каталоги для конструкции
2020-01-06 Добавлено ТЗ на наземный комплекс управления
2020-01-07 Исправлены даты и ошибки в написании
2020-01-10 Схемы для презентации
2020-01-13 Version 0.05 Добавлен крепеж, сборки рекофигурированы в соответствии со спецификацией
2020-01-19 Version 0.06 Добавлены массы основным компонентам, добавлено упрощенное представление для расчета масс КА
2020-01-20 Version 0.07 Уточнены массы КА
2020-01-21 Version 0.08 Добавлен сборочный чертёж
2020-01-21 version 0.09 добавлен габаритный чертеж
2020-01-21 Свежая редакция ТЗ
2020-01-22 Version 0.10 Проработана плата ПН
2020-01-22 Version 0.11 Завершён сборочный чертеж
2020-01-22 Добавлены СБ и спецификация ДКА
2020-01-22 ТЗ не ограничивает бюджет
2020-01-23 Version 0.11a Дополнены основные надписи СБ и спецификации
2020-01-23 Дополнены основные надписи СБ и спецификации; исправлен косяк шрифта
2020-01-24 Добавлены принципиальные электрические схемы КА
2020-01-24 Version 0.12 ГЧ завершен
2020-01-24 Добавлен ГЧ
2020-01-25 Протоколы взаимодействия
2020-01-25 Version 0.13 исправлены ошибки СБ и ГЧ
2020-01-25 Исправлены ошибки ГЧ и СБ
2020-01-25 Переделан протокол взаимодействия
2020-01-25 Удалил прошлый протокол
2020-01-28 Добавлена эсхема БКУ
2020-01-29 Переименованы и реструктурированы документы на зимнюю сессию
2020-01-29 Исправлены опечатки в презентации
2020-01-30 Version 0.14 Добавлено упрощенное представление урезанного варианта КА
2020-02-02 презентация после ночных правок
2020-02-05 Реструктуризация: шаг 1
2020-02-05 Интеграция мавлинка
2020-02-05 Интеграция схем
    [BMS.brd, BMS.sch, BSK.brd, BSK.sch, BSK2.brd, BSK2.sch, BSK3.brd, BSK3.sch]
2020-02-05 Гитингор для игла
2020-02-09 Добавлен сабмодуль для esp-idf
2020-02-09 Version 0.15 Добавлены проставки
2020-02-10 Незначительные изменения
2020-02-10 Version 0.15a добавлены крепежные гайки
2020-02-10 Version 0.15b Внесены изменения в каркас; Удалены лишние итерации файлов модели
2020-02-11 Начало тестирования
2020-02-12 Version 0.15c добавлены поддержки в каркас
2020-02-12 Начало тестирования v2
2020-02-15 Version 0.15d добавлены правки в электромагниты(ЭМ), сделаны чертежи ЭМ
2020-02-18 Новые схемы
    [ARK.brd, ARK.sch, BMS.brd, BMS.sch, BSK2.brd, BSK3.brd, BSK5.brd, PCU.brd]
2020-02-18 Забыли в прошлый коммит
    [BMS.brd]
2020-02-18 изменения схемы АРК
    [ARK.brd, ARK.sch]
2020-02-19 Version 0.15e добавлено отверстие в ЭМ, обновлен его чертеж
2020-02-21 Добавлена схема отладочной платы (без кнопки)
    [Debug.sch]
2020-02-21 Добавлен gitignore
2020-02-21 Создали прект для нативного кода для RPi
2020-02-21 Кнопка на отладочной плате
    [Debug.brd, Debug.sch]
2020-02-21 Version 0.16 добавлен крепеж 1 камеры
2020-02-22 Добавлены библиотеки
2020-02-22 Initial CubeIDE project for stm32f103C8Tx
    That is base project made by CubeIDE with some enchantments.
    These are
    1. SWD debug does not become disabled after flashing MC.
    2. Add semihosting IO
    3. Add Application folder for your program that doesn't touch
    core or drivers.
    4. Add tmain function which is called in main from core
    [Time.c, Time.h, _initialize_hardware.c, ark.ioc, bme280.c, exception_handlers.c]
2020-02-22 Добавила функции для инициализации и сбора данных с магнитометра и акселерометра
2020-02-22 DS18B20 works (just one)!
    I will test it with multiple devices later
2020-02-22 DS18B20 works with multiple devices
2020-02-22 Добавлен БСК4, исправлены разъемы
    [BSK4.brd]
2020-02-25 изменен БСК4
    [BSK.brd, BSK.sch, BSK2.brd, BSK3.brd, BSK4.sch, BSK5.brd]
2020-02-25 Debug plata
    [Debug.brd, Debug.sch]
2020-02-25 изменен БСК1
    [BSK.brd, BSK.sch]
2020-02-26 Version 0.17 Добавлен второй USB-C на плату БКУ, внесены изменения в каркас
2020-02-28 Очередная дебажная плата
    [Debug.brd, Debug.sch]
2020-02-29 Исправил путь до сабмодуля (наконец-то)
2020-02-29 INA219 работает
    Я нашел баг в драйвере Кирилла в файле ina219.c строка 125. Кирилл
    полагал, что значение в даташите - это значение переменной Cal.
    Но в даташите написано, что Cal - значение регистра, а значит
    проводить дополнительные действия по сдвигу (значения переменной
    выравнивается не по нулевому биту, а по первому) нет нужды.
2020-02-29 Убраны магические числа
2020-02-29 Добавила strela-ms-rpi.c в CMakeLists.txt, исправила ошибки в strela-ms-rpi.c
2020-02-29 создала контекст для датчиков и интегрировала их функции из strela-ms-rpi.c
2020-02-29 доработана схема БСК1
    [BKU.sch, BSK.brd, BSK.sch, BSK2.brd]
2020-02-29 Поправлена настройка spi
2020-02-29 Version 0.17a доделано крепление камеры и магнитометра
2020-03-01 Косметика
2020-03-01 Был не прав, исправился. Теперь delay_us всегда инлайнится
    [Time.c, Time.h]
2020-03-01 Лучшие инклюды
2020-03-01 Реструктурированы сигналы коммутации для плат БСК
    [BSK.brd, BSK.sch, BSK2.brd, BSK2.sch, BSK3.brd, BSK3.sch, BSK4.brd, BSK4.sch]
2020-03-01 доработаны схемы БСК1 и БКУ
    [ARK.brd, ARK.sch, BKU.sch, BSK.brd, BSK.sch]
2020-03-02 Безумные приключения с lsm6ds3 отмечены в истории
2020-03-03 Проект для esp32 из шаблона
2020-03-03 Проект немного похож на проект для I2C
2020-03-04 Version 0.17b Завершен кронштейн видеокамеры с магнитометром
2020-03-04 Исправлены ошибки в плате АБ
    [BMS.brd, BMS.sch]
2020-03-06 Version 0.18 создан чертеж диска ЭМ, внесены правки в чертеж корпуса ЭМ
2020-03-06 Отладочная плата v2
    [Debug.brd, Debug.sch]
2020-03-06 обновлена схема БКУ
    [ARK.brd, ARK.sch, BKU.sch, BSK.brd]
2020-03-06 Отладочная плата v3
    [Debug.brd, Debug.sch]
2020-03-06 Version 0.18 разработка кронштейна камеры завершена
2020-03-07 Теперь функции из С принимают контекст целиком, довела до рабочего состояния lsm6ds3 и до полурабочего lis3mdl
2020-03-07 Исправление ошибки с предыдущим комитом
    [main.py]
2020-03-07 Исправлен lis3mdl
2020-03-07 SINS пересел на I2C
2020-03-07 Добавлены светодиоды на платы БСК
    [ARK.brd, ARK.sch, BKU.sch, BSK.brd, BSK.sch, BSK3.brd, BSK3.sch, BSK4.brd]
2020-03-08 Разведена БСК1
    [BSK.brd]
2020-03-08 Разведены платы БСК2-5
    [BSK.brd, BSK2.brd, BSK2.sch, BSK3.brd, BSK4.brd, BSK5.brd]
2020-03-08 передача данных между контроллерами по i2c в каком-то виде работает
2020-03-09 i2c-link более менее работает, но не слишком стабильно :c
2020-03-09 Навел порядок в папках
2020-03-09 Блокировка i2c халом подперта костылём
2020-03-09 i2c-link оформлен как общий драйвер и проверен к сборке для stm32f4 и stm32f1
2020-03-09 Потерялось к прошлому коммиту
2020-03-10 Посмотрел плату БСК1, немного поправил и разместил шелкографию
    [BSK.brd, BSK.sch]
2020-03-10 Незначительные изменения в платах БСК1 и АРК
    [ARK.brd, ARK.sch, BSK.brd, BSK.sch]
2020-03-11 В плате АРК разведены дорожки групп BMS и всех DC-DC. Остался МК и его обвес
    [ARK.brd, ARK.sch]
2020-03-11 В плате АРК разведено еще больше дорожек - до 99%. Надо заменить МК или подключить текущий МК к GND
    [ARK.brd, ARK.sch]
2020-03-12 Разведена плата АРК
    [ARK.brd, ARK.sch]
2020-03-13 Плата АРК проложена на 76%
    [BSK.brd, BSK.sch]
2020-03-13 Разведена плата БСК1
    [ARK.brd, ARK.sch, BSK.brd, BSK.sch]
2020-03-14 Добавила сообшения Termal state и Electrical state
2020-03-14 Добавлена плата SPIDER
    [BKU.brd, BSK.brd, BSK2.brd, BSK2.sch, BSK3.brd, BSK3.sch, BSK4.brd, BSK4.sch]
2020-03-14 Добавила WMM и код для нее
2020-03-14 Добавлена плата CROSS
    [CROSS.brd]
2020-03-14 Исправлено ишью, открытое Василием
    [ina219_helper.c, ina219_helper.h, tmain.c]
2020-03-14 Добавлен симлинк на мавлинк
2020-03-14 Добавлен код, объединяющий отправку данных
    Добавены файлы data_*, которые обобщают инициализацию, считывание
    и отправку данных по i2c/mavlink.
2020-03-14 Подписаны разъемы на платах
    [BSK.brd, BSK2.brd, BSK2.sch, BSK3.brd, BSK4.brd, BSK5.brd, BSK5.sch]
2020-03-14 Добавлены платы СБ
    [SP.brd, SP.sch]
2020-03-14 lsm6ds3 работает. Ура, товарищи! А GPS нет(
2020-03-14 Version 0.19 Внесены изменения в конструкцию по результатам печати
2020-03-15 Логическая схема для сбросом и управление бутлоадером ESP32 на отладочной плате.
    [Debug.brd, Debug.sch]
2020-03-15 lis3mdl работает
2020-03-15 С АРКом всё плохо. Надо снова переделывать(
    [ARK.brd, ARK.sch]
2020-03-15 Внёс незначительные правки на платах. Но пока не везде
    [BSK.brd, BSK2.brd, BSK2.sch, Debug.brd, Debug.sch]
2020-03-16 Version 0.20 Модель krepej (Адаптер) подготовлена для печати
2020-03-17 Исправлен АРК
    [ARK.brd, ARK.sch]
2020-03-17 Version 0.20 внесены изменения в конструкцию наземки
2020-03-17 Добавлен драйвер для дигипода
2020-03-17 Код, собирающий АРК воединно (и BMS)
    Готов код, собирающий все части воединно. Реализовано получение
    данных от устройств, удобное хранение в одном месте с помощью
    структуры BatteryBanch. Данные обрабатываются и обновляется состаяние
    цифровых потеницометров и силовых ключей.
    Модуль Battery нужен для структурированного хранения данных, удобного
    обращения к устройствам и быстрого конфигури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
2020-03-18 Version 0.20 качественно внесены изменения в наземку
2020-03-18 GKS: добавлены концевики и честные шестерни
    [Gear-horzontal-large.stp, Gear-horzontal-small.stp, Gear-vertical-large.stp, Gear-vertical-small.stp]
2020-03-18 Добавлена плата MAG
    [BKU.brd, BKU.sch, MAG.brd, MAG.sch]
2020-03-20 Сделано прерывание для GPS
2020-03-20 Исправлены компоненты
    [ARK.brd, ARK.sch, BKU.brd, BKU.sch, BSK.brd, BSK.sch, MAG.brd]
2020-03-20 Начата работа над обработкой сообщений с GPS
2020-03-20 Нзначительные изменения БКУ
    [BKU.brd, BKU.sch]
2020-03-20 Version 0.20a внесены изменения в конструкцию наземки
2020-03-20 Незначительные изменения БКУ
    [BKU.brd, BKU.sch]
2020-03-21 Чуть-чуть поправил АРК
    [ARK.brd]
2020-03-21 Добавлена плата RADIO
    [BKU.brd, BKU.sch, RADIO.brd, RADIO.sch]
2020-03-21 Плата СБ
    [SP.brd, SP.sch]
2020-03-21 Написана обработка сообщений с gps (данный функционал ожидает тестирования)
2020-03-21 Плата СБ готовая
    [SP.brd]
2020-03-21 Внесены косметические изменения на БСК2 и БСК3
    [BSK2.brd, BSK3.brd, BSK3.sch]
2020-03-21 Незначительные изменения АРК
    [ARK.brd]
2020-03-23 Платы подготовлены для Резонита
    [BSK.brd, BSK.sch, BSK2.brd, BSK2.sch, BSK3.brd, BSK3.sch, BSK4.brd, BSK4.sch]
2020-03-23 Version 0.20 продолжены работы по конструкции наземки
2020-03-24 Пытаем плату БКУ компоновкой
    [BKU.brd, BKU.sch]
2020-03-24 Изменения в компоновке БКУ
    [ARK.brd, ARK.sch, BKU.brd]
2020-03-25 Начало тестирования gps
2020-03-25 GKS: доп файлы
2020-03-25 Изменения в БКУ
    [BKU.brd, BKU.sch]
2020-03-25 GKS: допиливается конструкция, изменены размеры платы под радио
    [RADIO.brd]
2020-03-26 Исправлены АРК и БСК1
    [ARK.brd, ARK.sch, BSK.brd, BSK.sch]
2020-03-26 Добавлена батарейка в БКУ
    [BKU.brd, BKU.sch]
2020-03-27 Реализована отправка сообщений различной длины
    Взаимодействие работает так.
    esp: вот тебе команда
    stm: ок, выполню, когда ты запросишь что-то еще
    esp: запрашиваю
    stm: вот, что ты хотел
    Работает не идеально быстро, но если пакеты сделать достаточно большими,
    то проседание по скорости будет не заметно.
    На esp есть драйвер взаимодействия с арком.
    На арке есть драйвер может отвечать на все зап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
2020-03-28 Плата SP
    [SP.brd]
2020-03-29 Несколько новых библиотек
2020-03-29 Исправлена ошибка в библиотеке
2020-03-29 GKS: добавлены отверстия под гайки
2020-03-29 GKS: Добавлен второй драйвер ШД. Проведена перекомпоновка
2020-03-29 GCS: Повышена детализация Raspberry Pi
2020-03-29 GKS:Добален USB-UART. Проведена перекомпоновка
2020-03-30 GKS: изменены размеры sm-driver
2020-03-30 GPS работает
2020-03-30 вот теперь точно работает
2020-03-30 GKS: Вернул потерянные корпуса наземки
2020-03-30 GKS: Добавлена модель выключателя
2020-03-30 Разводка БКУ кроме 1 дорожки к есп (RX-R)
    [BKU.brd, BKU.sch]
2020-03-30 Поменяла распложение mavlink сообщений, добавила сообщения для gps, изменила id
2020-03-30 На плате БКУ проведена дорожка RX-R
    [BKU.brd]
2020-03-30 Реструкторизация для того, чтобы не было каши в будущем
2020-03-30 Готовый модуль работы со временем
    Основные функции задания и получения времени пародируют аналогичные
    из стандартной библиотеки.
    Основные часы для хранения времени используют милисекундную точность.
    Также имеются микросекундные часы для точных вычислений. Они не
    рекомендуются для использования на длительные периоды времени.
2020-03-30 Добавлены комментарии к функциям
2020-03-30 GKS: поправлены некоторые размеры, добавлены акселерометр, магнитометр и разъемы под них
2020-03-31 Добавлены подтяжки i2c
    [ARK.brd, ARK.sch, BKU.brd, BKU.sch, BSK.brd, BSK.sch]
2020-03-31 Применение замечаний Василия
2020-03-31 Добавлена схема АС, исправлена плата RADIO
    [RADIO.brd, RADIO.sch]
2020-03-31 GKS: Детализированы модели повышающего и понижающего DC-DC преобразователей
2020-03-31 GKS: изменения в размерах, местах крепления
2020-03-31 Добавлены датчики
    [Grove - Gas Sensor(O2) v1.1.brd, Grove - Gas Sensor(O2) v1.1.sch]
2020-03-31 GKS: Добавил актуальную плату GPS NEO-6M, переделал упоры шетеренки для концевиков
2020-03-31 GKS: Добавил третью АБ, опустил АБ на 3 мм и поправил нижний подшипниковый узел
2020-04-01 Исправлены RADIO и диоды
    [BKU.brd, BSK.brd, BSK.sch, BSK2.brd, BSK2.sch, BSK3.brd, BSK3.sch, BSK4.brd]
2020-04-01 Попытка сделать время
2020-04-01 Резисторы у FS8205A 100Ом
    [ARK.brd, ARK.sch, BSK.brd, BSK.sch, BSK2.brd, BSK2.sch, BSK3.brd, BSK3.sch]
2020-04-01 Попытка сделать время v2
2020-04-01 GKS: поставлена новая GPS
2020-04-01 Некоторые изменения в sourse + начата итреграция каты
2020-04-01 Добавлен проект с отработкой таймера
2020-04-01 БЫСТРОФИКС
2020-04-01 GKS: Доавлена втулка для подшипникового узла, доработана шестерня, внесены косметические правки
2020-04-01 Попытка сделать время v3 (работают master и slave таймеры)
2020-04-02 Добавлена плата TOGETHER
    [TOGETHER.brd]
2020-04-02 GKS: сделаны вырезаыы под платами, праставки raspberry pi, очередные вырезы под гайки
2020-04-02 Добавлены герберы плат
2020-04-02 GKS: Детализированы некоторые платы, увеличены размеры корпуса
2020-04-02 GKS: Быстрый фикс
2020-04-02 Исправлены MAG и BSK1
    [BSK.brd, BSK.sch, MAG.brd, MAG.sch, TOGETHER.brd]
2020-04-03 Схема разводки PPS и работы с ним
2020-04-03 Тест проект для работы с PPS
2020-04-03 Добавлен пакет SINS_isc, внесены исправления в названия пакетов
2020-04-04 HEARTBEAT перенесен в отдельный файл common, туда же добавлены использующиеся в нем множества
2020-04-04 GKS: поменя ны отверстия под GPS, магнетометром, акселерометром; примерно поставлен выключатель
2020-04-04 BugFix инклюд теперь стоит там, где должен
2020-04-04 GKS: Добавлена модель разъема пигтейла
2020-04-04 GKS: добавлен пигтейл, переключатель, сделаны правки в размерах креплений
2020-04-04 Добавлен micro-USB на АРК
    [ARK.brd, ARK.sch]
2020-04-04 Новый проект для настройки RTC по GPS
2020-04-04 Ой, ничайно коммитнул лишнего
2020-04-04 Мучаем мавлинк
2020-04-04 Маджвик начало
2020-04-04 pymavlink батник для сборки на винде
2020-04-04 Доделаны маркеры, добавлена ломаная линия
2020-04-04 Начата работа над интеграцией карты
2020-04-04 GKS: внесены правки по критике
2020-04-04 Настройка RTC (без PPS) почти готова. Нужно только внимательно продумать момент с гонкой между обработкой пакетов и PPS
2020-04-05 Добавлены новые диоды
    [BKU.brd, BKU.sch, BSK.brd, BSK.sch, BSK2.brd, BSK2.sch, BSK3.brd, BSK3.sch]
2020-04-05 pymavlink сихнронизирован с основным репозиторием
2020-04-05 Мавлинк нужно пересобрать! Назначены уникальные идентификаторы для ITS Mavlink сообщений
2020-04-05 Упс, теперь точно уникальные идентификаторы
2020-04-05 Обновлены герберы плат
    [ARK.brd, HEAT.brd]
2020-04-05 Незначительные изменения БСК1
    [BKU.brd, BKU.sch, BSK.brd, BSK.sch]
2020-04-05 Демка проекта для esp с концептом маршрутизатора
2020-04-06 GKS: поправлены размеры отверстия смещений
2020-04-06 GKS: поправки по критике
2020-04-06 Создана плата HEAT
    [HEAT.brd, HEAT.sch]
2020-04-07 Исправлены слои в HEAT
    [HEAT.brd]
2020-04-08 Убрали лишнее из SINS проекта. Добавили не лишнее
2020-04-08 gps драйвер более менее готов
2020-04-08 Начал добавлять службу времени
2020-04-08 RTC для службы времени причесывается
2020-04-08 Что-то похожее на запуск службы времени SINS от RTC
2020-04-08 Рокировка файлов по местам
2020-04-08 Лишнее
2020-04-08 Исправил пути до мавлинка и добавил инклюд на него в мейн
    [main.c]
2020-04-08 Грязь и опечатки
2020-04-08 очень много причесывания
2020-04-08 Убрана тонна ассертов из службы времени
2020-04-08 разбор NAV-SOL пакета UBX
2020-04-08 Доведено до сборки
2020-04-08 GKS: сделаны крепления всех элементов АС, поправки по критике
2020-04-08 Оказывается не все что выглядит лишним - есть лишнее
    В файле Timer.c, удаленном в 87bec140ff424c2dc42afb88e1ae4eaf4664d632
    был вызов HAL_IncTick() в прерывании SysTick таймера. Из-за его пропажи
    HalDelay перестало работать. Пришлось его вернуть
2020-04-08 Омерзительная ошибки в функция преобразования времен
2020-04-08 В файле Timer.c, удаленном в 87bec140ff424c2dc42afb88e1ae4eaf4664d632 был вызов HAL_IncTick() в прерывании SysTick таймера. Из-за его пропажи HalDelay перестало работать. Пришлось его вернуть
2020-04-08 Новая конфигурация проекта для сборки под F407
2020-04-08 Исправлены ошибки по отладке RTC
    [main.c, rtc.c, time_svc.c, time_svc.h]
2020-04-08 GKS: Внес корректировки в размеры отверстий для крепления
2020-04-09 Еще один вариант роутинга
2020-04-09 Служба времени разбита на две части - мировое время и стабильное время
2020-04-09 Настройки NVIC перенесены в MSP
2020-04-09 Синхронизация времени по GPS
2020-04-10 Теоретически fixes #17
2020-04-10 Поддержка ack/nack ubx пакетов
2020-04-10 Сделана и отлажена конфигурация GPS. closes #16
2020-04-11 Завершена интеграция карты
2020-04-11 GKS: сделаны крепление всех элементов АС, защита от попадание в механическую передачу, отверстия для установки редукторов при зацеплении
2020-04-11 GKS: Возвращаю утерянное
2020-04-11 Маджвик вроде работает
2020-04-11 Добавила сообщение для времени TIMESTAMP + множество TIME_BASE_TYPE, изменила время в TERMAL_STATE, ELECTRICAL_STATE сообщениях, изменила описания в этих же сообщениях
2020-04-11 Заменила милисекунды на микро-, изменила время sins_isc на единое для всех сообщений
2020-04-11 GKS: исправления по критике, + защита шестерени доделана
2020-04-11 Обновление esp-idf до 4.2
2020-04-12 Клиент-сервер реализация с esp32 и linux
    В данной реалтзации сервер в виде линукс броадкастит сообщения
    всем, кто находится в одной сети с сервером. Клиент в виде
    esp32 получает пакет, выясняет из него ip адрес сервера и
    отпрвляет тому сообщения. Для такой реализации и клиенту и
    серверу должны быть известны порты друг друга. При этом им не
    нужно знать ip адреса друг друга с самого начала. Это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
2020-04-12 Перемещение route в драйвер
2020-04-13 GKS: доделана защита шестерни
2020-04-13 Реализован SNTP клиент и добавлен .gitignore
2020-04-13 Плата SPv2
    [SP.brd, SP.sch]
2020-04-13 Плата SPv3
    [SP.brd]
2020-04-13 Сделаны платы ADAPT и SPIDERADAPT, создана плата PL
    [ADAPT.brd, ADAPT.sch, CROSSMAG.brd, PL.sch, SPIDERADAPT.brd]
2020-04-14 SC: Изменена конструкция солнечной батареи
2020-04-14 Плата TESTPL
    [PL.brd, TESTPL.brd, TESTPL.sch]
2020-04-14 Разработана схема подключения датчиков полезной нагрузки. Closes #18
    [PL.sch]
2020-04-15 GKS: еще небольшие поправки
2020-04-15 GKS: Оптимизированы скругления и фаски корпусных деталей
2020-04-15 Добавлена забытое разрешение доступа к бекап домену при настройке RTC
2020-04-15 То, что должно работать, но не работает
2020-04-15 Вроде переделал на LSI
2020-04-15 Возможна работа RTC на LSI и принудительный сброс бекап домена для SINS
2020-04-15 Исправлена плата TESTPL
    [BKU.brd, PL.brd, PL.sch, TESTPL.brd, TESTPL.sch]
2020-04-15 Разведена плата PL
    [PL.brd, PL.sch]
2020-04-15 Исправила название, распределила классы файла source.py по нескольким файлам, сменила способ получения путей к файлам
    [data_control.py, graph_widget.py, main.py, map_widget.py, model_widget.py]
2020-04-15 Добавила requirements.txt
2020-04-15 Убрала лишний print
2020-04-15 Обновлены архивы плат
2020-04-15 Незначительные изменения TESTPL
    [TESTPL.brd]
2020-04-16 SC: Внесены изменения в моделях по результатам 3D печати
2020-04-16 Исправлена ошибка в преобразовании unix time -gps time и ошибка при запуске таймера 2
    [time_util.c, timers_world.c]
2020-04-17 SC: сделана упрщенная модель GKS: заменен драйвер двигателя и его крепление
    [general_assembly_sw0001.stl]
2020-04-17 GKS: Восстановлены привязки копированной геометрии проставки DC-DC
2020-04-17 Корректная обработка флагов корректности в gps сообщение gps time. Учёт липосекунд при заборе времени от GPS
2020-04-17 Обновлен гербер RADIO
    [RADIO.brd]
2020-04-18 Обновление проекта для настройки RTC под новые липосекундные реалии
2020-04-18 На плату полезной нагрузки добавлены управляемые резисторы для управления балансирующими сопротивлениями для газового датчика
    [PL.brd, PL.sch]
2020-04-18 SC: поправлена упрощенная модель
    [general_assembly_sw0001.stl]
2020-04-18 Начато добавление виджета с моделькой
    [general_assembly_sw0001.stl]
2020-04-18 Доработана плата БКУ
    [BKU.brd, BKU.sch, PL.brd]
2020-04-18 Исправлено неверное добавление виджетов на главное окно
    [source.py]
2020-04-18 Плата SP с колодками
    [SP.brd, SP.sch]
2020-04-18 Синхронизация времени и IMI
    ESP32 теперь может синхронизироваться по времени с одним из ntp
    сервером. Также, он может синхронизировать всех, кто свзяан с ESP32
    по интерфейсу IMI.
    IMI (I2C messaging interface) - новосозданный интерфейс, написанный
    изначально для взаимодействия АРКа с ESP32 по I2C. Он обеспечивает
    передачу сообщений от slave к master и обратно с использованием
    дополнительной шины I2C_INT. Также допол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
2020-04-18 Доработана функция приема данных в ModelWidget
2020-04-18 Исправление предыдущего коммита
2020-04-18 Изменения в подключении мк
    [ARK.brd, ARK.sch, BKU.brd, BKU.sch, PL.brd, PL.sch]
2020-04-18 Добавлены настройки в виджет модельки
2020-04-18 Убрала лишнее в MapWidget
2020-04-18 GKS: замена драйвера DM422
2020-04-18 Обновлены герберы АРК, БКУ и ПН
2020-04-19 SC: Разработана 3D модель для наземки
    [CanCubeSat-for-GKS.stl, general_assembly_sw0001.stl]
2020-04-19 Внешняя плата СБ утверждена с незначительными правками
    [SP.brd]
2020-04-19 Выложены вспомогательные модели для создания DXF файлов Eagle
    [cross_n_mag.dxf, solar_inter_plata.dxf]
2020-04-19 Гербер SP
    [SP.brd]
2020-04-19 Внутренняя плата СБ
    [SPinner.brd, SPinner.sch]
2020-04-19 Внутренняя плата СБ v2
    [SPinner.brd]
2020-04-19 Гербер SPinner
    [SPinner.brd]
2020-04-19 GKS: сделаны отверстия под соединения
2020-04-20 Обновлен гербер SPinner
    [SPinner.brd, SPinner.sch]
2020-04-20 Обновлена схема АС
2020-04-21 Таймеры работают
2020-04-21 Работа с handmade pps
2020-04-21 Прерывание работает
2020-04-22 Обновлен гербер SPIDERADAPT
2020-04-22 Теперь наземка может принимать its телеметрию (3 вида пакета) + данные можно добавлять группами по несколько за раз
2020-04-22 Добавлены настройки для отображения its телеметрии + настройка пути до модельки
2020-04-22 Добавил pyserial утилиту для перенаправления данных из uart в tcp
2020-04-22 Утилита улучшена
2020-04-22 Снова улучшена
2020-04-22 Добавлены утилиты для сборки mav сообщений из разных tcp каналов в один. Собрано на коленке. Косметика в like-a-socat.py
2020-04-22 !Внимание, исправлено название сообщения THERMAL_STATE
2020-04-22 Добавлена утилита для приема сообщений mavlink. Утилита получает сообщение и информирует о том, какое сообщение и когда получено
2020-04-23 Обновила обработчик данных
2020-04-23 Подготовка к совместным испытаниям
2020-04-23 Изменен путь до папки с логами
2020-04-23 К предыдущему коммиту
2020-04-24 GKS: добавлены поддержки для печати
2020-04-24 Добавлено пояснение к SINS_isc
2020-04-24 Поправил оси (должны совпадать с осями аппарата)
2020-04-25 Моделька полностью интегрирована в виджет модельки
    [CanCubeSat-for-GKS.stl, general_assembly_sw0001.stl]
2020-04-26 Добавлены множества для нумерации систем и компонентов систем
2020-04-27 Приделала кнопку сброса времени и сброса данных
2020-04-27 Исправление неверного пути до файла с цветами
    [model_widget.py]
2020-04-27 Попытка исправить кнопку сброса времени
    [source.py]
2020-04-28 Добавлена поддержка графиками нескольких пакетов
2020-04-28 Добавлена поддержка RGBA для графиков + настройки к предыдущему коммиту
2020-04-28 Убраны лишние принты
2020-04-28 Исправлено условие обработки всех пакетов
    [graph_widget.py]
2020-04-28 Добавлена функция удаления первых N точек ломаной + добавлна возможность отображения последних N точек
2020-04-28 Исправления в map.js
2020-04-29 GKS: поправлены поддержки
2020-04-29 Небольшие изменения для повышения читабельности + выбор цвета фона модельки + настройки к предыдущим коммитам
2020-04-29 Начала создание нового виджета + исправление кнопки сброса времени
    [data_widget.py, source.py]
2020-04-30 GKS: поправлены привязки
2020-05-01 GKS: Выполнены поддержки для печати, адаптированы посадочные размеры под подшипники
2020-05-02 Проведены работы по оптимизации обработки данных
2020-05-02 Закончен новый виджет + Переделаны цвета
2020-05-06 Теперь виджет модельки просматривает пакеты с конца для более быстрого поиска нужного
2020-05-06 Изменения для поддержки Windows
2020-05-06 Обновление requirements.txt
2020-05-06 Обновление основных проектов, uart в esp32, подготовка к интеграционному тесту
    Следуя советам Василия, приступаю к обновлению основных проектов.
    Обновлен проект ARK по образу и подобию проекта из research
    i2c-slave. Проект BCS (БКУ) - проект esp32-wifi-что-то-там.
    Ожидается серьезный рефакторинг кода, объединяющего все и вся в арке,
    так как он выглядит жутко. У esp32 все по мелочам.
    Так как я забыл сделать к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
2020-05-06 Код на момент совместного тестирования
2020-05-06 Рефакторинг IMI для удобной работы (без теста)
    Теперь для каждого i2c устройства можно установить свое imi
    устройство отдельно. Также теперь есть защита для синхронизации.
2020-05-06 Рефакторинг арка (не работает)
    Теперь есть псевдо-таски для всего нужного. Конечно, реализация
    хромает, но она работает (точнее, работала до недавнего времени).
    Сейчас не работает, так как места не хвататет. Но почему?
2020-05-06 Одобренные партией правки энумераторов программных компонентов
2020-05-06 requirements.txt: исправлено = на == + версии изменены на более ранние для совместимости с виртуалкой
2020-05-07 Небольшие изменения
2020-05-09 Добавлена модель осей axis.stl для наземки
    [axis.stl]
2020-05-10 GKS: начало оснастки
2020-05-13 Добавление стандартной привязки ко времени
2020-05-13 инициализация и настройка GPS включены в главный цикл. Конфигурация NEO-7 изменена - включено сообщение NAV-SOL
2020-05-13 Исправления в работе с моделью
2020-05-13 Добавление математической модели
2020-05-13 Добавление requirements.txt + к предыдущему коммиту
2020-05-13 Исправлена ошибка при разборе пакета NAV_SOL. Обновлен пакет NAV_SOL
    [main.c, mav_packers.c]
2020-05-13 Продолжение работ над оснасткой ЭМ
2020-05-14 Продолжения работ над оснасткой ЭМ ch_2
2020-05-17 Удалил старые файлы. Они переехали в ./drivers
2020-05-17 Заменил все на пробелы. Твоя взяла, Сергей
2020-05-17 Проект для платы полезной нагрузки
2020-05-17 Первые наброски для софта платы полезной нагрузки
2020-05-19 GKS: Корректировка моделей и их поддержек для печати на 3D принтере
2020-05-19 GKS: Вдогонку
2020-05-20 Рабочая версия (не считая времени)
    АРК читает данные ds и ina, кидает на БКУ, тот их перекидывает
    на наземную станцию, где эти данные нормально интерпретируются.
2020-05-20 Стартовый код для управления батарями
    Добавлен таск, который должен отключать и включать ряды батарей
    в зависимости от температуры. Также он должен изменять напряжение
    на dc-dc, в зависимости от напряжений на шине.
2020-05-20 Маленький фикс проверки валидности напряжений
2020-05-20 Полезная нагрузка вся в процессе
2020-05-20 Утилиты для генерации конфигурации u-blox
2020-05-20 RTC работает
2020-05-21 Продолжение работ над оснасткой ЭМ ch_3
2020-05-23 Исправлено поведение графиков при nan
    [graph_widget.py]
2020-05-23 Добавлен разбор данных gps
2020-05-23 Начата работа над улучшением модельки
2020-05-23 Начало переноса загрузчика для gps в другой проект
2020-05-27 Исправлен страшный косяк!
    [axis.stl]
2020-05-28 Доделаны сообщения модуля полезной нагрузки
2020-05-28 Добавлены сообщения полезной нагрузки и собственной температуры вычислителей
2020-05-29 Оказывается единицы измерения в .xml файле мавлинка идут в код. Поэтому ненадо там писать всякие изыски
2020-05-29 Налажена работa printf в консоль отладчика
2020-05-30 Изменения в структуре main.py
2020-05-30 Добавила установку в CMakeLists.txt
2020-05-31 Настройка gps перенесена
2020-05-31 Ну, вроде разобрались с ацп и управлением делителями
2020-05-31 Внутренний термистор теперь тоже можно опрашивать
2020-05-31 Посчитал коэффициенты для mics6814
2020-06-01 GKS: Исправлена модель по результатам печати
2020-06-01 Управление резисторами уходит к датчику а не в общий аналог
2020-06-01 драйвер mics6814 теперь более менее на что-то похож
2020-06-01 Максимум упрощения для mics6814. Все это было лишнее имхо
2020-06-02 me2o2 вроде готов?
2020-06-02 bme280 отлажен. Все работает кроме высоты (она еще не доделана) Ну и еще всякие оформительские мелочи и опечатки
2020-06-02 me2o2... отлажен?
2020-06-02 Чуть чуть поработал со встроенным температурным сенсором
2020-06-05 Все датчики более менее работают и даже немного калибруются
2020-06-06 Написана программа для приема пакетов на земле. Ожидаются тесты
2020-06-14 Вот так BME работает не LSI
2020-06-14 Багфикс. Счетчик таймера TIM4 никогда не будет больше 0xFFFF0000, потому что он 16-тибитный
2020-06-14 Багфикс. Неправильная подсчет миллисекунд при синхронизации времени АРКом
2020-06-14 Разработка полезной нагрузки идет во всю силу
2020-06-14 Новые сообщения для полезной нагрузки
2020-06-14 Отладочные сообщения полезной нагрузки
2020-06-14 В плате полезной нагрузки включен IWDG
2020-06-14 В плате полезной нагрузки настроена ламопчка (и отлажен IWDG)
2020-06-14 Крупное переосмысление кода полезной нагрузки Достигнута стабильная работа после КЗ на линиях i2c bme
2020-06-24 Исправлена проблема с SNTP сервером
    Раньше адрес NTP-сервера получался по DHCP. Мы его отключили, так
    как на борту он не особо нужен будет. Поэтому ESP32 не мог
    отправлять запросы на синхронизацию.
    Понемногу пытаюсь писать комменатарии к коду. Теперь я полностью
    определился, что буду писать их на русском, поэтому они
    понемногу будут появляться.
    [imi.c, imi.h, init_helper.c, main.c]
2020-06-24 Переведен АРК с LSE на LSI
    LSE работает не всегда. Пару раз он уже ломался. Температуры для
    него страшны. Так что было решено отказаться от LSE.
2020-06-25 Синхронизация времени между ESP32
    Добавлен NTP сервер. Он будет работать в кубе с stmf4, который
    будет получать время от gps. Так что это получается stratum 1.
    Вот только из-за выполнения нескольких задач, время отправления
    может быть неточным.
2020-06-25 Чтобы увеличить точность синхронизации,надо лишь...
    Поднять приоритет задачи NTP сервера. Скорее всего, это лучшее
    решение. Но надо тестить с помощью осциллографа.
2020-06-25 Настройка DMA для I2C1 и tx_overrun в its-i2c-link
2020-06-25 Ассерты и ErrorHandler Хала теперь перезапускают систему Настроена периодичность пакетов
    [app_main.c, bme.c, main.c]
2020-06-25 Добавлены конфигурации для сборки платы полезной нагрузки как имитатора
2020-07-01 Доделаны оси в виджете модели
    [axis.stl]
2020-07-01 Изменение в виджете данных + убран текстовый лог + изменения в data_control
2020-07-01 Добавление полезной нагрузки + отображение времени + изменения в виджете данных
2020-07-01 Исправлено опускание i2c-int и разные фиксы
    I2C-INT неправильно работал. Теперь он опускается и поднимается
    своевременно.
    Пытаемя застваить работать ПН. Пока не очень.
    [PAYLOAD.ioc, imi.c, main.c, main.h]
2020-07-02 Корректировка моделей по результатам печати
2020-07-02 Подписал контакты, отправил плату в производство
    [Debug.brd, Debug.sch]
2020-07-02 GKS: поправлены размеры кронштейна и отверстие в защитном кожухе
2020-07-03 Рабочий код АРКа, ПН и БКУ
    Наконец-то все заработало! Основная проблема была в
    высоком сопротивлении на подтяжке.
    Убраны лишние принтфы. На данный момент печатается
    лишь информация о том, что пришло какое-то сообщение,
    время и оповещение о синхронизации.
2020-07-03 Исправлен пакет с временем + убран лишний принт
    [data_widget.py, source.py]
2020-07-03 Исправление для настроек + незначительное исправление
    [source.py]
2020-07-03 Начата работа над драйвером шагового двигателя
2020-07-10 SP, убраны диоды, изменены площадки, добавлены надписи
    [SP.brd, SP.sch]
2020-07-11 Созданы балансировочные кронштейны
2020-07-11 SC: Созданы оснастки для сборки СБ и намотки катушки ЭМ, укорочена втулка ЭМ
2020-07-11 Добавил в .gitignore файлы с расширением STL
2020-07-11 SC: Уменьшил углубления под гайки в каркасе
2020-07-13 Созданы новые gerber файлы плат SP и BSK2 версии 1.1
    [BSK2.brd, SP.brd, SP.sch]
2020-07-14 подготовка к тесту dm422
2020-07-14 исправлена табуляция
2020-07-14 Исправлены недочеты
2020-07-15 Добавлен Wi-Fi AP
    Раньше оба esp32 коннектились к одному внешнему
    вайфаю. Теперь добавлен новые функции (и немного
    изменены старые) для инициализации AP.
2020-07-15 Точно рабочий код АРКа, ПН, БКУ
    Забыл добавить файлы к позапрошлому коммиту. Это очень грустно!
2020-07-15 Провели тест с Данилой - успешно
2020-07-15 Добавлена новая конфигурация gps модуля
    [neo6-config.cfg]
2020-07-16 Новая плата АРК
    [ARKnew.brd, ARKnew.sch]
2020-07-16 Служба времени перенесена в отдельный файл + комментарии
    Служба времени была наоднородной и была в разных местах.
    Теперь все находится в одном аккуратненьком файле.
    Добавлены комментарии в разных участках кода. Теперь должно
    быть проще для сопровождения кода.
2020-07-16 Передача сообщений через wifi
2020-07-16 Исправлен выход за пределы массива
    Я перепутал местами номер канала и передаваемый байт.
    Из-за этого мавлинк выходил за пределы массива. Мораль:
    не доверяй проверку на допустимость параметров кому-либо
    другому.
    [main.c]
2020-07-16 Заменены ID компонент и систем для АРКа
    Раньше было 42. Теперь нормальное число.
2020-07-16 БСК теперь ищет БКУ через Wi-Fi после отключения
2020-07-16 Глобальная переработка + доработка для введения рассылки
2020-07-17 Обновлена плата АРК
    [ARKnew.brd, ARKnew.sch]
2020-07-17 АРК 2.0
    [ARKnew.brd, ARKnew.sch]
2020-07-17 Доделана программа для приема радиопакетов на земле
2020-07-17 Первая порция фикса
2020-07-18 Принятие первой порции фиксов
2020-07-18 Дополнение
2020-07-18 Уменьшена частота отправки времени на APK, изменена конфигурация для gps
2020-07-18 Синронизация времени между СИНС и БКУ работает
    Теперь все работает.
2020-07-18 Теперь ВСЯ синхронизация веремени в одном месте
    Добавлен в общую кучу ark_time_sync, синхронизирующий
    всех на линии imi. Также выделен отдельно ntp_cerver
2020-07-18 Добавлен драйвер встроенного термодатчика
    Стмовский АЦП сложен в управлении. Но на АЦП висит лишь термодатчик, а
    значит все намного проще, чем обычно.
    Забыл закинуть в предыдущий коммит
    Это тоже
2020-07-18 Изменены настройки на более нормальные
2020-07-18 Перемещен timeout шины на уровень выше
2020-07-18 Добавлен дебаг АРКовски тасков
2020-07-18 исправление ошибок в драйвере для dm422
    [DM422.py]
2020-07-18 Перенос конфига в отдельный файл
2020-07-18 Перенос кода в отдельную папку
2020-07-18 Глобальные изменения в работе с данными, изменения принципа действия сброса времени и добавление отображения времени по подсистемам.
2020-07-19 Исправлены диоды в АРКе
    [ARKnew.brd, ARKnew.sch]
2020-07-21 Добавлен пакет для RSSI
2020-07-22 Переместил код для приема по радио на земле
2020-07-22 Исправлена отправка пакету дальше
    [main.py]
2020-07-22 Исправлена отправка пакета дальше
    [main.py]
2020-07-23 Начало работы с RSSI
2020-07-23 Исправление драйвера и подготовка к тесту
    [DM422.py, config.py]
2020-07-23 Исправления косяков в мейн
    [main.py]
2020-07-23 Обновление списка библиотек
2020-07-24 Изменен АРК
    [ARKnew.brd, ARKnew.sch]
2020-07-25 Изменения в размерах крепления камеры
2020-07-25 Улучшен ADC на АРКе
    Теперь встроен оверсэмплинг! И добавлен вывод на шину телеметрии.
2020-07-25 Добавлен модуль для работы с радио
    Теперь все сообщения проходят отбор и отпраляются по радио с заданной
    частотой, если это позволяет канал и реализация системы.
2020-07-25 Добавление коментариев и очистка от лишнего
2020-07-28 SC: Корректировка моделей по результатам печати
2020-07-28 Все написано. Необходимы тесты
2020-07-28 В КА измененя в размерах кронштейна
2020-07-28 Изменения в обработке пакетов
2020-07-28 Робкая попытка костыля с фиксом неправльных system_id, component_id
2020-07-28 В догонку
2020-07-28 Добавлен парсер логов. Нужен тест
2020-07-29 Работает парсер логов с таймштампом. Необходима доработка для сырого лога
2020-07-29 Парсер работает. Добавлена отправка правильных system_id и component_id для rssi пакетов
2020-07-29 Добавил скрипт для разбора пакетов на .csv
2020-07-30 Радио теперь разделяет сообщения по отправителю
    Раньше сообщения разелялись только по msgid. Однако из-за этого
    сообщения одного типа от разных источников могли заглушаться одним
    из источников. Теперь добавилось разделение с помощью динамического
    добавления контейнеров.
2020-07-30 Переосмысление sysid и compid
    Теперьв все отправляющие абоненты имеют собсвтенный sysid, а compid
    нужен для определения номера данных
2020-07-30 Дополнение к предыдущему коммиту
2020-07-30 Добавлено определение основы получения времени
2020-07-30 Добавлены цвета. BAD_DATA теперь отмечается красным цветом (работает только для posix систем)
2020-07-30 Начало работы с термометром
2020-07-30 Цвета не работают
2020-07-30 Обновлено имя выходной директории
2020-07-30 Исправлен формат даты и времени для выходной директории
    [logs.py]
2020-07-30 Этот комментарий не воспринимается argparse. Нужно проверить
2020-07-31 Теперь все работает
2020-08-01 Продолжение
2020-08-01 Датчик температуры чипа работает
2020-08-04 Небольшие исправления
2020-08-05 Добавила третий столбец в таблицу + настройка
2020-08-05 Добавлена конфигурация gps в основной проект
2020-08-07 Добавлены выключатели для пакетов таблицы + настройки через переменную окружения
2020-08-08 Начало разработки бессмертного sins
2020-08-11 Исправлена плата MAG
    [MAG.brd, MAG.sch]
2020-08-12 Подготовлены к производству платы ARK v1.1 и SP v 1.2
    [ARKnew.brd, SP.brd, SP.sch]
2020-08-12 Добавлена структура ошибок
2020-08-12 Код обновлен в соответствии с мавлинком
2020-08-12 Добавлены модуль SD и удаление очереди в route
    Рабочий модуль для работы с SD картой. Известна проблема, что при
    отключения SD карты и обратной вставки эта карта больше не использется
    микроконтролером.
    Теперь можно удалять свою очередь из route после того, как она
    становится ненужной.
2020-08-12 Сдвиговый регистр, управляющие компоненты и релизная конфигурация
    Новая компоненты для работы со сдвиговым регистром. Пока не
    тестировалось из-за проблем с прошиванием МК.
    Управляющие компоненты управляют питанием, магнитами и нагревателями.
    Новая релизная конфигурация для печатных плат. Управляется простым
    дефайном.
2020-08-12 Добавлены шаблоны настроек + изменены дефолтные настройки
2020-08-12 Изменена переменная окружения для пути к файлу настроек
2020-08-12 Исправлена ошибка в настройке сцены из-за которой работали только настройки по умолчанию
    [model_widget.py]
2020-08-12 Добавлен README, содержащий в том числе инструкцию по настройке приложения
2020-08-13 Добавлены сырые показания GPS для SINS станции оператора
2020-08-13 Драйверы для шины 1W и ds18b20, и управляющий таск
    Добавлены драйверы от https://github.com/DavidAntliff/ для работы с
    ds18b20. Пока что без тестов.
    Также взят его пример за основу для будущего таска, управляющего
    температурой. В будущем он будет отправлять данные в route, но пока
    он просто печатает все, что видит.
2020-08-15 Добавлена возможность работы с backup SRAM
2020-08-15 На БСК1 или на БКУ пины I2C_INT и LED перепутаны
    Проблема решена успешно
2020-08-15 Малые исправления
2020-08-15 shift_reg теперь правильно изменяет сдвиговые регистры
    Хоть порядок бит MSB правильный, но SPI передает байты в порядке LSB, а
    сдвиговые регситры хотят MSB
2020-08-15 Уменьшение логов и добавление подтяжки
    Забыли вставить подтяжку на плату >_<
2020-08-15 Рабочая версия сдвиговых регистров и ds18b20
2020-08-15 Улучшение синхронизации времени
    Забытые файлы
2020-08-15 Определены состояния платы по джамперу. Начата проработка сосотояний
2020-08-15 Добавил проект для маяка для теста дальнобойности радио
2020-08-15 Маяк готов. Осталось настроить радио
2020-08-18 Начало внедрения конфиг файла
2020-08-19 Кофиг работает
2020-08-21 GKS: Модернизация наземки в части увеличения АБ до 4-х штук
2020-08-22 GKS: добавлено крепление уровня
2020-08-22 обработка ошибок для mems датчиков. требует отладки
2020-08-26 Убрана возможность пересылать полученные сообщения
2020-08-26 Добавлена возможность смены направления осей датчиков
2020-08-27 Исправление ошибок
2020-08-27 Исправляем ошибку i2c busy
    [lsm6ds3.c, main.c, mems.c, mems.h]
2020-08-28 Добавила скрипт сборки
2020-08-29 GKS: сделано отверстие под разъем питания
2020-08-29 После HardFault контроллер перезапускается
2020-08-29 Исправления + добавленны матрицы для калибровки магнитометра
    [config.py, main.py]
2020-08-29 Еще исправления
2020-08-29 WATCHDOG полезной нагрузки перенастроен так, что перезапускает её, если она слишком давно не отправляла сообщения I2С мастеру
2020-08-29 Обработка ошибки повторяющихся данных
2020-08-29 Добавлен watchdog на передающий uart на 16 секунд. Изменены параметры конфигурации gps
2020-08-29 Убран HardFault из main
2020-09-01 GKS: создан com_port
2020-09-02 Увеличена надежность SD
2020-09-02 Сенсоры теперь отправляют данные в route
2020-09-02 Модуль логирования и логи БКУ
2020-09-02 Новая компонента "опрератор"
    Новая компонента ответственна за управление аппаратом "снаружи".
2020-09-02 Доделан вочдог
2020-09-02 Симлинки в проекте БКУ поправлены на относительные
2020-09-02 обновлен сабмодуль на esp-idf на ту версию, которой наши проекты собираются
2020-09-02 Добавлен файл, который удерживает папку Inc ntp-сервера, без которой проект не собирается
2020-09-02 SC: Модуль GPS и некоторые другие помпоненты платы БКУ установлены в соответствии с разводкой платы
2020-09-04 Опция для генерации списка команд проектом БКУ для проверки через CPPCHECK. И снова правка сабмодуля. Наконец-то я собрал проект...
2020-09-05 Ассерты в релизе перезапускают контроллер
2020-09-05 Неблокирующая настройка gps. Первые наброски
2020-09-05 Не ждем конфигурации gps по началу
2020-09-05 Кажется, теперь esp-idf указывает на правильную ревизию для сборки
2020-09-05 SC: Начало разработки крепления антенны GPS
2020-09-06 Включили CSS. Пересели на HSI. Проверка кватерниона на нан
2020-09-06 !!! ОБНОВЛЕН МАВЛИНК!!! Добавлен пакет с ошибками SINS
2020-09-06 АРК переведен на HSI вместо HSE
2020-09-06 Небольшой рефактор ARK. Добавлен вотчдог на отправку сообщений
2020-09-06 Исправлена релизная конфигурация АРК
2020-09-06 Проверен вотчдог арка, исправлены некоторые макросы в релизной конфигурации, добавлена перезагрузка по ошибкам HAL и ассертам
    [main.c, tmain.c]
2020-09-06 Исправления конфигуаций PAYLOAD аналогичные исправлениям ARK
    [main.c]
2020-09-06 Помедленнее клок АЦП для АРК
2020-09-06 PAYLOAD перевед на HSI с понижением частоты с 72Мгц до 64Мгц. Из-за этого перенстроен таймер службы времени
2020-09-06 Добавил причину резета для PAYLOAD и поправил mavlink сообщение с кодами ошибок периферии
2020-09-08 Новые операции для управления извне
2020-09-08 Управляющие таски делают своб работу еще лучше
    Нагреватели теперь ограничиваются силой тока.
    Добавлена возможность управления питанием Payload.
    Параметры сдвиговых регистров теперь правильно ограничены.
2020-09-08 Изменены пины АРКа для соответствия с платами
2020-09-08 Теперь доступно полное очищение памяти от модулей
2020-09-08 Фиксы после merge для дополнительной проверки
2020-09-08 Убраны лишние файлы из гита
2020-09-08 Ремонт файла проекта и .settings в гитигнор
2020-09-08 Убрал блокирующую индикацию ребута из АРК
2020-09-08 Добавил неблокирующую индикацию ребута для АРК
2020-09-08 Миграция PAYLOAD на новую версию IDE и чистка различного мусора
2020-09-08 Продолжение миграции PAYLAOD но новую версию IDE и отключение инициализации внешних кристаллов в ARK и PAYLOAD
2020-09-08 Протестирована неблокирующая конфигурация жпс
2020-09-08 Добавлен счетчик резетов и счетчик переконфигураций жпс
2020-09-08 Внесены изменения в GKS, КА
2020-09-09 Испревление в преобразовании типов
2020-09-09 Смена настроек для магнитометра
2020-09-09 Добавление задержки после передачи настроек магнитометра
2020-09-09 Добавление возможности смены направления вращения шаговиков
2020-09-09 Добавление смены направления вращения шаговиков и исправление ошибок в математике и управленнии концевиками
    [config.py, main.py]
2020-09-09 Добавление пересчета углов в градусы + исправление математики
    [strela_ms_math.py]
2020-09-10 Исправил самописный клок. Теперь он работет правильно
    [mems.c]
2020-09-11 Добавили обработку BAD_DATA
2020-09-11 Исправление в примере для SINS
2020-09-11 Перенесла все файлы приложения в отдельную пвпку
    [CanCubeSat-for-GKS.stl, axis.stl]
2020-09-11 Теперь собирается и для дебага
2020-09-11 Рестарт контроллера по немаскируемым прерываниям для полезной нагрузки и АРК
2020-09-11 Пересадка пинов на настоящие для АРК
2020-09-12 Убрал пулдаун с TIME пина PAYLOAD
2020-09-12 СОЗДАВАЙТЕ GITIGNORE В СВОЕЙ ПАПКЕ ЛИЧНО СЕБЕ!!! ЭТО НЕДОРАЗУМЕНИЕ РАЗВАЛИЛО МНЕ НАЗЕМКУ!
2020-09-12 Возвращаю потерянные файл
    [CanCubeSat-for-GKS.stl, axis.stl]
2020-09-12 ДОбавлена обработка ошибок. Сигналы SIGINT, SIGHUP, SIGTERM приводят к завершению работы программы. Вроде даже работает
2020-09-13 gitignore для csv-maker
2020-09-13 SC: Добавлены платы с DC-DC, внесены изменения в печатные детали для БКУ и СБ по результатам 3D печати, прочие правки...
2020-09-13 SC: Переименована модель антенны на борту КА
2020-09-13 Добавила в графики сортировку и проверку на бесконечность
2020-09-13 Правильные калибровочные коэффициенты для mics6814 для полетной платы
2020-09-13 Включены прерывания для пина TIME
2020-09-13 Разный порядок BSK и починенный control_heat
2020-09-13 Упрощенная версия АРКа для полурабочей платы
2020-09-13 Починены пины SPI и отключение SD
2020-09-13 Починенен log_collector
2020-09-13 Изменена частота uart и разные фиксы
2020-09-13 Исправлена конфигурация жпс. Убраны исправления осей у мемс датчиков. Понижена частота отправки. Системные пакеты отправляются раз в секунду
    [gps.c, led.c, lis3mdl.c, lsm6ds3.c, main.c, neo6-cfg.c, uplink.c]
2020-09-13 Сохранение данных сдигового регистра в TP50
2020-09-13 Теперь он буден кидать 0 на реостат
2020-09-14 Лишние файлы в гитигнор
2020-09-14 Теперь компилится
2020-09-17 Убран PL_KVCC и добавлены логи радио
    Временно у нас проблемы с нормальной подачей питания. Так что теперь
    оно идет через PL на BCU. Мы убрали транзистор, управляющий питанием
    от BCU на PL, и соединили напрямую.
    Консольныу логи радио починили его работу, так что пока не убираем.
2020-09-17 Убраны статики из заголовка в mavlink_comp
2020-09-19 Добавлены сообщения для антенной системы
2020-09-19 Добавлен разбор новых типов сообщений и исправлен разбор старых
    [data_control.py]
2020-09-19 Добавлен интерфейс системы ручного управления антенной
2020-09-19 Попытка реализовать ручное управление
2020-09-20 Миграция маяка на новый cubemx. Добавлена neo6 конфигурация
2020-09-20 Пересмотренная конфигурация neo6. Дает PPS всегда
2020-09-20 Добавлено сообщение, позволяющее менять состояние линии enable шаговиков
2020-09-20 Кажется, финальный реворк конфигурации neo-6
2020-09-20 SC: Модернизирована крышка антенны GPS, добавлены шайбы под антенну РМ, переделан адаптер корпусных модулей
2020-09-23 Добавил скрипт для удаленной конфигурации радио в наземке
2020-09-23 актуальный конфиг?
2020-09-23 Починили радио
2020-09-23 Добавили вотчдоги
2020-09-23 Уменьшенная частота радио и включенная SD карта
2020-09-24 Добавлена возможность получать последнее состояние пина Enable
2020-09-24 Изменены настройки
2020-09-24 Пересмотрен подход к отключению шаговиков, добавлен нижний предел для углов поворота антенны, добавлен функционал для ручного управления, исправлены ошибки
    [main.py]
2020-09-24 Добавление нового функционала и починка приема пакетов
2020-09-24 Исправлены ошибки в GPS, таймаут GPS выведен в конфиг
    [config.py, main.py]
2020-09-26 Правильное имя скрипта
2020-09-26 налажена работа RSSI
2020-09-26 Переосмысление виджета данных с добавлением подсчета пакетов
2020-09-26 Переосмысление виджета с графиками с добавлением единиц измерения, легенды и полного обнуления графиков
2020-09-26 Обновление настроек
2020-09-27 Исправление комментариев + новые сообщения для наземки
2020-09-27 Добавление возможности смены периода корректировки положения и включения и настройки режима автовыключения шаговиков
2020-09-27 Добавлены функции для калиборовки магнитометра и акселерометра. Для их правильной работы необходимо включить соответствующие макросы в state.h и включить макрос CALIBRATION.
2020-09-27 Исправление ошибок + смена принципа работы функции установки нулевого уровня
    [main.py]
2020-09-27 Убрала лишнее
2020-09-27 Добавление отображения новых параметров антенной системы и возможности их смены
2020-09-27 Обновление README и примера под новый состав настроек
2020-09-27 Уменьшена скорость отправки по i2c. Добавлена проверка данных lis
2020-09-28 Канал WIFI, исправлен баг с iwdt
    [send.c]
2020-09-28 Отображение обнаруженных 1w адресов при иницализации esp32
2020-09-28 Адреса 1w сенсоров захардкожены в esp32
2020-09-28 Фикс бага в 1w библиотеке
2020-09-28 Захардкоженные адреса ds18b20 для АРК. Новые конфигурации сборки АРК
2020-09-28 Всопомгательные скрипты для обработки mavlog файлов и gitignore на обработанные данные
2020-09-29 Реворк радио таска
2020-09-29 подтяжка для пинов, на которых работают прерывания
2020-09-29 Корректировка опросов ины арком
2020-09-30 Исправлено поведение при наложении графиков
    [graph_widget.py]
2020-09-30 Исправлен таймаут и отображение данных
    [data_widget.py]
2020-09-30 Добавлены недостающие характеристики графиков
2020-10-01 Нагреватели роаботают, как положенно + контроль скорости радио
    Но потребление не уменьшается. Либо баг в коде, либо радиомодуль так
    устроен.
2020-10-01 log_collector защищен от ужасов параллелизма + включен таск нагревателей
2020-10-01 Дефайны теперь правильные: у нас всего 6 1W устройств
2020-10-01 Из-за путаницы при сборке АКБ стоят не в тех кубах
2020-10-01 Тюнинг цифр в управлении температурой
2020-10-01 Радио отправляет только пакеты целиком, чтобы не сыпать отдельными байтиками
2020-10-01 Правильное значение шунта ины на арках
2020-10-01 Таск управления батарейками отключен Убраны таск опроса ины на втором
2020-10-01 Мавлинк система зависит от номера куба
2020-10-01 Исправлен баг с включением всех нагревателей после включения
    Я неправильн инициализировал массив
    [control_heat.c, control_heat.h]
2020-10-01 Перезапуск esp, если вайфай не включился
2020-10-01 Ограничение нагревателей по току
2020-10-01 Столбец с названиями теперь будет достаточной для отображения без потерь ширины
2020-10-01 Подправила настройки
2020-10-01 добавлен прием и разбор пакета RSSI, исправлена невозможность использовать точку как разделитель, исправления в названиях переменных
    [antenna.py, data_widget.py, pos_control_widget.py, source.py]
2020-10-01 Добавлена пересылка rssi
2020-10-01 принт для облегчения понимания ситуации
2020-10-01 Обновлена конфигурация GPS для SINS. Увеличен буфер для входящих GPS сообщений. Включено сообщение NMEA-GSV для диагностики качества приёма (SINS его не обрабатывает)
2020-10-02 грегорианские таймштампы в csv файлах и таймштампы получения пакетов из мавлинк лога
2020-10-04 Отлетано 04.10.2020
2020-10-05 Боевые конфиги стрела-мс
2020-10-05 Добавлен пересчет геоцентриеских ecef координат в lat-lon для пакетов ubx-nax-sol
2020-10-05 Разделение .csv файлов по src-system и src-component
2020-10-06 Полётная телеметрия
    [BCU_STATS-10-0.csv, BCU_STATS-20-0.csv, ELECTRICAL_STATE-12-0.csv, ELECTRICAL_STATE-21-0.csv, Electrical_state.csv, Electrical_state.xlsx, GPS_UBX_NAV_SOL-11-0-with-o2-and-bme-and-mics.csv, GPS_UBX_NAV_SOL-11-0-with-o2-and-bme.csv]
2020-10-09 Добавление архива телеметрии
    [archive-pld.ods, archive-sins.ods]
2020-10-10 Новый способ ограничения радио
2020-10-10 Новый приоритет сообщений и убран коэфициент
2020-10-10 Убраны логи ЕСП
2020-10-10 Исправлен баг вылета первого и второго есп32
2020-10-10 Пофикшенная телеметрия от меня
    [Electrical_state.xlsx]
2020-11-14 SC: Финальный коммит 3D модели стратосферного зонда
2022-06-22 Bump numpy in /src/ground/rpi/antenna-control-system
    Bumps [numpy](https://github.com/numpy/numpy) from 1.18.3 to 1.22.0.
    - [Release notes](https://github.com/numpy/numpy/releases)
    - [Changelog](https://github.com/numpy/numpy/blob/main/doc/HOWTO_RELEASE.rst)
    - [Commits](https://github.com/numpy/numpy/compare/v1.18.3...v1.22.0)
    ---
    updated-dependencies:
    - dependency-name: numpy
    dependency-type: direct:production
    ...
